ISSUIUC/ISS-PCB/boards/Motor-MK2 (GATOR)/README.md

# Motorboard MK2 - GATOR

G - Grounded 

A - Arieal 

T - Tracker 

O - for Our 

R - Rocket 

# MK2

MK2 now includes an onboard LoRa reciever and GPS, removing the need for another MIDAS to act as a ground station.
It now also includes Qwiic connectors for additional I2C support and an IMU for orientation correction if needed.

# MK1

Starting off the year as just a concept, the Motor Board has taken shape as an impressive new piece of the MIDAS ecosystem. Unofficially known as “Spinny Antenna Motor” (SAM) Board, the project serves as a method of control for the team’s SAM Turret antenna tracker, which aims to automatically track the rocket’s position during flight and maintain optimal antenna orientation to get the best possible range for MIDAS telemetry. In addition to cementing MIDAS’s role as an important part of our team’s ground operations, the Motor Board has served as a testbed for WiFi as a new way of board-to-board communication.

Read more about MotorBoard, MIDAS and the surrounding avionics systems in the [MIDAS MK2 Report](https://uofi.box.com/s/k0ad6ryhxbzwpdwt33lxyxuxpivv3qhj).

# Schematics

Printable PDF schematics and layouts for MotorBoard can be found in the PDFs and images folders.

# Photos

## MK1

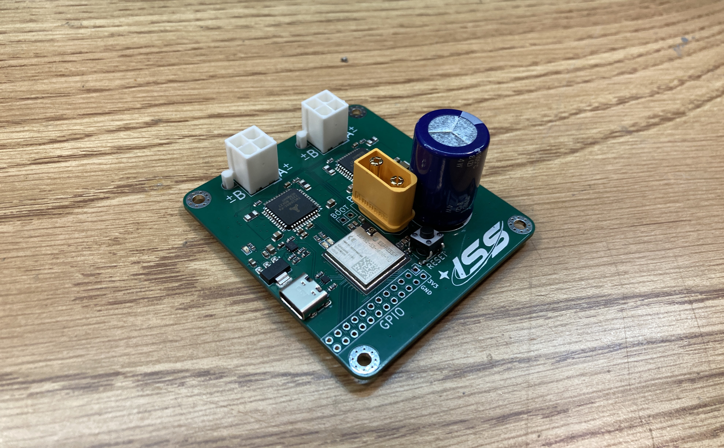
[picture p1: boards/Motor-MK1/images/MotorBoard.JPG]
Motor-Board-photo
