ISSUIUC/ISS-PCB/boards/Feather_Duo/README.md

# Feather Duo

The Feather Duo radio receiver was conceived to optimize communication with MIDAS and simplify the team’s ground station setup, including two LoRa radios for concurrent reception from both stages and software support for increased data rates. It succeeds the Adafruit Feather M0 RFM96 as the team’s primary ground station receiver.

Read more about the Feather Duo, MIDAS and the surrounding avionics systems in the [MIDAS MK2 Report](https://uofi.box.com/s/k0ad6ryhxbzwpdwt33lxyxuxpivv3qhj).

# Schematics

Printable PDF schematics and layouts for the Feather Duo can be found in the PDFs and images folders.

# Photos

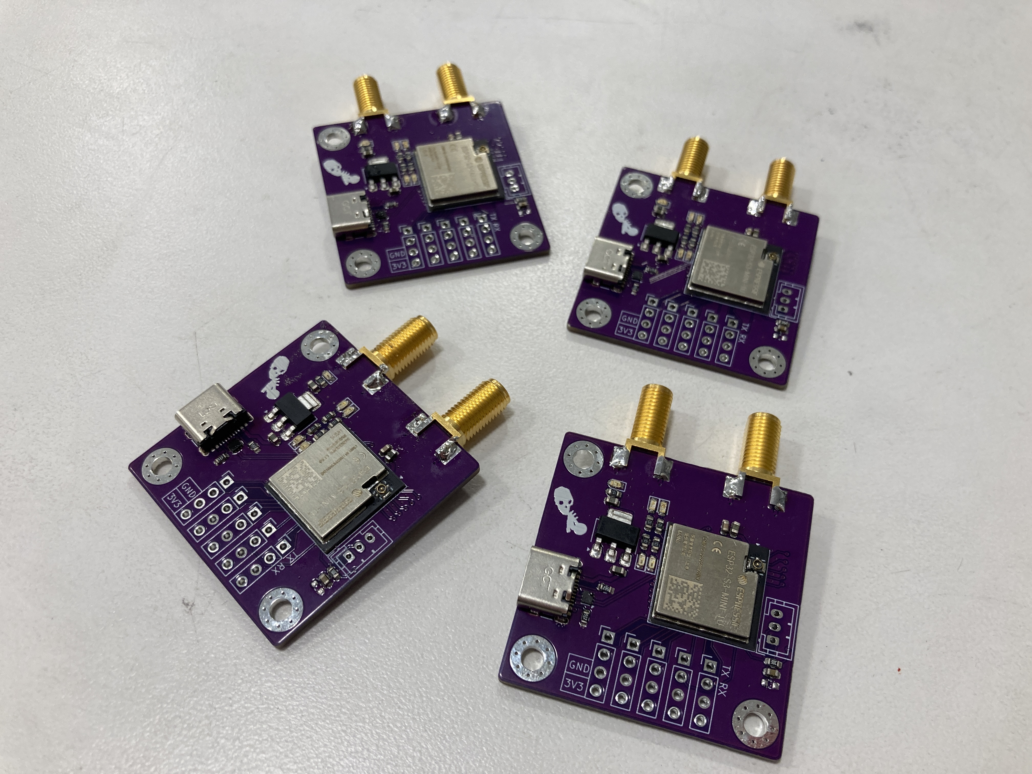
[picture p2: boards/Feather_Duo/images/Feather-Duo.JPG]
Feather-Duo-photo
