ISSUIUC/ISS-PCB/boards/MIDAS-MK2/README.md

# MIDAS MK2

MIDAS MK2 is the new and improved generation of the Illinois Space Society's MIDAS flight computer. Continuing MIDAS’s mission as the centerpiece of a flexible avionics ecosystem, MK2 features data acquisition, live telemetry, board-to-board communication interfaces, and pyrotechnic capabilities for in-flight control. This new revision retains the diverse suite of sensors from the original and features upgraded pyro circuitry with an emphasis on redundancy and reliability. As the team pushes closer and closer to space, MK2 employs a new generation of LoRa radios with 60% higher transmit power as well as CAN and I2C connections for future expandability into satellite communications and other more advanced tracking capabilities. This adaptable nature has enabled MIDAS to fulfill various roles, not only as a flight computer but also as a part of the team’s onboard video system and as a major ground support device. Overall, these across-the-board improvements have pushed the MIDAS project to new heights and led to a string of successes in each of its many domains.

Three MIDAS MK2 boards have been produced, with the series successfully flying in flight control of the Stargazer 1.4 vehicle and as the primary tracker for Aether I & II, the latter of which flew to an altitude of 75,000 feet.

Read more about MIDAS and the surrounding avionics systems in the [MIDAS MK2 Report](https://uofi.box.com/s/k0ad6ryhxbzwpdwt33lxyxuxpivv3qhj).

# Schematics

Printable PDF schematics, diagrams, and layouts for MIDAS MK2.1 revA can be found in the PDFs and images folders.

# Graphics

MIDAS-MK2.1-revA-graphic
