ISSUIUC/ISS-PCB/boards/Onboarding/README.md

# Onboarding Projects

The included projects have been developed for the purpose of teaching new members about the basics of circuit design and using KiCad.

The first project includes a 555 Timer that is used to flash several LEDs in combination with an N-channel MOSFET. This project is accompanied by other onboarding materials which explain how to use the 555 Timer and develop the circuit. There are also videos going through the [schematic](https://youtu.be/EWncukrDE1s) and [layout](https://youtu.be/gsBfX4-ESjE) design.

The second project is a basic two layer altimeter that could be used in an L1 rocket. It is intended to be more open-ended, and the included design can serve as merely an example. The altimeter includes an MCU, sensors connected via the SPI and I2C communication protocols, a microSD card for data storage, and basic power circuitry that can be used with an external voltage regulator. Extra GPIOs are broken out for future expansions.

# Schematics

Printable PDF schematics can be found in the folders for their respective boards.

# Renders

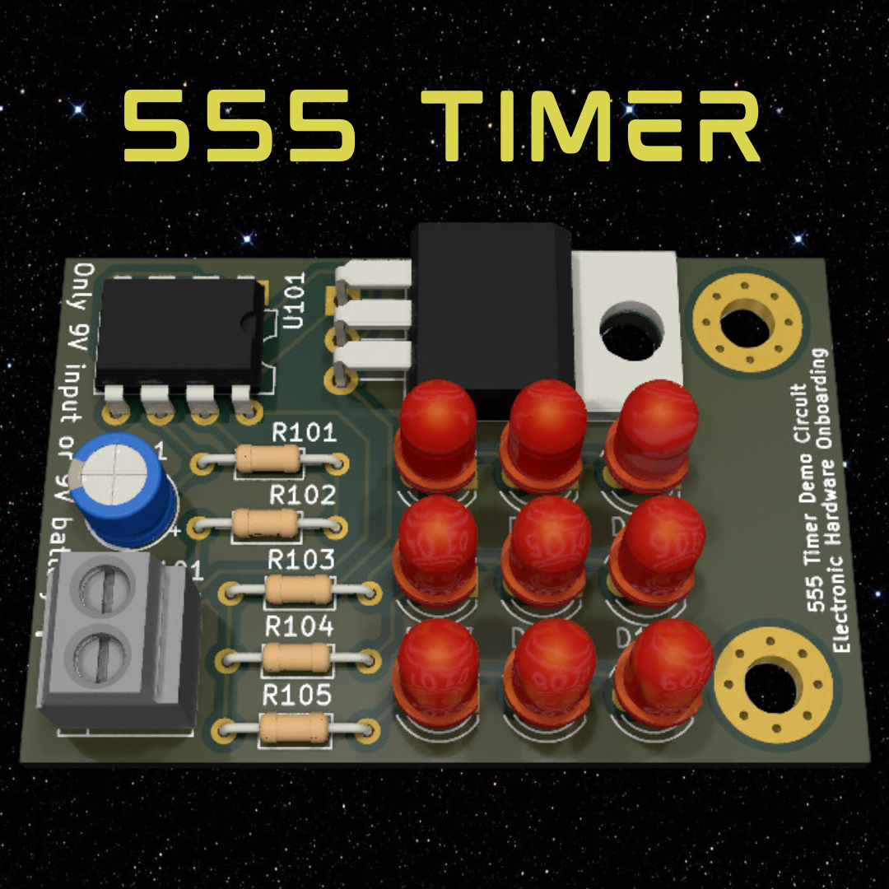
[picture p3: boards/Onboarding/images/555-Timer-Demo-Circuit-Render.png]
555-Timer-Render

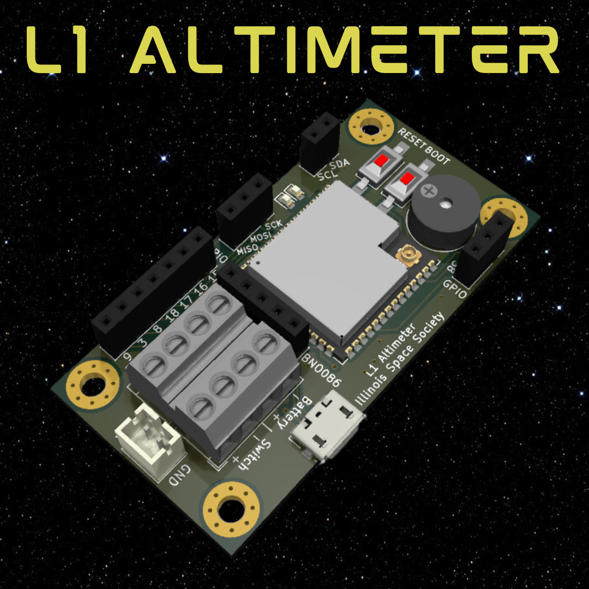
[picture p4: boards/Onboarding/images/L1-Altimeter-Render.png]
L1-Altimeter-Render
