ISSUIUC/ISS-PCB/boards/MIDAS-MK1/README.md

# MIDAS MK1

MIDAS MK1 is the fifth generation of the Illinois Space Society's SRAD avionics systems and the first to serve as a full-fledged rocketry altimeter. Combining the functionality of TARS together with the advanced pyrotechnic circuitry seen on many commercial models into a smaller form factor, MIDAS facilitates data collection, telemetry, and execution of inflight events. More than just a single unit, MIDAS is intended for placement on multiple stages of a rocket and can serve as a center of more complex avionics networks such as our onboard live video system.

Three MIDAS boards have been produced, flying over forty-four thousand feet to a new UIUC altitude record on Kairos II. By providing continuous telemetry that allowed for successful retrieval of both stages, MIDAS proved itself as a critical part of the team's avionics ecosystem going forward.

Future iterations of MIDAS will optimize operation and reliability at exceedingly high ranges and altitudes, creating a space-capable altimeter that will take our team to the Kármán line.

Read more about MIDAS and the surrounding avionics systems in the [MIDAS MK1 Report](https://uofi.box.com/s/6l9kr9wvrg0xpj17jzni7ou9mbe10vdm).

# Schematics

Printable PDF schematics for MIDAS MK1.1 revA can be found in the PDFs folder.

# Renders

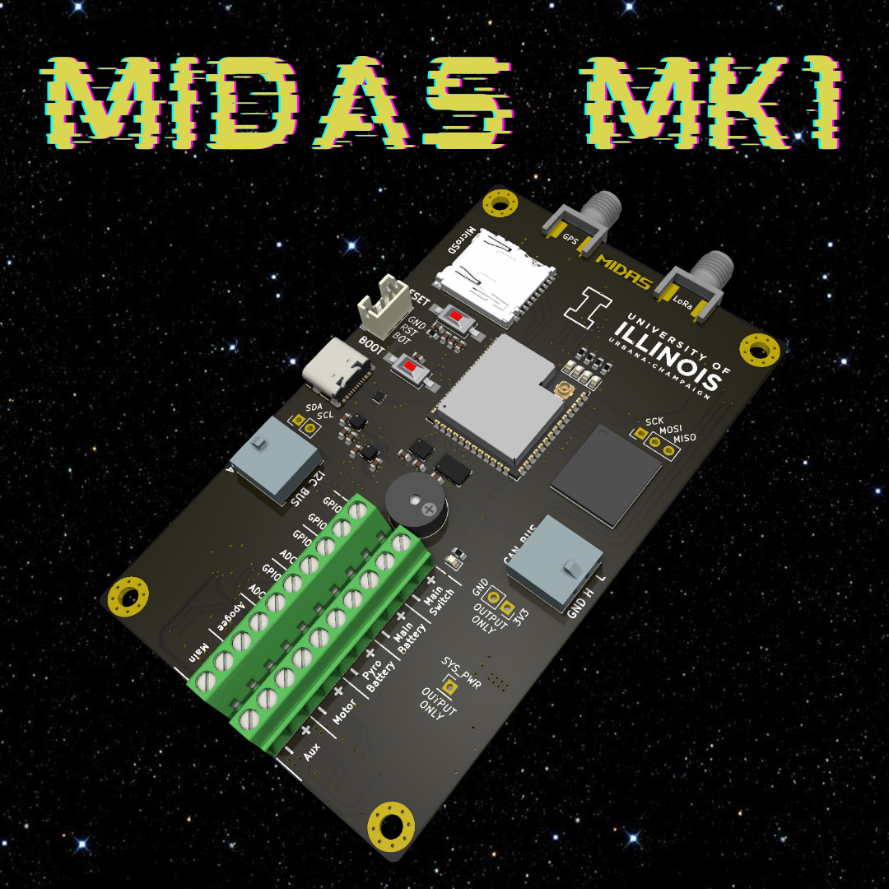
[picture p17: boards/MIDAS-MK1/images/MIDAS-MK1.1.png]
MIDAS-MK1.1-revB-render
