ISSUIUC/ISS-PCB/boards/Feather_Duo/images/Feather-Duo-Layout-Combined.png

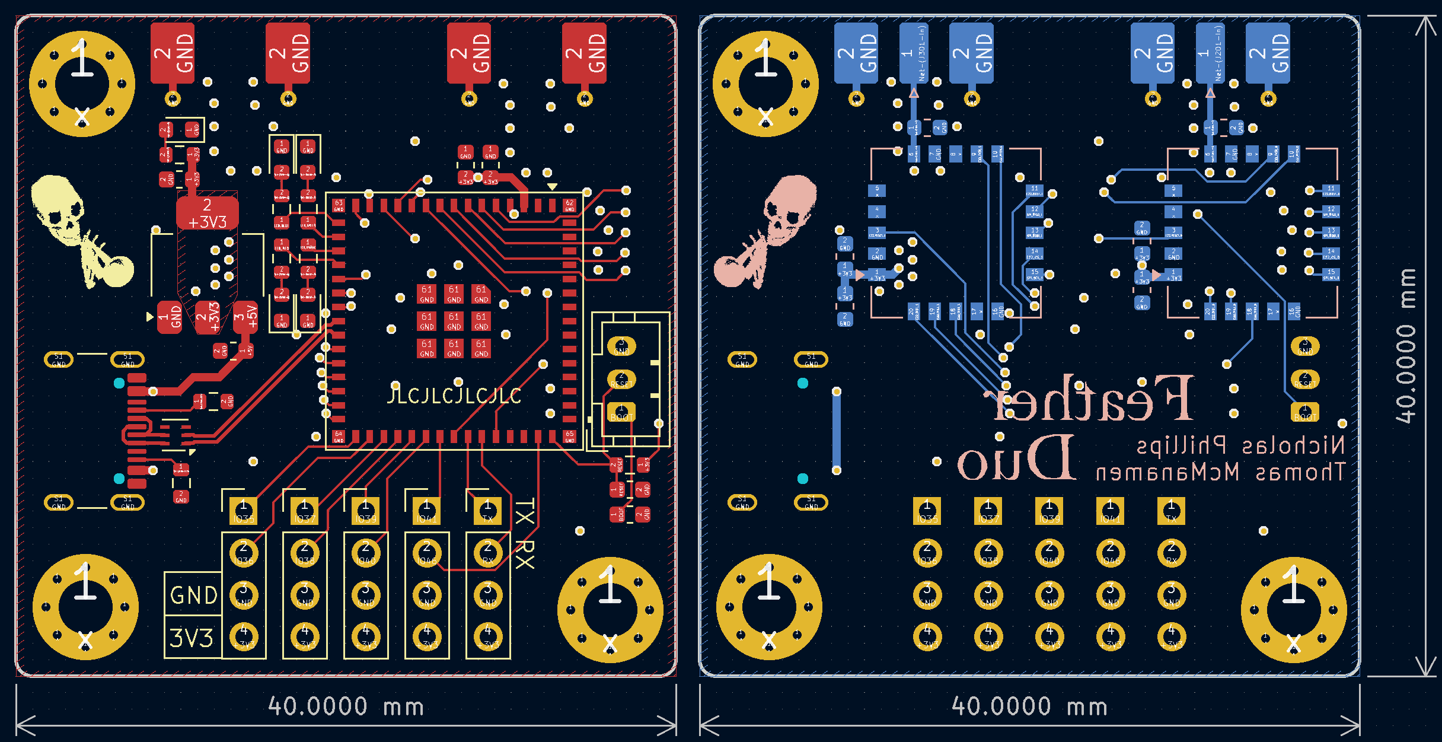
boards/Feather_Duo/images/Feather-Duo-Layout-Combined.png
