ISSUIUC/ISS-PCB/boards/MIDAS-MK2/images/MIDAS-MK2.1-Block-Diagram.png

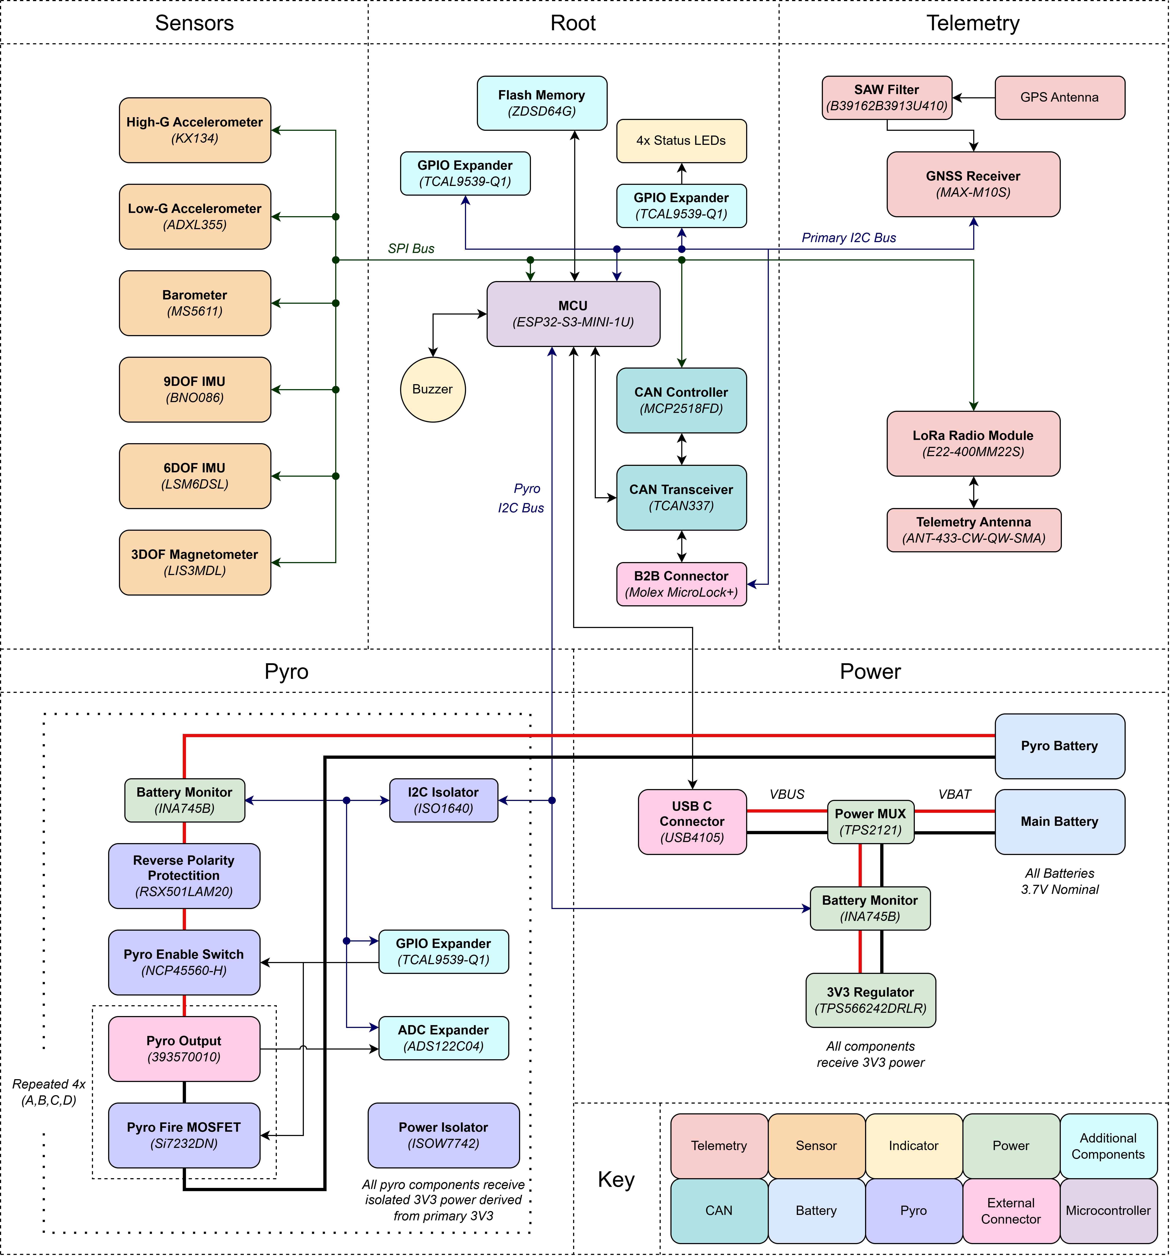
boards/MIDAS-MK2/images/MIDAS-MK2.1-Block-Diagram.png
