ISSUIUC/ISS-PCB/boards/MIDAS-MK2/images/MIDAS-MK2.1-Layout-Combined.png

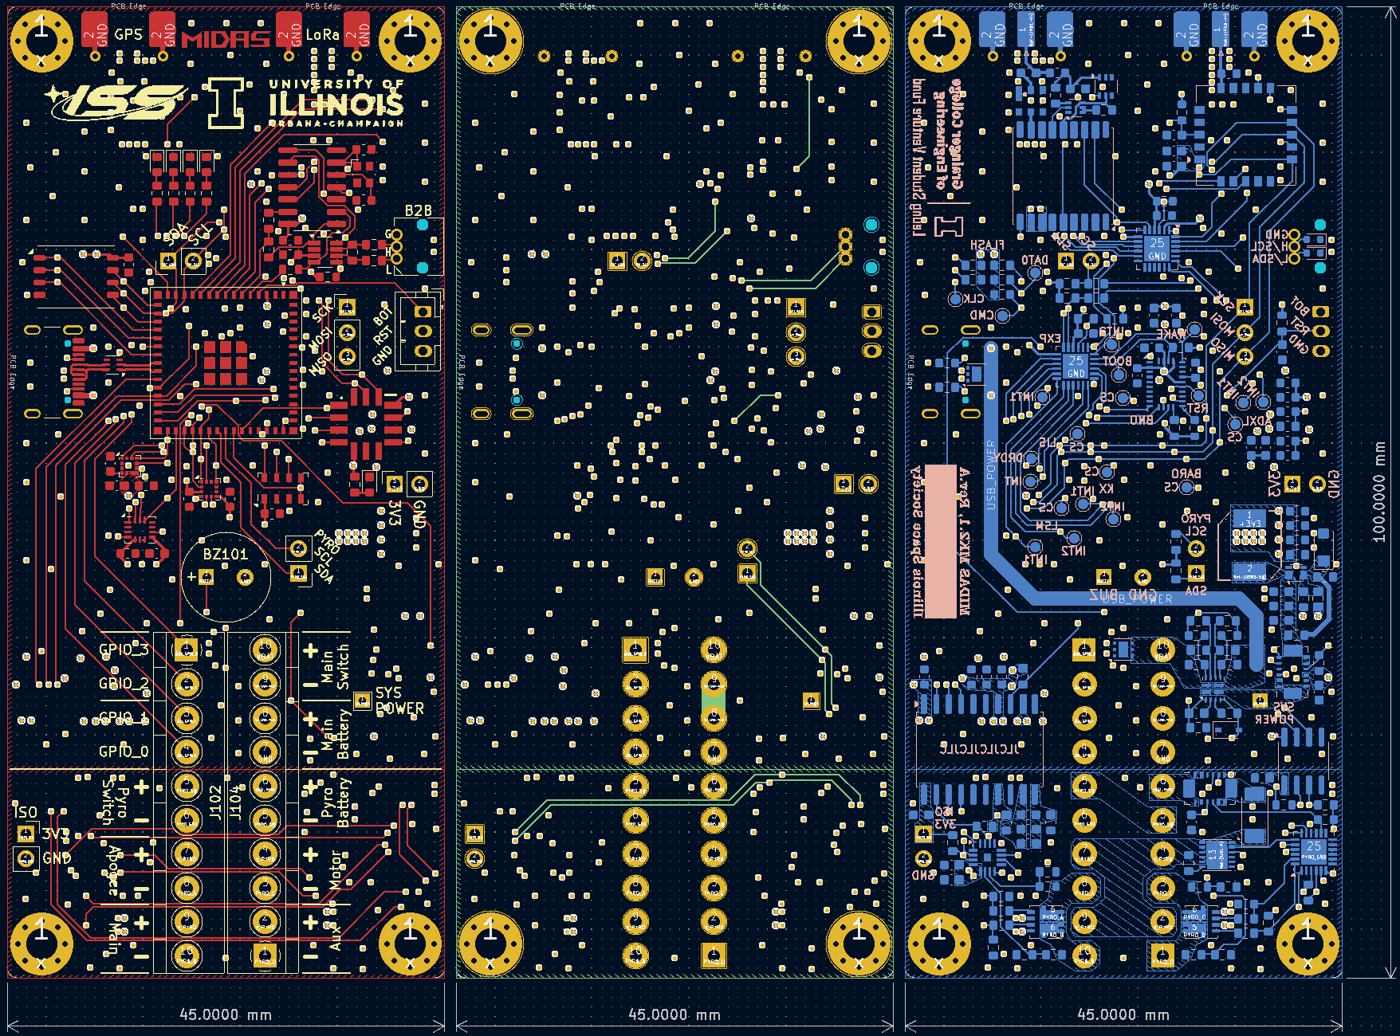
boards/MIDAS-MK2/images/MIDAS-MK2.1-Layout-Combined.png
