ISSUIUC/ISS-PCB/boards/Motor-MK1/images/MotorBoard-Layout-Combined.png

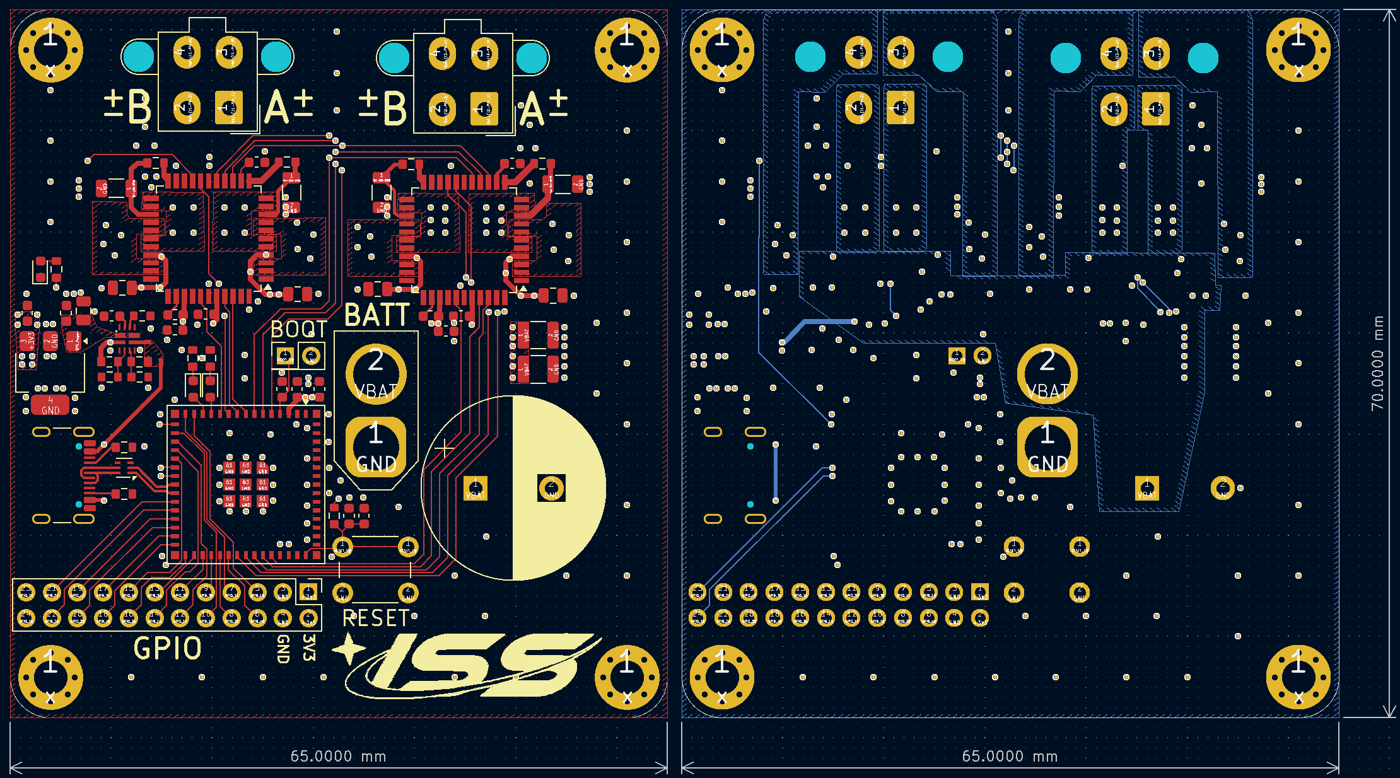
boards/Motor-MK1/images/MotorBoard-Layout-Combined.png
