ISSUIUC/ISS-PCB/boards/Onboarding/images/555-Timer-Demo-Circuit-3D.png

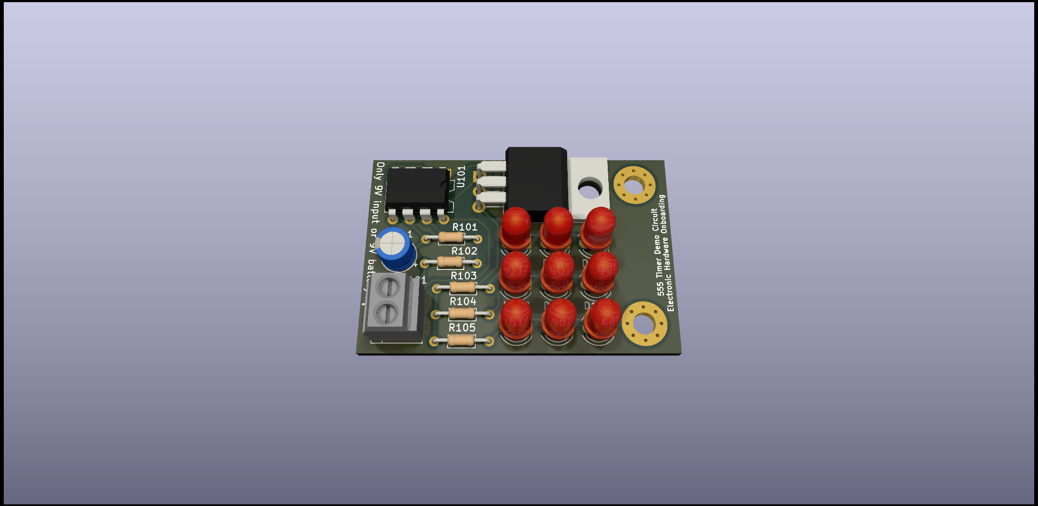
boards/Onboarding/images/555-Timer-Demo-Circuit-3D.png
