ISSUIUC/ISS-PCB/boards/Onboarding/images/L1-Altimeter-3D-Front.png

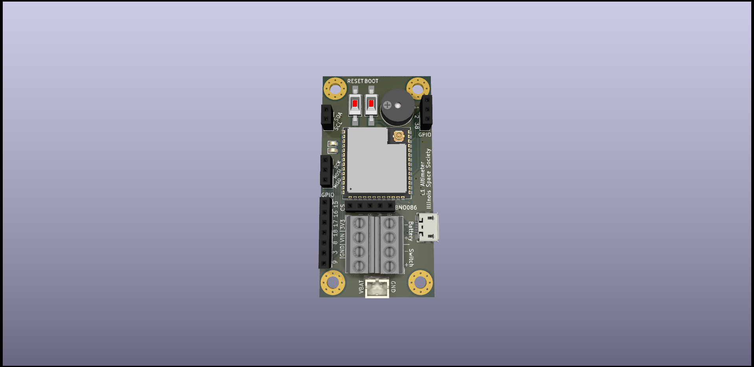
boards/Onboarding/images/L1-Altimeter-3D-Front.png
