ISSUIUC/ISS-PCB/boards/Onboarding/images/L1-Altimeter-3D-Tilt.png

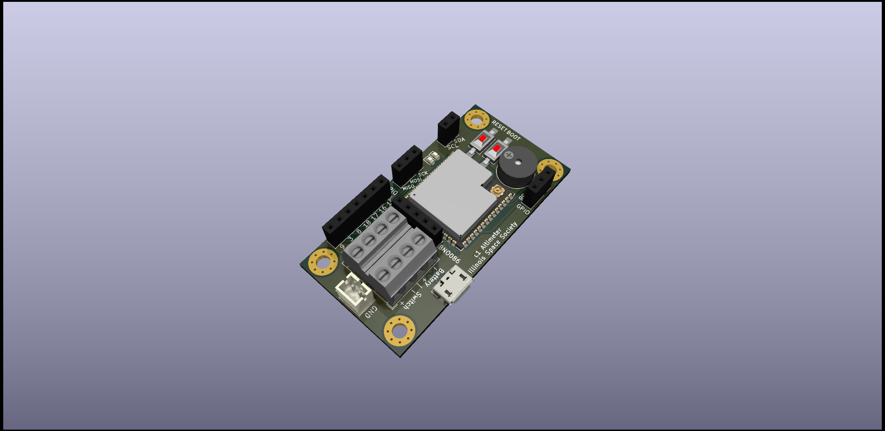
boards/Onboarding/images/L1-Altimeter-3D-Tilt.png
