ISSUIUC/ISS-PCB/images/ISS-PCB-Contributing-Branch-Types.png

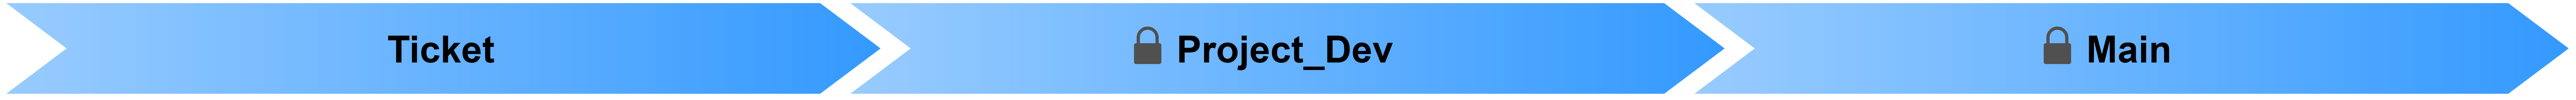
images/ISS-PCB-Contributing-Branch-Types.png
