ISSUIUC/ISS-PCB/images/ISS-PCB-Contributing-Library-Folders.png

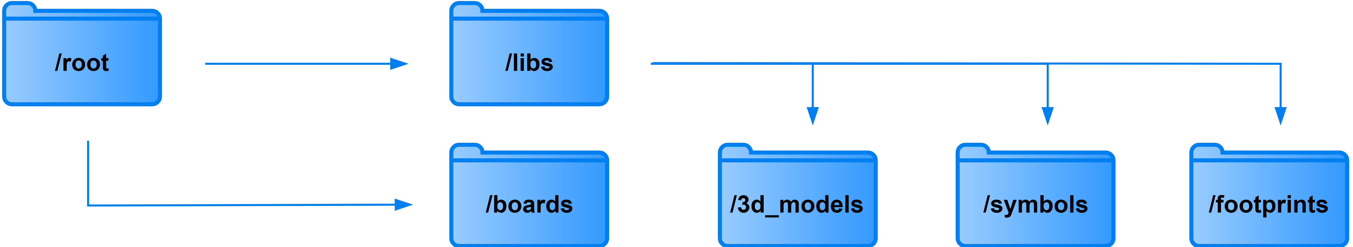
images/ISS-PCB-Contributing-Library-Folders.png
