ISSUIUC/ISS-PCB/images/ISS-PCB-Contributing-Relative-Library-Paths.png

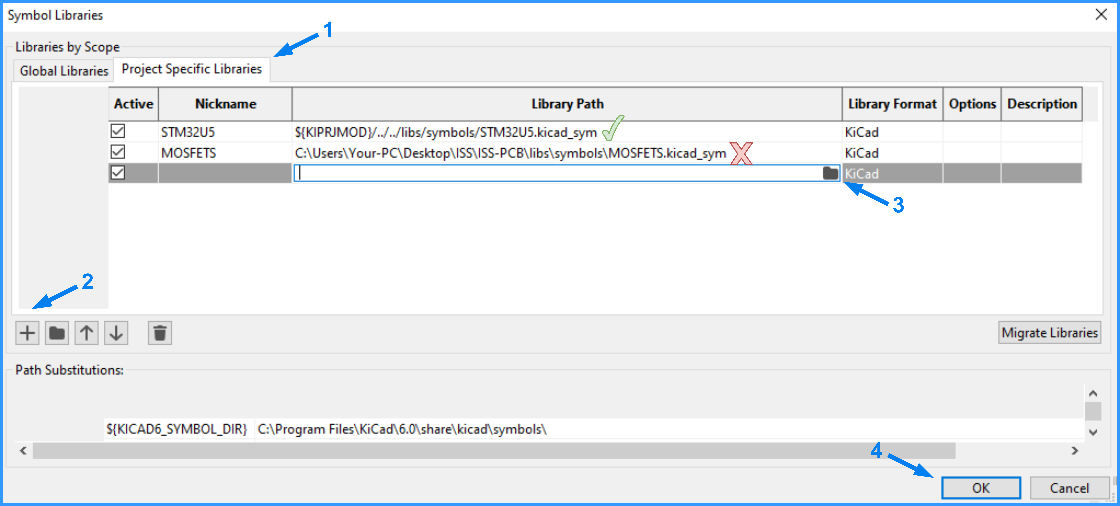
images/ISS-PCB-Contributing-Relative-Library-Paths.png
