ISSUIUC/ISS-PCB/images/ISS-PCB-KiCAD-Conventions-MPN.png

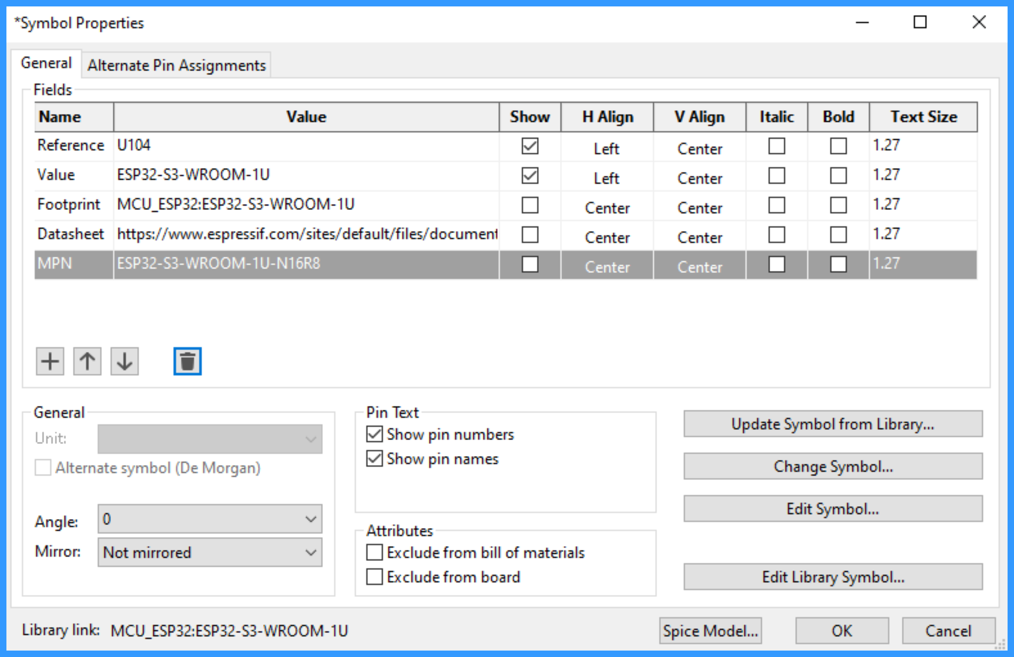
images/ISS-PCB-KiCAD-Conventions-MPN.png
