ISSUIUC/ISS-PCB/images/ISS-PCB-KiCAD-Conventions-Wire-Component.png

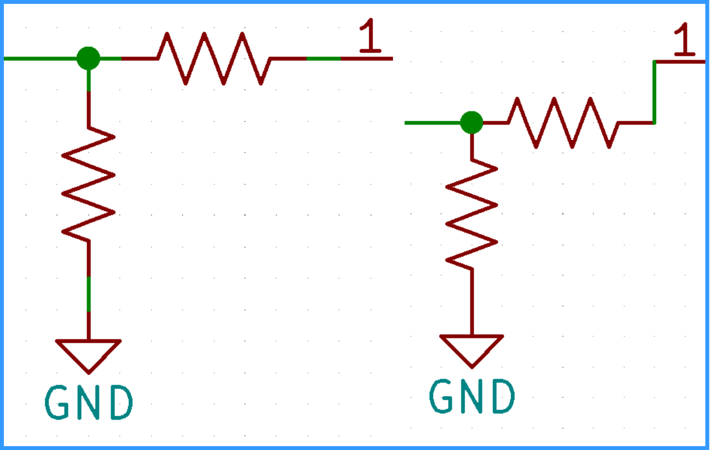
images/ISS-PCB-KiCAD-Conventions-Wire-Component.png
