ISSUIUC/ISS-PCB/boards/Drone_Power/BorzoiBoardCasing/BorzoiBoardCasing.FCStd

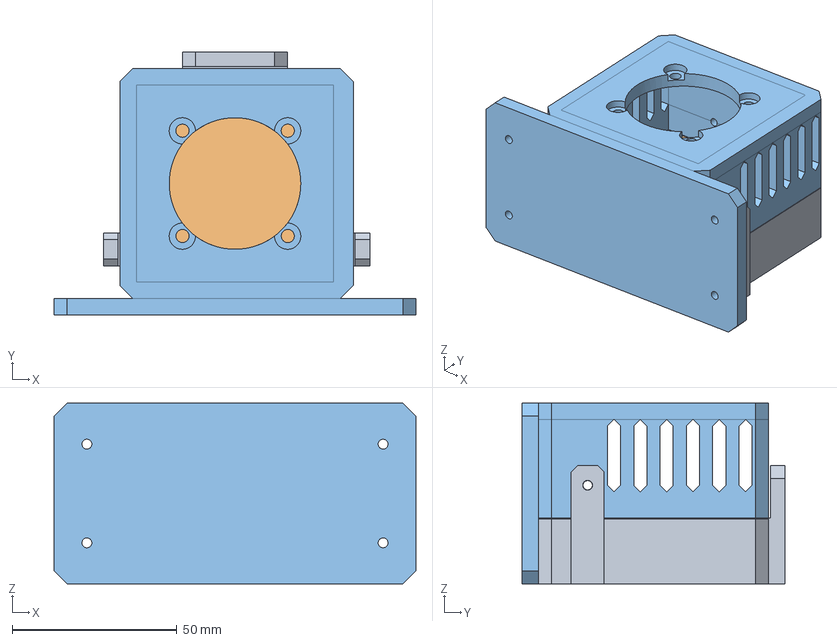
[picture p30: CAD file, 2025-09-06]
boards/Drone_Power/BorzoiBoardCasing/BorzoiBoardCasing.FCStd
110.0 x 80.0 x 55.0 mm
BottomCasing
PCB
TopCasing
