ISSUIUC/ISS-PCB/boards/Drone_Power/BorzoiBoardCasing/BorzoiBoardCasing-TopCasing.stl

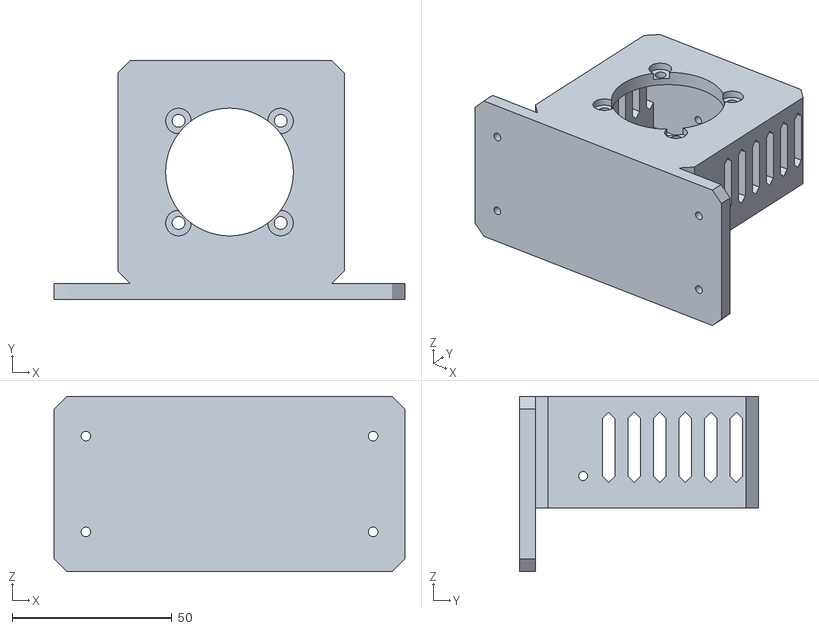
[picture p31: CAD file, 2025-09-06]
boards/Drone_Power/BorzoiBoardCasing/BorzoiBoardCasing-TopCasing.stl
110.0 x 75.0 x 55.0
