ISSUIUC/ISS-PCB/boards/Drone_Power/BorzoiBoardCasing/BorzoiBoardCasing-BottomCasing.stl

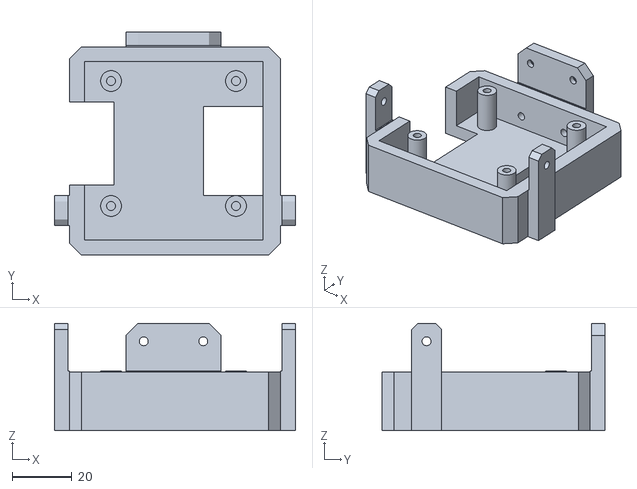
[picture p32: CAD file, 2025-09-06]
boards/Drone_Power/BorzoiBoardCasing/BorzoiBoardCasing-BottomCasing.stl
81.0 x 75.0 x 36.0
