ISSUIUC/ISS-PCB/boards/Feather_Duo/PDFs/Feather-Duo-Schematic.pdf

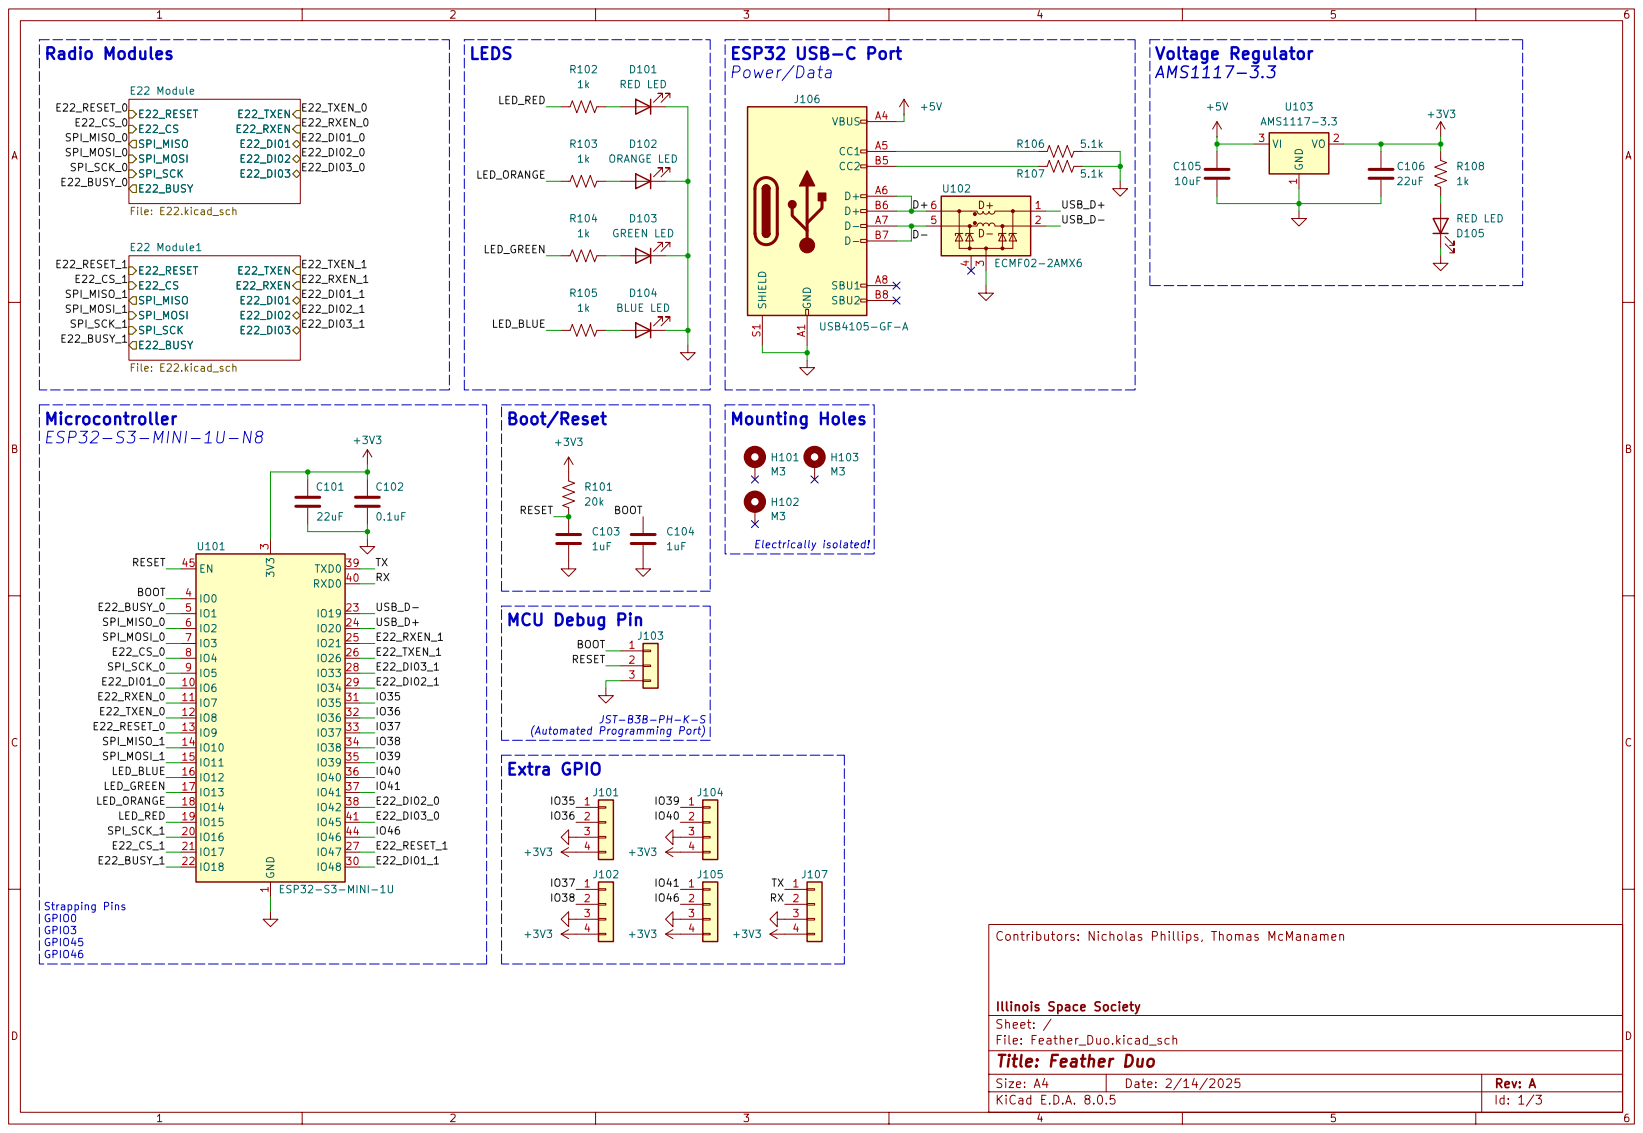
[picture p33: page 1]

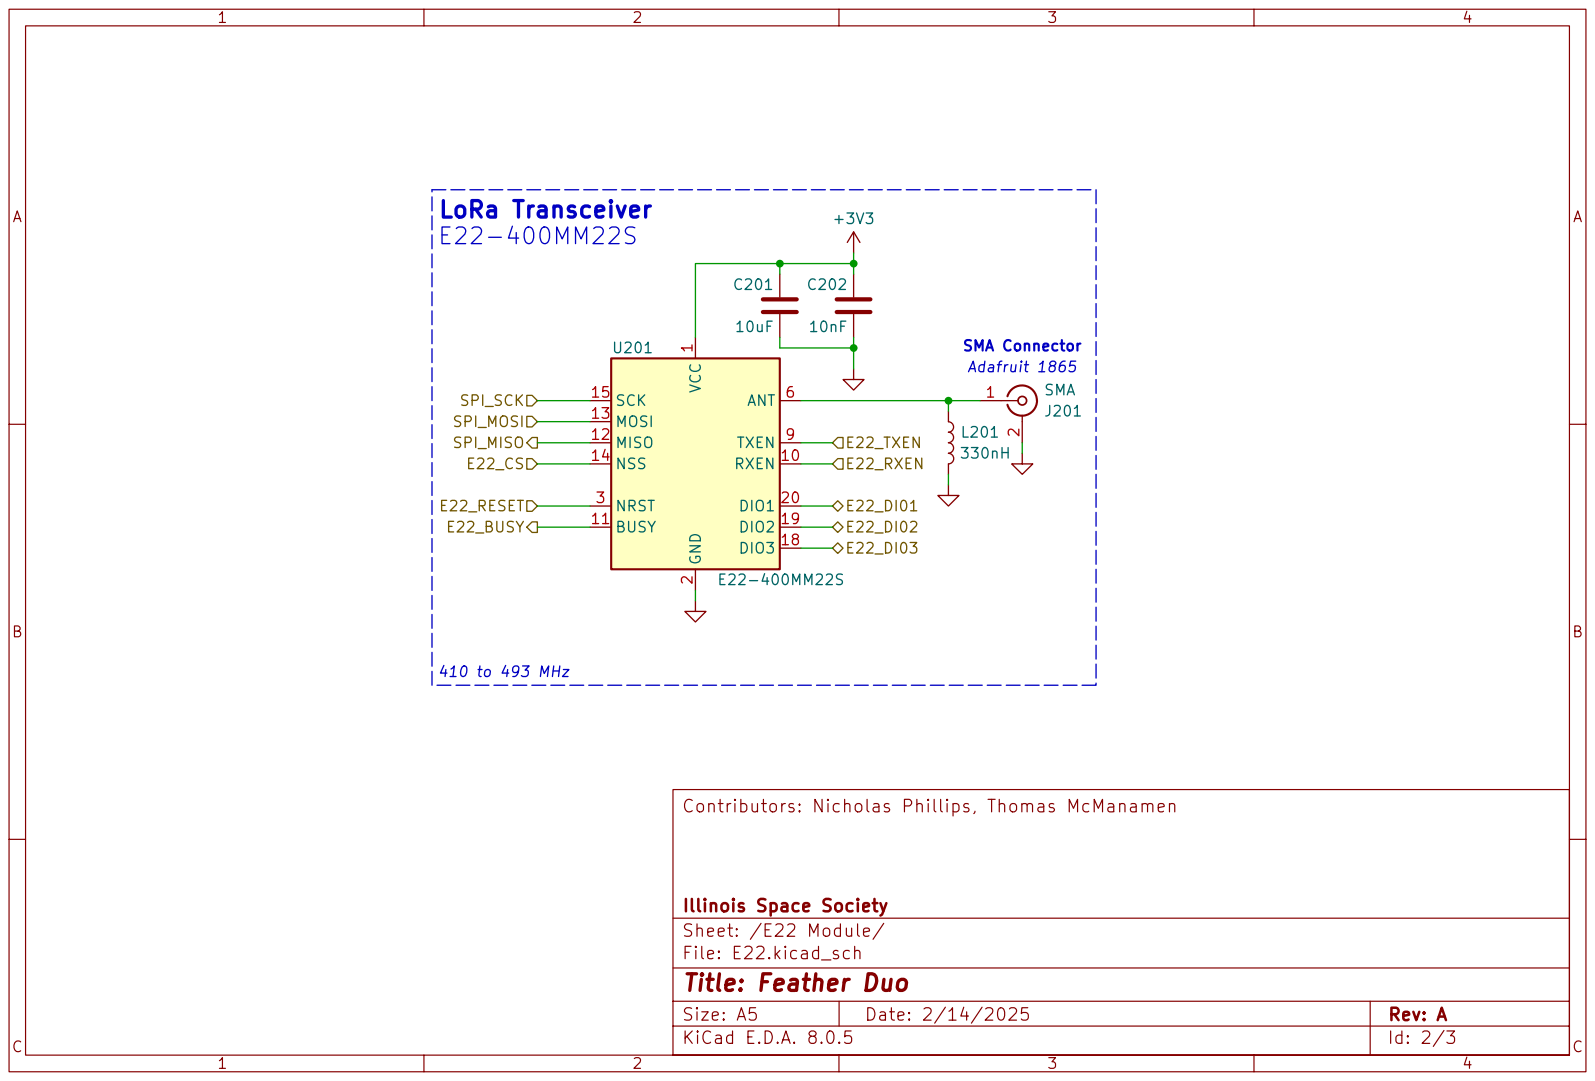
[picture p34: page 2]

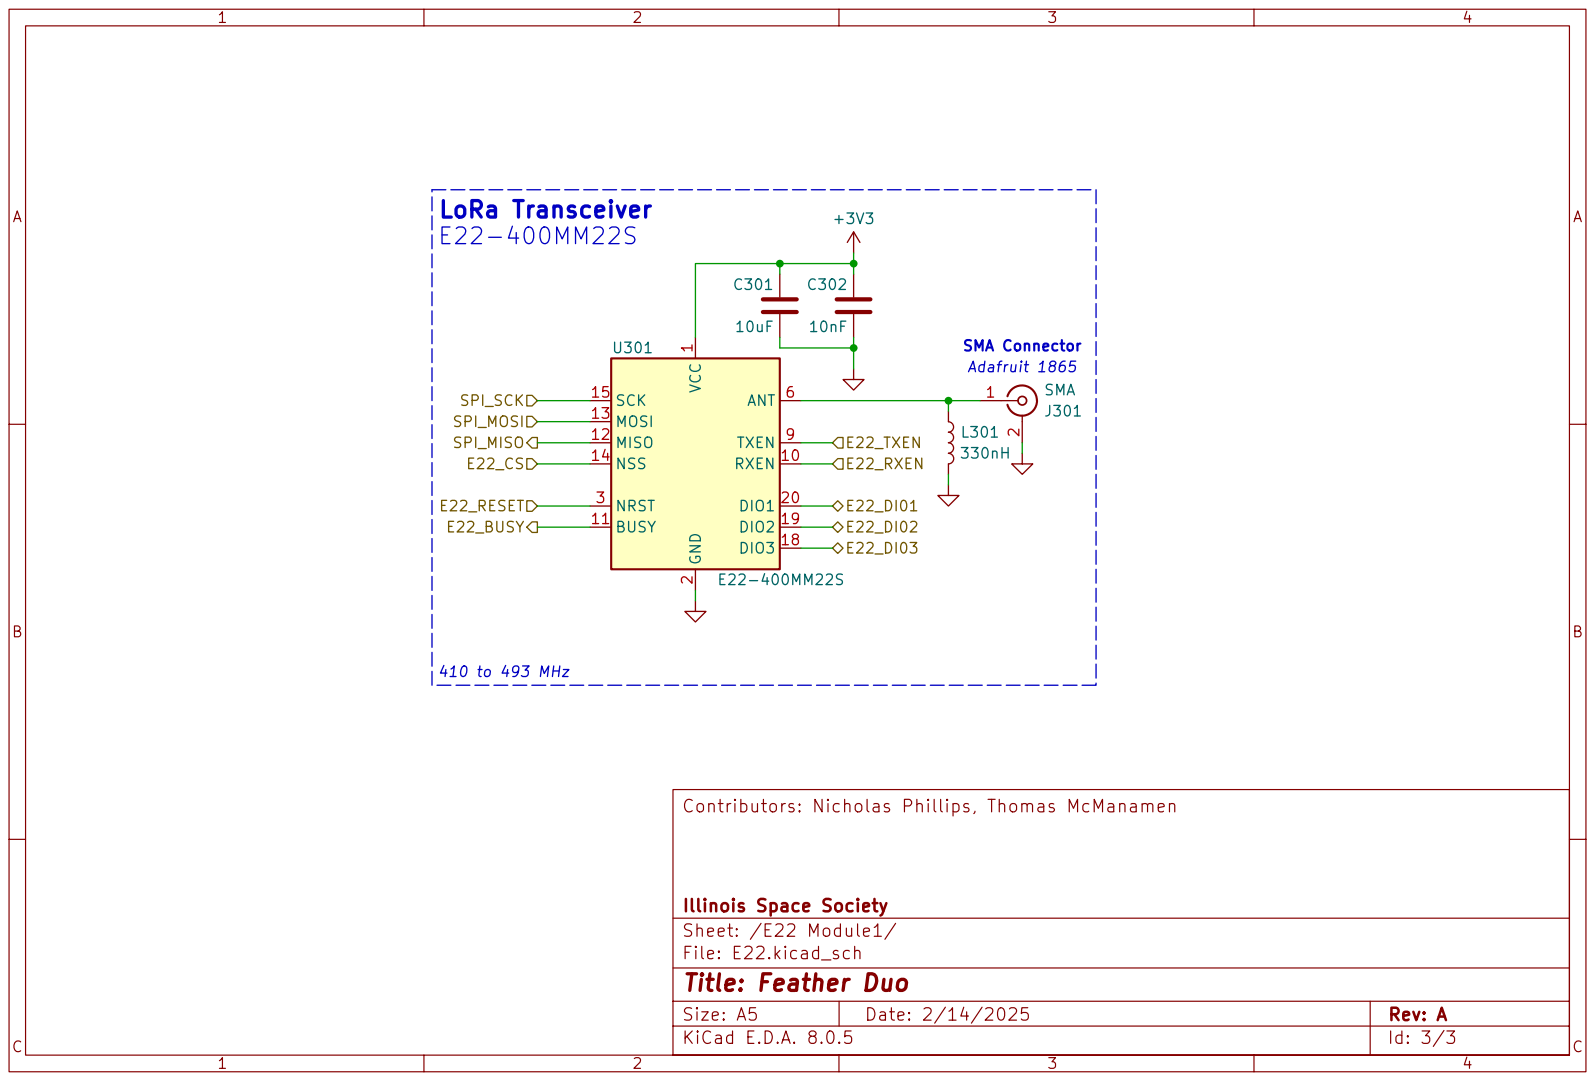
[picture p35: page 3]
