ISSUIUC/ISS-PCB/boards/MIDAS-MK2/PDFs/MIDAS-MK2.1-Schematic.pdf

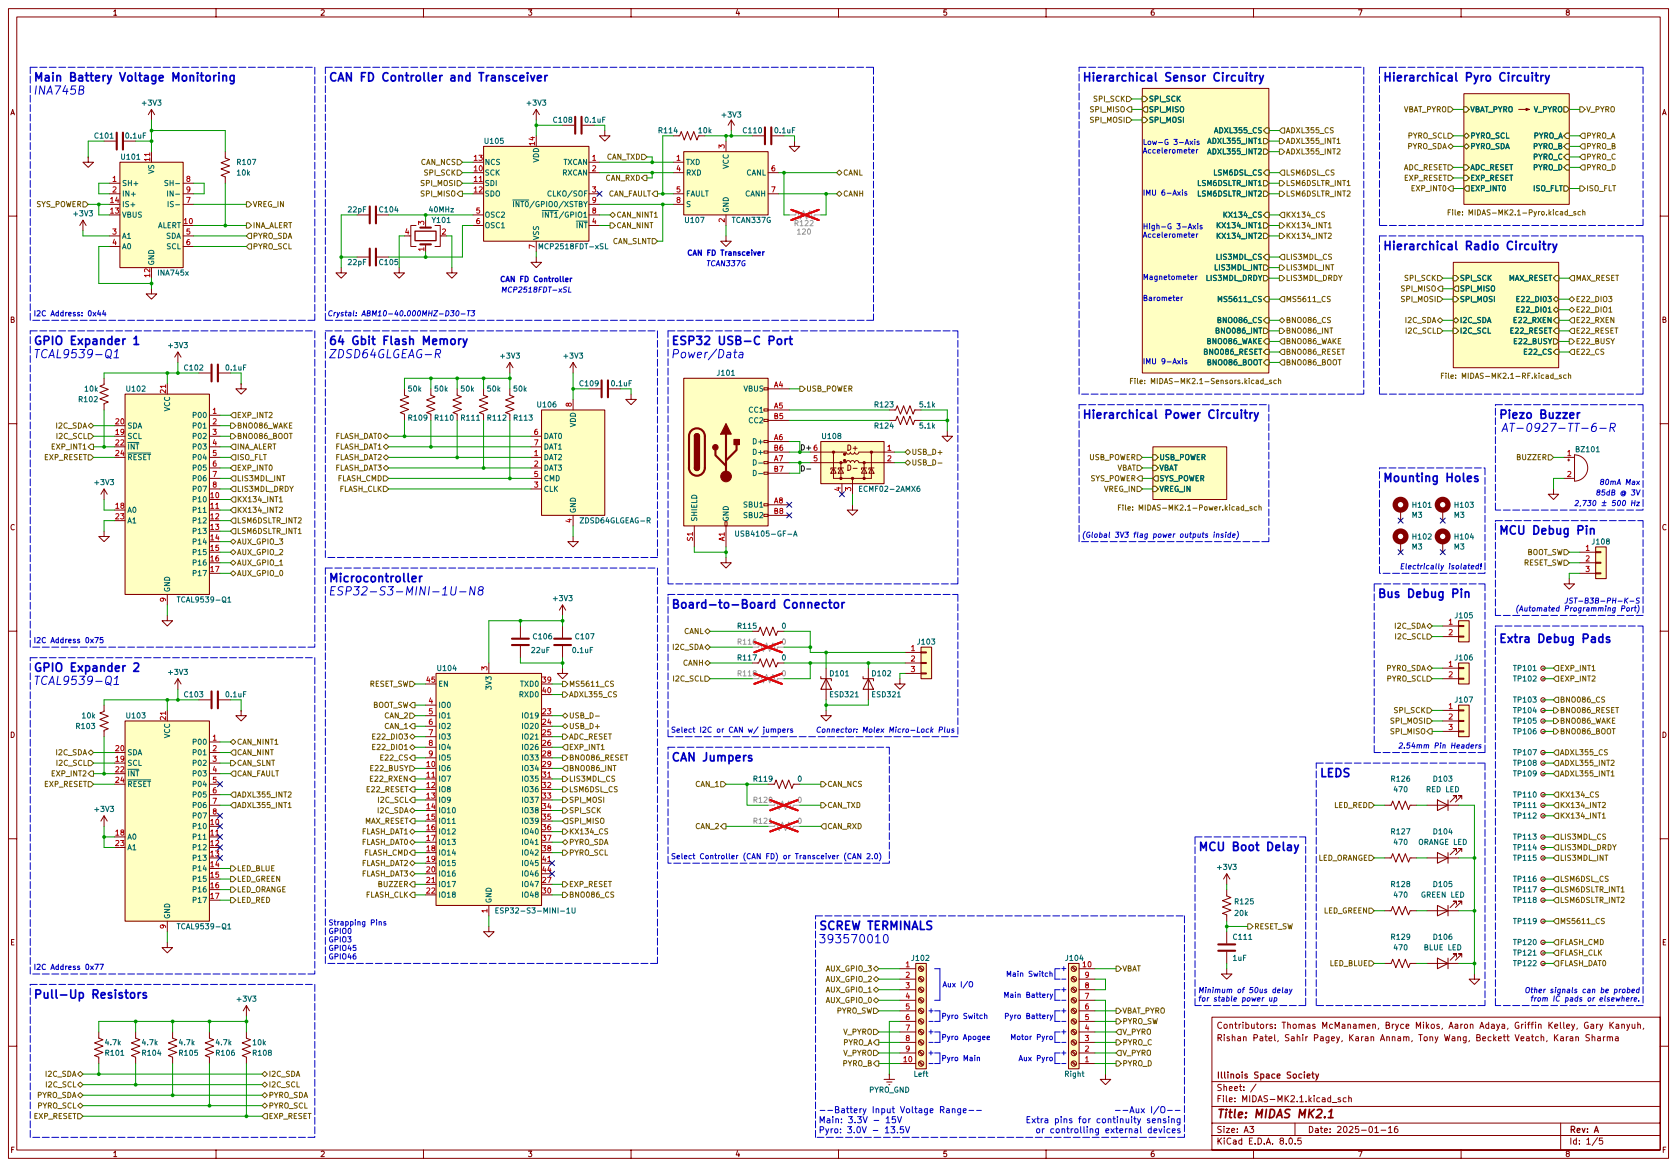
[picture p36: page 1]

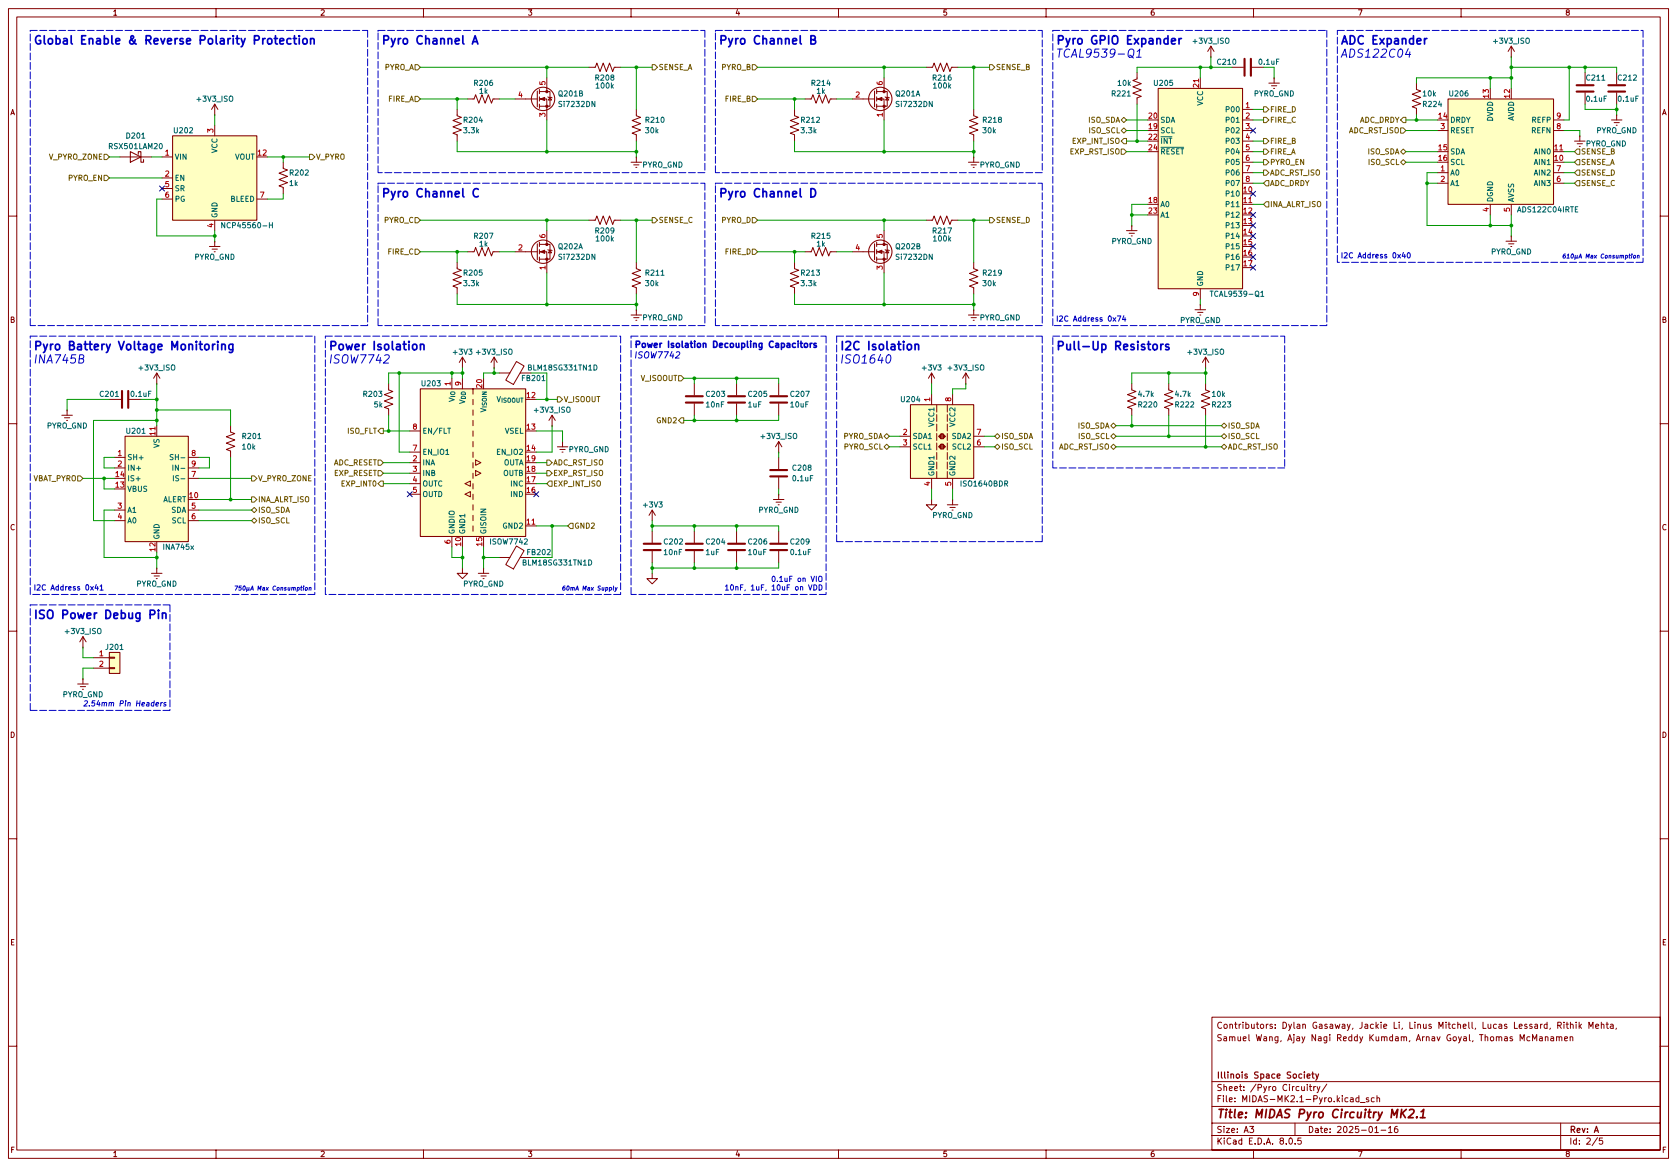
[picture p37: page 2]

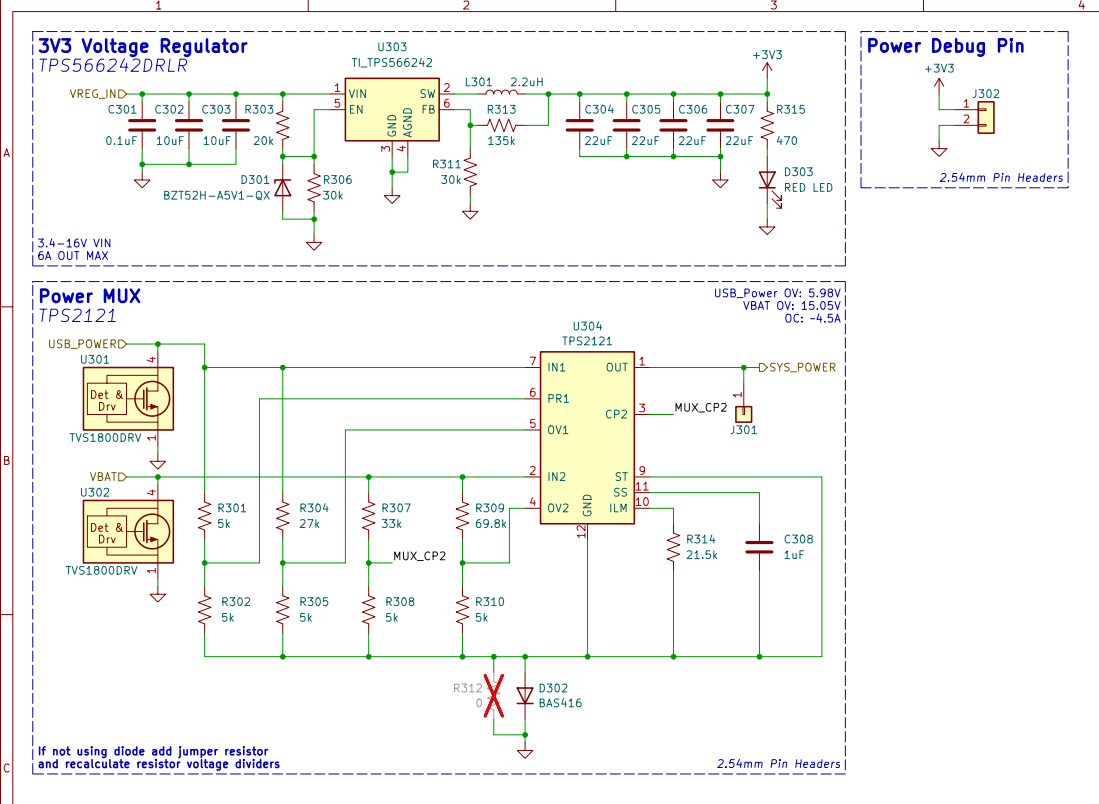
[picture p38: page 3]

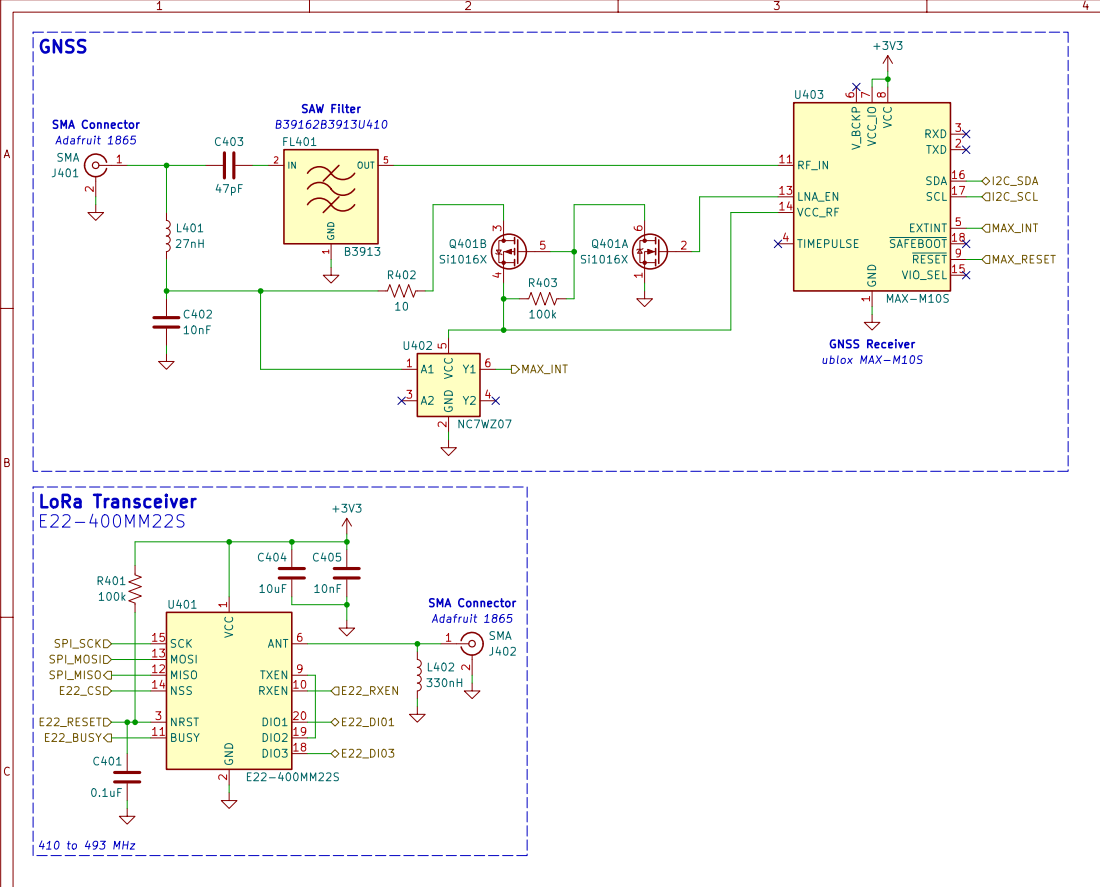
[picture p39: page 4]

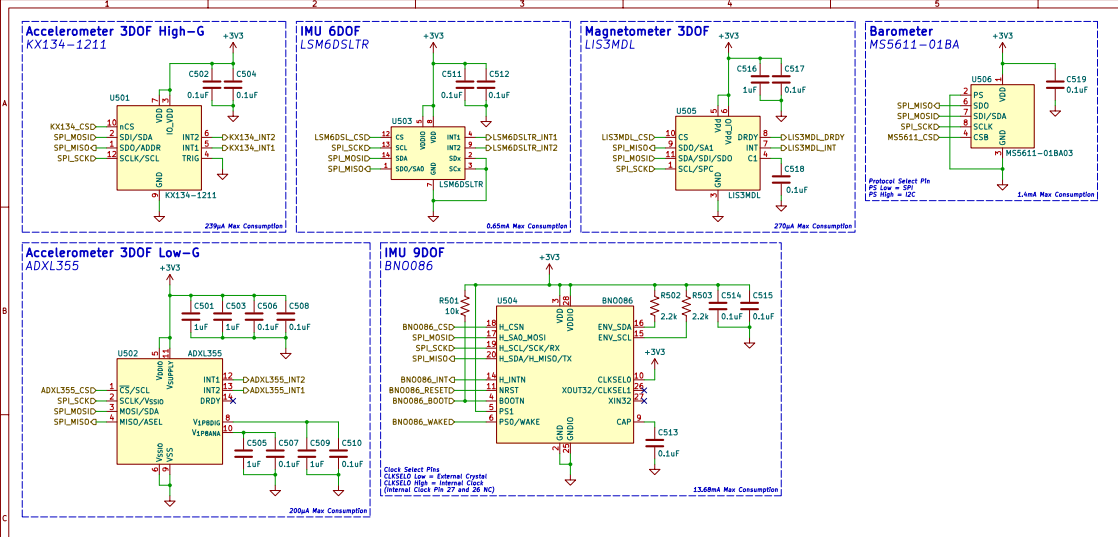
[picture p40: page 5]
