ISSUIUC/ISS-PCB/boards/Motor-MK1/PDFs/MotorBoard-Schematic.pdf

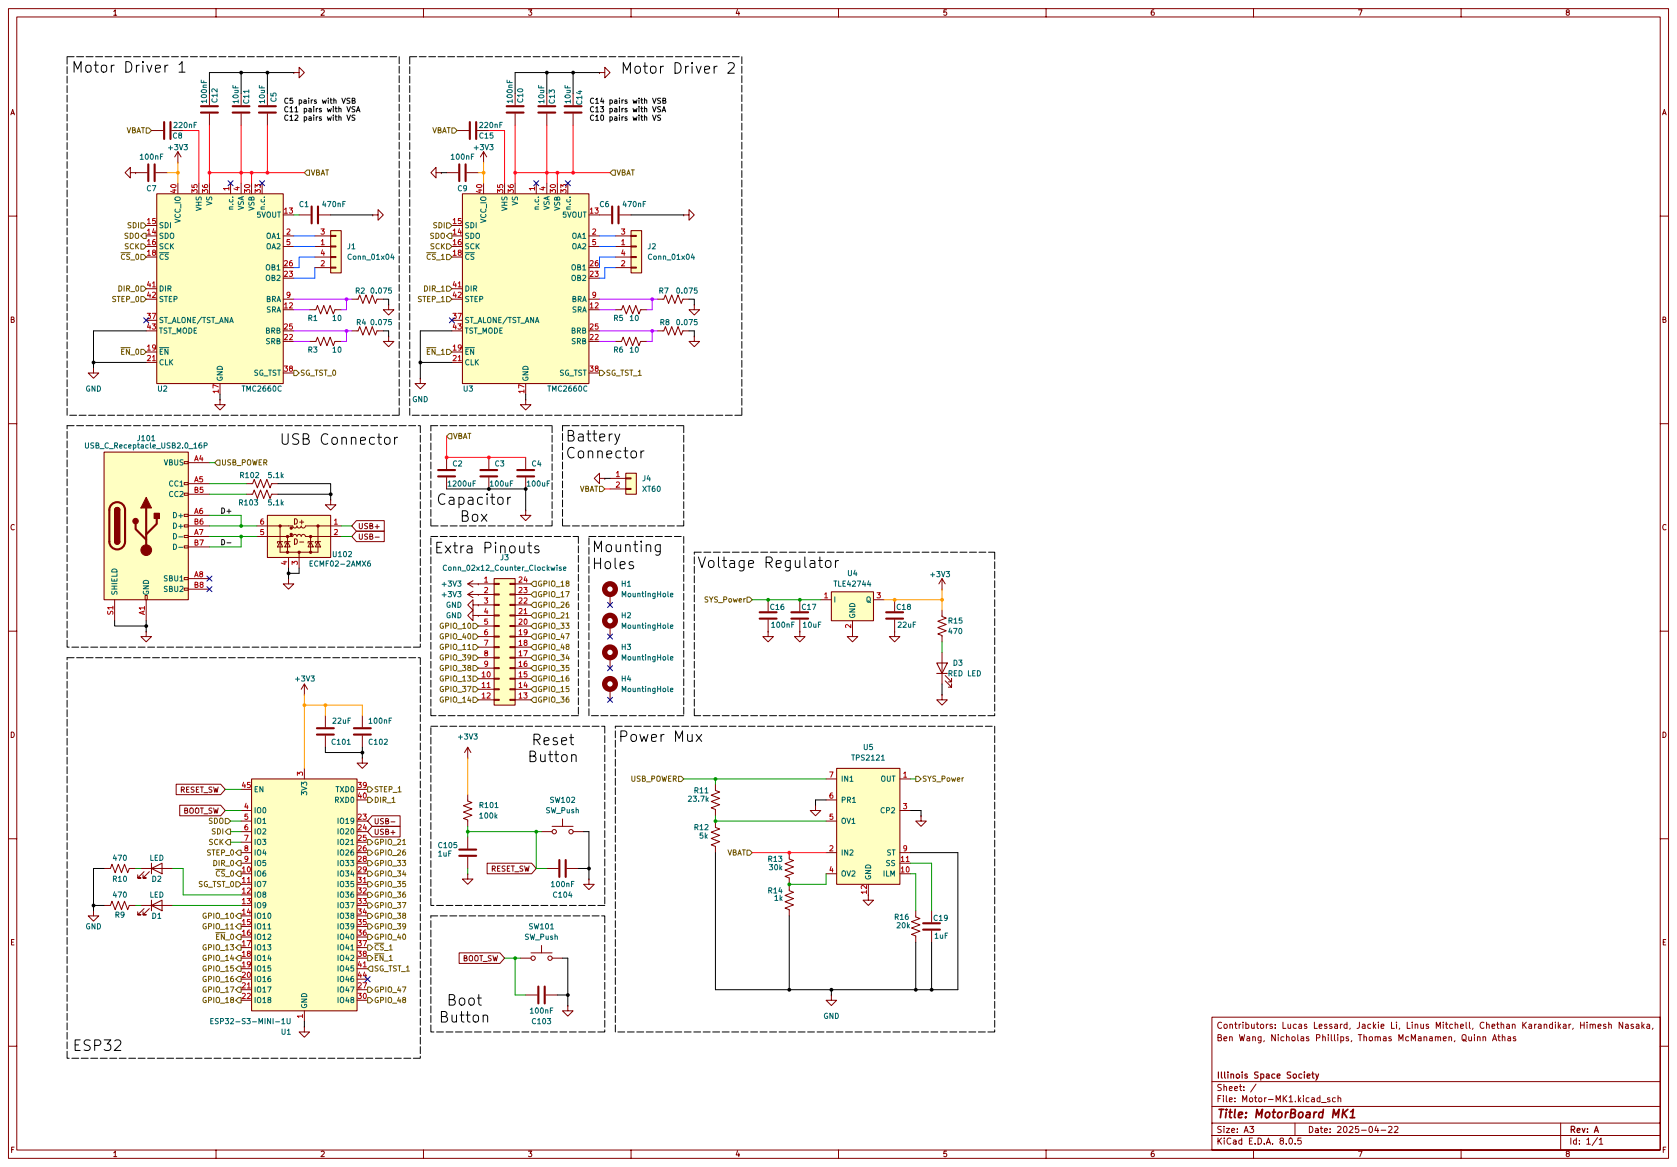
[picture p41: page 1]
