ISSUIUC/ISS-PCB/boards/Onboarding/555-Timer-Demo-Circuit/555-Timer-Demo-Circuit-Schematic.pdf

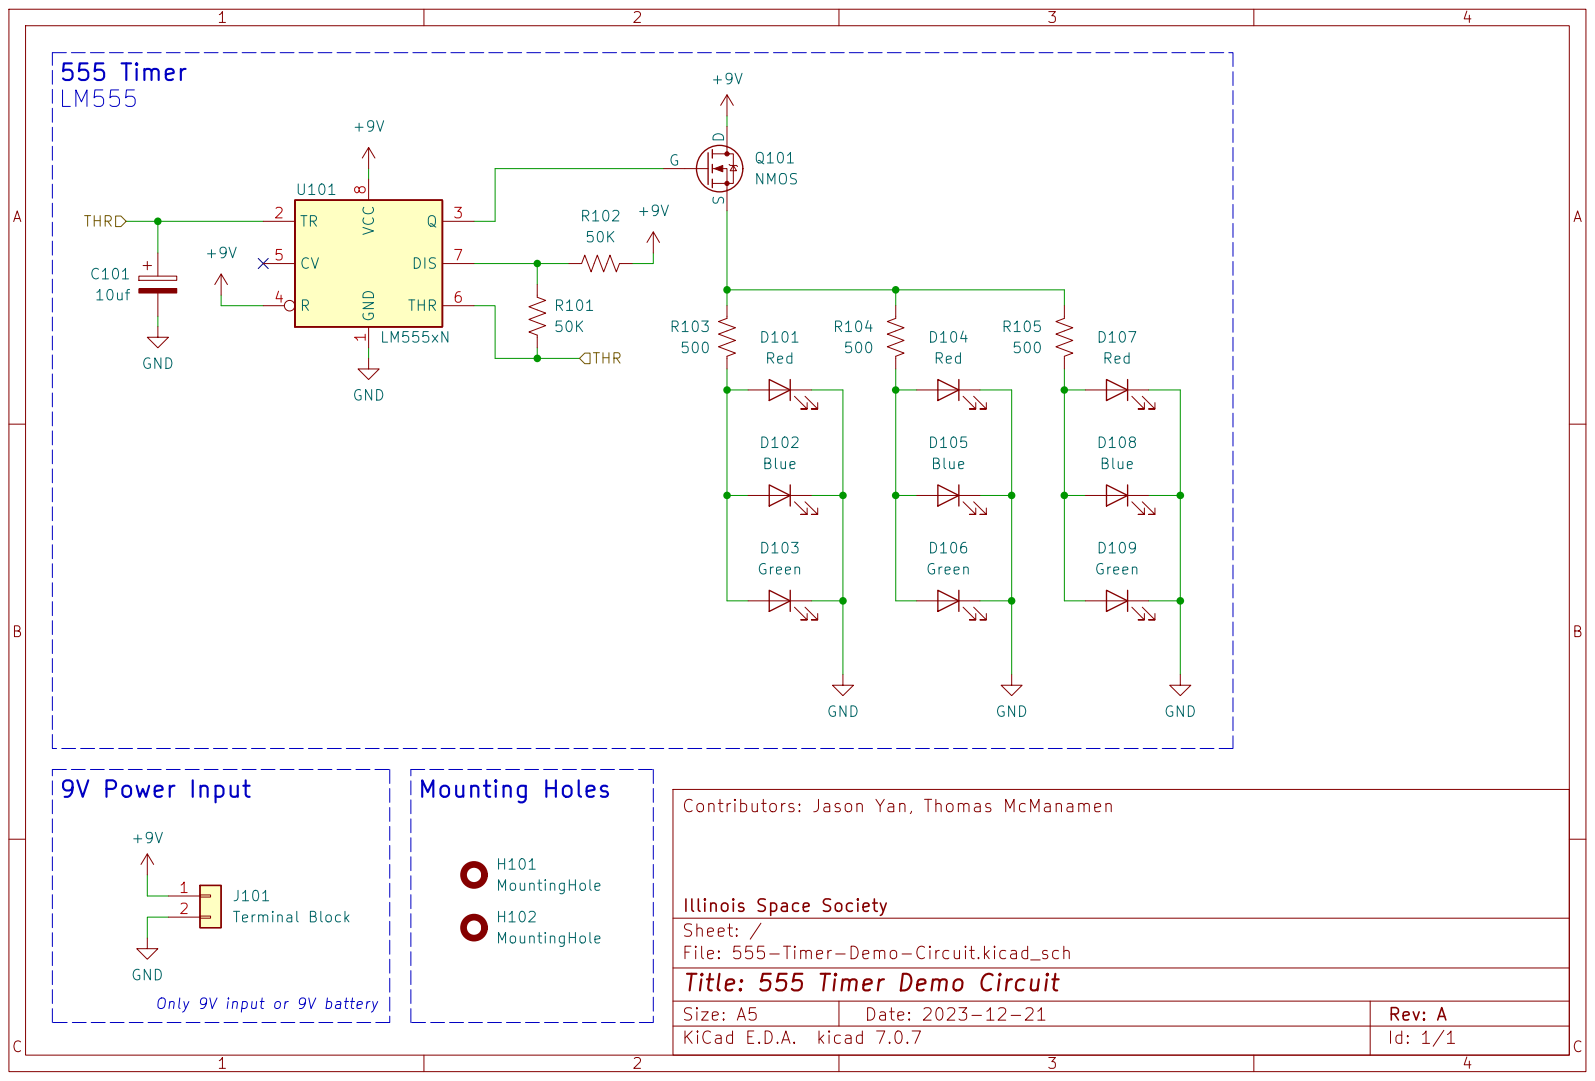
[picture p42: page 1]
