ISSUIUC/ISS-PCB/boards/Onboarding/L1-Altimeter/L1-Altimeter-Schematic.pdf

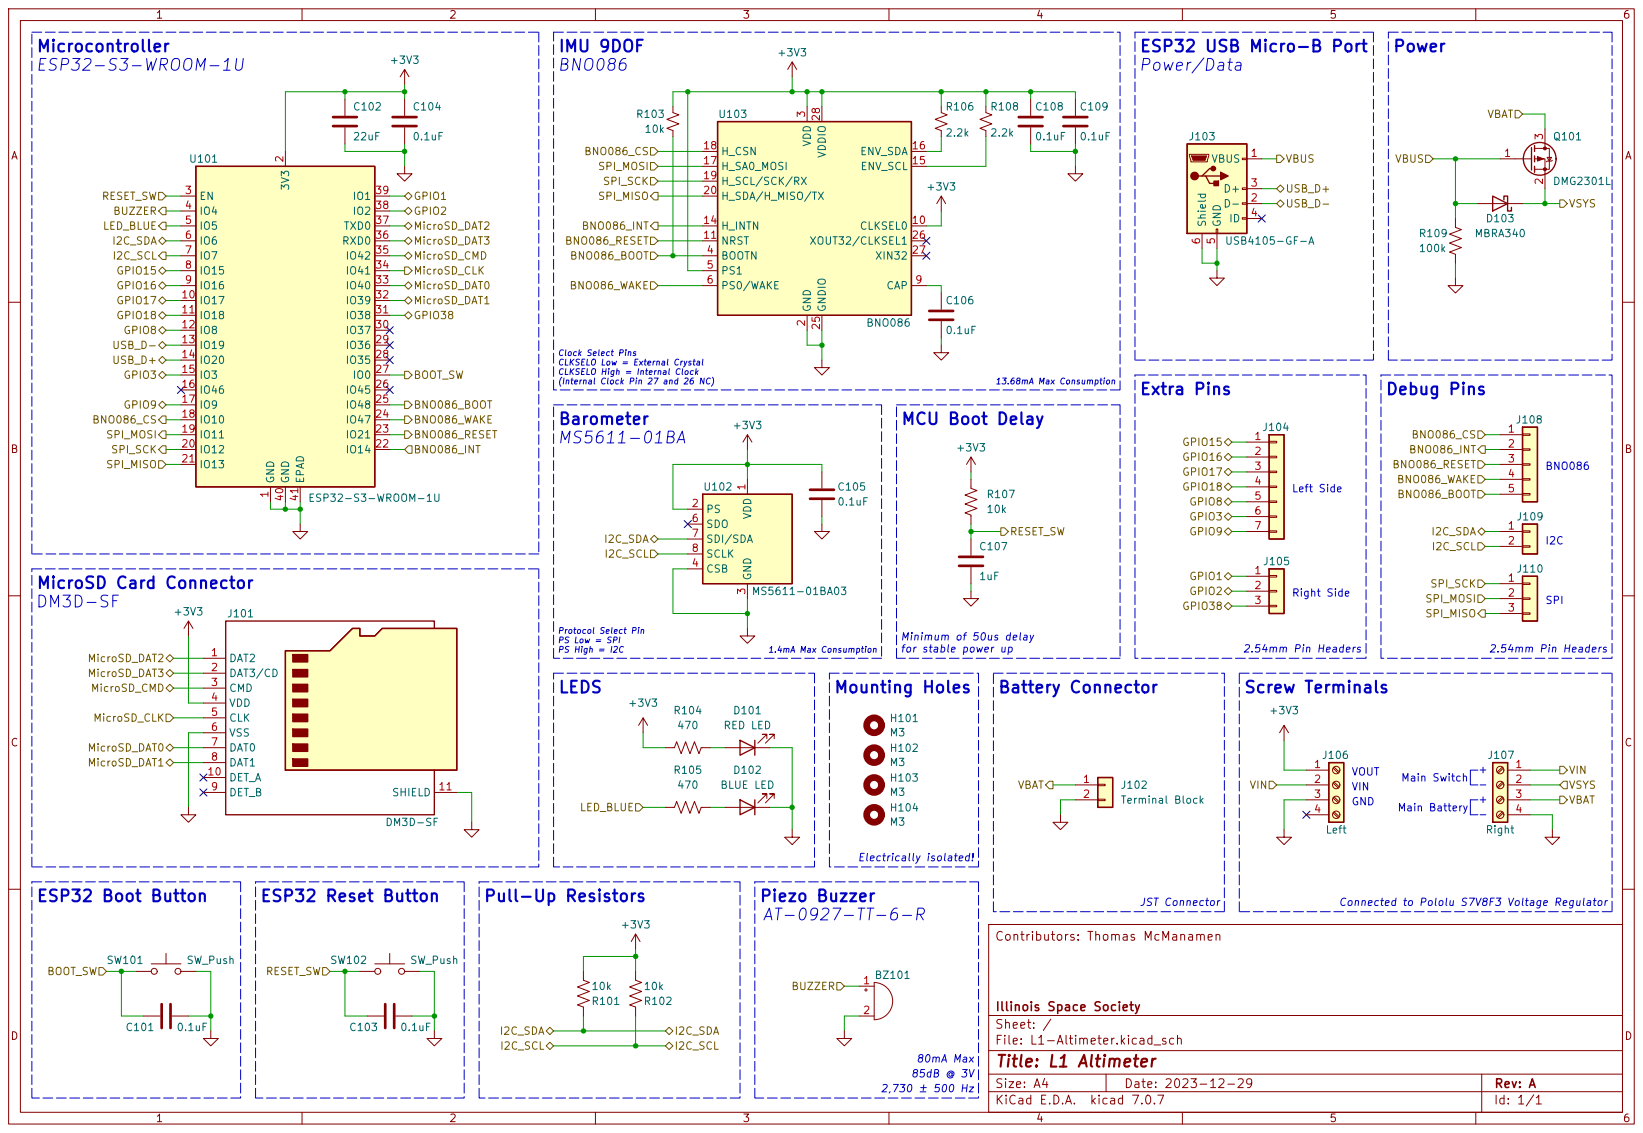
[picture p43: page 1]
