ISSUIUC/ISS-PCB/boards/MIDAS-MK2/PDFs/MIDAS-MK2.1-Layout-Combined.pdf

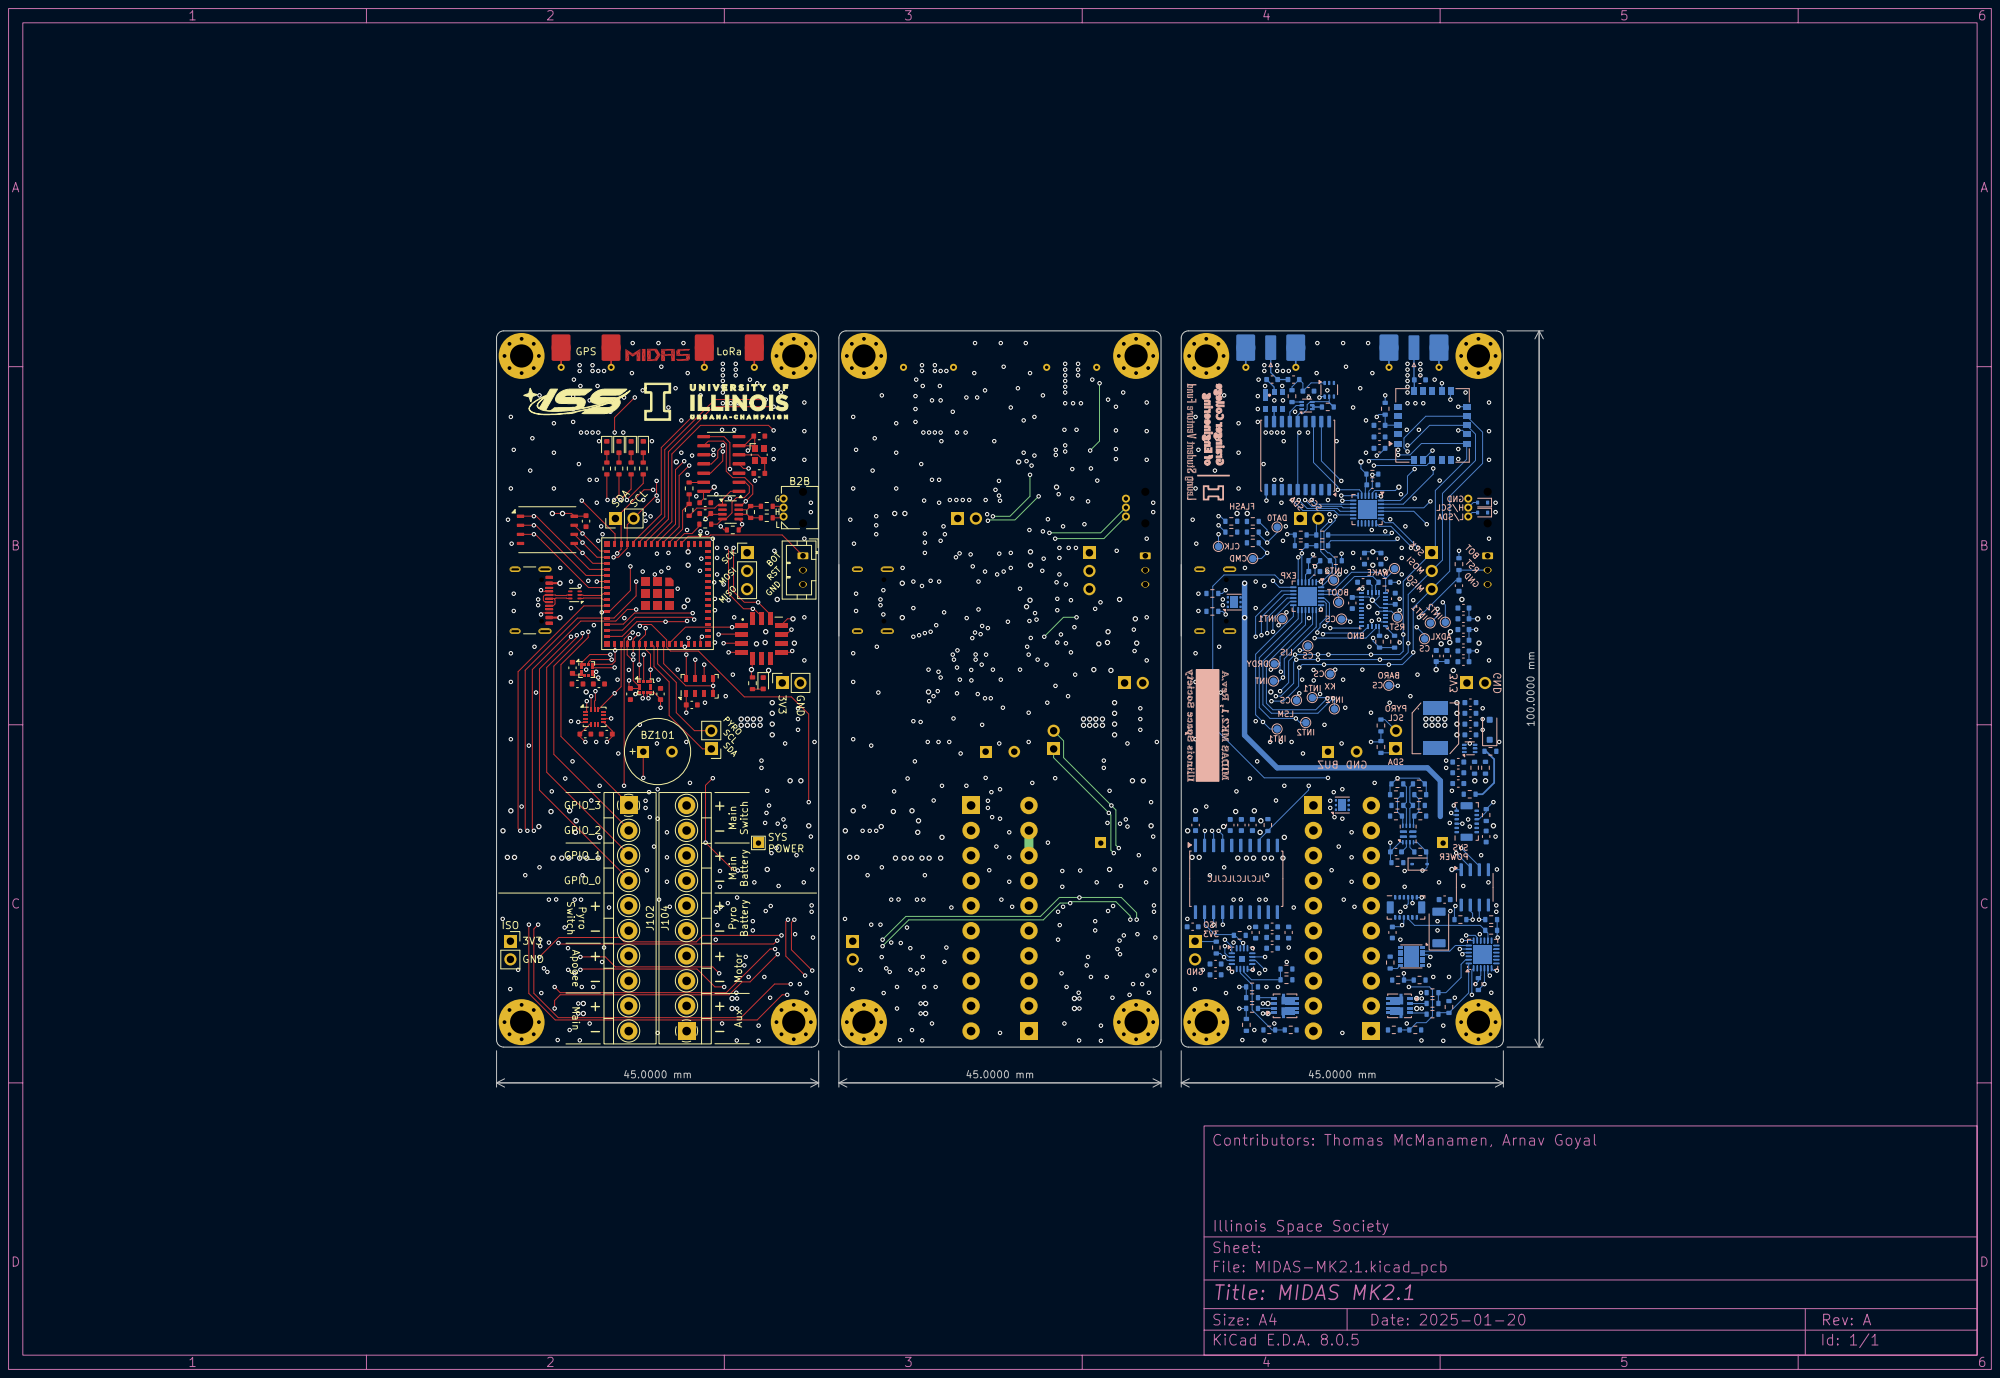
[picture p44: page 1]
