ISSUIUC/ISS-PCB/boards/Onboarding/555-Timer-Demo-Circuit/555-Timer-Demo-Circuit-Layout.pdf

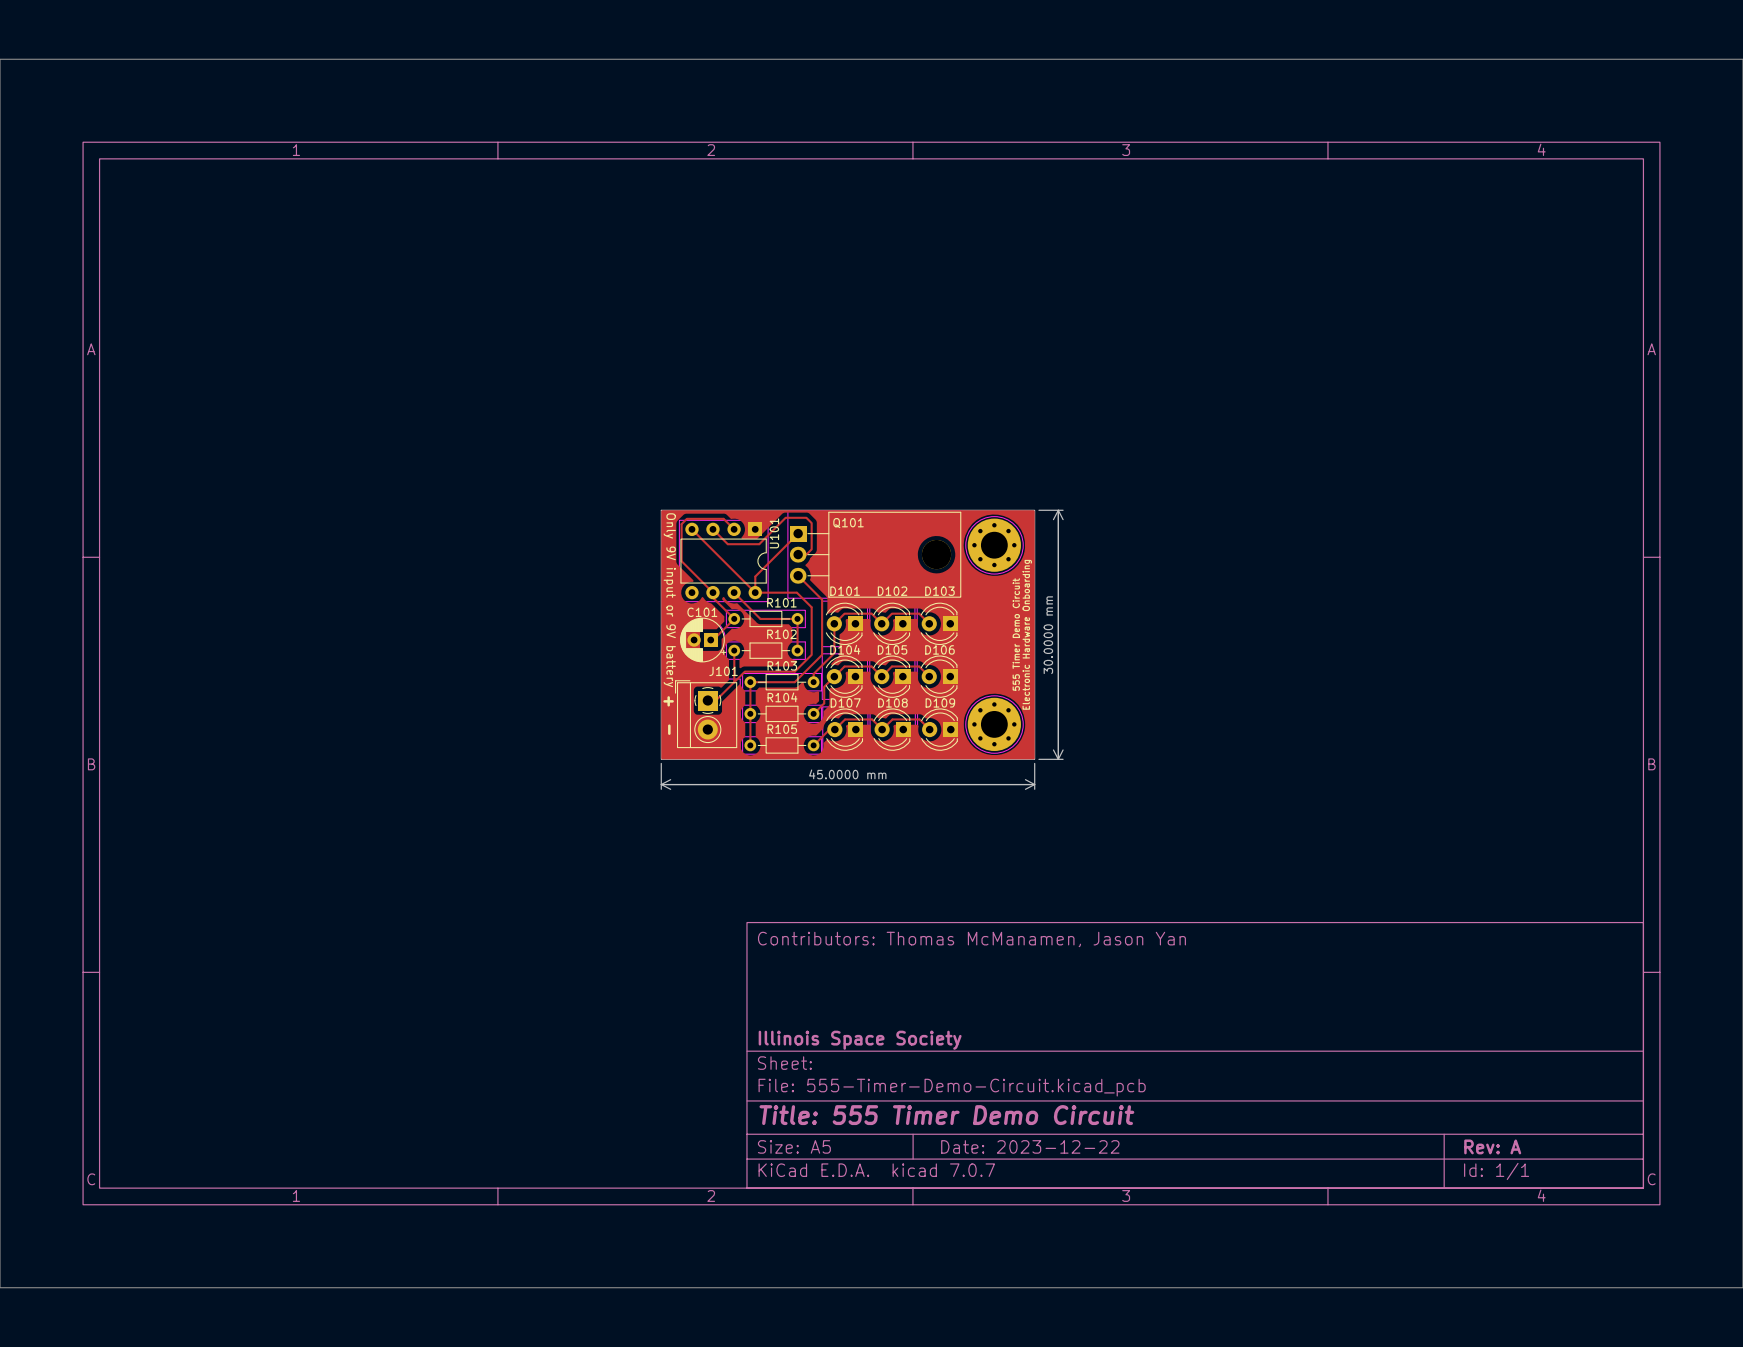
[picture p45: page 1]
