ISSUIUC/ISS-PCB/boards/Onboarding/L1-Altimeter/L1-Altimeter-Layout.pdf

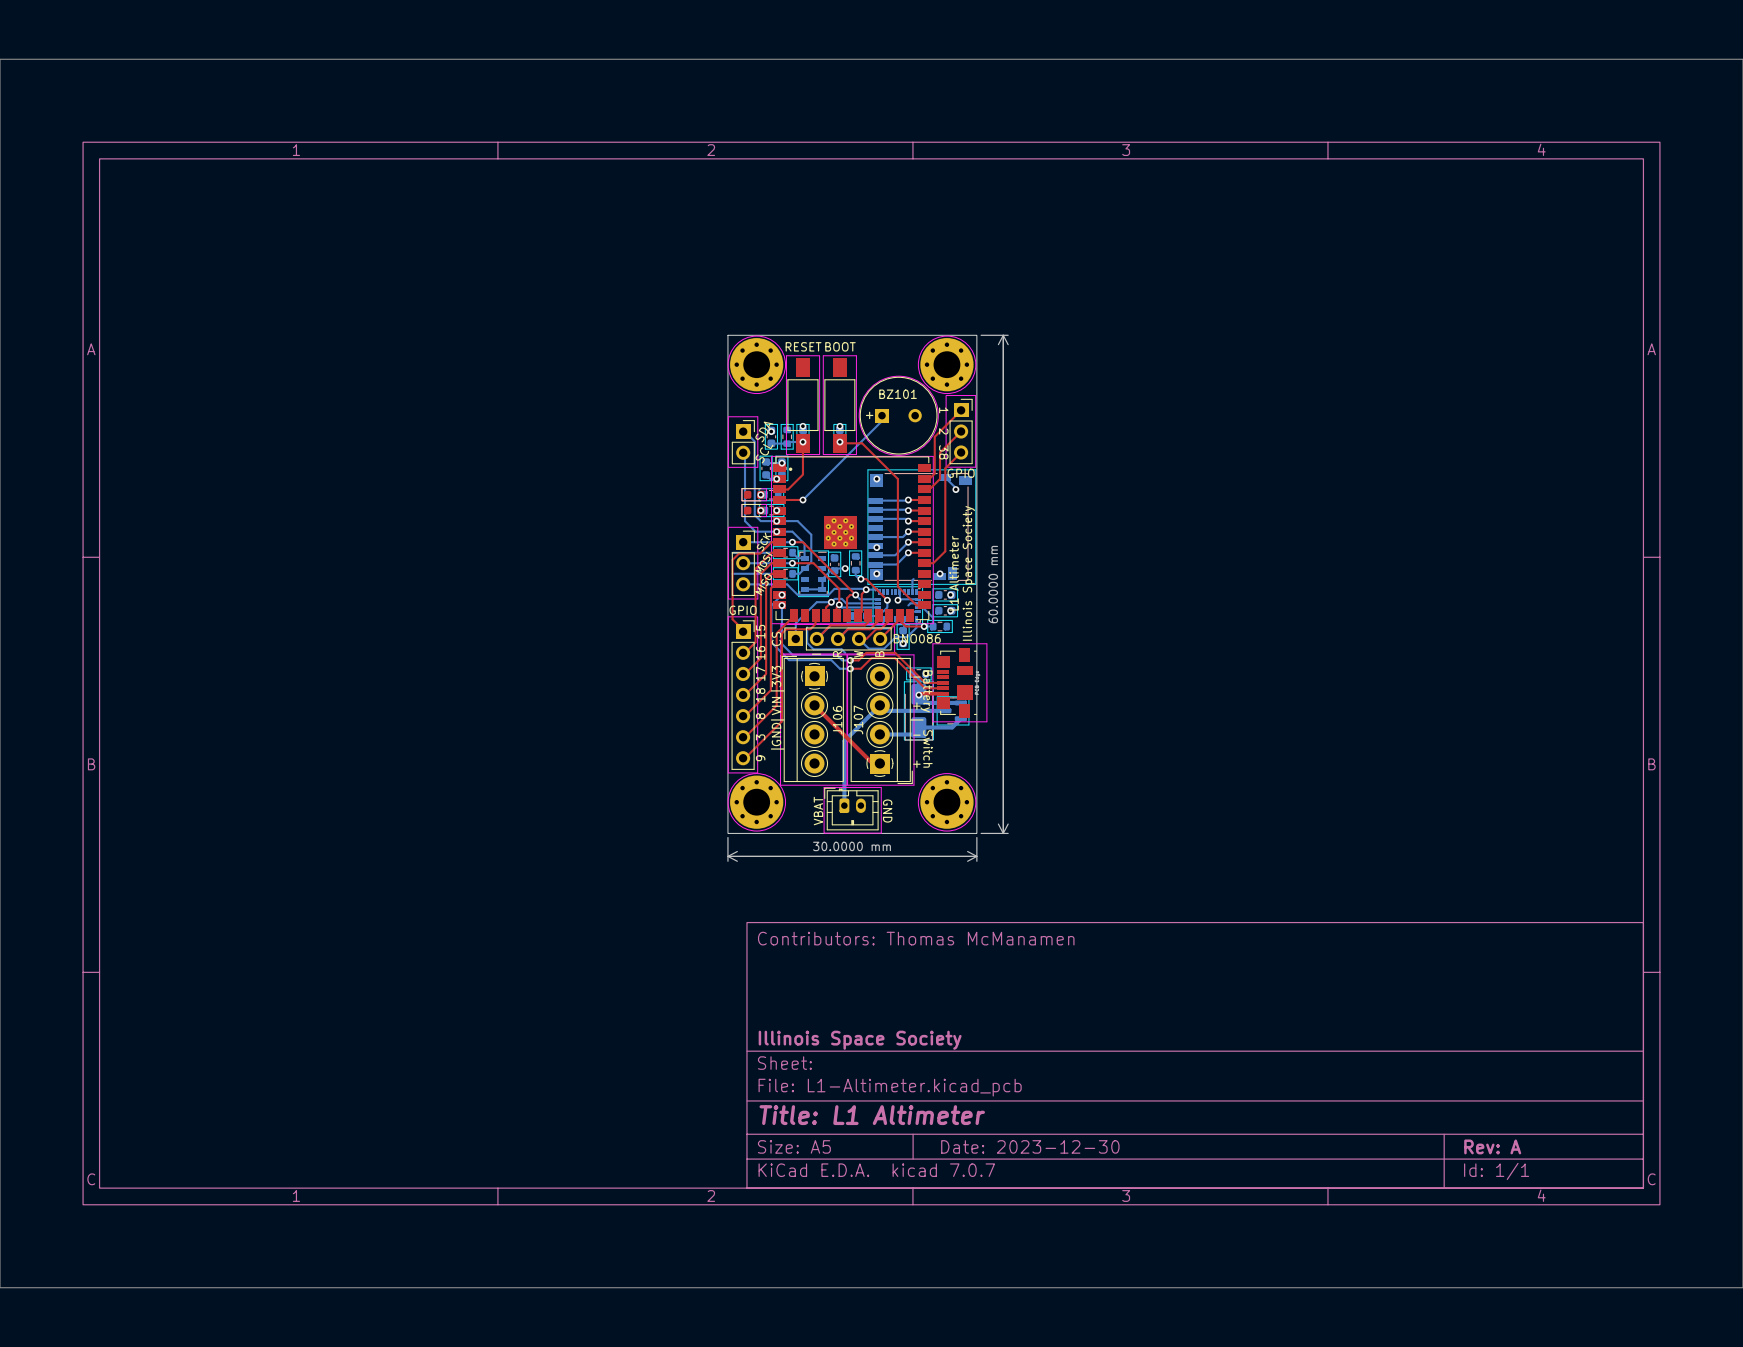
[picture p46: page 1]

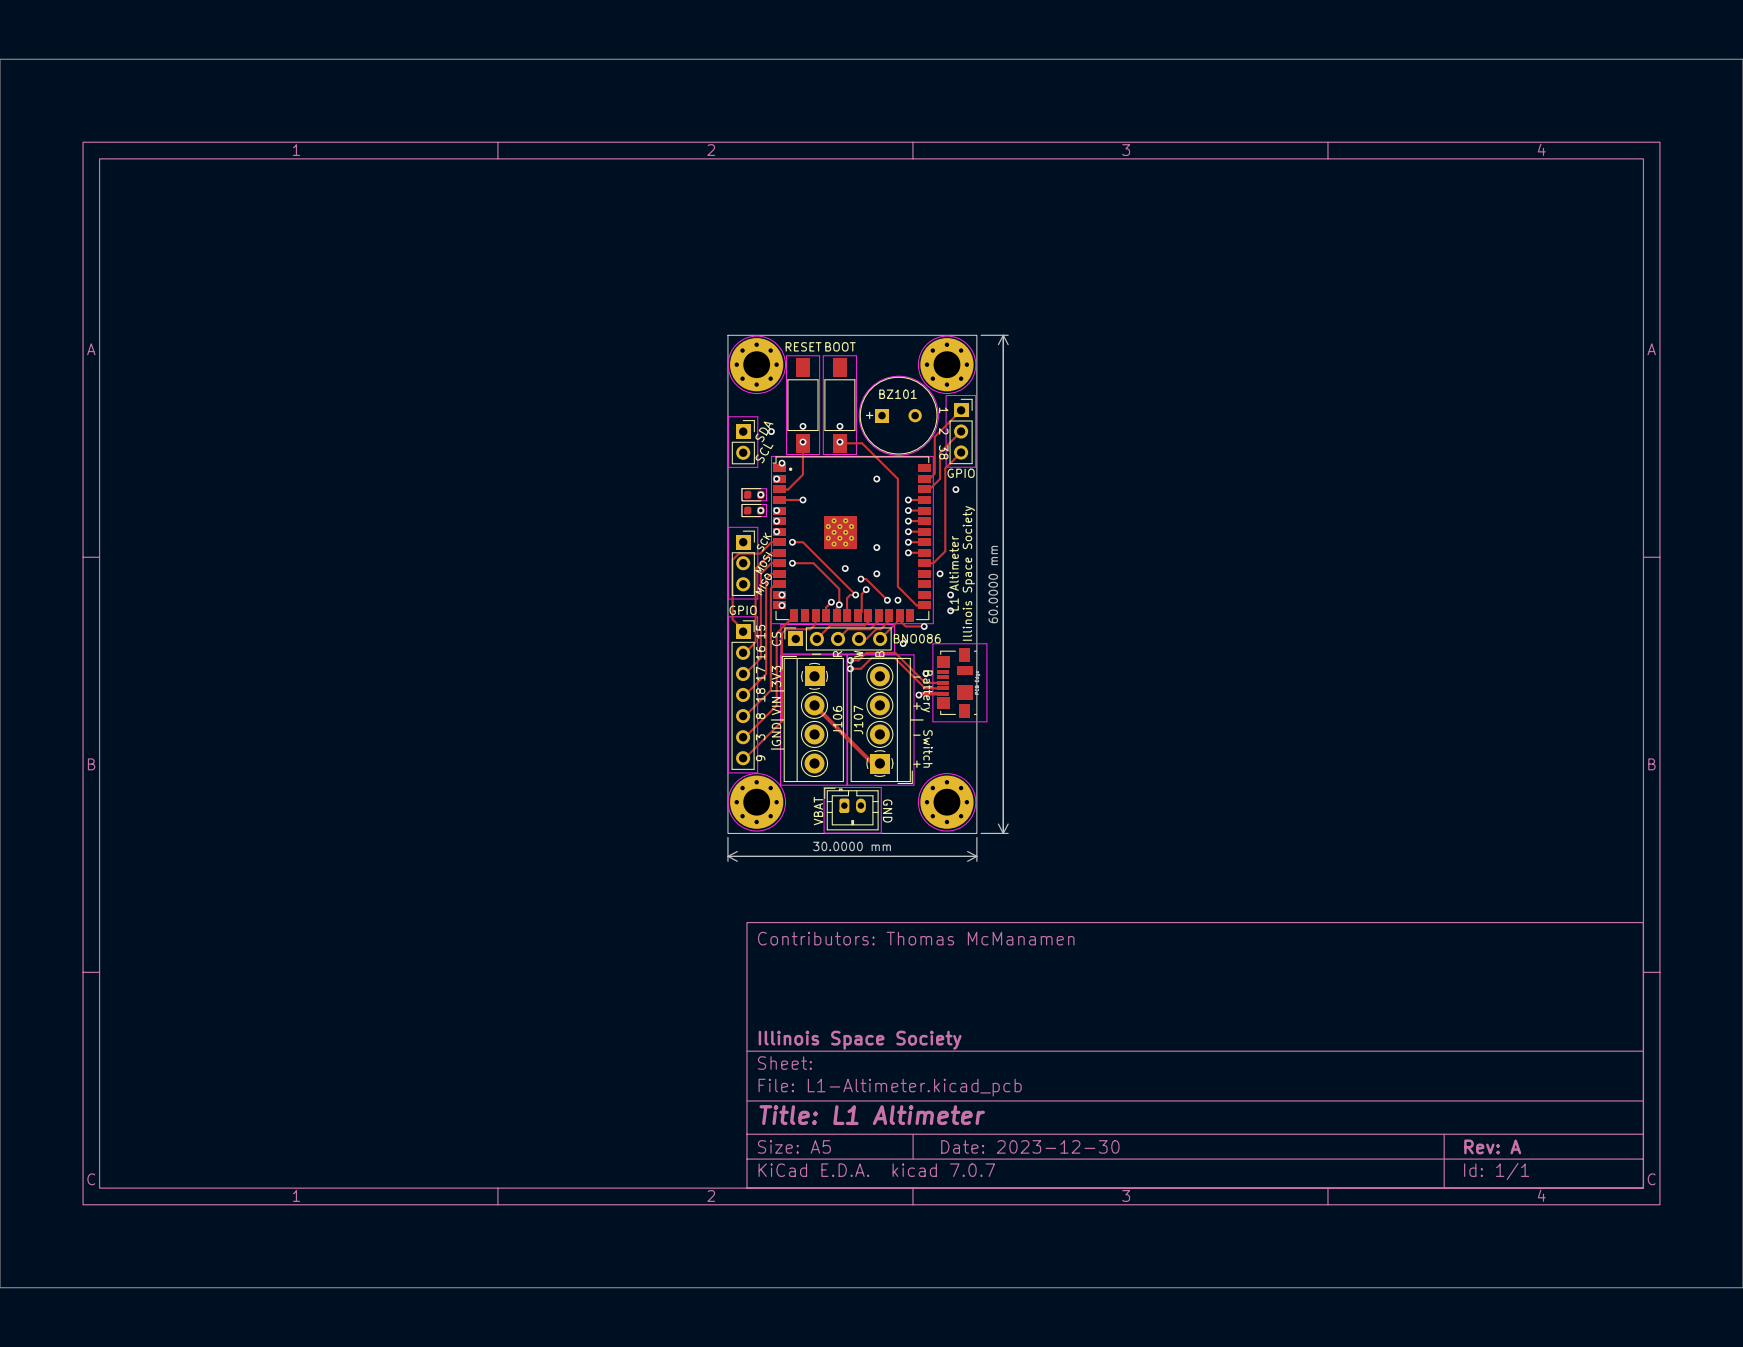
[picture p47: page 2]

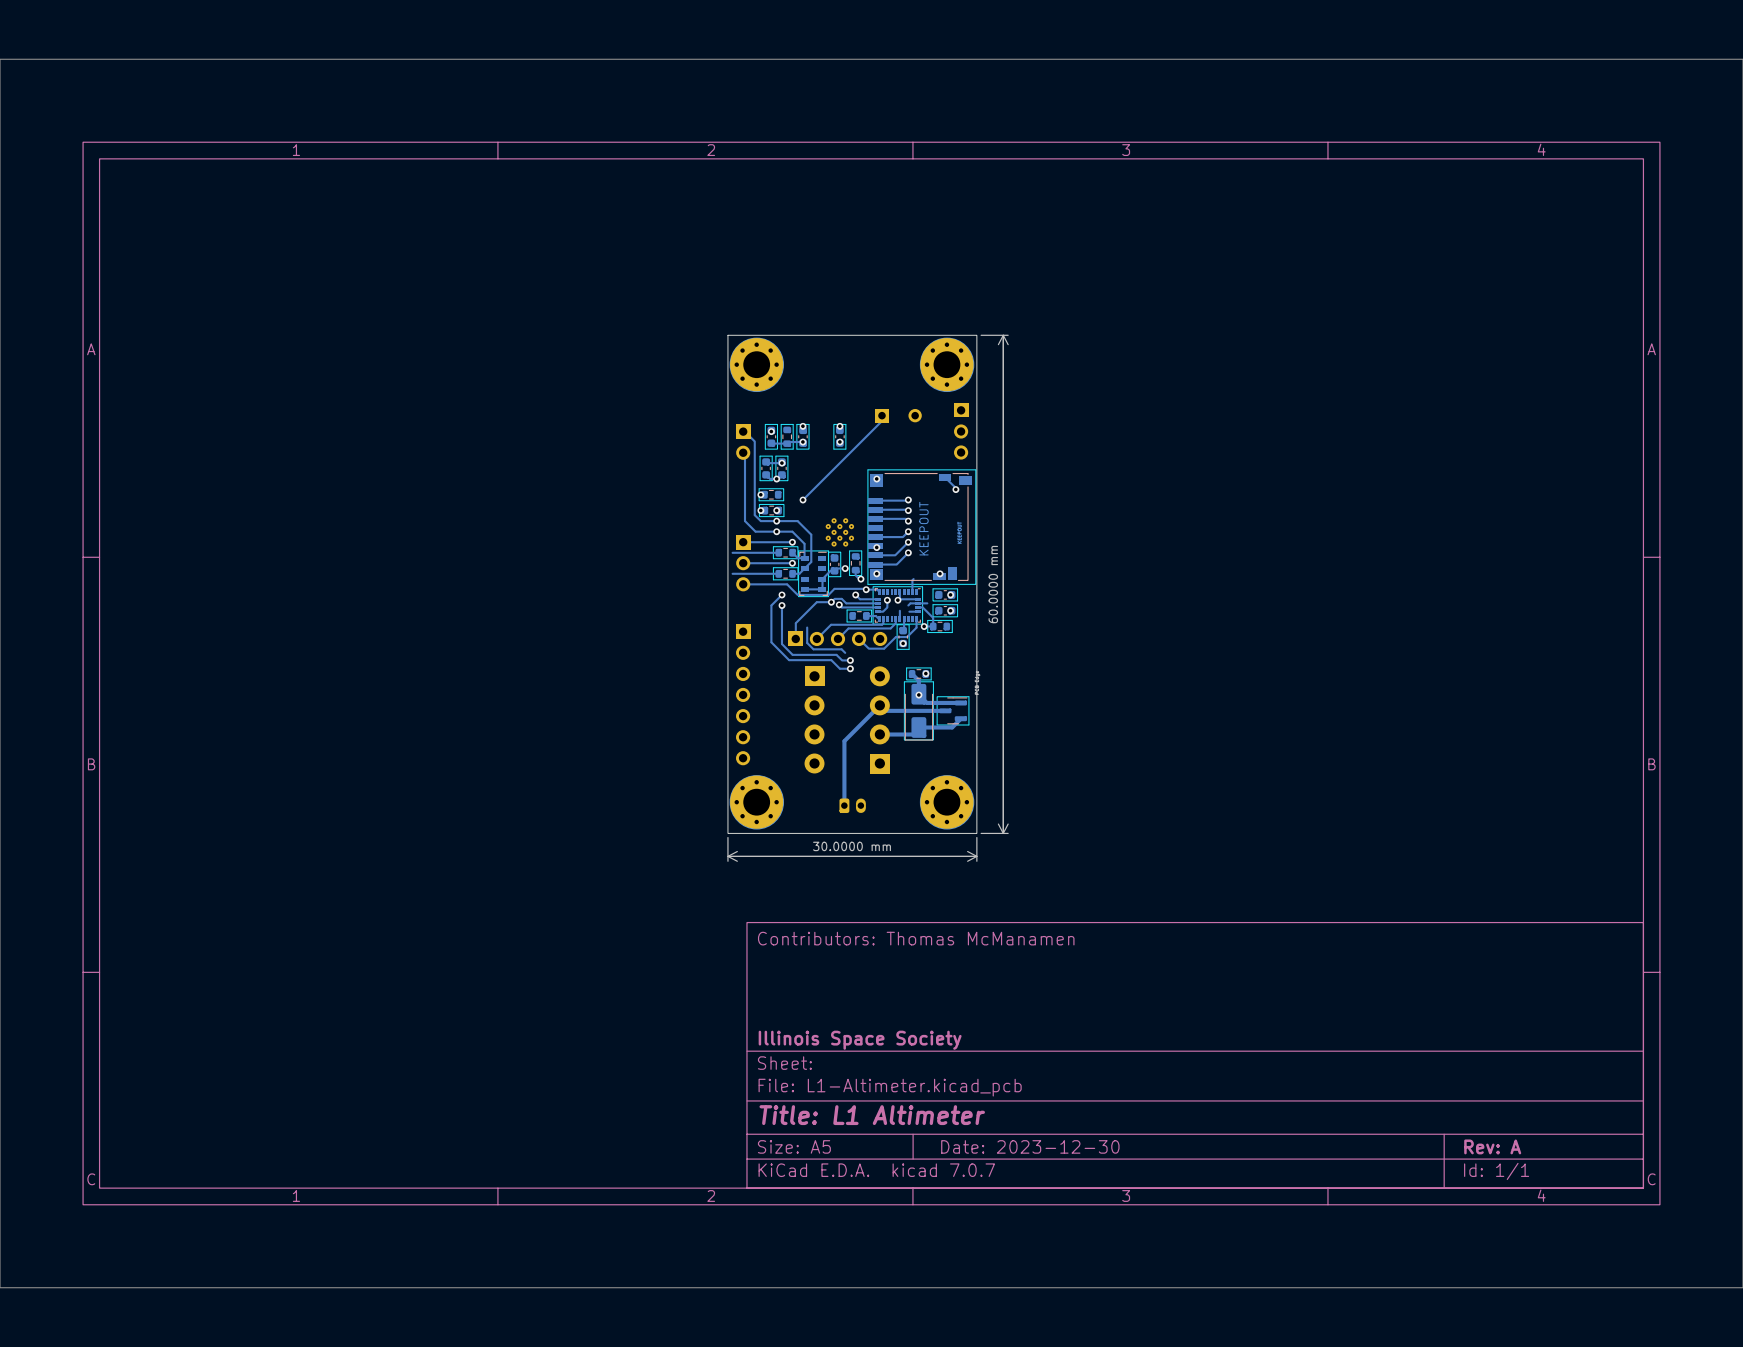
[picture p48: page 3]

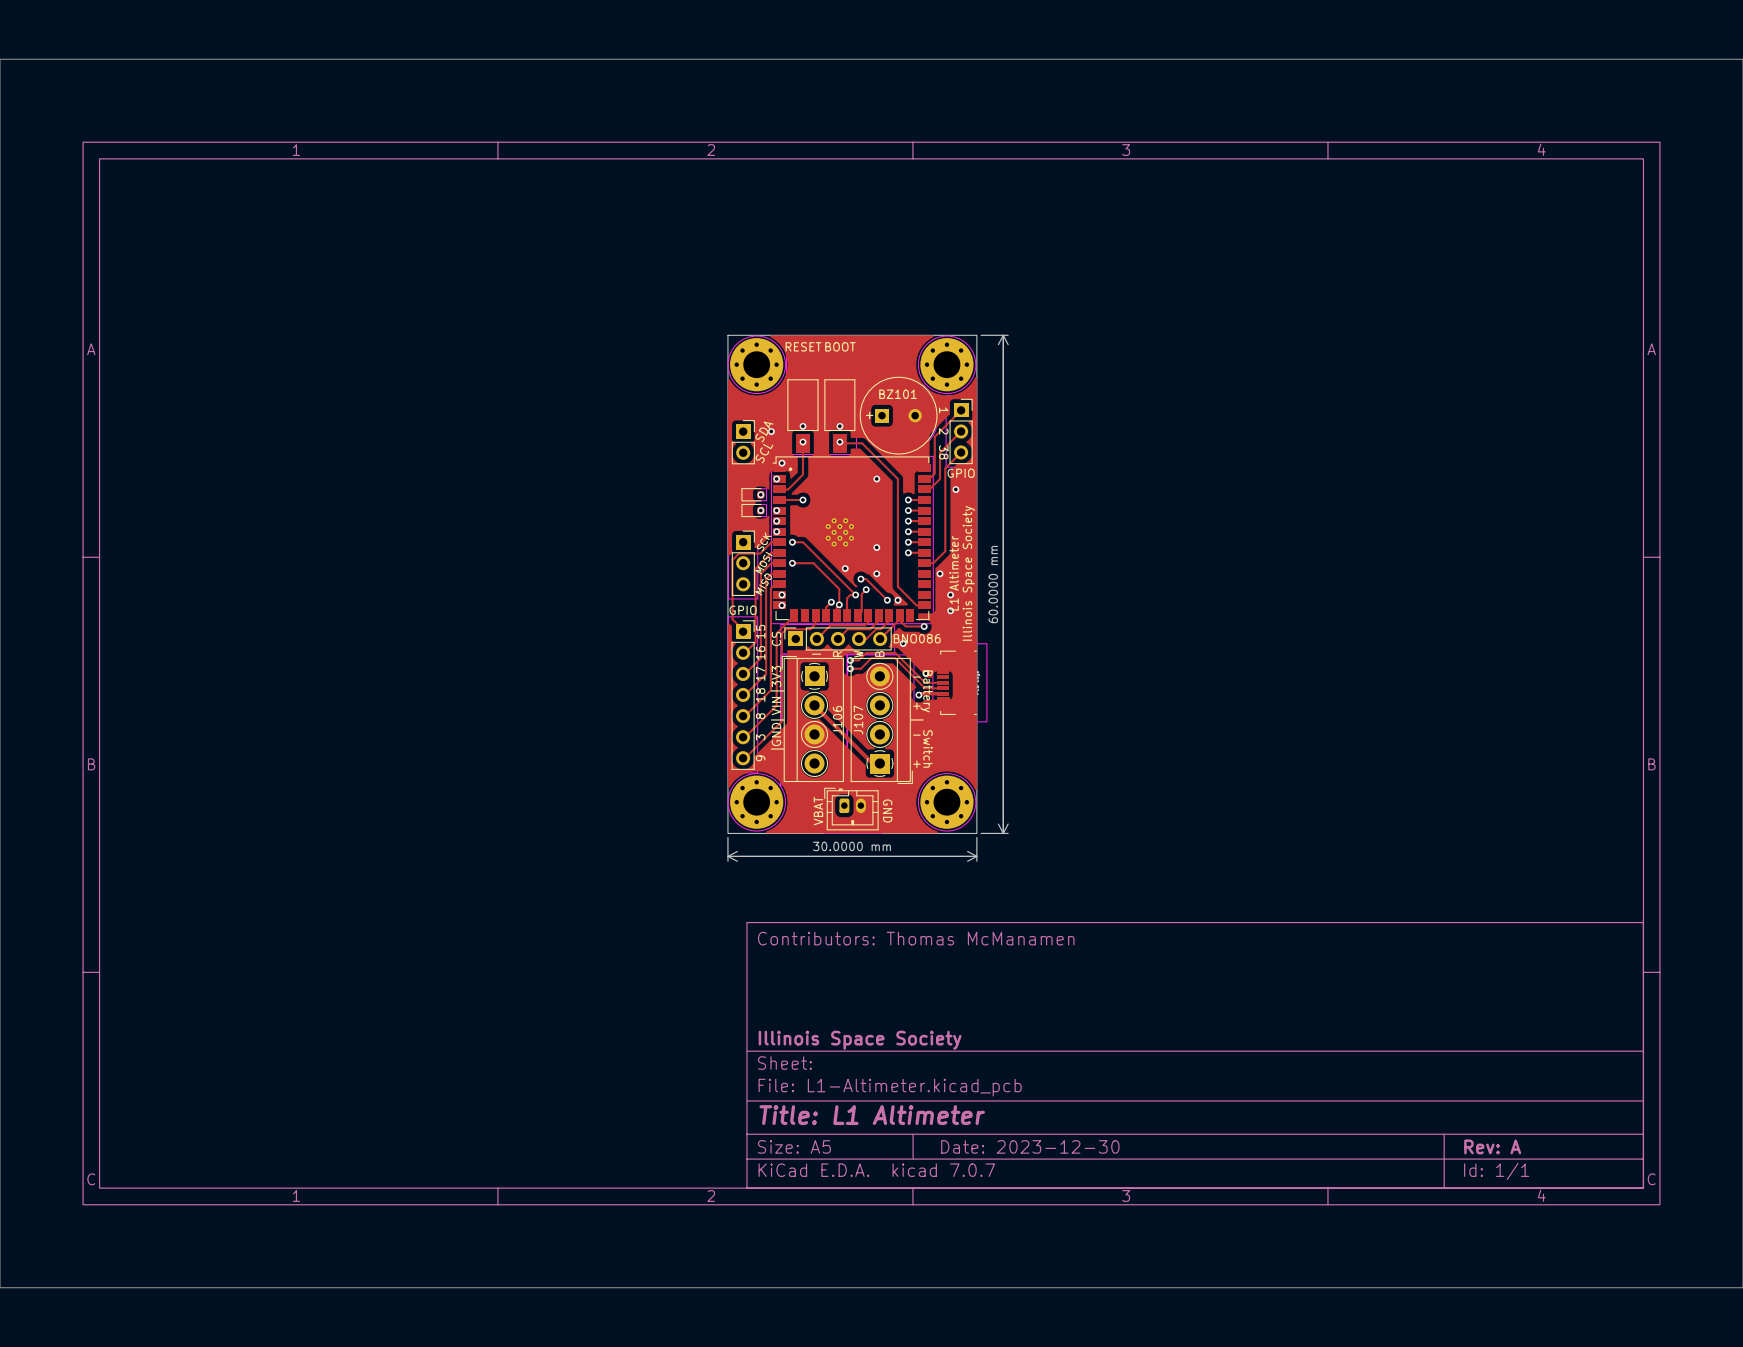
[picture p49: page 4]

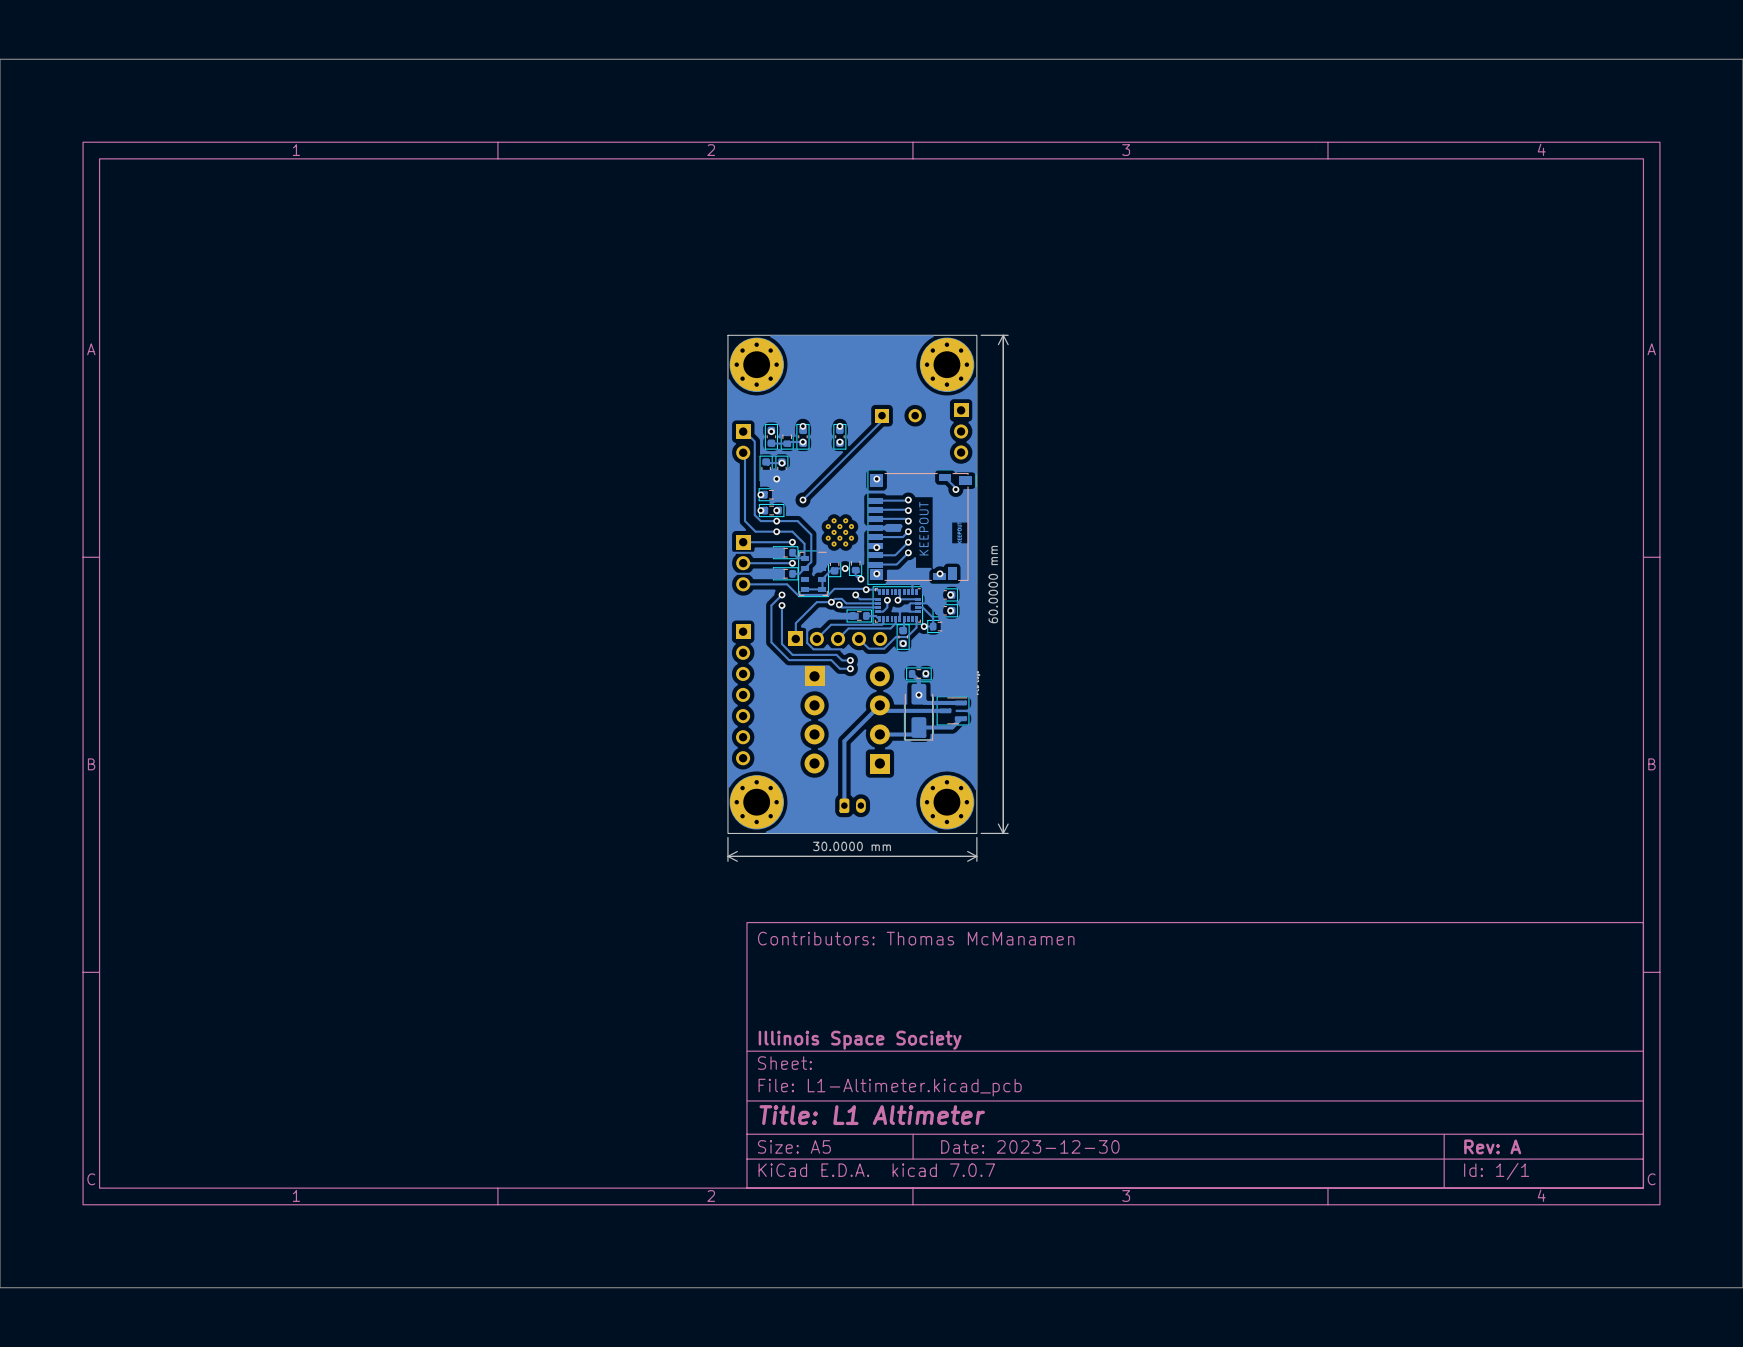
[picture p50: page 5]
