ISSUIUC/ISS-PCB/boards/CAM-MK2/PDFs/CAM-MK2.1-Schematic.pdf

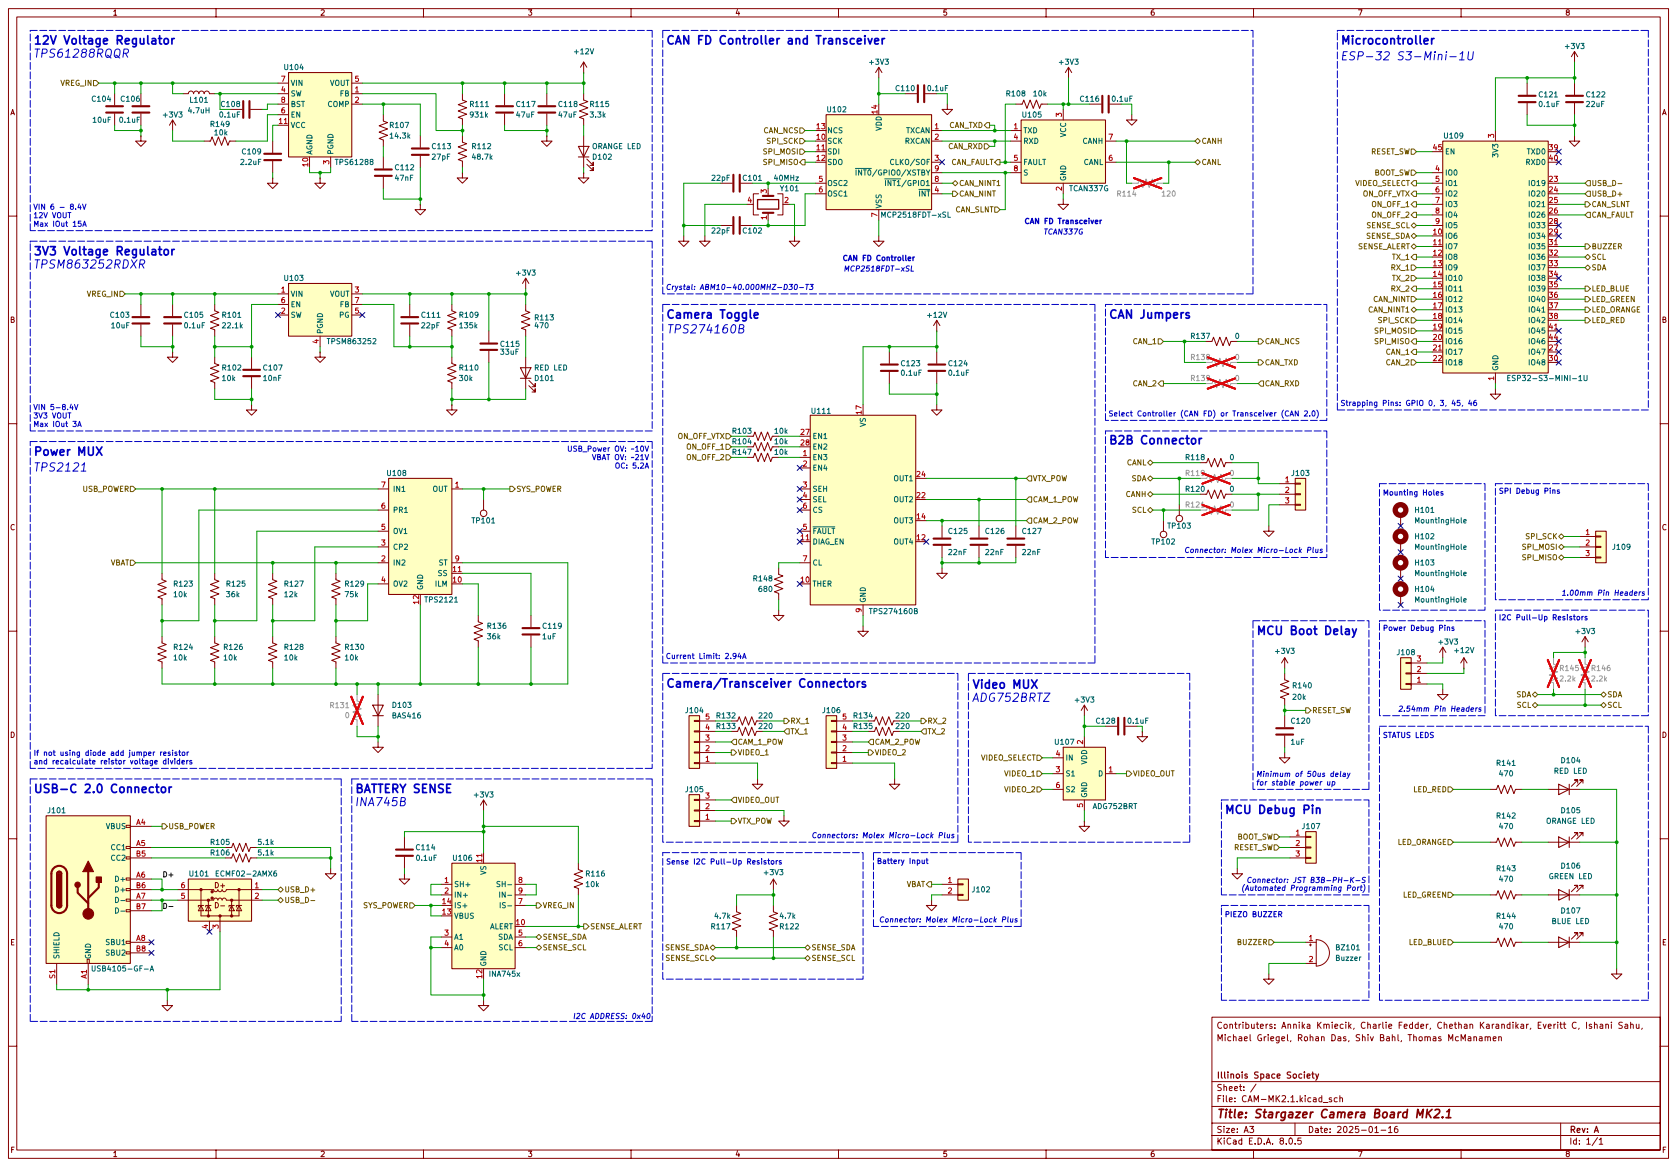
[picture p51: page 1]
