ISSUIUC/ISS-PCB/boards/MIDAS-MK1/PDFs/MIDAS-MK1.1-Schematic.pdf

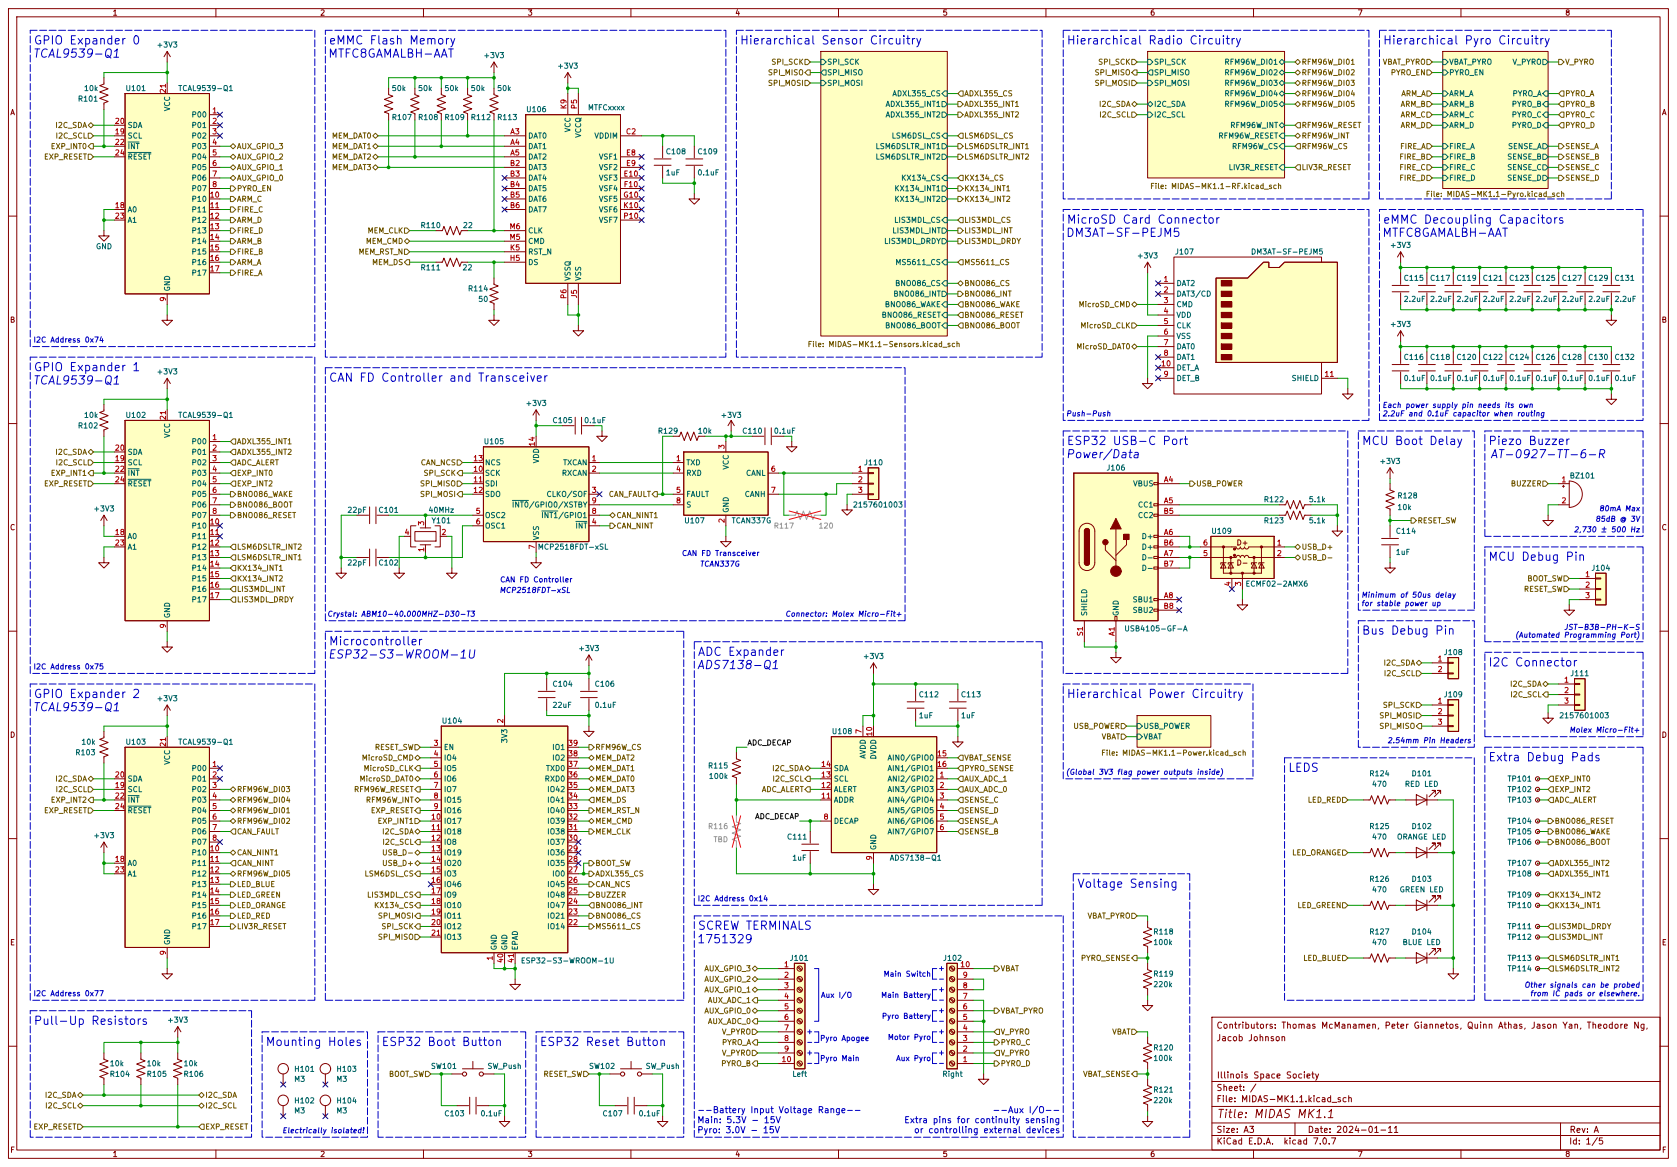
[picture p52: page 1]

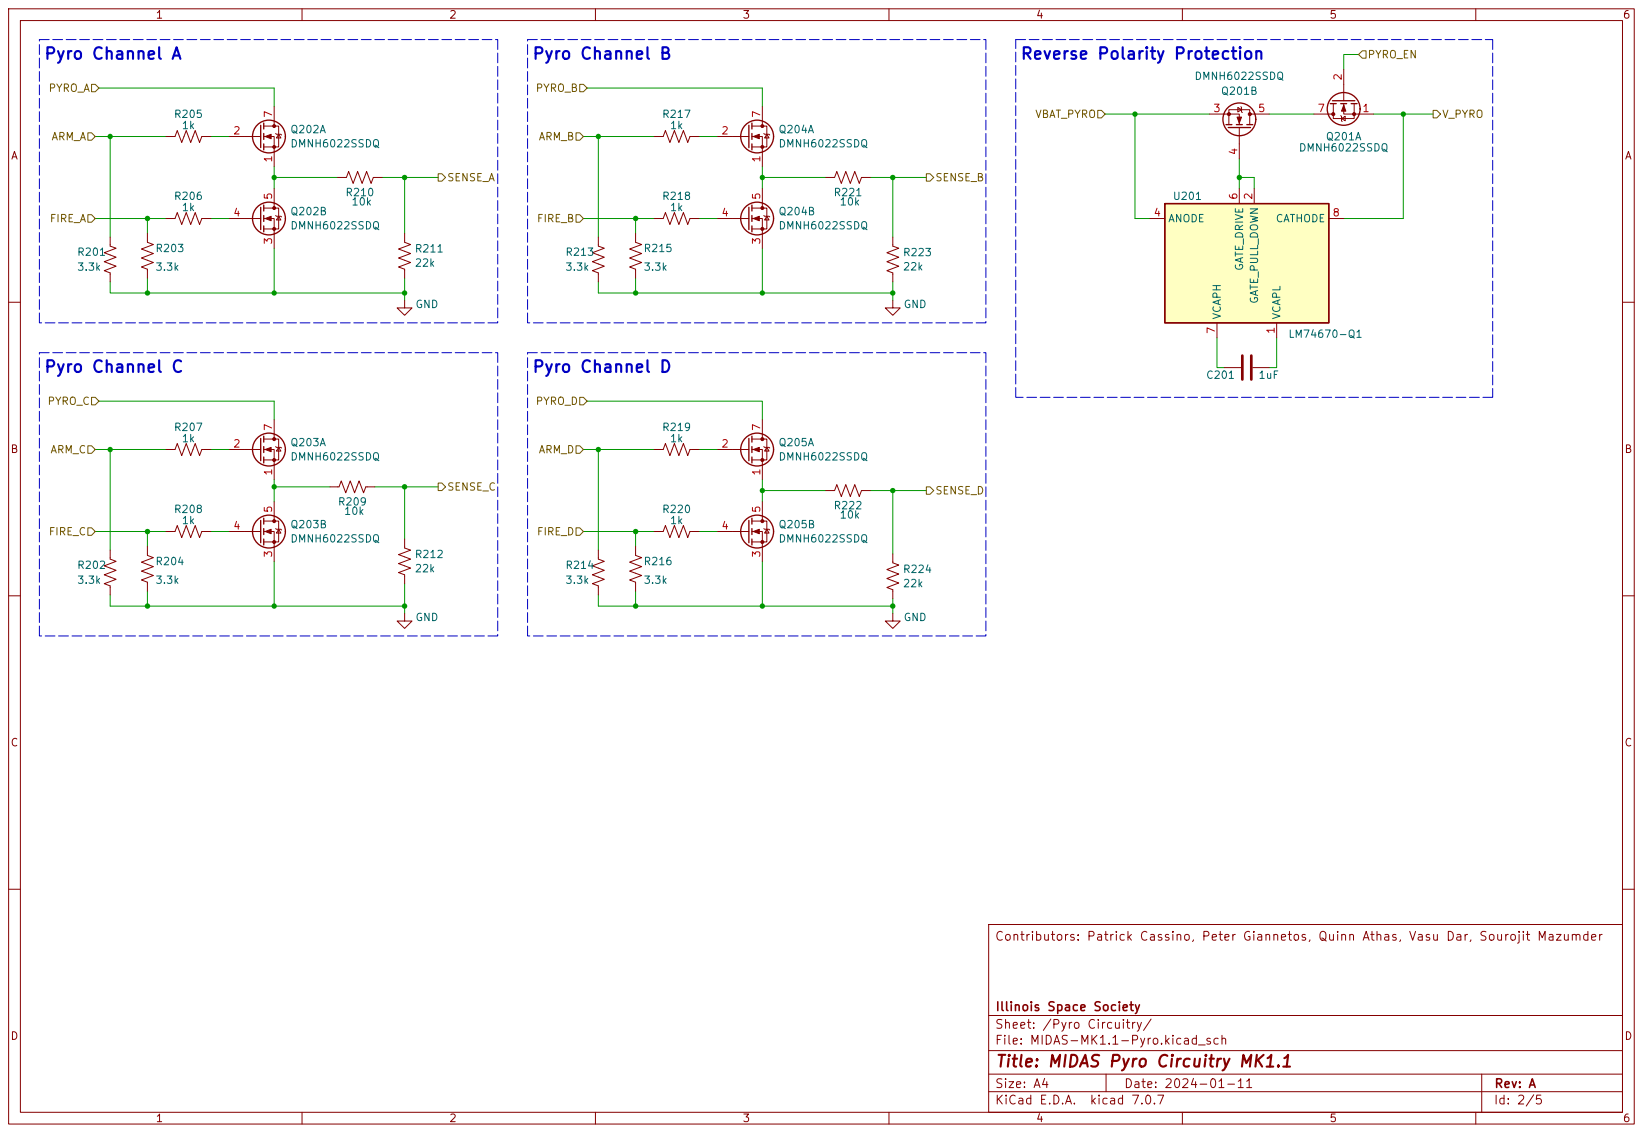
[picture p53: page 2]

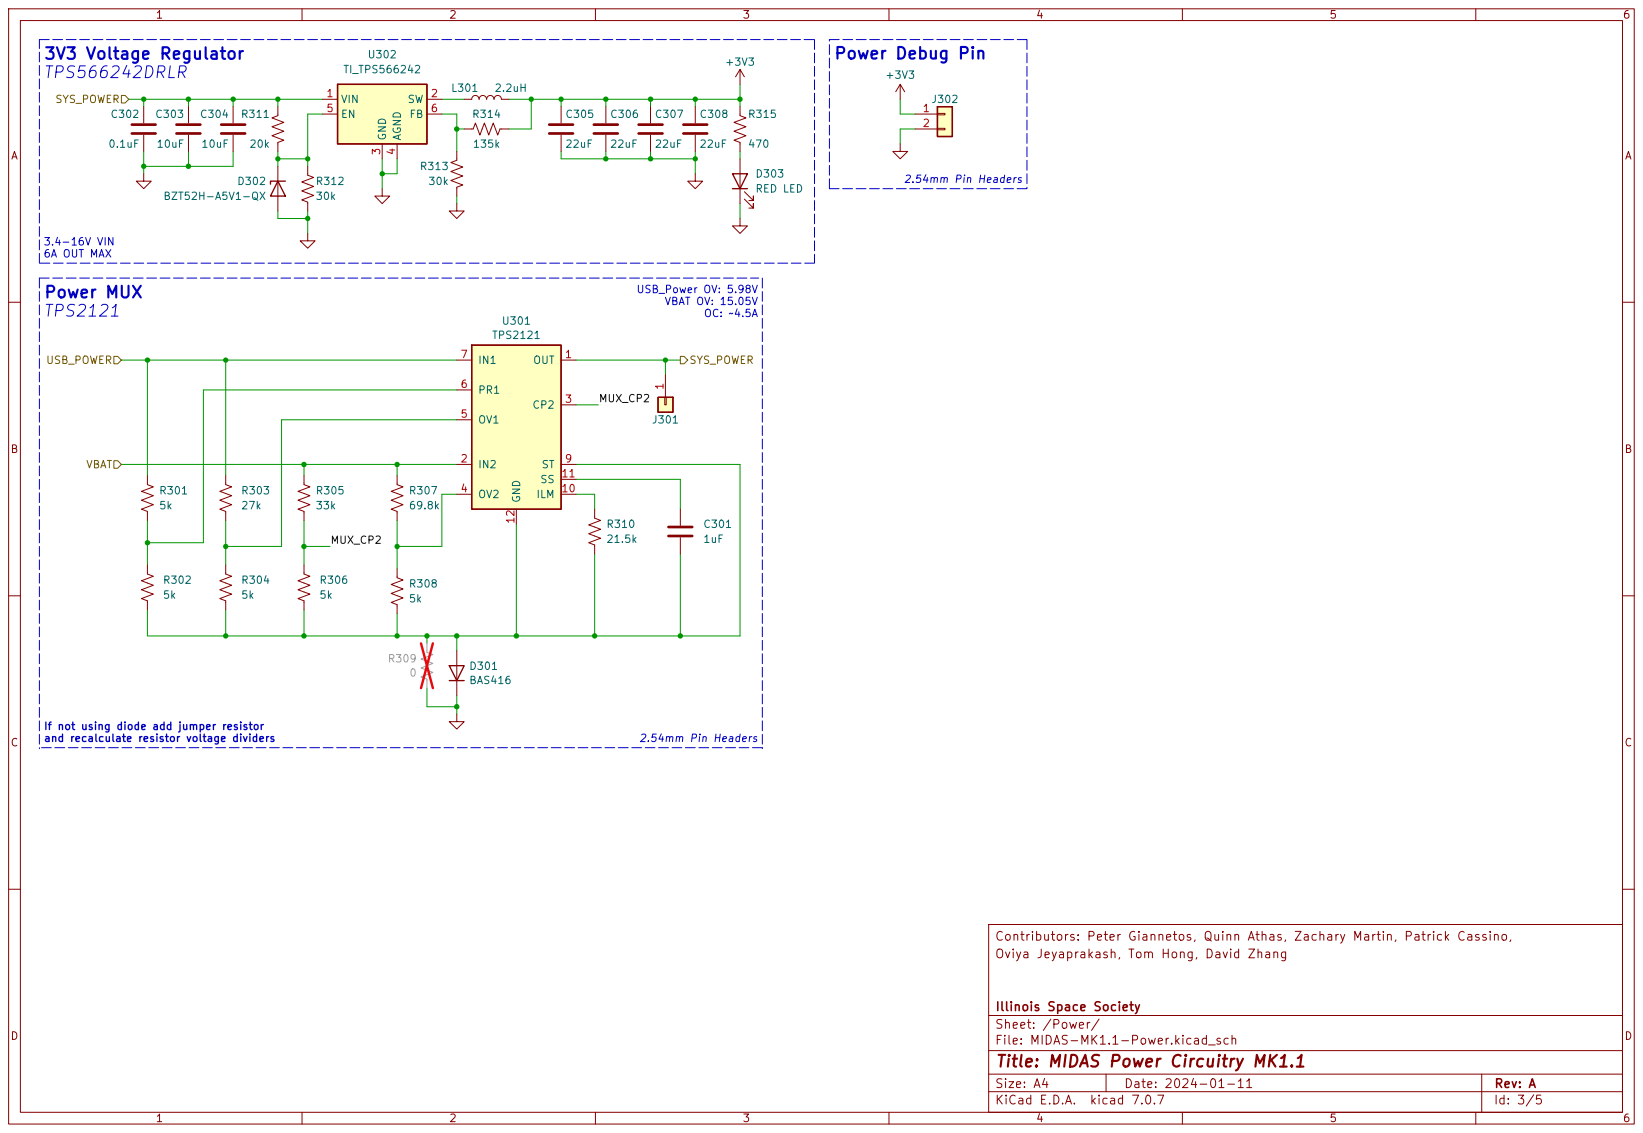
[picture p54: page 3]

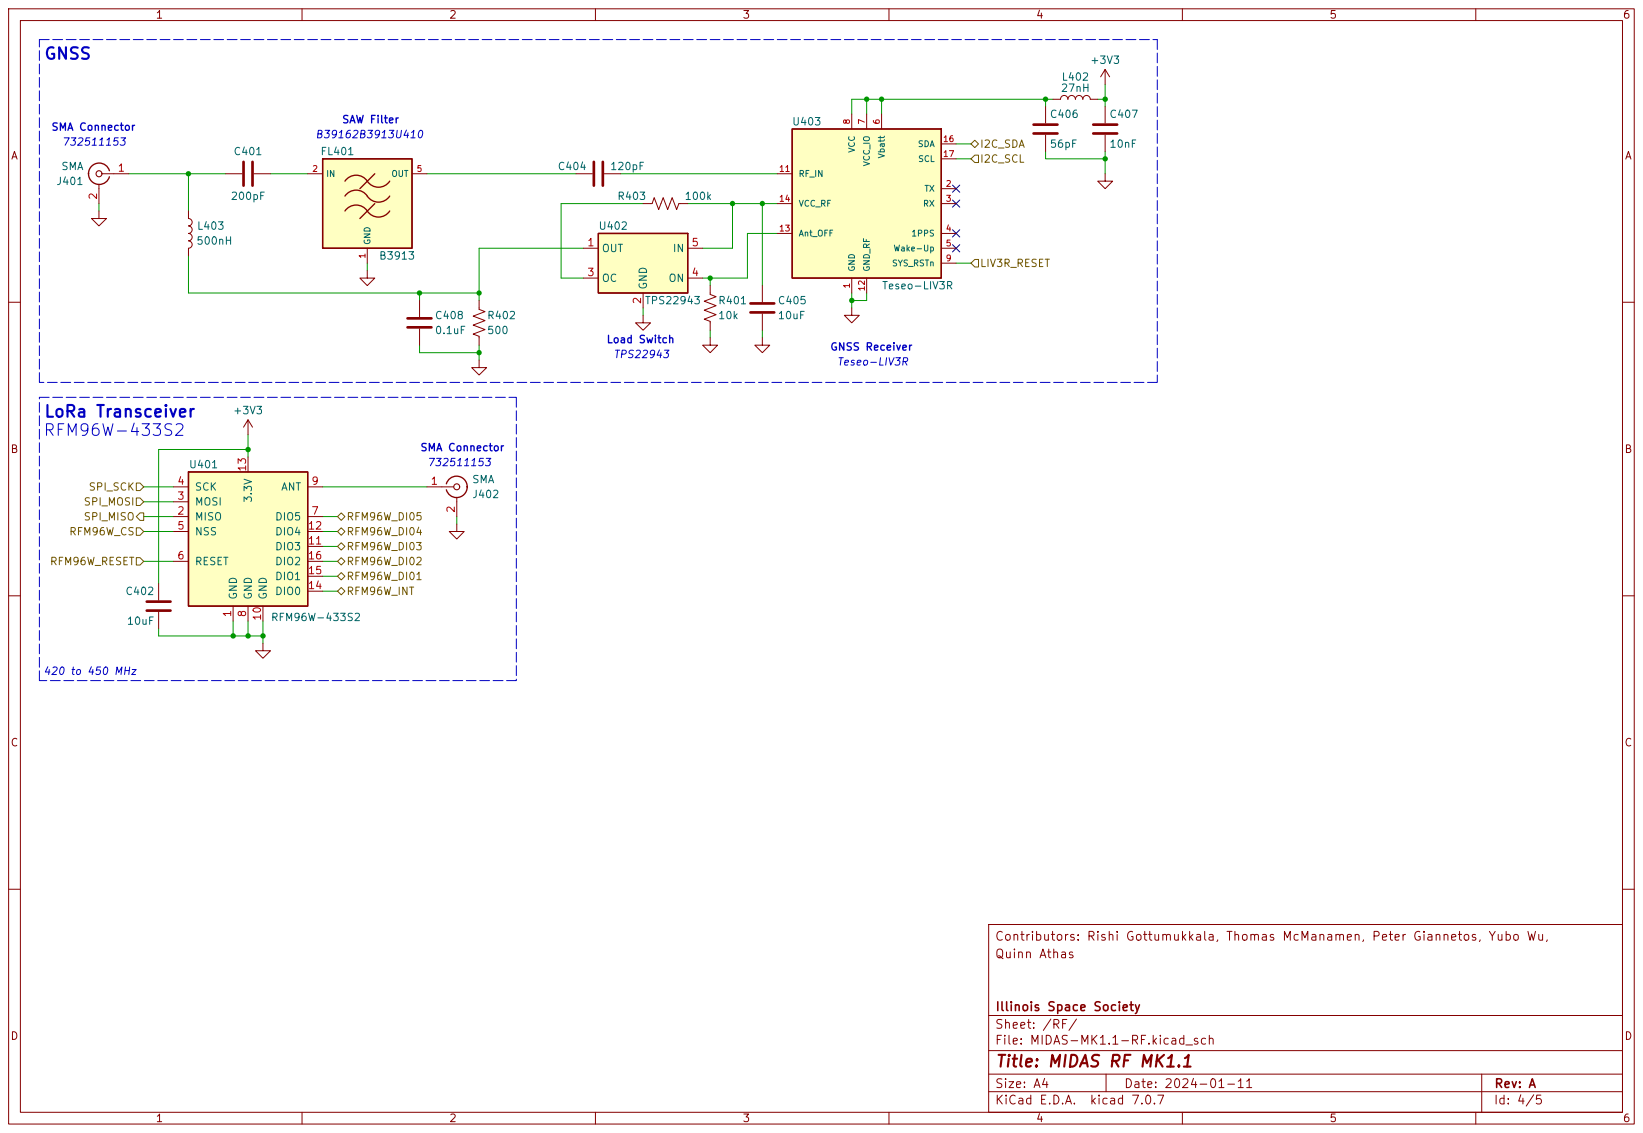
[picture p55: page 4]

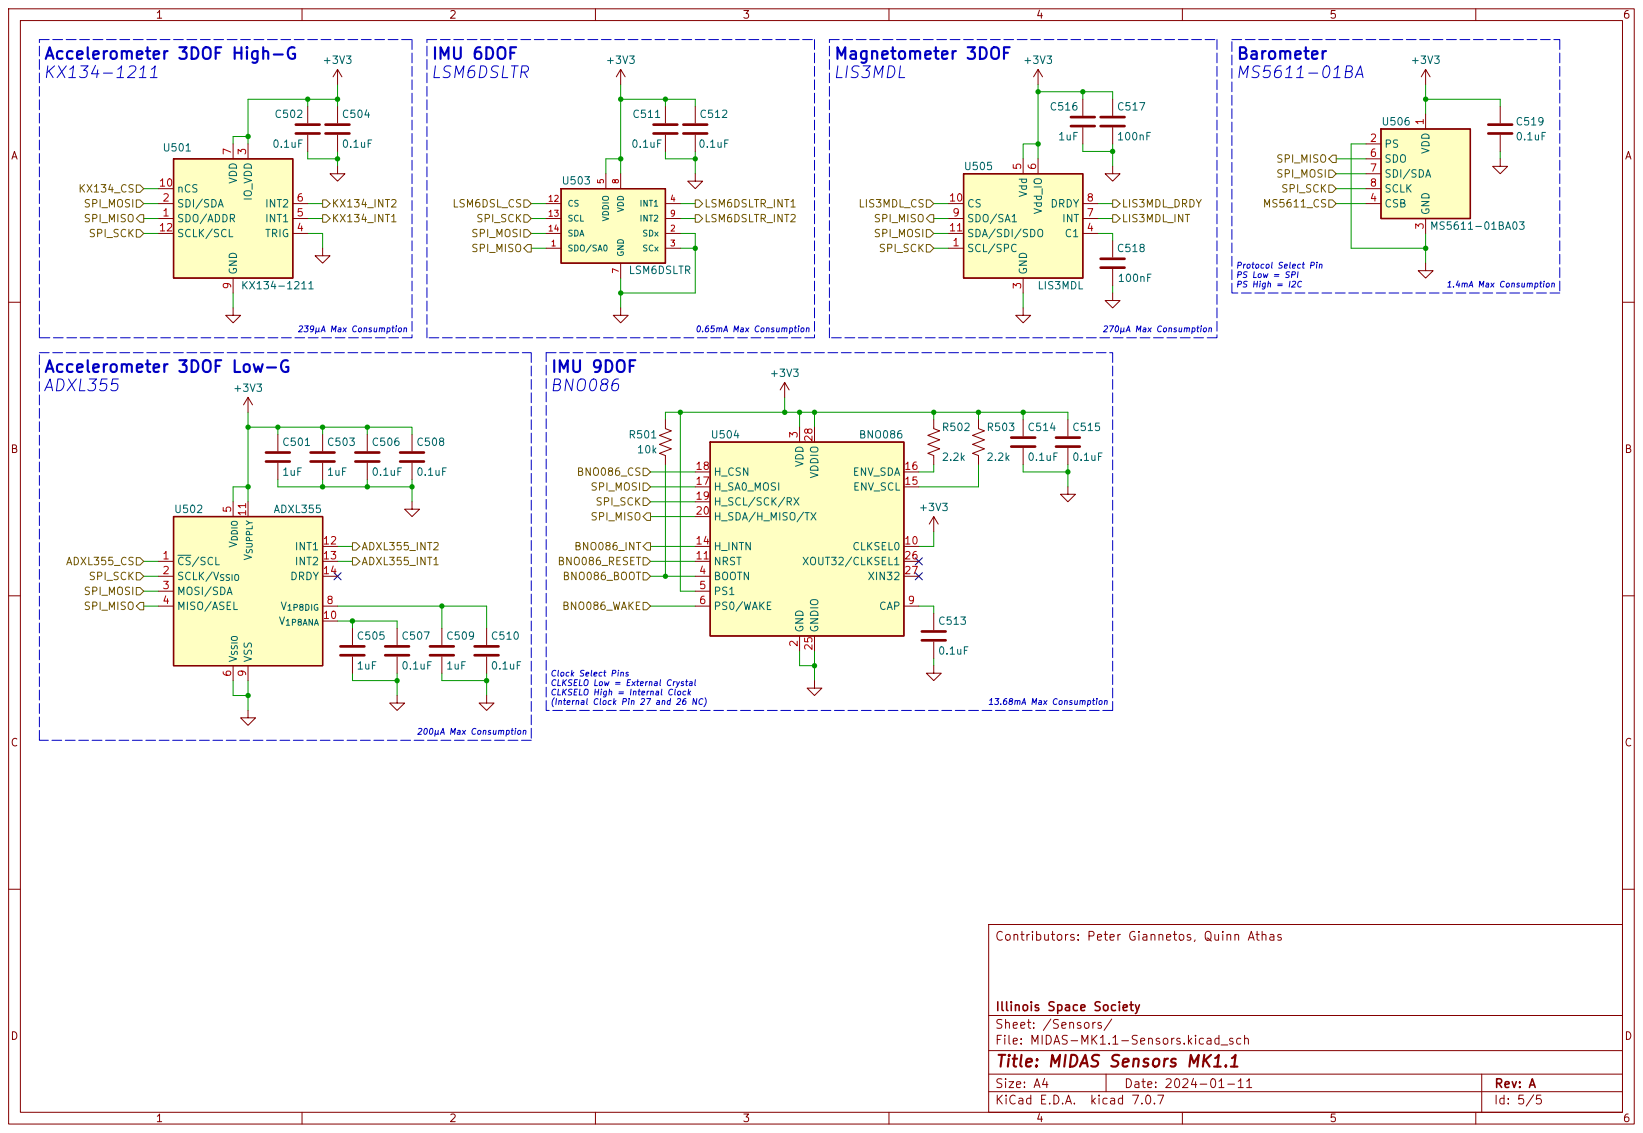
[picture p56: page 5]
