ISSUIUC/ISS-PCB/boards/MIDAS-MK1/PDFs/MIDAS-MK1.1-Layout.pdf

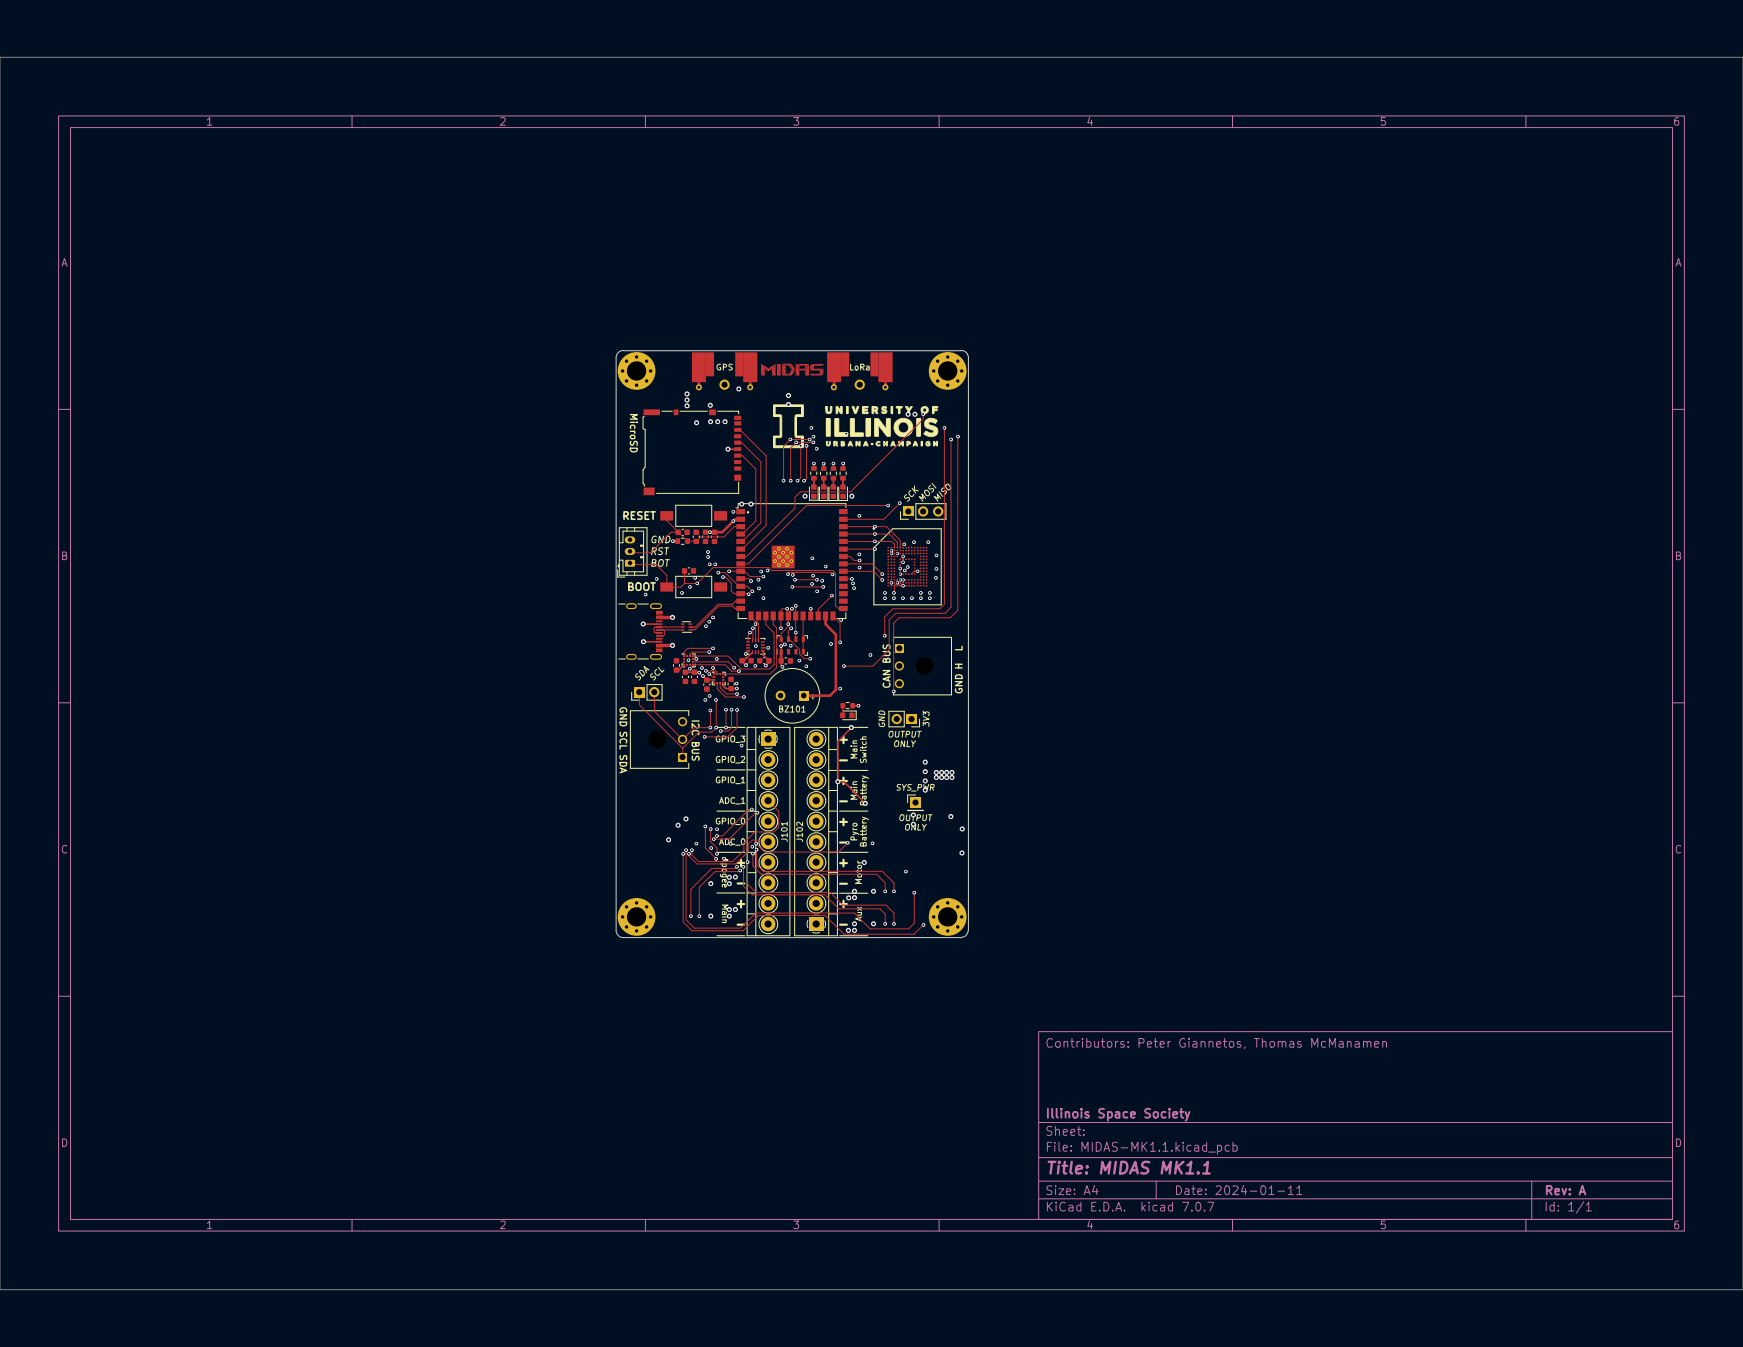
[picture p57: page 1]

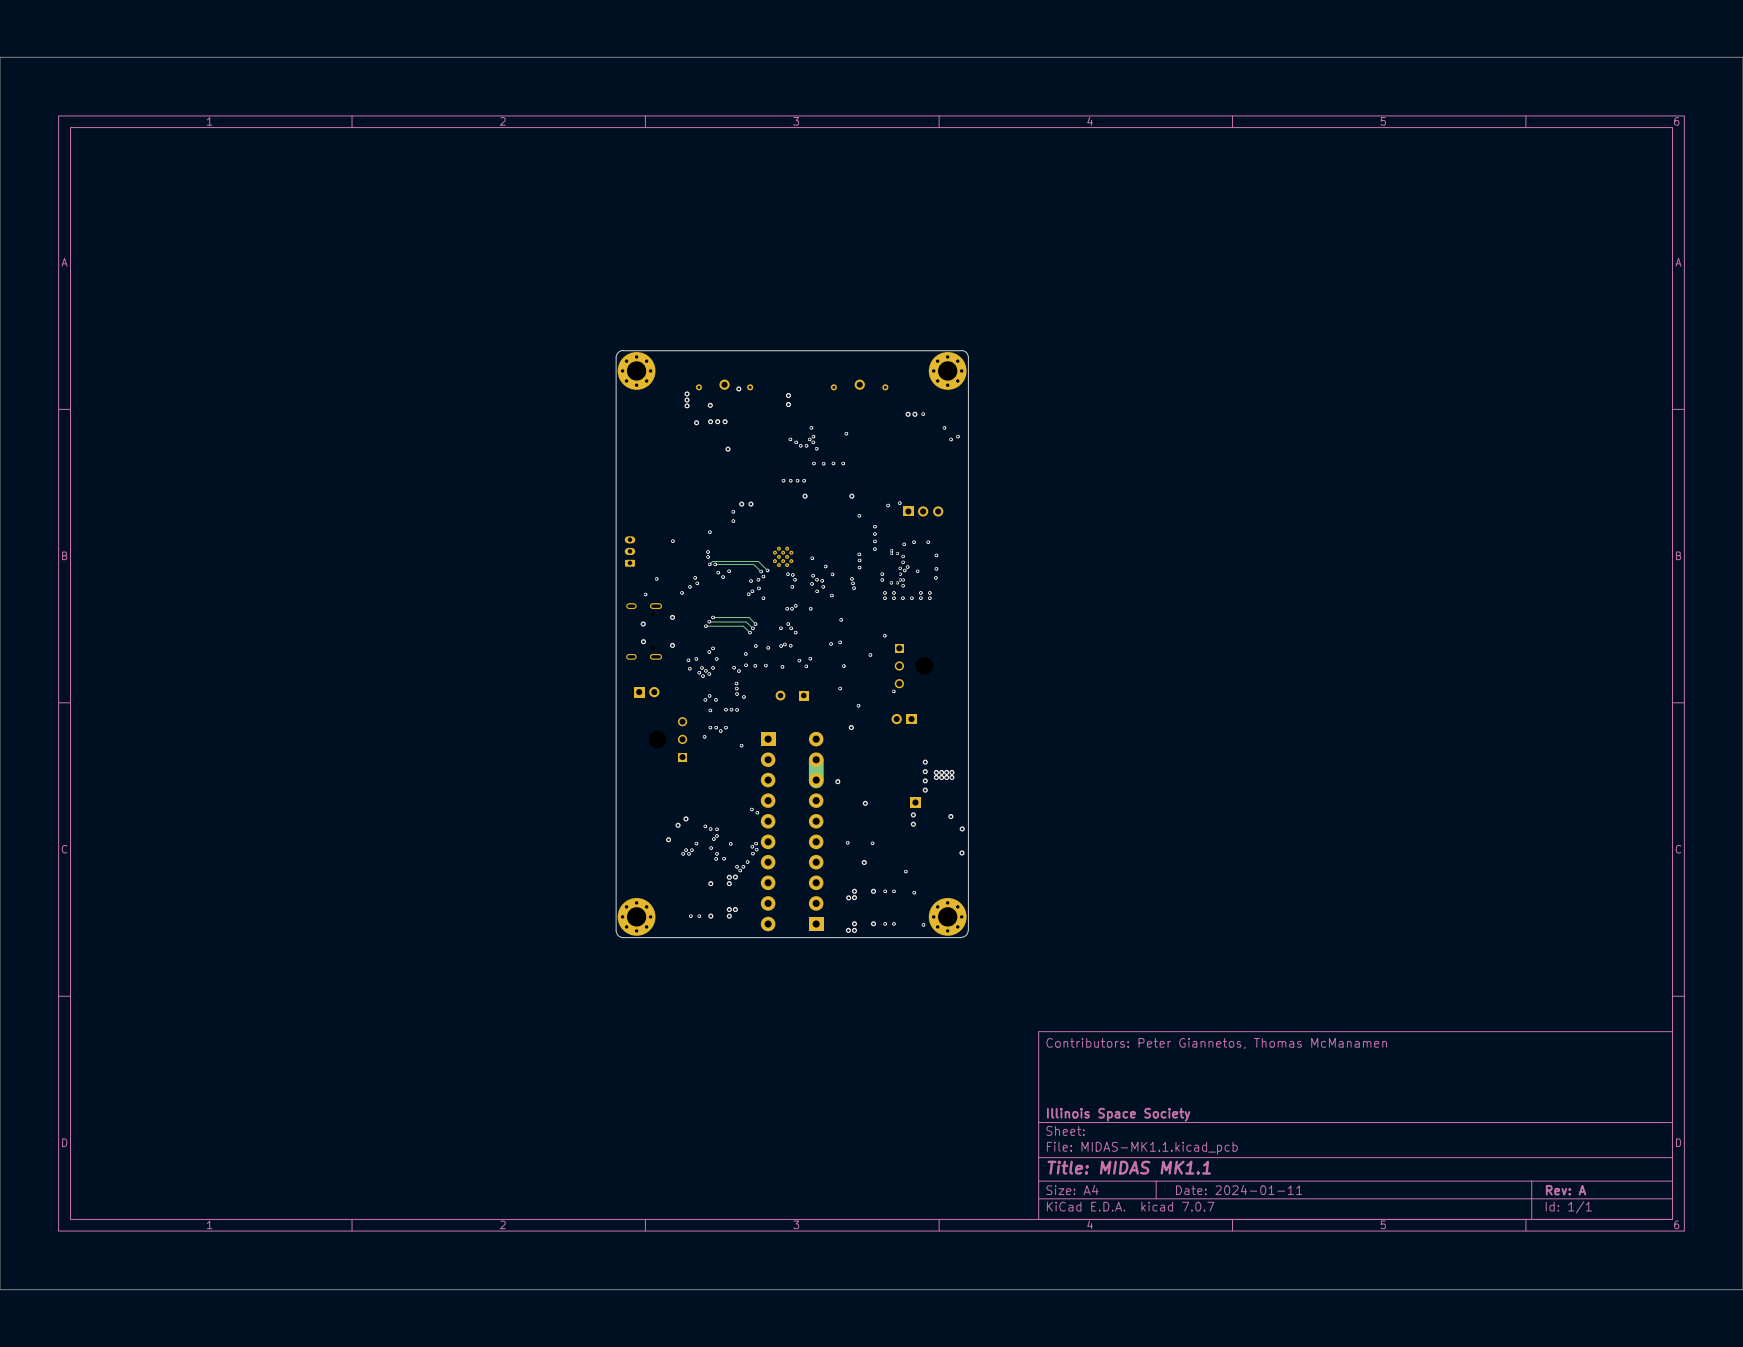
[picture p58: page 2]

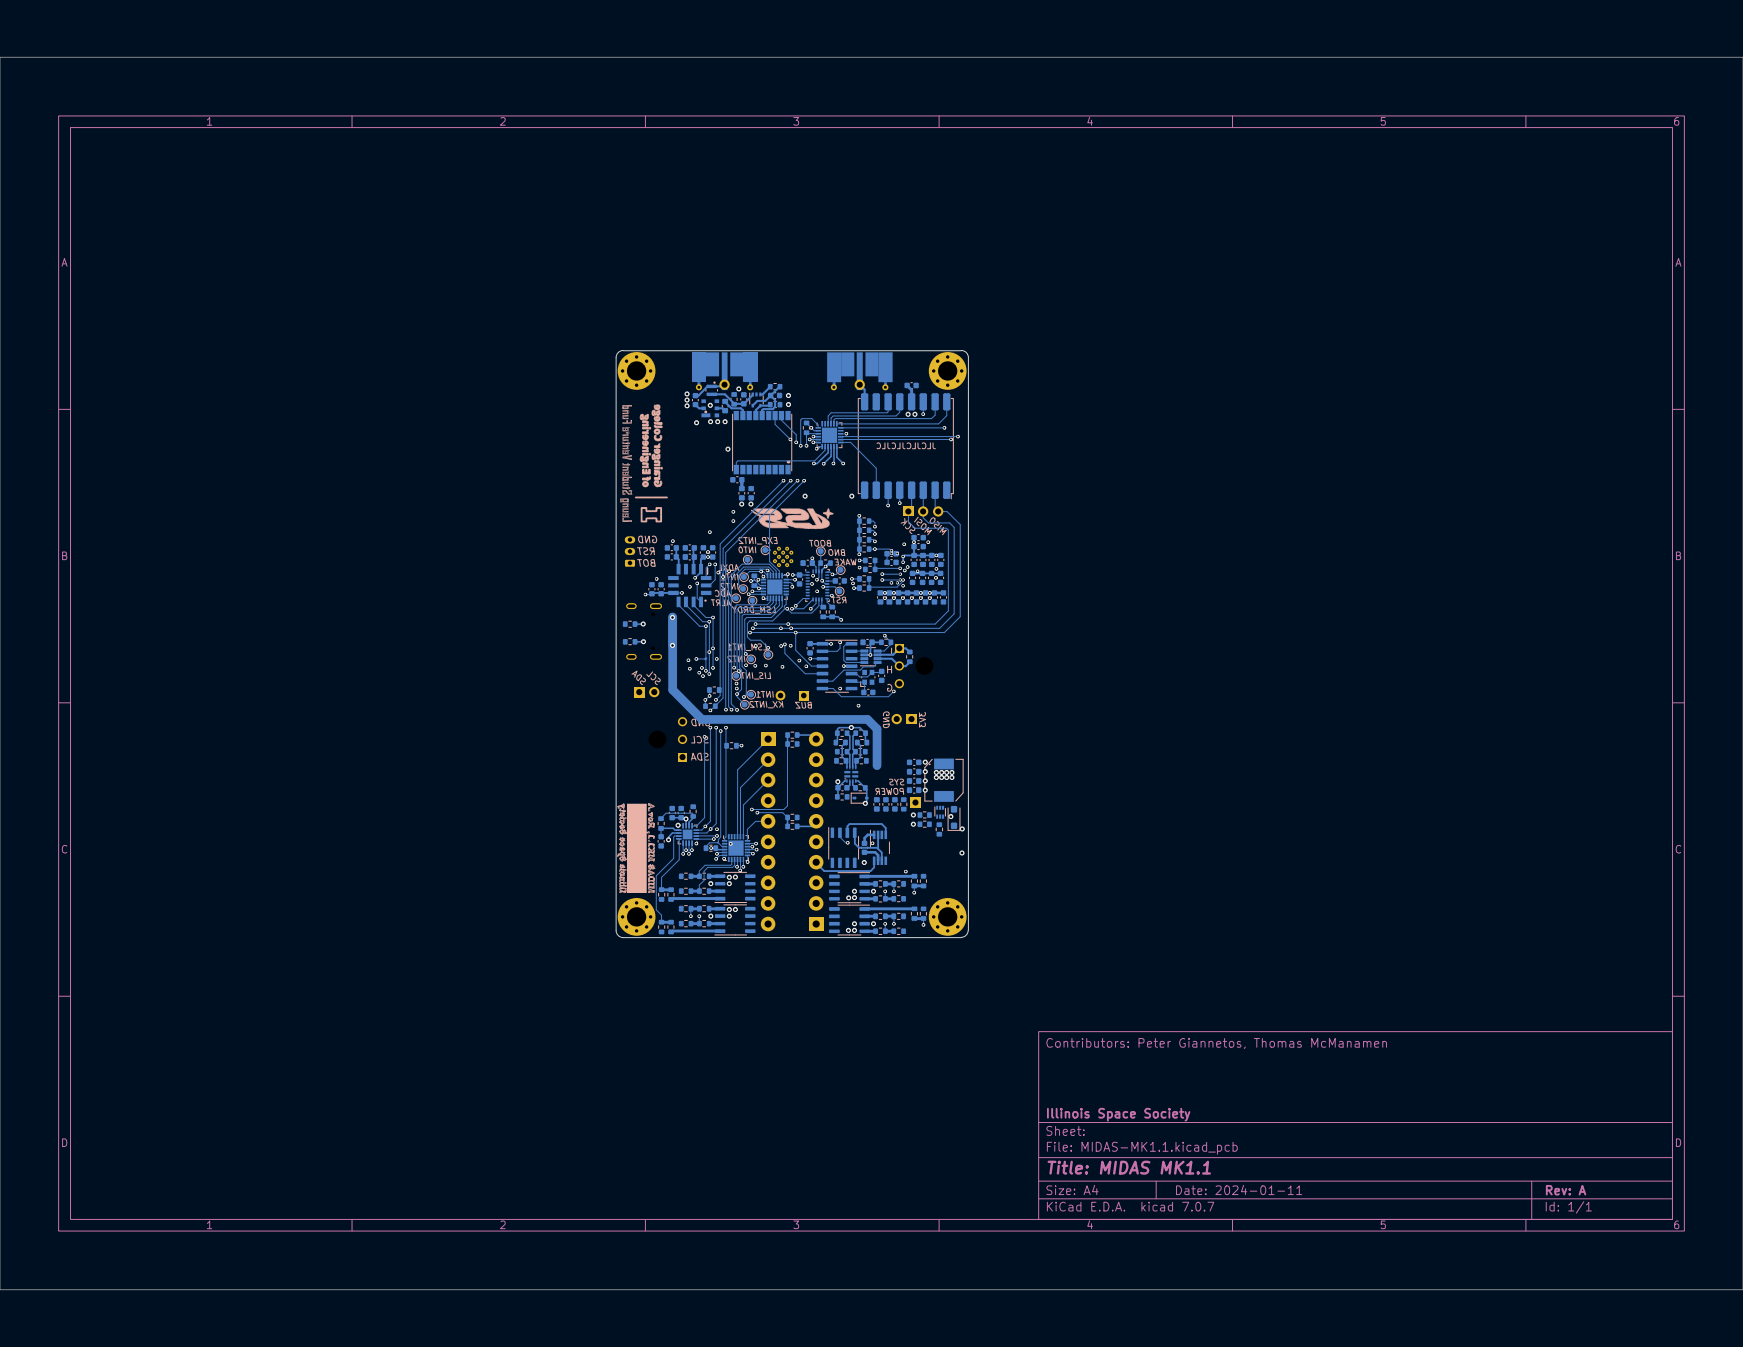
[picture p59: page 3]
