ISSUIUC/ISS-PCB/boards/TeleDecoder/TeleDecoder-revB/TeleDecoder-revB.kicad_pcb

## KiCad design boards/TeleDecoder/TeleDecoder-revB/TeleDecoder-revB.kicad_pcb (2026-10-04)

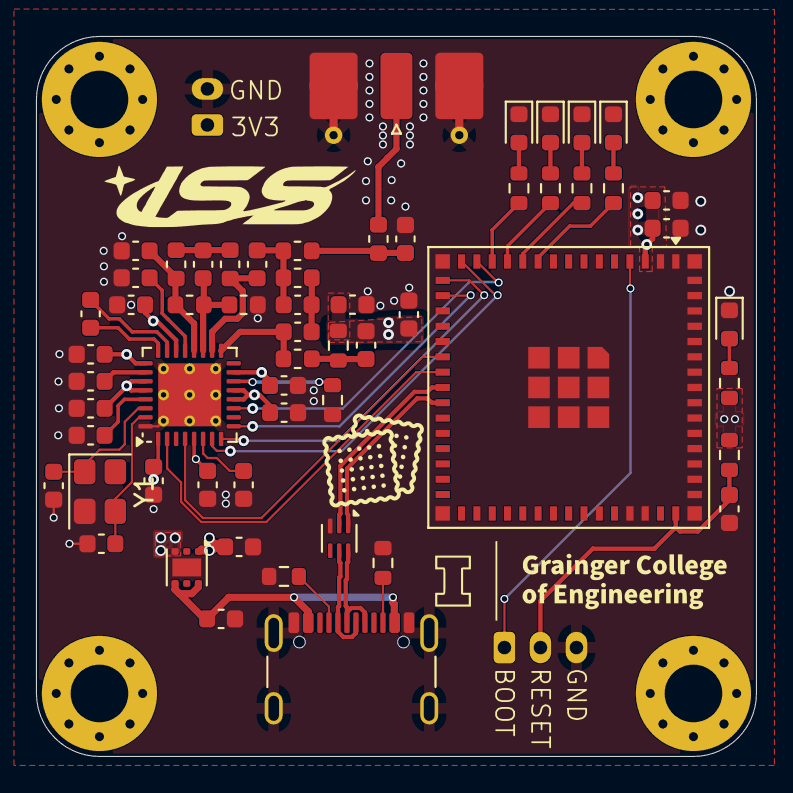
[picture p60: board TeleDecoder-revB.kicad_pcb from above]

Board: 4 copper layers, 40.0 x 40.0 mm, 64 parts (0 on the bottom side), 45 nets.

Parts:
C1, C2, C127: 1uF; C_0603_1608Metric
C101: 22uF; C_0603_1608Metric
C102: 100nF; C_0603_1608Metric
C103, C119: 10nF; C_0603_1608Metric
C104: 56pF; C_0603_1608Metric
C105: 100pF; C_0603_1608Metric
C106: 39pF; C_0603_1608Metric
C107: 2.2pF; C_0603_1608Metric
C108, C109: 10pF; C_0603_1608Metric
C110, C111, C113: 5.1pF; C_0603_1608Metric
C112: 1.8nF; C_0603_1608Metric
C114: 6.2pF; C_0603_1608Metric
C115, C117, C118, C120, C121, C122, C123, C124, C125: 47nF; C_0603_1608Metric
C116: 220nF; C_0603_1608Metric
D101, D105: LED_RED; LED_0603_1608Metric
D102: LED_BLUE; LED_0603_1608Metric
D103: LED_GREEN; LED_0603_1608Metric
D104: LED_ORANGE; LED_0603_1608Metric
H101, H102, H103, H104: MountingHole; MountingHole_3.2mm_M3_Pad_Via
J101: Conn_01x03; JST_PH_B3B-PH-K_1x03_P2.00mm_Vertical
J102: USB4105-GF-A; USB_C_Receptacle_GCT_USB4105-xx-A_16P_TopMnt_Horizontal
J103: Conn_01x02; JST_PH_B2B-PH-K_1x02_P2.00mm_Vertical
J104: Conn_Coaxial; SMA_Molex_73251-2120_EdgeMount_Horizontal
L101, L102: 56nH; L_0603_1608Metric
L103, L106: 15nH; L_0603_1608Metric
L104, L105: 27nH; L_0603_1608Metric
L107: 43nH; L_0603_1608Metric
L108: 22nH; L_0603_1608Metric
R101, R102: 5.1k; R_0603_1608Metric
R103: 18; R_0603_1608Metric
R104: 56k; R_0603_1608Metric
R105, R106, R107, R108, R110: 470; R_0603_1608Metric
R109: 20k; R_0603_1608Metric
U101: ESP32-S3-MINI-1U; ESP32-S2-MINI-1U
U102: ECMF02-2AMX6; ST_UQFN-6L_1.5x1.7mm_P0.5mm
U103: CC1120; VQFN-32-1EP_5x5mm_P0.5mm_EP3.5x3.5mm_ThermalVias
U104: TPS746-Q1; WSON-6-1EP_2x2mm_P0.65mm_EP1x1.6mm
Y1: NDK NX3225SA; Crystal_SMD_3225-4Pin_3.2x2.5mm

Connections:
+3V3: C2.1, C101.1, C102.1, C103.1, C104.2, C105.1, C115.1, C117.1, C118.1, C120.1, C121.1, C123.1, C124.1, J103.1, R103.2, R109.2, R110.1, U101.3 (3V3), U103.1 (VDD_GUARD), U103.5 (DVDD), U103.12 (DVDD), U103.13 (AVDD_IF), U103.15 (AVDD_RF), U103.22 (AVDD_SYNTH1), U103.25 (AVDD_PFD_CHP), U103.27 (AVDD_SYNTH2), U103.28 (AVDD_XOSC), U104.1 (OUT)
+5V: C1.1, J102.A4 (VBUS), J102.A9 (VBUS), J102.B4 (VBUS), J102.B9 (VBUS), U104.4 (EN), U104.6 (IN)
/BOOT: J101.1, U101.4 (IO0)
/CS_RADIO: U101.14 (IO10), U103.11 (~CS)
/D+: J102.A6 (D+), J102.B6 (D+), U102.6 (D+_out)
/D-: J102.A7 (D-), J102.B7 (D-), U102.5 (D-_out)
/LED_BLUE: R106.1, U101.13 (IO9)
/LED_GREEN: R107.1, U101.12 (IO8)
/LED_ORANGE: R108.1, U101.11 (IO7)
/LED_RED: R105.1, U101.10 (IO6)
/LNA_N: C111.1, L102.2, L105.1, U103.20 (LNA_N)
/LNA_P: C110.1, L102.1, L104.1, U103.19 (LNA_P)
/MISO0: U101.17 (IO13), U103.9 (SO(GPIO1))
/MOSI0: U101.15 (IO11), U103.7 (SI)
/PA: C106.1, L101.1, U103.17 (PA)
/RADIO_INT: U101.21 (IO17), U103.4 (GPIO2)
/RESET: C127.1, J101.2, R109.1, U101.45 (EN)
/RESET_IN: U101.22 (IO18), U103.2 (~RESET)
/SCLK0: U101.16 (IO12), U103.8 (SCLK)
/TRX_SW: C113.1, L106.1, U103.18 (TRX_SW)
/USB_D+: U101.24 (USB_D+), U102.1 (D+_in)
/USB_D-: U101.23 (USB_D-), U102.2 (D-_in)
GND: C1.2, C2.2, C101.2, C102.2, C103.2, C105.2, C108.2, C109.2, C111.2, C114.2, C115.2, C116.2, C117.2, C118.2, C119.2, C120.2, C121.2, C122.2, C123.2, C124.2, C125.2, C127.2, D101.1 (K), D102.1 (K), D103.1 (K), D104.1 (K), D105.1 (K), J101.3, J102.A1 (GND), J102.A12 (GND), J102.B1 (GND), J102.B12 (GND), J102.S1 (SHIELD), J103.2, J104.2 (Ext), L104.2, R101.2, R102.2, R104.2, U101.1 (GND), U101.2 (GND), U101.42 (GND), U101.43 (GND), U101.46 (GND), U101.47 (GND), U101.48 (GND), U101.49 (GND), U101.50 (GND), U101.51 (GND), U101.52 (GND), U101.53 (GND), U101.54 (GND), U101.55 (GND), U101.56 (GND), U101.57 (GND), U101.58 (GND), U101.59 (GND), U101.60 (GND), U101.61 (GND), U101.62 (GND), U101.63 (GND), U101.64 (GND), U101.65 (GND), U102.3 (GND), U103.32 (EXT_XOSC), U103.33 (GND_EP), U104.3 (GND), U104.7 (EP), Y1.2
unnamed: C104.1, L101.2, R103.1
unnamed: C106.2, C107.1, L103.1
unnamed: C107.2, C113.2, L103.2, L107.1
unnamed: C110.2, L105.2, L106.2
unnamed: C114.1, L107.2, L108.1
unnamed: D101.2 (A), R105.2
unnamed: D102.2 (A), R106.2
unnamed: D103.2 (A), R107.2
unnamed: D104.2 (A), R108.2
unnamed: D105.2 (A), R110.2
unnamed: J102.A5 (CC1), R101.1
unnamed: J102.B5 (CC2), R102.1
unnamed: J104.1 (In), L108.2
unnamed: C116.1, U103.6 (DCPL)
unnamed: C122.1, U103.26 (DCPL_PFD_CHP)
unnamed: C119.1, U103.21 (DCPL_VCO)
unnamed: C125.1, U103.29 (DCPL_XOSC)
unnamed: C112.1, U103.23 (LPF0)
unnamed: C112.2, U103.24 (LPF1)
unnamed: R104.1, U103.14 (RBIAS)
unnamed: C108.1, U103.30 (XOSC_Q1), Y1.1
unnamed: C109.1, U103.31 (XOSC_Q2), Y1.3
