ISSUIUC/ISS-PCB/boards/CAM-MK3/CAM-MK3-revC/CAM-MK3-revC.kicad_pcb

## KiCad design boards/CAM-MK3/CAM-MK3-revC/CAM-MK3-revC.kicad_pcb (2026-10-04)

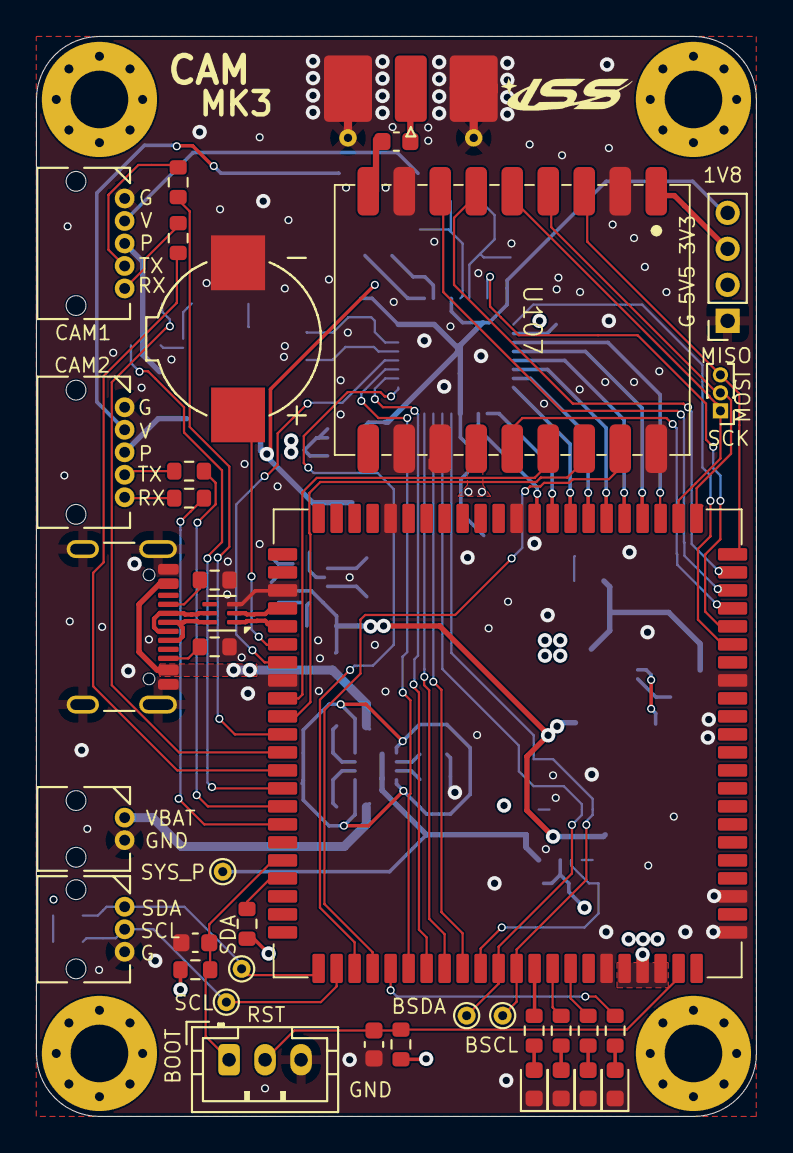
[picture p61: board CAM-MK3-revC.kicad_pcb from above]

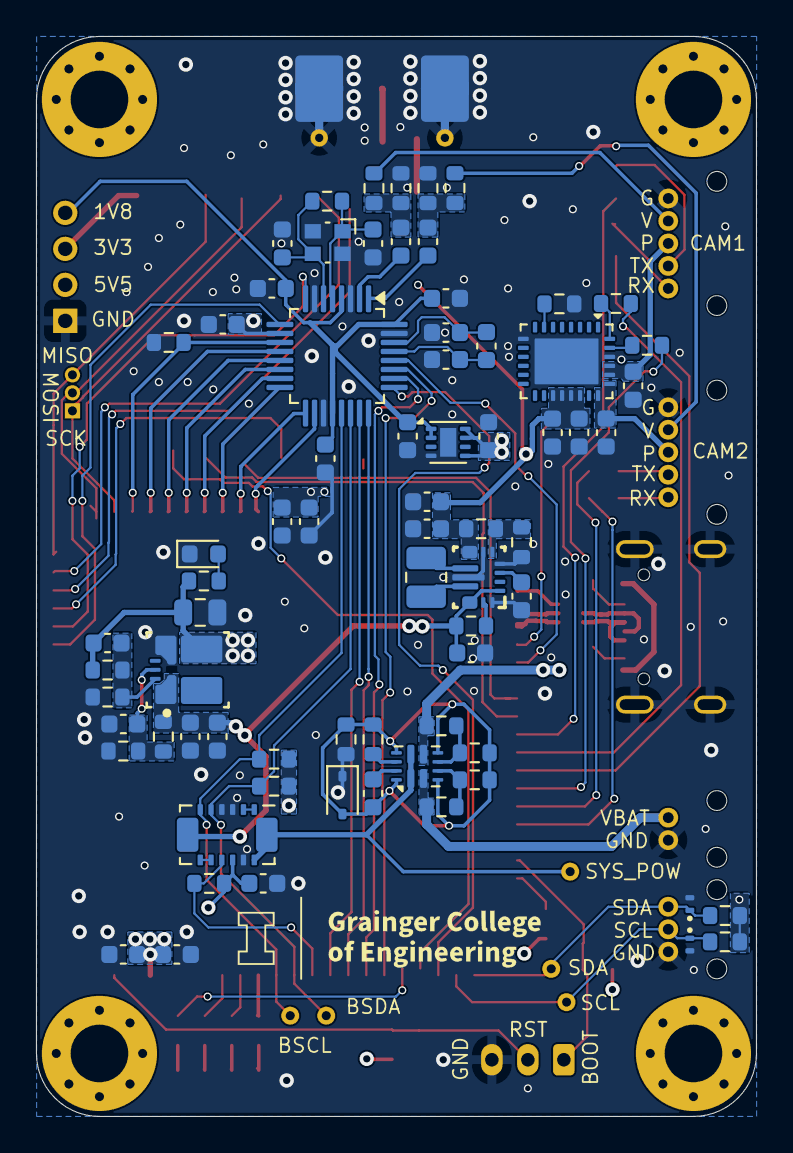
[picture p62: board CAM-MK3-revC.kicad_pcb from below]

Board: 4 copper layers, 40.0 x 60.0 mm, 115 parts (73 on the bottom side), 98 nets.

Parts:
BZ101: Buzzer; Buzzer_SMTB-0927-TW-R
C101, C106, C108, C109, C110, C111, C112, C114, C116, C117, C118, C121, C203, C204: 100nF; C_0603_1608Metric
C102, C103: 19pF; C_0603_1608Metric
C104, C105, C107, C115, C123, C210, C211, C212: 1uF; C_0603_1608Metric
C113: 22uF; C_0603_1608Metric
C119, C120: 22nF; C_0603_1608Metric
C122: 100pF; C_0603_1608Metric
C201, C202, C208: 10uF; C_0603_1608Metric
C205: 10nF; C_0603_1608Metric
C206: 22pF; C_0603_1608Metric
C207: 47uF; C_0603_1608Metric
C209: 33uF; C_0805_2012Metric
D101, D106: ESD321; Texas_DPY0002A_0.6x1mm_P0.65mm
D102, D202: RED LED; LED_0603_1608Metric
D103: ORANGE LED; LED_0603_1608Metric
D104: GREEN LED; LED_0603_1608Metric
D105: BLUE LED; LED_0603_1608Metric
D201: BAS416; D_SOD-323
H101, H102, H103, H104: MountingHole; MountingHole_3.2mm_M3_Pad_Via
J101: USB4105-GF-A; USB_C_Receptacle_GCT_USB4105-xx-A_16P_TopMnt_Horizontal
J102: 2200980271; Molex_Micro-Lock_2200980271_1x02_P1.25mm_Horizontal
J103: Conn_01x03; PinHeader_1x03_P1.00mm_Vertical
J104, J107: Conn_01x05; Molex_Micro-Lock_2200980571_1x05_P1.25mm_Horizontal
J105: Conn_01x03; Molex_Micro-Lock_2200980371_1x03_P1.25mm_Horizontal
J106: SMA; SMA_Molex_73251-2120_EdgeMount_Horizontal
J108: Conn_01x03; JST_PH_B3B-PH-K_1x03_P2.00mm_Vertical
J111: Conn_01x04; PinSocket_1x04_P2.00mm_Vertical
L201: 1.5uH; L_1008_2520Metric
R101, R102, R103, R104: 37.4; R_0603_1608Metric
R105, R210: 100k; R_0603_1608Metric
R106, R107: 10K; R_0603_1608Metric
R108, R109, R110, R120, R201, R203: 10k; R_0603_1608Metric
R111: 680; R_0603_1608Metric
R112, R113, R205, R207: 5.1k; R_0603_1608Metric
R114, R115: 4.7k; R_0603_1608Metric
R116, R117, R118, R119: 220; R_0603_1608Metric
R121, R122, R123, R124, R214: 470; R_0603_1608Metric
R125, R127: 2.2k; R_0603_1608Metric
R126: 20k; R_0603_1608Metric
R202: 22.1k; R_0603_1608Metric
R204: 19.6k; R_0603_1608Metric
R206: 39k; R_0603_1608Metric
R208: 0; R_0603_1608Metric
R209: 590k; R_0603_1608Metric
R211: 135k; R_0603_1608Metric
R212: 30k; R_0603_1608Metric
R213: 21.5k; R_0603_1608Metric
TP101, TP102, TP103, TP104, TP201: TestPoint; TestPoint_THTPad_D1.0mm_Drill0.5mm
U101: ESP32-P4-Module
U102: TVP5151; LQFP-32_5x5mm_P0.5mm
U104: ECMF02-2AMX6; ST_UQFN-6L_1.5x1.7mm_P0.5mm
U105: TPS274160B; WQFN-RLH0028A
U106: INA745x; VQFN-REL0014B
U107: LR2021
U201: TPS63070; VQFN-RNM0015A
U202: TPSM863252; QFN-FCMOD-RDX0007A
U203: TPS2121; Texas_VQFN-HR-12_2x2.5mm_P0.5mm
U204: TPS7A21-Q1; Texas_DSG0008A_WSON-8-1EP_2x2mm_P0.5mm_EP0.9x1.6mm
Y101: ABM10; Crystal_SMD_Abracon_ABM10-4Pin_2.5x2.0mm

Connections:
+1V8: C109.2, C112.2, C114.2, C212.1, J111.4, U102.4 (PLL_AVDD), U102.20 (DVDD), U102.32 (CH_AVDD), U204.1 (OUT), U204.2 (OUT)
+3V3: C108.1, C110.1, C113.1, C115.1, C116.1, C121.1, C206.1, C209.1, C211.1, J111.3, R106.2, R107.2, R114.1, R115.1, R120.1, R125.2, R126.2, R127.1, R211.1, R214.1, U101.84 (ESP_VBAT), U101.85 (ESP_3V3), U101.86 (ESP_3V3), U102.10 (IO_DVDD), U106.11 (VS), U107.1 (VCC), U202.3 (VOUT), U204.5 (EN), U204.7 (IN), U204.8 (IN)
+5V5: C117.1, C118.1, C207.1, C208.1, J111.2, R209.1, U105.17 (VS), U105.18 (VS), U105.19 (VS), U105.20 (VS), U201.7 (VOUT), U201.8 (VOUT)
/AVID: U101.73 (GPIO45), U102.26 (AVID/CLK_IN)
/BOARD_SCL: R115.2, TP103.1, U101.78 (GPIO50), U102.21 (SCL), U106.6 (SCL)
/BOARD_SDA: R114.2, TP104.1, U101.77 (GPIO49), U102.22 (SDA), U106.5 (SDA)
/BOOT_SW: C111.1, J108.1, R107.1, U101.62 (GPIO35)
/BUZZER: BZ101.1 (-), U101.50 (GPIO24)
/CAM_1_POW: C120.1, J104.3, U105.24 (OUT1), U105.25 (OUT1)
/CAM_2_POW: C119.1, J107.3, U105.22 (OUT2), U105.23 (OUT2)
/D+: J101.A6 (D+), J101.B6 (D+), U104.6 (D+_out)
/D-: J101.A7 (D-), J101.B7 (D-), U104.5 (D-_out)
/FID/GLCO: U101.75 (GPIO47), U102.23 (FID/GLCO)
/GPCL/VBLK: U101.72 (GPIO44), U102.27 (INTREQ/GPCL/VBLK)
/HSYNC: U101.69 (GPIO41), U102.25 (HSYNC)
/LED_BLUE: R124.1, U101.71 (GPIO43)
/LED_GREEN: R123.1, U101.81 (GPIO53)
/LED_ORANGE: R122.1, U101.80 (GPIO52)
/LED_RED: R121.1, U101.79 (GPIO51)
/LR2021_ANT: C122.2, U107.9 (ANT)
/LR2021_BUSY: U101.20 (GPIO5), U107.7 (BUSY)
/LR2021_CS: U101.21 (GPIO6), U107.6 (~CS)
/LR2021_GPIO7: U101.70 (GPIO42), U107.17 (DIO7)
/LR2021_GPIO8: U101.54 (GPIO27), U107.16 (DIO8)
/LR2021_GPIO9: U101.53 (GPIO26), U107.15 (DIO9)
/LR2021_nRST: U101.19 (GPIO4), U107.14 (nRST)
/ON_OFF_1: R109.1, U101.58 (GPIO31)
/ON_OFF_2: R110.1, U101.56 (GPIO29)
/PDN: U101.51 (GPIO25), U102.28 (PDN)
/Power/PMUX_GND: C210.1, D201.2 (A), R205.2, R207.2, R208.1, R213.1, U203.3 (CP2), U203.6 (PR1), U203.9 (ST), U203.12 (GND)
/RESET_SW: C123.1, J108.2, R126.1, U101.87 (CHIP_PU)
/RESET_VD: U101.18 (GPIO3), U102.8 (RESETB)
/RX_1: R116.2, U101.57 (GPIO30)
/RX_2: R118.2, U101.60 (GPIO33)
/SCL: D106.1 (K), J105.2, R127.2, TP101.1, U101.68 (GPIO40)
/SCLK: U101.17 (GPIO2), U102.9 (SCLK)
/SDA: D101.1 (K), J105.1, R125.1, TP102.1, U101.67 (GPIO39)
/SENSE_ALERT: R120.2, U101.76 (GPIO48), U106.10 (ALERT)
/SPI_MISO: J103.3, U101.22 (GPIO7), U107.3 (MISO)
/SPI_MOSI: J103.2, U101.23 (GPIO8), U107.4 (MOSI)
/SPI_SCK: J103.1, U101.24 (GPIO9), U107.5 (SCK)
/SYS_POWER: TP201.1, U106.13 (VBUS), U106.14 (IS+), U203.1 (OUT), U203.8 (OUT)
/TX_1: R117.2, U101.55 (GPIO28)
/TX_2: R119.2, U101.59 (GPIO32)
/USB_D+: U101.49 (DP), U104.1 (D+_in)
/USB_D-: U101.48 (DM), U104.2 (D-_in)
/USB_POWER: J101.A4 (VBUS), J101.A9 (VBUS), J101.B4 (VBUS), J101.B9 (VBUS), R204.1, U203.7 (IN1)
/VBAT: J102.1, R206.1, U203.2 (IN2)
/VIDEO_1: J104.2, R102.1
/VIDEO_2: J107.2, R104.1
/VREG_IN: C201.1, C202.1, C203.1, R201.1, R202.1, U106.7 (IS-), U201.1 (PS_SYNC), U201.12 (VIN), U201.13 (VIN), U202.1 (VIN)
/VSYNC: U101.74 (GPIO46), U102.24 (VSYNC/PALI)
/YOUT0: U101.32 (GPIO23), U102.18 (YOUT0)
/YOUT1: U101.31 (GPIO22), U102.17 (YOUT1)
/YOUT2: U101.30 (GPIO21), U102.16 (YOUT2)
/YOUT3: U101.29 (GPIO20), U102.15 (YOUT3)
/YOUT4: U101.28 (GPIO13), U102.14 (YOUT4)
/YOUT5: U101.27 (GPIO12), U102.13 (YOUT5)
/YOUT6: U101.26 (GPIO11), U102.12 (YOUT6)
/YOUT7: R108.2, U101.25 (GPIO10), U102.11 (YOUT7/I2CSEL)
GND: BZ101.2 (+), C102.1, C103.1, C104.1, C105.1, C108.2, C109.1, C110.2, C111.2, C112.1, C113.2, C114.1, C115.2, C116.2, C117.2, C118.2, C119.2, C120.2, C121.2, C123.2, C201.2, C202.2, C203.2, C204.2, C205.2, C207.2, C208.2, C209.2, C211.2, C212.2, D101.2 (A), D102.1 (K), D103.1 (K), D104.1 (K), D105.1 (K), D106.2 (A), D201.1 (K), D202.1 (K), J101.A1 (GND), J101.A12 (GND), J101.B1 (GND), J101.B12 (GND), J101.S1 (SHIELD), J102.2, J104.1, J105.3, J106.2 (Ext), J107.1, J108.3, J111.1, R101.1, R103.1, R108.1, R111.2, R112.1, R113.1, R203.2, R208.2, R210.2, R212.2, U101.1 (GND), U101.3 (GND), U101.15 (GND), U101.33 (GND), U101.40 (GND), U101.47 (GND), U101.52 (GND), U101.83 (GND), U102.3 (PLL_AGND), U102.7 (AGND), U102.19 (DGND), U102.31 (CH_AGND), U104.3 (GND), U105.9 (GND), U105.26 (GND), U105.29 (PowerPAD), U106.3 (A1), U106.4 (A0), U106.12 (GND), U107.2 (GND), U107.8 (GND), U107.11 (GND), U107.12 (GND), U107.18 (GND), U201.4 (GND), U201.6 (FB2), U201.10 (PGND), U201.15 (VSEL), U202.4 (PGND), U204.4 (GND), U204.9 (EPAD), Y101.2, Y101.4
unnamed: C101.1, R101.2, R102.2
unnamed: C106.1, R103.2, R104.2
unnamed: D102.2 (A), R121.2
unnamed: D103.2 (A), R122.2
unnamed: D104.2 (A), R123.2
unnamed: D105.2 (A), R124.2
unnamed: D202.2 (A), R214.2
unnamed: J101.A5 (CC1), R112.2
unnamed: J101.B5 (CC2), R113.2
unnamed: J104.4, R117.1
unnamed: J104.5, R116.1
unnamed: C122.1, J106.1 (In)
unnamed: J107.4, R119.1
unnamed: J107.5, R118.1
unnamed: R106.1, U101.63 (GPIO36)
unnamed: C106.2, U102.1 (AIP1A)
unnamed: C101.2, U102.2 (AIP1B)
unnamed: C105.2, C107.2, U102.30 (REFM)
unnamed: C104.2, C107.1, U102.29 (REFP)
unnamed: C103.2, R105.1, U102.5 (XTAL1/OSC), Y101.1
unnamed: C102.2, R105.2, U102.6 (XTAL2), Y101.3
unnamed: R111.1, U105.7 (CL)
unnamed: R109.2, U105.27 (EN1)
unnamed: R110.2, U105.28 (EN2)
unnamed: U106.1 (SH+), U106.2 (IN+)
unnamed: U106.8 (SH-), U106.9 (IN-)
unnamed: R201.2, U201.14 (EN)
unnamed: R209.2, R210.1, U201.5 (FB)
unnamed: L201.1, U201.11 (L1)
unnamed: L201.2, U201.9 (L2)
unnamed: C204.1, U201.3 (VAUX)
unnamed: C205.1, R202.2, R203.1, U202.6 (EN)
unnamed: C206.2, R211.2, R212.1, U202.7 (FB)
unnamed: R213.2, U203.10 (ILM)
unnamed: R204.2, R205.1, U203.5 (OV1)
unnamed: R206.2, R207.1, U203.4 (OV2)
unnamed: C210.2, U203.11 (SS)
