ISSUIUC/ISS-PCB/boards/Motor-MK2 (GATOR)/GATOR.kicad_pcb

## KiCad design boards/Motor-MK2 (GATOR)/GATOR.kicad_pcb (2026-10-04)

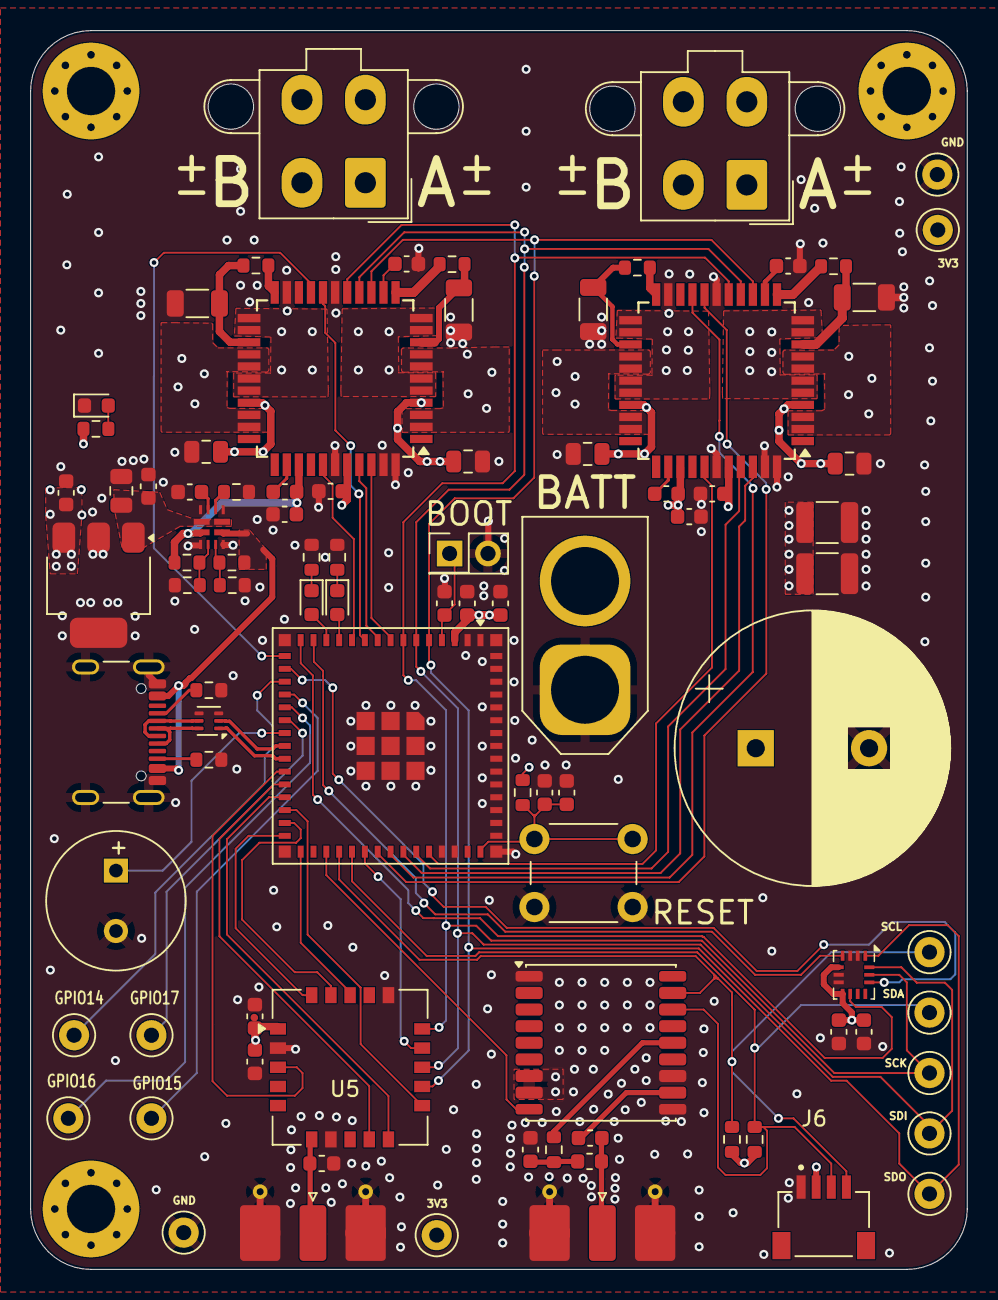
[picture p63: board GATOR.kicad_pcb from above]

Board: 4 copper layers, 62.0 x 82.0 mm, 92 parts (0 on the bottom side), 79 nets.

Parts:
BZ1: AT-0927-TT-6-R; Buzzer_AT-0927-TT-6-R
C1, C3, C8, C10, C14, C16, C18, C25: 100nF; C_0603_1608Metric
C2, C12: 220nF; C_0603_1608Metric
C4, C5, C17, C19, C26: 10uF; C_0805_2012Metric
C6, C27: 22uF; C_0603_1608Metric
C7, C20: 470nF; C_0603_1608Metric
C9: 1200uF; CP_Radial_D18.0mm_P7.50mm
C11, C23: 1uF; C_0603_1608Metric
C13, C15: 100uF; C_1210_3225Metric
C21: 10uF; C_0603_1608Metric
C22, C402: 10nF; C_0603_1608Metric
C102, C103: 0.1uF; C_0603_1608Metric
C403: 47pF; C_0603_1608Metric
D1, D2: LED; LED_0603_1608Metric
D3: RED LED; LED_0603_1608Metric
H1, H2, H3: MountingHole; MountingHole_3.2mm_M3_Pad_Via
J1: USB_C_Receptacle_USB2.0_16P; USB_C_Receptacle_GCT_USB4105-xx-A_16P_TopMnt_Horizontal
J2, J4: Conn_01x04; Molex_Mini-Fit_Jr_5566-04A2_2x02_P4.20mm_Vertical
J3: XT60; AMASS_XT60-M_1x02_P7.20mm_Vertical
J5, J401: SMA; SMA_Molex_73251-2120_EdgeMount_Horizontal
J6: PRT-14417; Qwiic_4_pin_horizontal
L1: 330nH; L_0603_1608Metric
L401: 27nH; L_0603_1608Metric
R1, R2: 5.1k; R_0603_1608Metric
R3, R4, R8, R9, R401: 10; R_0603_1608Metric
R5, R6, R10, R11: 0.075; R_1206_3216Metric
R7: 100k; R_0603_1608Metric
R12: 23.7k; R_0603_1608Metric
R13: 5k; R_0603_1608Metric
R14: 30k; R_0603_1608Metric
R15: 1k; R_0603_1608Metric
R16, R17, R21: 470; R_0603_1608Metric
R18: 20k; R_0603_1608Metric
R19, R20: 4.7k; R_0603_1608Metric
SW1: SW_Push; PinHeader_2x01_P2.54mm_Vertical
SW2: SW_Push; SW_PUSH_6mm
TP3V3-1, TP3V3-2: 3V3; TestPoint_Keystone_5000-5004_Miniature
TP-GND-1, TP-GND-2: GND; TestPoint_Keystone_5000-5004_Miniature
TP-IO14-1: GPIO14; TestPoint_Keystone_5000-5004_Miniature
TP-IO15-2: GPIO15; TestPoint_Keystone_5000-5004_Miniature
TP-IO16-3: GPIO16; TestPoint_Keystone_5000-5004_Miniature
TP-IO17-4: GPIO17; TestPoint_Keystone_5000-5004_Miniature
TPSCK1: SCK; TestPoint_Keystone_5000-5004_Miniature
TPSCL1: I2C_SCL; TestPoint_Keystone_5000-5004_Miniature
TPSDA1: I2C_SDA; TestPoint_Keystone_5000-5004_Miniature
TPSDI1: SDI; TestPoint_Keystone_5000-5004_Miniature
TPSDO1: SDO; TestPoint_Keystone_5000-5004_Miniature
U1, U4: TMC2660C; TQFP-44_10x10mm_P0.8mm
U2: ESP32-S3-MINI-1U; ESP32-S2-MINI-1U
U3: ECMF02-2AMX6; ST_UQFN-6L_1.5x1.7mm_P0.5mm
U5: E22-400MM22S
U6: TPS2121; VQFN-HR-RUX0012A
U8: TLE42744; SOT-223
U102: LSM6DSLTR; Bosch_LGA-14_3x2.5mm_P0.5mm
U403: MAX-M10S; ublox_MAX

Connections:
+3V3: C1.2, C6.2, C8.2, C10.2, C21.1, C22.1, C27.1, C102.1, C103.1, J6.2, R7.1, R19.2, R20.2, R21.1, TP3V3-1.1, TP3V3-2.1, U1.40 (VCC_IO), U2.3 (3V3), U4.40 (VCC_IO), U5.1 (VCC), U8.3 (Q), U102.5 (VDDIO), U102.8 (VDD), U403.7 (VCC_IO), U403.8 (VCC)
/BUZZER: BZ1.1 (-), U2.22 (IO18)
/D+: J1.A6 (D+), J1.B6 (D+), U3.6 (D+_out)
/D-: J1.A7 (D-), J1.B7 (D-), U3.5 (D-_out)
/DIR_0: U1.41 (DIR), U2.9 (IO5)
/DIR_1: U2.40 (RXD0), U4.41 (DIR)
/E22_BUSY: U2.28 (IO33), U5.11 (BUSY)
/E22_DI01: U2.30 (IO48), U5.20 (DIO1)
/E22_DI02: U2.29 (IO34), U5.19 (DIO2)
/E22_DI03: U2.31 (IO35), U5.18 (DIO3)
/E22_RESET: U2.25 (IO21), U5.3 (NRST)
/GPIO14: TP-IO14-1.1, U2.18 (IO14)
/GPIO15: TP-IO15-2.1, U2.19 (IO15)
/GPIO16: TP-IO16-3.1, U2.20 (IO16)
/GPIO17: TP-IO17-4.1, U2.21 (IO17)
/I2C_SCL: J6.4, R19.1, TPSCL1.1, U2.34 (IO38), U403.17 (SCL)
/I2C_SDA: J6.3, R20.1, TPSDA1.1, U2.35 (IO39), U403.16 (SDA)
/LED_1: D1.2 (A), U2.12 (IO8)
/LED_2: D2.2 (A), U2.13 (IO9)
/LORA_CS: U2.36 (IO40), U5.14 (NSS)
/LSM6DSLTR_INT1: U2.14 (IO10), U102.4 (INT1)
/LSM6DSLTR_INT2: U2.15 (IO11), U102.9 (INT2)
/LSM6DSL_CS: U2.17 (IO13), U102.12 (CS)
/MAX_RESET: U2.33 (IO37), U403.9 (~RESET)
/RXEN: U2.27 (IO47), U5.10 (RXEN)
/SCK: TPSCK1.1, U1.16 (SCK), U2.7 (IO3), U4.16 (SCK), U5.15 (SCK), U102.13 (SCL)
/SDI: TPSDI1.1, U1.15 (SDI), U2.6 (IO2), U4.15 (SDI), U5.13 (MOSI), U102.14 (SDA)
/SDO: TPSDO1.1, U1.14 (SDO), U2.5 (IO1), U4.14 (SDO), U5.12 (MISO), U102.1 (SDO/SA0)
/SG_TST_0: U1.38 (SG_TST), U2.11 (IO7)
/SG_TST_1: U2.41 (IO45), U4.38 (SG_TST)
/STEP_0: U1.42 (STEP), U2.8 (IO4)
/STEP_1: U2.39 (TXD0), U4.42 (STEP)
/SYS_Power: C25.1, C26.1, U6.1 (OUT), U6.8 (OUT), U8.1 (I)
/TXEN: U2.26 (IO26), U5.9 (TXEN)
/USB_POWER: J1.A4 (VBUS), J1.A9 (VBUS), J1.B4 (VBUS), J1.B9 (VBUS), R12.1, U6.7 (IN1)
/VBAT: C2.1, C3.1, C4.1, C5.1, C9.1, C12.1, C13.1, C14.1, C15.1, C17.1, C19.1, J3.2, R14.1, U1.4 (VSA), U1.30 (VSB), U1.36 (VS), U4.4 (VSA), U4.30 (VSB), U4.36 (VS), U6.2 (IN2)
/~CS_0: U1.18 (~CS), U2.10 (IO6)
/~CS_1: U2.37 (IO41), U4.18 (~CS)
/~EN_0: U1.19 (~EN), U2.16 (IO12)
/~EN_1: U2.38 (IO42), U4.19 (~EN)
BOOT_SW: C16.1, SW1.1, U2.4 (IO0)
GND: BZ1.2 (+), C1.1, C3.2, C4.2, C5.2, C6.1, C7.2, C8.1, C9.2, C10.1, C11.2, C13.2, C14.2, C15.2, C16.2, C17.2, C18.2, C19.2, C20.2, C21.2, C22.2, C23.2, C25.2, C26.2, C27.2, C102.2, C103.2, C402.2, D3.1 (K), J1.A1 (GND), J1.A12 (GND), J1.B1 (GND), J1.B12 (GND), J1.S1 (SHIELD), J3.1, J5.2 (Ext), J6.1, J401.2 (Ext), L1.2, R1.2, R2.2, R5.2, R6.2, R10.2, R11.2, R13.2, R15.2, R16.2, R17.2, R18.2, SW1.2, SW2.2, TP-GND-1.1, TP-GND-2.1, U1.17 (GND), U1.21 (CLK), U1.39 (GND), U1.43 (TST_MODE), U1.44 (GND), U2.1 (GND), U2.2 (GND), U2.42 (GND), U2.43 (GND), U2.46 (GND), U2.47 (GND), U2.48 (GND), U2.49 (GND), U2.50 (GND), U2.51 (GND), U2.52 (GND), U2.53 (GND), U2.54 (GND), U2.55 (GND), U2.56 (GND), U2.57 (GND), U2.58 (GND), U2.59 (GND), U2.60 (GND), U2.61 (GND), U2.62 (GND), U2.63 (GND), U2.64 (GND), U2.65 (GND), U3.3 (GND), U3.4 (NC), U4.17 (GND), U4.21 (CLK), U4.39 (GND), U4.43 (TST_MODE), U4.44 (GND), U5.2 (GND), U5.7 (GND), U5.16 (GND), U6.3 (CP2), U6.6 (PR1), U6.9 (ST), U6.12 (GND), U8.2 (GND), U8.4 (GND), U102.2 (SDx), U102.3 (SCx), U102.6 (GND), U102.7 (GND), U403.1 (GND), U403.10 (GND), U403.12 (GND)
unnamed: C402.1, L401.2, R401.2
unnamed: D1.1 (K), R16.1
unnamed: D2.1 (K), R17.1
unnamed: D3.2 (A), R21.2
unnamed: J1.A5 (CC1), R1.1
unnamed: J1.B5 (CC2), R2.1
unnamed: J2.1, U1.5 (OA2), U1.6 (OA2), U1.10 (OA2), U1.11 (OA2)
unnamed: J2.2, U1.23 (OB2), U1.24 (OB2), U1.28 (OB2), U1.29 (OB2)
unnamed: J2.3, U1.2 (OA1), U1.3 (OA1), U1.7 (OA1), U1.8 (OA1)
unnamed: J2.4, U1.26 (OB1), U1.27 (OB1), U1.31 (OB1), U1.32 (OB1)
unnamed: J4.1, U4.5 (OA2), U4.6 (OA2), U4.10 (OA2), U4.11 (OA2)
unnamed: J4.2, U4.23 (OB2), U4.24 (OB2), U4.28 (OB2), U4.29 (OB2)
unnamed: J4.3, U4.2 (OA1), U4.3 (OA1), U4.7 (OA1), U4.8 (OA1)
unnamed: J4.4, U4.26 (OB1), U4.27 (OB1), U4.31 (OB1), U4.32 (OB1)
unnamed: J5.1 (In), L1.1, U5.6 (ANT)
unnamed: C403.1, J401.1 (In), L401.1
unnamed: C7.1, U1.13 (5VOUT)
unnamed: R3.2, R5.1, U1.9 (BRA)
unnamed: R4.2, R6.1, U1.25 (BRB)
unnamed: R3.1, U1.12 (SRA)
unnamed: R4.1, U1.22 (SRB)
unnamed: C2.2, U1.35 (VHS)
unnamed: C20.1, U4.13 (5VOUT)
unnamed: R8.2, R10.1, U4.9 (BRA)
unnamed: R9.2, R11.1, U4.25 (BRB)
unnamed: R8.1, U4.12 (SRA)
unnamed: R9.1, U4.22 (SRB)
unnamed: C12.2, U4.35 (VHS)
unnamed: R18.1, U6.10 (ILM)
unnamed: R12.2, R13.1, U6.5 (OV1)
unnamed: R14.2, R15.1, U6.4 (OV2)
unnamed: C23.1, U6.11 (SS)
unnamed: C403.2, U403.11 (RF_IN)
unnamed: R401.1, U403.14 (VCC_RF)
RESET_SW: C11.1, C18.1, R7.2, SW2.1, U2.45 (EN)
USB+: U2.24 (IO20), U3.1 (D+_in)
USB-: U2.23 (IO19), U3.2 (D-_in)
