ISSUIUC/ISS-PCB/boards/EAGLE-MK1/EAGLE-MK1-revB/EAGLE-MK1-revB.kicad_pcb

## KiCad design boards/EAGLE-MK1/EAGLE-MK1-revB/EAGLE-MK1-revB.kicad_pcb (2026-10-04)

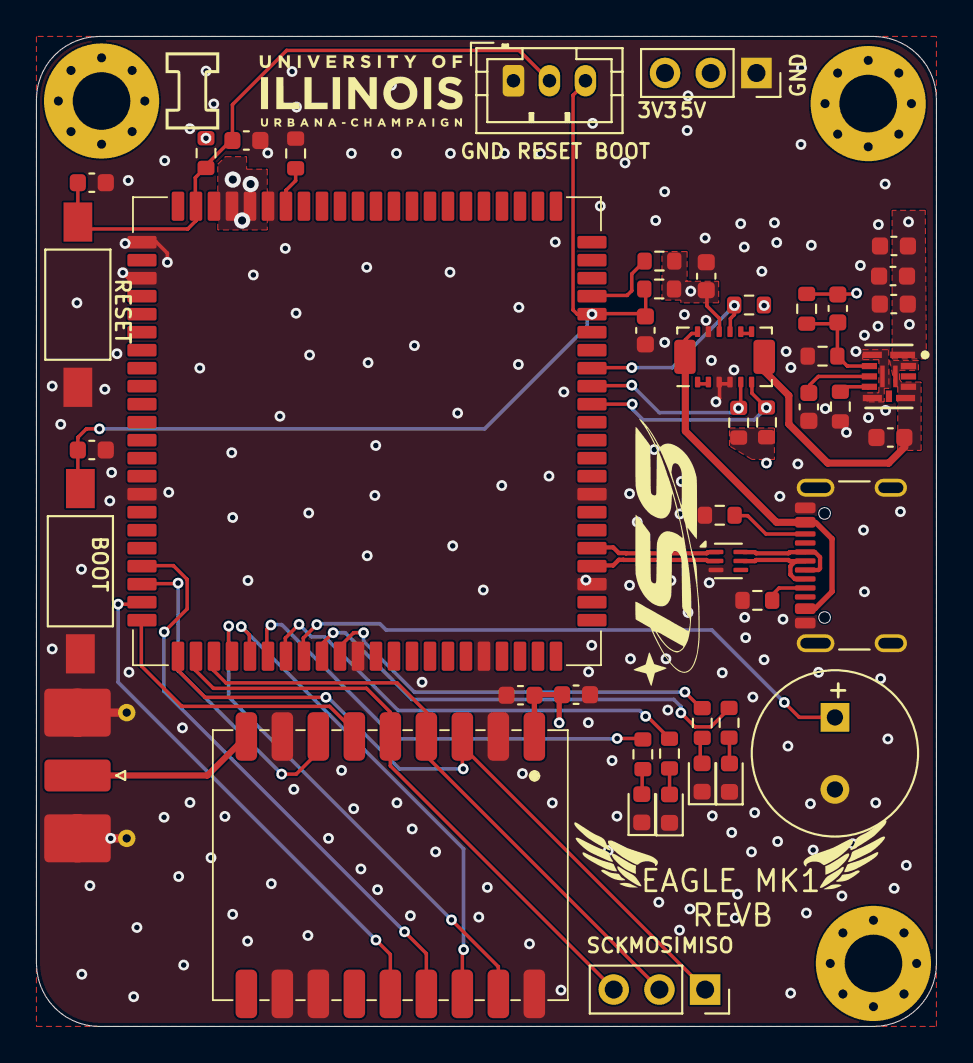
[picture p64: board EAGLE-MK1-revB.kicad_pcb from above]

Board: 4 copper layers, 50.0 x 55.0 mm, 49 parts (0 on the bottom side), 41 nets.

Parts:
BZ1: Buzzer; MagneticBuzzer_PUI_AT-0927-TT-6-R
C1, C2, C3, C11, C13: 100nF; C_0603_1608Metric
C4, C8, C9, C10: 22uF; C_0603_1608Metric
C5, C12: 1uF; C_0603_1608Metric
C6: 4.7nF; C_0603_1608Metric
C7: 10pF; C_0603_1608Metric
D1: RED LED; LED_0603_1608Metric
D2: ORANGE LED; LED_0603_1608Metric
D3: GREEN LED; LED_0603_1608Metric
D4: BLUE LED; LED_0603_1608Metric
H1, H2, H3: MountingHole; MountingHole_3.2mm_M3_Pad_Via
J1: USB4105-GF-A; USB_C_Receptacle_GCT_USB4105-xx-A_16P_TopMnt_Horizontal
J2, J5: Conn_01x03; PinSocket_1x03_P2.54mm_Vertical
J3: Conn_01x03; JST_PH_B3B-PH-K_1x03_P2.00mm_Vertical
J4: SMA; SMA_Molex_73251-2120_EdgeMount_Horizontal
R1, R2: 5.1k; R_0603_1608Metric
R3: 0; R_0603_1608Metric
R4, R5: 4.7k; R_0603_1608Metric
R6, R7, R9, R16: 10k; R_0603_1608Metric
R8: 20k; R_0603_1608Metric
R10, R11, R12, R13: 470; R_0603_1608Metric
R14: 453k; R_0603_1608Metric
R15: 100k; R_0603_1608Metric
SW1, SW2: SW_Push; SW_SPST_FSMSM
U1: ECMF02-2AMX6; ST_UQFN-6L_1.5x1.7mm_P0.5mm
U2: ESP32-P4; ESP32-P4-Module
U3: TPSM82813; QFN-FCMOD-VCA0013A
U4: INA745x; VQFN-REL0014B
U5: LR2021

Connections:
+3V3: C7.2, C8.2, C9.2, C10.2, C11.1, C12.1, C13.1, J2.3, R4.1, R5.1, R6.2, R7.2, R8.2, R14.2, R16.1, U2.84 (ESP_VBAT), U2.85 (ESP_3V3), U2.86 (ESP_3V3), U3.1 (VOUT), U4.11 (VS), U5.1 (VCC)
/BOOT_SW: C2.1, C3.1, J3.3, R7.1, SW2.1, U2.62 (GPIO35)
/BUZZER: BZ1.1 (-), U2.30 (GPIO21)
/D+: J1.A6 (D+), J1.B6 (D+), U1.6 (D+_out)
/D-: J1.A7 (D-), J1.B7 (D-), U1.5 (D-_out)
/LED_BLUE: R13.1, U2.29 (GPIO20)
/LED_GREEN: R12.1, U2.28 (GPIO13)
/LED_ORANGE: R11.1, U2.31 (GPIO22)
/LED_RED: R10.1, U2.32 (GPIO23)
/LR2021_ANT: J4.1 (In), U5.9 (ANT)
/LR2021_BUSY: U2.20 (GPIO5), U5.7 (BUSY)
/LR2021_CS: U2.22 (GPIO7), U5.6 (~CS)
/LR2021_DIO7: U2.26 (GPIO11), U5.17 (DIO7)
/LR2021_DIO8: U2.27 (GPIO12), U5.16 (DIO8)
/LR2021_DIO9: U2.19 (GPIO4), U5.15 (DIO9)
/LR2021_nRST: U2.21 (GPIO6), U5.14 (nRST)
/RESET_SW: C1.1, C5.1, J3.2, R8.1, SW1.1, U2.87 (CHIP_PU)
/SENSE_ALERT: R16.2, U2.59 (GPIO32), U4.10 (ALERT)
/SENSE_SCL: R5.2, U2.57 (GPIO30), U4.6 (SCL)
/SENSE_SDA: R4.2, U2.58 (GPIO31), U4.5 (SDA)
/SPI_MISO: J5.1, U2.23 (GPIO8), U5.3 (MISO)
/SPI_MOSI: J5.2, U2.25 (GPIO10), U5.4 (MOSI)
/SPI_SCK: J5.3, U2.24 (GPIO9), U5.5 (SCK)
/SYS_POWER: J1.A4 (VBUS), J1.A9 (VBUS), J1.B4 (VBUS), J1.B9 (VBUS), U4.13 (VBUS), U4.14 (IS+)
/USB_D+: U1.1 (D+_in), U2.49 (DP)
/USB_D-: U1.2 (D-_in), U2.48 (DM)
/VREG_IN: C4.2, U3.8 (VIN), U3.9 (EN), U3.11 (MODE_SYNC), U3.13 (VIN), U4.7 (IS-)
GND: BZ1.2 (+), C1.2, C2.2, C3.2, C4.1, C5.2, C6.1, C8.1, C9.1, C10.1, C11.2, C12.2, C13.2, D1.1 (K), D2.1 (K), D3.1 (K), D4.1 (K), J1.A1 (GND), J1.A12 (GND), J1.B1 (GND), J1.B12 (GND), J1.S1 (SHIELD), J2.1, J3.1, J4.2 (Ext), R1.1, R2.1, R3.2, R9.2, R15.1, SW1.2, SW2.2, U1.3 (GND), U2.1 (GND), U2.3 (GND), U2.15 (GND), U2.33 (GND), U2.40 (GND), U2.47 (GND), U2.52 (GND), U2.83 (GND), U3.2 (GND), U3.6 (GND), U3.12 (GND), U4.3 (A1), U4.4 (A0), U4.12 (GND), U5.2 (GND), U5.8 (GND), U5.11 (GND), U5.12 (GND), U5.18 (GND)
unnamed: D1.2 (A), R10.2
unnamed: D2.2 (A), R11.2
unnamed: D3.2 (A), R12.2
unnamed: D4.2 (A), R13.2
unnamed: J1.A5 (CC1), R1.2
unnamed: J1.B5 (CC2), R2.2
unnamed: R6.1, U2.63 (GPIO36)
unnamed: R3.1, U2.82 (GPIO54)
unnamed: R9.1, U3.5 (COMP_FSET)
unnamed: C7.1, R14.1, R15.2, U3.3 (FB)
unnamed: C6.2, U3.4 (SS_TR)
unnamed: U4.1 (SH+), U4.2 (IN+)
unnamed: U4.8 (SH-), U4.9 (IN-)
