ISSUIUC/ISS-PCB/boards/EAGLE-MK1/EAGLE-MK1-revA/EAGLE-MK1-revA.kicad_pcb

## KiCad design boards/EAGLE-MK1/EAGLE-MK1-revA/EAGLE-MK1-revA.kicad_pcb (2026-01-14)

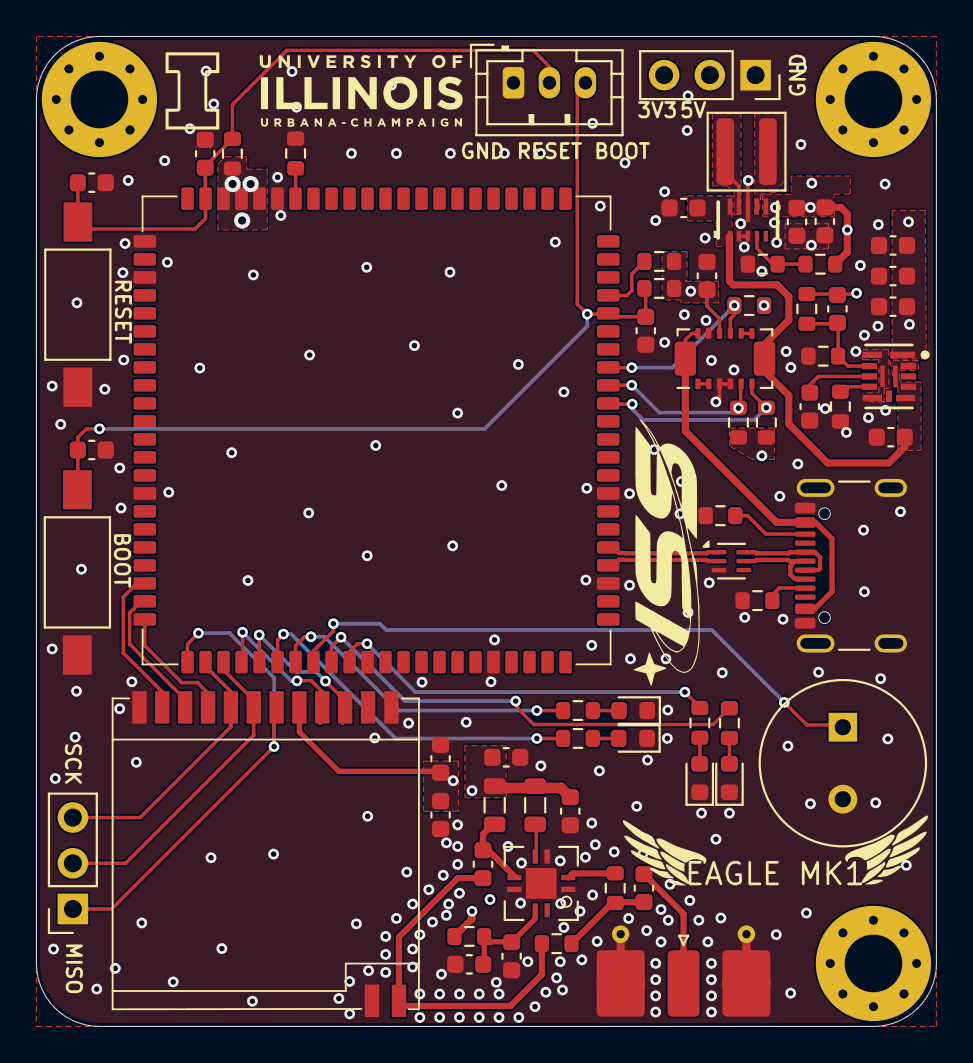
[picture p65: board EAGLE-MK1-revA.kicad_pcb from above]

Board: 4 copper layers, 50.0 x 55.0 mm, 68 parts (0 on the bottom side), 50 nets.

Parts:
BZ101: Buzzer; MagneticBuzzer_PUI_AT-0927-TT-6-R
C1, C2, C4, C5, C6, C45, C48: 22uF; C_0603_1608Metric
C3, C7, C8, C31, C114: 100nF; C_0603_1608Metric
C10, C34, C36, C120: 1uF; C_0603_1608Metric
C33, C35, C37, C49: 100pF; C_0603_1608Metric
C46: 4.7nF; C_0603_1608Metric
C47: 10pF; C_0603_1608Metric
D104: RED LED; LED_0603_1608Metric
D105: ORANGE LED; LED_0603_1608Metric
D106: GREEN LED; LED_0603_1608Metric
D107: BLUE LED; LED_0603_1608Metric
H101, H103, H104: MountingHole; MountingHole_3.2mm_M3_Pad_Via
J1: SMA; SMA_Molex_73251-2120_EdgeMount_Horizontal
J101: USB4105-GF-A; USB_C_Receptacle_GCT_USB4105-xx-A_16P_TopMnt_Horizontal
J107: Conn_01x03; JST_PH_B3B-PH-K_1x03_P2.00mm_Vertical
J108, J109: Conn_01x03; PinSocket_1x03_P2.54mm_Vertical
L1: 36nH; L_0805_2012Metric
L2: 47nH; L_0805_2012Metric
L4: 470nH; L_Wuerth_MAPI-4030
R1: 806k; R_0603_1608Metric
R2: 91k; R_0603_1608Metric
R3, R4, R118, R119: 0; R_0603_1608Metric
R5, R14, R19, R116: 10k; R_0603_1608Metric
R16: 100k; R_0603_1608Metric
R18: 453k; R_0603_1608Metric
R105, R106: 5.1k; R_0603_1608Metric
R117, R122: 4.7k; R_0603_1608Metric
R140: 20k; R_0603_1608Metric
R141, R142, R143, R144: 470; R_0603_1608Metric
SW2, SW3: SW_Push; SW_SPST_FSMSM
U1: RF4463PRO
U2: TPS63802; DLA0010A
U4: PMA-545G1+; QFN-8-1EP_3x3mm_P1.2mm_EP1.7x1.7mm
U5: TPSM82813; QFN-FCMOD-VCA0013A
U7: ESP32-P4; ESP32-P4-Module-Waveshare
U101: ECMF02-2AMX6; ST_UQFN-6L_1.5x1.7mm_P0.5mm
U106: INA745x; VQFN-REL0014B

Connections:
+3V3: C4.2, C5.2, C10.1, C31.1, C47.2, C48.2, C114.1, J108.3, R5.2, R18.2, R19.2, R116.1, R117.1, R122.1, R140.2, U1.5 (VCC), U5.1 (VOUT), U7.84 (ESP_VBAT), U7.85 (ESP_3V3), U7.86 (ESP_3V3), U106.11 (VS)
+5V: C2.2, C6.2, C35.2, C36.2, J108.2, L1.2, L2.2, R1.1, R4.2, U2.6 (VOUT)
/Antenna_Connector: C49.2, R118.2, R119.2
/Antenna_Connector_T: R118.1, U4.2 (RFIN)
/BOOT_SW: C3.1, C8.1, J107.3, R5.1, SW3.1, U7.62 (GPIO35)
/BUZZER: BZ101.1 (-), U7.30 (GPIO21)
/D+: J101.A6 (D+), J101.B6 (D+), U101.6 (D+_out)
/D-: J101.A7 (D-), J101.B7 (D-), U101.5 (D-_out)
/LED_BLUE: R144.1, U7.29 (GPIO20)
/LED_GREEN: R143.1, U7.28 (GPIO13)
/LED_ORANGE: R142.1, U7.31 (GPIO22)
/LED_RED: R141.1, U7.32 (GPIO23)
/RESET_SW: C7.1, C120.1, J107.2, R140.1, SW2.1, U7.87 (CHIP_PU)
/SENSE_ALERT: R116.2, U7.59 (GPIO32), U106.10 (ALERT)
/SENSE_SCL: R122.2, U7.57 (GPIO30), U106.6 (SCL)
/SENSE_SDA: R117.2, U7.58 (GPIO31), U106.5 (SDA)
/SPI_MISO: J109.1, U1.6 (SD0), U7.23 (GPIO8)
/SPI_MOSI: J109.2, U1.7 (SDI), U7.25 (GPIO10)
/SPI_SCK: J109.3, U1.8 (SCLK), U7.24 (GPIO9)
/SYS_POWER: J101.A4 (VBUS), J101.A9 (VBUS), J101.B4 (VBUS), J101.B9 (VBUS), U106.13 (VBUS), U106.14 (IS+)
/Si4463_ANT: C37.1, R119.1, U1.14 (ANT)
/Si4463_CS: U1.9 (nSEL), U7.22 (GPIO7)
/Si4463_EN: U1.11 (SDN), U7.20 (GPIO5)
/Si4463_GPIO0: U1.3 (GPIO0), U7.27 (GPIO12)
/Si4463_GPIO1: U1.4 (GPIO1), U7.26 (GPIO11)
/Si4463_nIRQ: U1.10 (nIRQ), U7.21 (GPIO6)
/USB_D+: U7.49 (DP), U101.1 (D+_in)
/USB_D-: U7.48 (DM), U101.2 (D-_in)
/VREG_IN: C1.2, C45.2, U2.1 (EN), U2.10 (VIN), U5.8 (VIN), U5.9 (EN), U5.11 (MODE_SYNC), U5.13 (VIN), U106.7 (IS-)
GND: BZ101.2 (+), C1.1, C2.1, C3.2, C4.1, C5.1, C6.1, C7.2, C8.2, C10.2, C31.2, C33.2, C34.2, C35.1, C36.1, C45.1, C46.1, C48.1, C114.2, C120.2, D104.1 (K), D105.1 (K), D106.1 (K), D107.1 (K), J1.2 (Ext), J101.A1 (GND), J101.A12 (GND), J101.B1 (GND), J101.B12 (GND), J101.S1 (SHIELD), J107.1, J108.1, R2.2, R3.2, R14.2, R16.1, R105.1, R106.1, SW2.2, SW3.2, U1.1 (GND), U1.12 (GND), U1.13 (GND), U2.2 (MODE), U2.3 (AGND), U2.8 (GND), U4.1 (NC), U4.3 (NC), U4.6 (NC), U4.9 (GND), U5.2 (GND), U5.6 (GND), U5.12 (GND), U7.1 (GND), U7.3 (GND), U7.15 (GND), U7.33 (GND), U7.40 (GND), U7.47 (GND), U7.52 (GND), U7.83 (GND), U101.3 (GND), U106.3 (A1), U106.4 (A0), U106.12 (GND)
unnamed: C33.1, C34.1, R4.1, U4.7 (BIAS)
unnamed: D104.2 (A), R141.2
unnamed: D105.2 (A), R142.2
unnamed: D106.2 (A), R143.2
unnamed: D107.2 (A), R144.2
unnamed: C49.1, J1.1 (In)
unnamed: J101.A5 (CC1), R105.2
unnamed: J101.B5 (CC2), R106.2
unnamed: L1.1, U4.4 (BIAS)
unnamed: R1.2, R2.1, U2.4 (FB)
unnamed: L4.1, U2.9 (L1)
unnamed: L4.2, U2.7 (L2)
unnamed: C37.2, L2.1, U4.5 (RFOUT)
unnamed: R14.1, U5.5 (COMP_FSET)
unnamed: C47.1, R16.2, R18.1, U5.3 (FB)
unnamed: C46.2, U5.4 (SS_TR)
unnamed: R19.1, U7.63 (GPIO36)
unnamed: R3.1, U7.82 (GPIO54)
unnamed: U106.1 (SH+), U106.2 (IN+)
unnamed: U106.8 (SH-), U106.9 (IN-)
