ISSUIUC/ISS-PCB/boards/BAGEL-MK1/BAGEL-MK1.1-Butter/BAGEL-MK1.1-Butter.kicad_pcb

## KiCad design boards/BAGEL-MK1/BAGEL-MK1.1-Butter/BAGEL-MK1.1-Butter.kicad_pcb (2026-01-31)

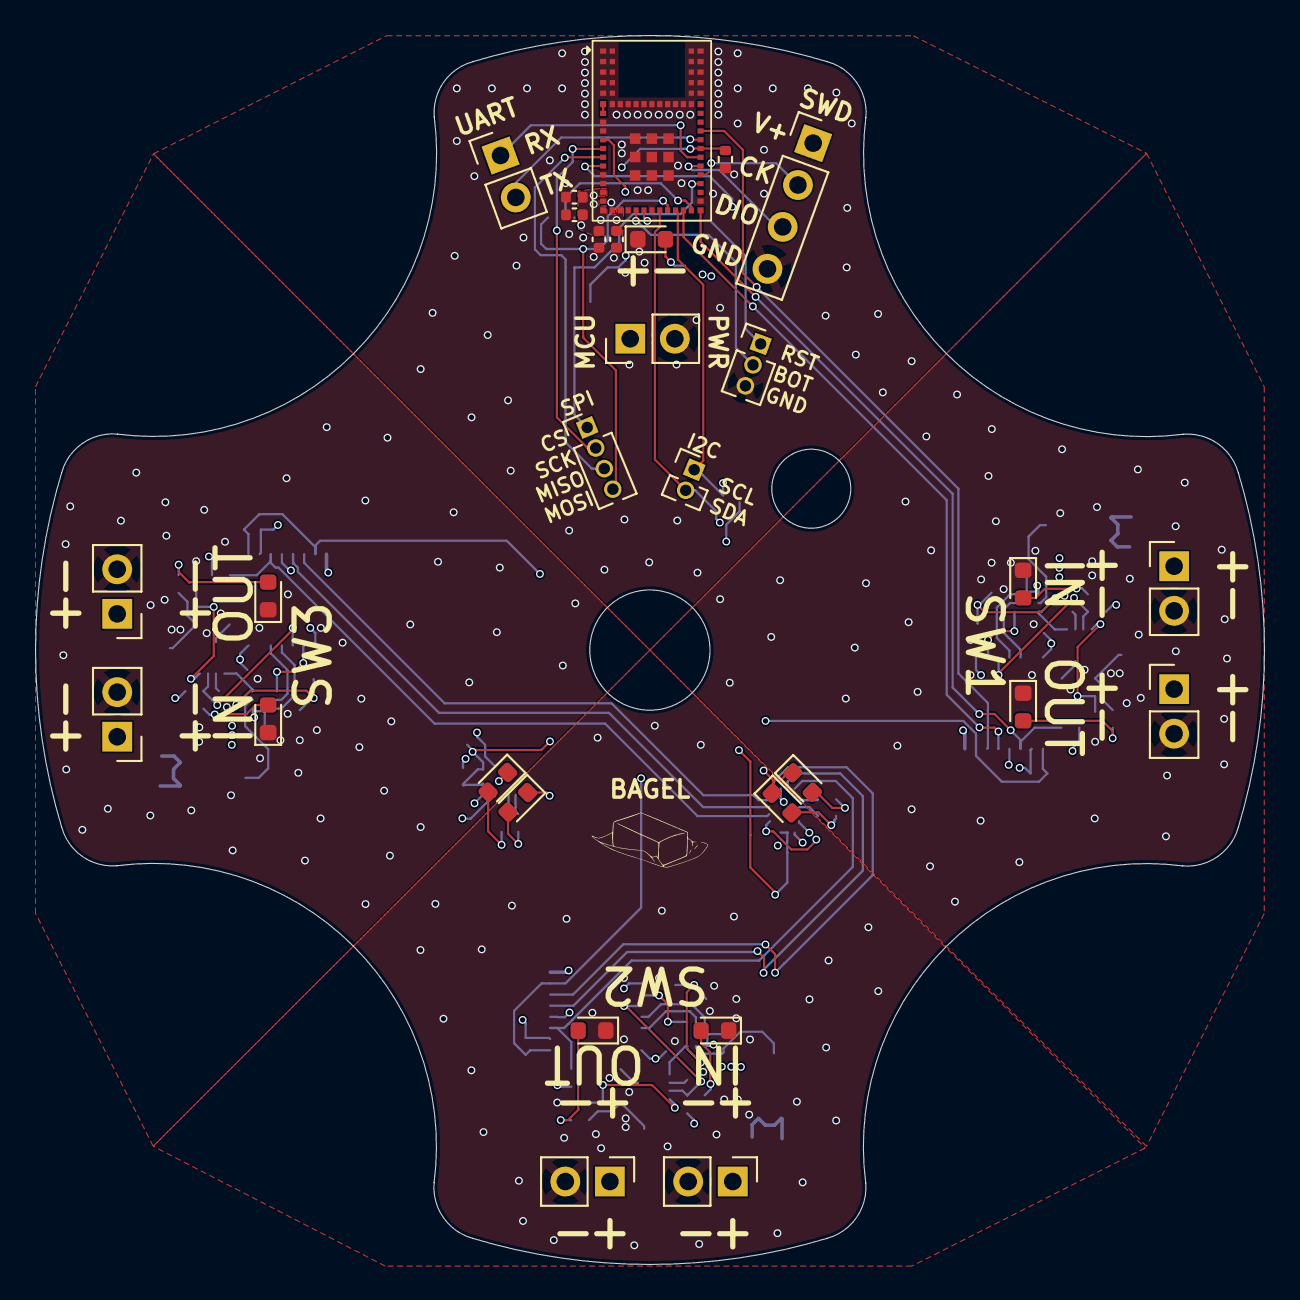
[picture p66: board BAGEL-MK1.1-Butter.kicad_pcb from above]

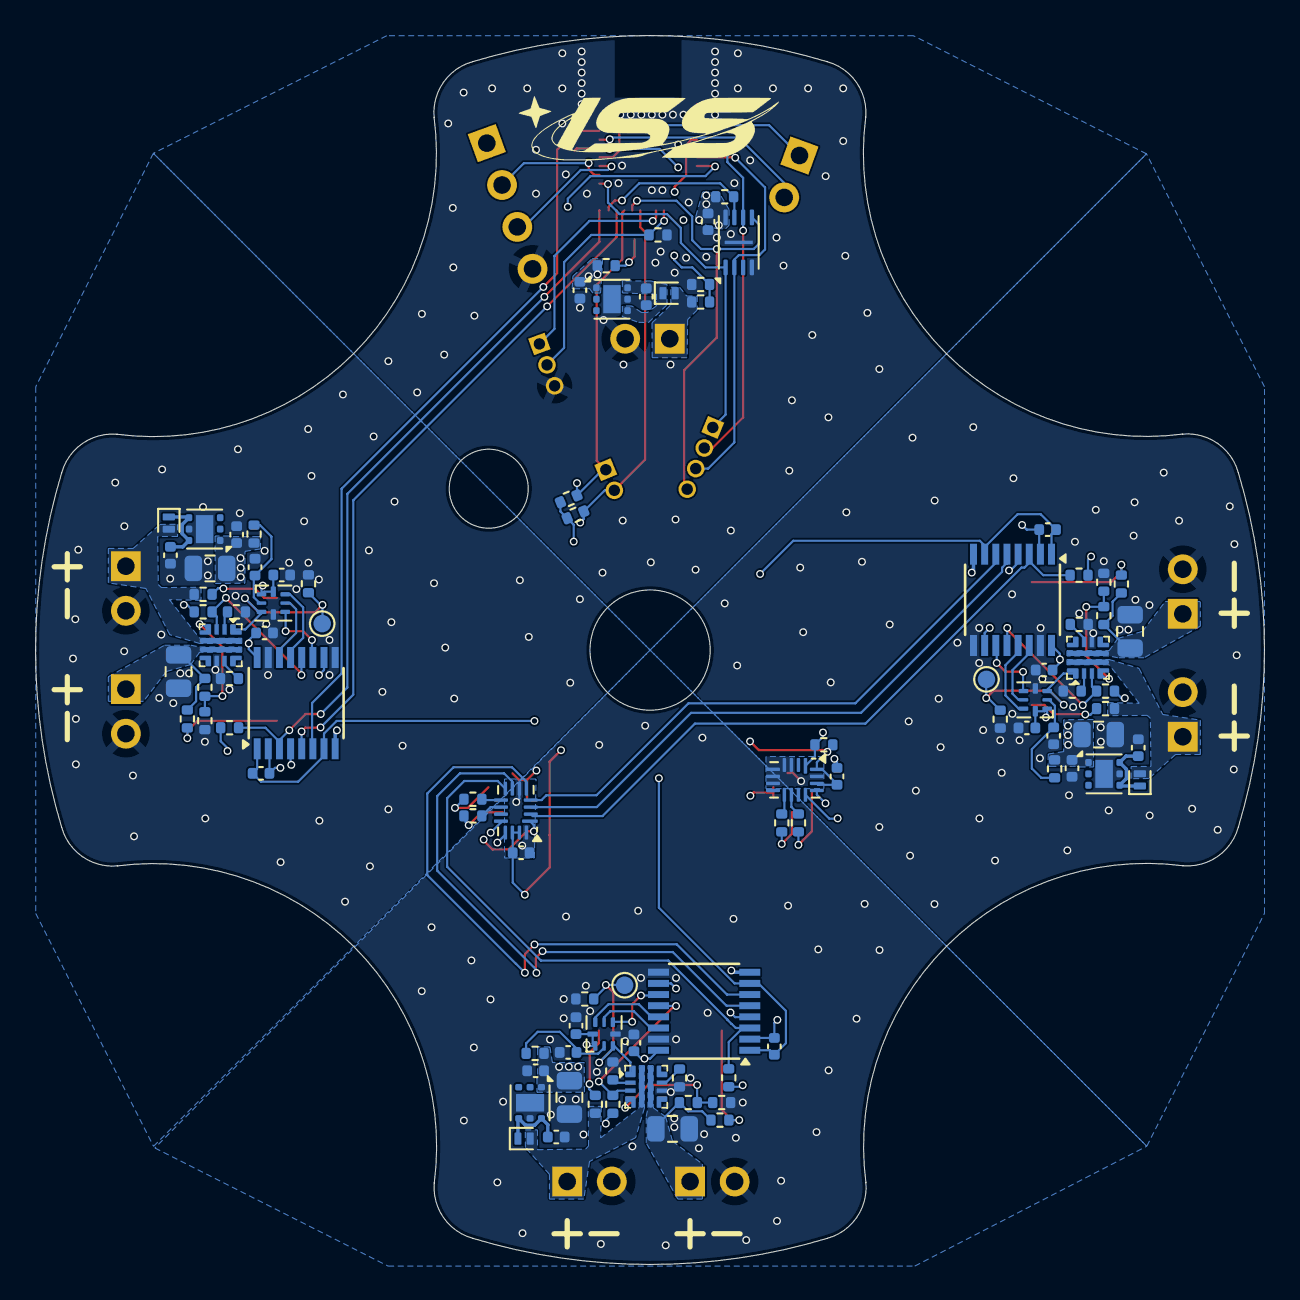
[picture p67: board BAGEL-MK1.1-Butter.kicad_pcb from below]

Board: 4 copper layers, 70.0 x 70.0 mm, 123 parts (94 on the bottom side), 87 nets.

Parts:
C101, C103, C104, C105, C108, C109, C201, C202, C203, C207, C301, C302, C303, C307, C401, C402, C403, C407: 100nF; C_0402_1005Metric
C102: 4.7uF; C_0402_1005Metric
C106, C204, C304, C404: 1uF; C_0402_1005Metric
C107, C205, C305, C405: 2.2uF; C_0402_1005Metric
C206, C306, C406: 100uF; C_0805_2012Metric
C208, C308, C408: 22uF; C_0805_2012Metric
D101, D201, D301, D401: SDM05U40CSP-7; D_SOD-882
D102, D103, D202, D302, D402: RED; LED_0603_1608Metric
D104: ORANGE; LED_0603_1608Metric
D105, D203, D303, D403: GREEN; LED_0603_1608Metric
D106: BLUE; LED_0603_1608Metric
J101: Conn_01x03; PinHeader_1x03_P1.27mm_Vertical
J102: Conn_01x04; PinHeader_1x04_P2.54mm_Vertical
J103, J104, J201, J203, J301, J303, J401, J403: Conn_01x02; PinHeader_1x02_P2.54mm_Vertical
J105: Conn_01x02; PinHeader_1x02_P1.27mm_Vertical
J106: Conn_01x04; PinHeader_1x04_P1.27mm_Vertical
J202, J302, J402: Conn_01x01; TestPoint_Pad_D1.0mm
R101, R102, R103, R113, R201, R202, R204, R205, R301, R302, R304, R305, R401, R402, R404, R405: 10k; R_0402_1005Metric
R104, R105, R106, R107, R108, R109, R112, R203, R303, R403: 4.7k; R_0402_1005Metric
R110, R111: 100k; R_0402_1005Metric
R206, R306, R406: 680; R_0402_1005Metric
R207, R307, R407: 390k; R_0402_1005Metric
R208, R308, R408: 300k; R_0402_1005Metric
R209, R309, R409: 500k; R_0402_1005Metric
R210, R310, R410: 1k; R_0402_1005Metric
U101: W25Q16JLUX; Winbond_USON-8-1EP_3x2mm_P0.5mm_EP0.2x1.6mm
U102: STM32WB1MMC; LGA77_6P5X10_STM
U103, U203, U303, U403: TPS7A25; WSON-6-1EP_2x2mm_P0.65mm_EP1x1.6mm
U104, U105: TCAL9538; UQFN-16_1.8x2.6mm_P0.4mm
U201, U301, U401: ISO7742; SSOP-16_3.9x4.9mm_P0.635mm
U202, U302, U402: SN74AUP1G74RSER; UQFN-RSE0008A
U204, U304, U404: TPS25947; VQFN-HR-RPW0010A

Connections:
/BLUE_LED: R108.1, U105.10 (P7)
/BOOT: J101.2, R102.2, U102.22 (BOOT0)
/CoinCell_V: D101.2 (A), J103.1, R110.2
/EXP_RESET: R103.1, U102.13 (PA2), U104.1 (~RESET), U105.1 (~RESET)
/FLASH_CS: J106.1, U101.1 (~CS), U102.33 (PB4)
/FLASH_RESET: R101.2, U101.7 (~HOLD/~RESET/IO_{3}), U102.29 (PA7)
/GPIO_Clock: R113.2, U102.37 (PA0), U201.4 (INB), U301.4 (INB), U401.4 (INB)
/GREEN_LED: R107.1, U105.9 (P6)
/I2C_SCL: J105.1, R112.1, U102.27 (PB6), U104.12 (SCL), U105.12 (SCL)
/I2C_SDA: J105.2, R109.1, U102.25 (PB7), U104.13 (SDA), U105.13 (SDA)
/NRST: J101.1, U102.23 (NRST)
/ORANGE_LED: R106.1, U104.10 (P7)
/PG_ISO_1: U102.28 (PA3), U201.5 (OUTC)
/PG_ISO_2: U104.7 (P4), U301.5 (OUTC)
/PG_ISO_3: U104.3 (P1), U401.5 (OUTC)
/RED_LED: R105.1, U104.9 (P6)
/SPI_MISO: J106.3, U101.2 (DO/IO_{1}), U102.12 (PA6)
/SPI_MOSI: J106.4, U101.5 (DI/IO_{0}), U102.26 (PB5)
/SPI_SCK: J106.2, U101.6 (CLK), U102.11 (PA1)
/SWCLK: J102.2, U102.34 (PA14)
/SWDIO: J102.3, U102.35 (PA13)
/Switch 1/PG: R205.2, U201.12 (INC), U204.3 (PG/AUXOFF)
/Switch 1/Q: J202.1, R202.2, U202.3 (Q), U204.1 (EN/UVLO)
/Switch 1/Reg_V: C201.1, C203.1, C205.1, C206.1, R204.1, R205.1, U201.10 (EN2), U201.16 (VCC2), U202.1 (~PRE), U202.8 (VCC), U203.1 (VOUT)
/Switch 1/SubBatt_GND: C201.2, C203.2, C204.2, C205.2, C206.2, C207.1, C208.2, D202.1 (K), D203.1 (K), J201.2, J203.2, R202.1, R206.1, R207.2, R209.2, U201.9 (GND2), U201.15 (GND2), U202.4 (GND), U203.5 (GND), U203.7 (Thermal), U204.8 (GND)
/Switch 1/SubBatt_V: D201.2 (A), J201.1, R203.1, U204.5 (IN)
/Switch 1/~CLR: C207.2, R204.2, U202.2 (~CLR)
/Switch 1/~Q: U201.11 (IND), U202.5 (~Q)
/Switch 2/PG: R305.2, U301.12 (INC), U304.3 (PG/AUXOFF)
/Switch 2/Q: J302.1, R302.2, U302.3 (Q), U304.1 (EN/UVLO)
/Switch 2/Reg_V: C301.1, C303.1, C305.1, C306.1, R304.1, R305.1, U301.10 (EN2), U301.16 (VCC2), U302.1 (~PRE), U302.8 (VCC), U303.1 (VOUT)
/Switch 2/SubBatt_GND: C301.2, C303.2, C304.2, C305.2, C306.2, C307.1, C308.2, D302.1 (K), D303.1 (K), J301.2, J303.2, R302.1, R306.1, R307.2, R309.2, U301.9 (GND2), U301.15 (GND2), U302.4 (GND), U303.5 (GND), U303.7 (Thermal), U304.8 (GND)
/Switch 2/SubBatt_V: D301.2 (A), J301.1, R303.1, U304.5 (IN)
/Switch 2/~CLR: C307.2, R304.2, U302.2 (~CLR)
/Switch 2/~Q: U301.11 (IND), U302.5 (~Q)
/Switch 3/PG: R405.2, U401.12 (INC), U404.3 (PG/AUXOFF)
/Switch 3/Q: J402.1, R402.2, U402.3 (Q), U404.1 (EN/UVLO)
/Switch 3/Reg_V: C401.1, C403.1, C405.1, C406.1, R404.1, R405.1, U401.10 (EN2), U401.16 (VCC2), U402.1 (~PRE), U402.8 (VCC), U403.1 (VOUT)
/Switch 3/SubBatt_GND: C401.2, C403.2, C404.2, C405.2, C406.2, C407.1, C408.2, D402.1 (K), D403.1 (K), J401.2, J403.2, R402.1, R406.1, R407.2, R409.2, U401.9 (GND2), U401.15 (GND2), U402.4 (GND), U403.5 (GND), U403.7 (Thermal), U404.8 (GND)
/Switch 3/SubBatt_V: D401.2 (A), J401.1, R403.1, U404.5 (IN)
/Switch 3/~CLR: C407.2, R404.2, U402.2 (~CLR)
/Switch 3/~Q: U401.11 (IND), U402.5 (~Q)
/Switch_1: R201.1, U102.30 (PA12), U201.3 (INA)
/Switch_2: R301.1, U104.8 (P5), U301.3 (INA)
/Switch_3: R401.1, U104.2 (P0), U401.3 (INA)
/UART_RX: J104.1, U102.36 (PA10)
/UART_TX: J104.2, U102.38 (PA9)
/V_SENSE: R110.1, R111.2, U102.10 (PA8)
/~Q_ISO_1: U102.39 (PA5), U201.6 (OUTD)
/~Q_ISO_2: U104.5 (P3), U301.6 (OUTD)
/~Q_ISO_3: U104.4 (P2), U401.6 (OUTD)
MCU_GND: C101.2, C102.2, C103.2, C104.2, C105.2, C106.2, C107.2, C108.2, C109.2, C202.2, C302.2, C402.2, D102.1 (K), D103.1 (K), D104.1 (K), D105.1 (K), D106.1 (K), J101.3, J102.4, J103.2, R102.1, R111.1, R113.1, R201.2, R301.2, R401.2, U101.4 (GND), U101.9 (EP), U102.1 (VSS), U102.2 (VSS), U102.3 (VSS), U102.4 (VSS), U102.5 (VSSRF), U102.8 (VSSRF), U102.9 (PA4), U102.14 (PB8), U102.15 (VSS), U102.17 (VSS), U102.19 (VSS), U102.21 (VSSSMPS), U102.24 (VSS), U102.31 (VSS), U102.43 (VSS), U102.44 (VSS), U102.45 (VSS), U102.46 (VSS), U102.47 (VSS), U102.48 (VSS), U102.49 (VSS), U102.50 (VSS), U102.51 (VSS), U102.52 (VSS), U102.53 (VSS), U102.54 (VSS), U102.55 (VSS), U102.56 (VSS), U102.57 (VSS), U102.58 (VSS), U102.59 (VSS), U102.60 (VSS), U102.61 (VSS), U102.62 (VSS), U102.63 (VSS), U102.64 (VSS), U102.65 (VSS), U102.66 (VSS), U102.67 (VSS), U102.68 (VSS), U102.69 (VSS), U102.70 (VSS), U102.71 (VSS), U102.72 (VSS), U102.73 (VSS), U102.74 (VSS), U102.75 (VSS), U102.76 (VSS), U102.77 (VSS), U103.5 (GND), U103.7 (Thermal), U104.6 (GND), U104.16 (A1), U105.3 (P1), U105.4 (P2), U105.5 (P3), U105.6 (GND), U105.7 (P4), U105.15 (A0), U201.2 (GND1), U201.8 (GND1), U301.2 (GND1), U301.8 (GND1), U401.2 (GND1), U401.8 (GND1)
MCU_V: C101.1, C102.1, C103.1, C104.1, C105.1, C107.1, C108.1, C109.1, C202.1, C302.1, C402.1, J102.1, R101.1, R103.2, R104.2, R109.2, R112.2, U101.8 (VCC), U102.16 (VDDA), U102.18 (VBAT), U102.20 (VDDSMPS), U103.1 (VOUT), U104.14 (VCC), U104.15 (A0), U105.14 (VCC), U105.16 (A1), U201.1 (VCC1), U201.7 (EN1), U301.1 (VCC1), U301.7 (EN1), U401.1 (VCC1), U401.7 (EN1)
unnamed: C106.1, D101.1 (K), U103.4 (EN), U103.6 (VIN)
unnamed: D102.2 (A), R104.1
unnamed: D103.2 (A), R105.2
unnamed: D104.2 (A), R106.2
unnamed: D105.2 (A), R107.2
unnamed: D106.2 (A), R108.2
unnamed: C204.1, D201.1 (K), U203.4 (EN), U203.6 (VIN)
unnamed: D202.2 (A), R203.2
unnamed: D203.2 (A), R210.2
unnamed: C304.1, D301.1 (K), U303.4 (EN), U303.6 (VIN)
unnamed: D302.2 (A), R303.2
unnamed: D303.2 (A), R310.2
unnamed: C404.1, D401.1 (K), U403.4 (EN), U403.6 (VIN)
unnamed: D402.2 (A), R403.2
unnamed: D403.2 (A), R410.2
unnamed: C208.1, J203.1, R208.1, R210.1, U204.6 (OUT)
unnamed: C308.1, J303.1, R308.1, R310.1, U304.6 (OUT)
unnamed: C408.1, J403.1, R408.1, R410.1, U404.6 (OUT)
unnamed: U102.6 (ANT_IN), U102.7 (ANT_OUT)
unnamed: U201.14 (OUTA), U202.6 (D)
unnamed: U201.13 (OUTB), U202.7 (CLK)
unnamed: R206.2, U204.9 (ILM)
unnamed: R207.1, U204.2 (OVLO/OVCSEL)
unnamed: R208.2, R209.1, U204.4 (PGTH/NFLT)
unnamed: U301.14 (OUTA), U302.6 (D)
unnamed: U301.13 (OUTB), U302.7 (CLK)
unnamed: R306.2, U304.9 (ILM)
unnamed: R307.1, U304.2 (OVLO/OVCSEL)
unnamed: R308.2, R309.1, U304.4 (PGTH/NFLT)
unnamed: U401.14 (OUTA), U402.6 (D)
unnamed: U401.13 (OUTB), U402.7 (CLK)
unnamed: R406.2, U404.9 (ILM)
unnamed: R407.1, U404.2 (OVLO/OVCSEL)
unnamed: R408.2, R409.1, U404.4 (PGTH/NFLT)
