ISSUIUC/ISS-PCB/boards/Mini-MK1/Mini-MK1.kicad_pcb

## KiCad design boards/Mini-MK1/Mini-MK1.kicad_pcb (2026-01-25)

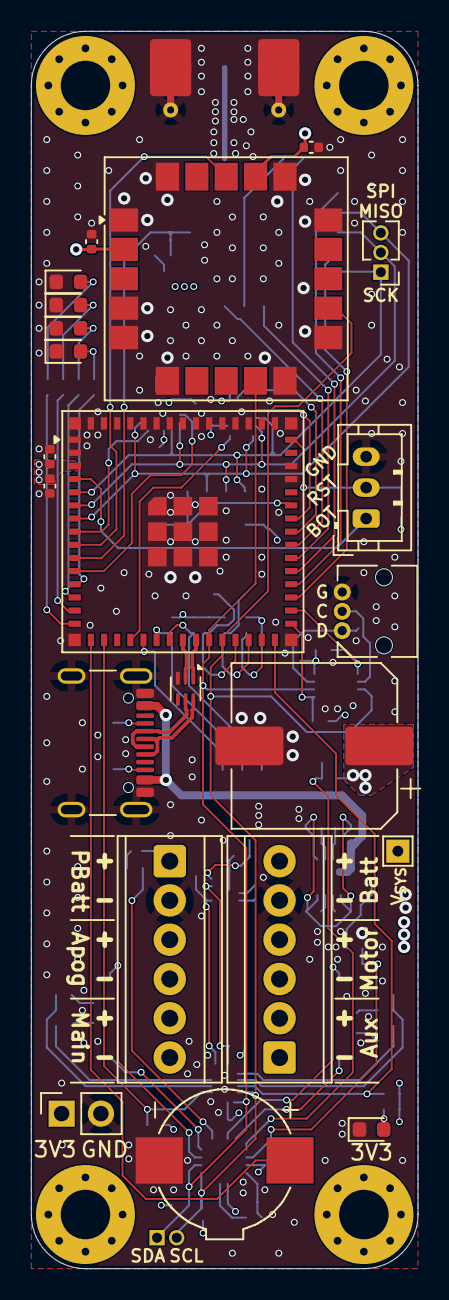
[picture p68: board Mini-MK1.kicad_pcb from above]

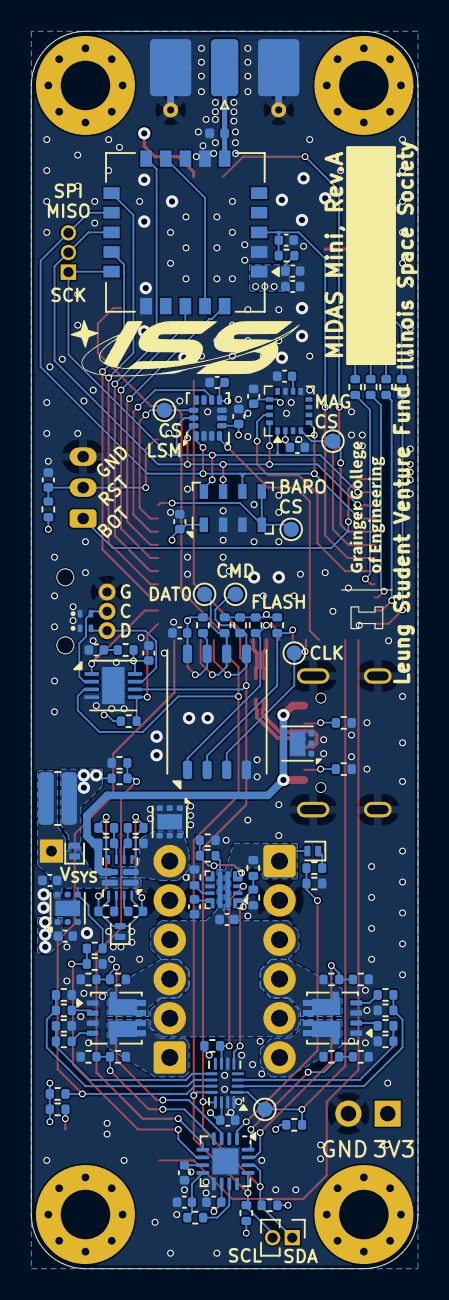
[picture p69: board Mini-MK1.kicad_pcb from below]

Board: 4 copper layers, 25.0 x 80.0 mm, 133 parts (107 on the bottom side), 91 nets.

Parts:
BZ101: Buzzer; Buzzer_SMTB-0927-TW-R
C101, C102, C103, C112, C201, C202: 1uF; C_0402_1005Metric
C104: 22uF; C_0402_1005Metric
C105, C106, C107, C108, C109, C113, C114, C301, C302, C304, C305, C306, C403: 100nF; C_0402_1005Metric
C110, C303: 10uF; C_0402_1005Metric
C111: 10nF; C_0402_1005Metric
C203: 100mF; CP_Elec_10x10.5
C204, C402: 4.7uF; C_0402_1005Metric
C401: 4.7nF; C_0402_1005Metric
D101, D202: SDM05U40CSP; D_SOD-882
D102, D103: ESD321; Texas_DPY0002A_0.6x1mm_P0.65mm
D104, D203: RED LED; LED_0603_1608Metric
D105: ORANGE LED; LED_0603_1608Metric
D106: GREEN LED; LED_0603_1608Metric
D107: BLUE LED; LED_0603_1608Metric
D201: BAS116L; D_SOD-882
H101, H102, H103, H104: M3; MountingHole_3.2mm_M3_Pad_Via
J101: USB4105-GF-A; USB_C_Receptacle_GCT_USB4105-xx-A_16P_TopMnt_Horizontal
J102, J103: Screw_Terminal_01x06; TerminalBlock_TE_282834-6_1x06_P2.54mm_Horizontal
J104: Conn_01x03; Molex_Micro-Lock_2200980371_1x03_P1.25mm_Horizontal
J105: SMA; SMA_Molex_73251-2120_EdgeMount_Horizontal
J106: Conn_01x03; PinHeader_1x03_P1.27mm_Vertical
J107: Conn_01x02; PinHeader_1x02_P1.27mm_Vertical
J108: Conn_01x03; JST_PH_B3B-PH-K_1x03_P2.00mm_Vertical
J201: TestPoint; TestPoint_THTPad_1.5x1.5mm_Drill0.7mm
J202: Conn_01x02; PinSocket_1x02_P2.54mm_Vertical
L101: 330nH; L_0402_1005Metric
Q401, Q402: Si7232DN; Vishay_PowerPAK_1212-8_Dual
R101, R103, R104, R105, R108, R109, R116, R404, R407, R408, R414, R419, R420: 100k; R_0402_1005Metric
R102: 560k; R_0402_1005Metric
R106, R107: 5.1k; R_0402_1005Metric
R110, R111, R112, R113, R114: 50k; R_0402_1005Metric
R115, R119, R423, R424: 10k; R_0402_1005Metric
R117, R118: 4.7k; R_0402_1005Metric
R120: 20k; R_0402_1005Metric
R121, R122, R123, R124, R207: 470; R_0402_1005Metric
R201, R203: 16.9k; R_0402_1005Metric
R202, R204: 5k; R_0402_1005Metric
R205: 21.5k; R_0402_1005Metric
R206: 20; R_0612_1632Metric
R401, R402, R415, R416: 3.3k; R_0402_1005Metric
R403, R413: 150k; R_0402_1005Metric
R405, R406, R412, R417, R418: 1k; R_0402_1005Metric
R409, R410, R421, R422: 18k; R_0402_1005Metric
R411: 820; R_0402_1005Metric
TP101, TP102, TP103, TP104, TP105, TP106, TP107: TestPoint_Small; TestPoint_Pad_D1.0mm
U101: ADS7138-Q1; WQFN-16-1EP_3x3mm_P0.5mm_EP1.68x1.68mm
U102: ECMF02-2AMX6; ST_UQFN-6L_1.5x1.7mm_P0.5mm
U103: ESP32-S3-MINI-1U; ESP32-S2-MINI-1U
U104: ZDSD64GLGEAG-R; LGA-8_8x6.2mm_P1.27mm
U105: TCA4307; WSON-8-1EP_3x3mm_P0.5mm_EP1.45x2.4mm
U106: E22-400MM22S
U107: SAM-M10Q; ublox_SAM-M8Q
U201, U202: TVS1800DRV; WSON-6-1EP_2x2mm_P0.65mm_EP1x1.6mm
U203: TPS2121; Texas_VQFN-HR-12_2x2.5mm_P0.5mm
U204: TPS746-Q1; WSON-6-1EP_2x2mm_P0.65mm_EP1x1.6mm
U301: MMC5983MA; LGA-16_3x3mm_P0.5mm
U302: LSM6DSV320X; LGA-14_3x2.5mm_P0.5mm_LayoutBorder3x4y
U303: MS5611-01BA; LGA-8_3x5mm_P1.25mm
U401: TPS25947; VQFN-HR-RPW0010A
U402: TCAL9538; UQFN-16_1.8x2.6mm_P0.4mm

Connections:
+3V3: C102.1, C103.1, C104.1, C105.1, C106.2, C109.1, C110.1, C111.1, C113.2, C114.2, C204.1, C301.1, C302.1, C304.1, C305.1, C306.1, C403.2, J202.1, R110.2, R111.2, R112.2, R113.2, R114.2, R115.2, R116.2, R117.2, R118.2, R119.2, R120.2, R207.1, R412.2, R423.2, R424.2, U101.7 (AVDD), U101.10 (DVDD), U103.3 (3V3), U104.8 (VDD), U105.8 (VCC), U106.1 (VCC), U107.2 (VCC_IO), U107.17 (VCC), U204.1 (OUT), U301.2 (VDD), U301.13 (VDDIO), U302.5 (VDDIO), U302.8 (VDD), U303.1 (VDD), U402.14 (VCC)
/B2B_EN: C107.1, R115.1, U103.32 (IO36), U105.1 (EN)
/B2B_READY: R119.1, U103.31 (IO35), U105.5 (READY)
/BOOT_SW: J108.1, U103.4 (IO0)
/BUZZER: BZ101.1 (+), U103.16 (IO12)
/D+: J101.A6 (D+), J101.B6 (D+), U102.6 (D+_out)
/D-: J101.A7 (D-), J101.B7 (D-), U102.5 (D-_out)
/E22_BUSY: U103.34 (IO38), U106.11 (BUSY)
/E22_CS: U103.33 (IO37), U106.14 (NSS)
/E22_DIO1: U103.37 (IO41), U106.20 (DIO1)
/E22_DIO3: U103.36 (IO40), U106.18 (DIO3)
/E22_RESET: C108.1, R116.1, U103.10 (IO6), U106.3 (NRST)
/E22_RXEN: U103.35 (IO39), U106.10 (RXEN)
/EXP_INT: R424.1, U103.30 (IO48), U402.11 (INT)
/EXP_RESET: R423.1, TP101.1, U103.17 (IO13), U402.1 (~RESET)
/FLASH_CLK: TP106.1, U103.20 (IO16), U104.3 (CLK)
/FLASH_CMD: R114.1, TP105.1, U103.27 (IO47), U104.5 (CMD)
/FLASH_DAT0: R110.1, TP107.1, U103.28 (IO33), U104.6 (DAT0)
/FLASH_DAT1: R111.1, U103.29 (IO34), U104.7 (DAT1)
/FLASH_DAT2: R112.1, U103.22 (IO18), U104.1 (DAT2)
/FLASH_DAT3: R113.1, U103.21 (IO17), U104.2 (DAT3)
/I2C_SCL: J107.2, R118.1, U101.13 (SCL), U103.26 (IO26), U105.3 (SCLIN), U107.12 (SCL), U402.12 (SCL)
/I2C_SCL_B2B: D103.2 (A2), J104.2, U105.2 (SCLOUT)
/I2C_SDA: J107.1, R117.1, U101.14 (SDA), U103.25 (IO21), U105.6 (SDAIN), U107.9 (SDA), U402.13 (SDA)
/I2C_SDA_B2B: D102.2 (A2), J104.1, U105.7 (SDAOUT)
/LED_BLUE: R124.1, U103.12 (IO8)
/LED_GREEN: R123.1, U103.13 (IO9)
/LED_ORANGE: R122.1, U103.14 (IO10)
/LED_RED: R121.1, U103.15 (IO11)
/LSM_CS: TP104.1, U103.39 (TXD0), U302.12 (CS)
/LSM_INT1: U103.19 (IO15), U302.4 (INT1)
/LSM_INT2: U103.38 (IO42), U302.9 (INT2)
/MAG_CS: TP102.1, U103.8 (IO4), U301.4 (CS)
/MAG_INT: U103.11 (IO7), U301.15 (INT)
/MS5611_CS: TP103.1, U103.40 (RXD0), U303.4 (CSB), U303.5 (CSB)
/PYRO_A: J102.4, Q401.5 (D2), R407.2
/PYRO_B: J102.6, Q401.6 (D1), R419.2
/PYRO_C: J103.3, Q402.6 (D1), R408.2
/PYRO_D: J103.1, Q402.5 (D2), R420.2
/PYRO_SENSE: R102.2, R103.1, U101.1 (ANI2/GPIO2)
/Power/PMUX_GND: C201.1, D201.2 (A), R202.2, R204.2, R205.1, U203.3 (CP2), U203.6 (PR1), U203.9 (ST), U203.12 (GND)
/Pyro/FIRE_A: R401.1, R405.1, U402.2 (P0)
/Pyro/FIRE_B: R415.1, R417.1, U402.3 (P1)
/Pyro/FIRE_C: R402.1, R406.1, U402.10 (P7)
/Pyro/FIRE_D: R416.1, R418.1, U402.9 (P6)
/Pyro/PGTH: R413.2, R414.1, U401.4 (PGTH/NFLT)
/Pyro/PYRO_EN: R403.2, R404.1, U401.1 (EN/UVLO), U402.5 (P3)
/Pyro/PYRO_PG: R412.1, U401.3 (PG/AUXOFF), U402.7 (P4)
/RESET_SW: C112.1, J108.2, R120.1, U103.45 (EN)
/SAM_RESET: U103.9 (IO5), U107.18 (~RESET)
/SENSE_A: R407.1, R409.2, U101.15 (AIN0/GPIO0)
/SENSE_B: R419.1, R421.2, U101.16 (AIN1/GPIO1)
/SENSE_C: R408.1, R410.2, U101.3 (AIN4/GPIO4)
/SENSE_D: R420.1, R422.2, U101.4 (AIN5/GPIO5)
/SPI_MISO: J106.3, U103.7 (IO3), U106.12 (MISO), U301.5 (SDO), U302.1 (SDO/TA0), U303.6 (SDO)
/SPI_MOSI: J106.2, U103.6 (IO2), U106.13 (MOSI), U301.16 (SDI), U302.14 (SDA), U303.7 (SDI/SDA)
/SPI_SCK: J106.1, U103.5 (IO1), U106.15 (SCK), U301.1 (SCK), U302.13 (SCL), U303.8 (SCLK)
/SYS_POWER: C202.1, D202.1 (K), J201.1, R104.1, R206.2, U203.1 (OUT), U203.8 (OUT), U204.4 (EN), U204.6 (IN)
/USB_D+: U102.1 (D+_in), U103.24 (USB_D+)
/USB_D-: U102.2 (D-_in), U103.23 (USB_D-)
/USB_POWER: J101.A4 (VBUS), J101.A9 (VBUS), J101.B4 (VBUS), J101.B9 (VBUS), R201.1, U201.4 (IN), U201.5 (IN), U201.6 (IN), U203.7 (IN1)
/VBAT: J103.6, R203.1, U202.4 (IN), U202.5 (IN), U202.6 (IN), U203.2 (IN2)
/VBAT_PYRO: D101.2 (A), J102.1, R403.1, U401.5 (IN)
/VBAT_SENSE: R104.2, R105.1, U101.6 (AIN7/GPIO7)
/VCAP: C203.1, D202.2 (A), R108.1, R206.1
/VCAP_SENSE: R108.2, R109.1, U101.5 (AIN6/GPIO6)
/V_PYRO: C402.1, J102.3, J102.5, J103.2, J103.4, R413.1, U401.6 (OUT)
GND: BZ101.2 (-), C101.2, C102.2, C103.2, C104.2, C105.2, C106.1, C107.2, C108.2, C109.2, C110.2, C111.2, C112.2, C113.1, C114.1, C202.2, C203.2, C204.2, C301.2, C302.2, C303.2, C304.2, C305.2, C306.2, C401.2, C402.2, C403.1, D102.1 (A1), D103.1 (A1), D104.1 (K), D105.1 (K), D106.1 (K), D107.1 (K), D201.1 (K), D203.1 (K), J101.A1 (GND), J101.A12 (GND), J101.B1 (GND), J101.B12 (GND), J101.S1 (SHIELD), J102.2, J103.5, J104.3, J105.2 (Ext), J108.3, J202.2, L101.2, Q401.1 (S1), Q401.3 (S2), Q402.1 (S1), Q402.3 (S2), R103.2, R105.2, R106.2, R107.2, R109.2, R401.2, R402.2, R404.2, R409.1, R410.1, R411.2, R414.2, R415.2, R416.2, R421.1, R422.1, U101.9 (GND), U101.17 (EPAD), U102.3 (GND), U103.1 (GND), U103.2 (GND), U103.42 (GND), U103.43 (GND), U103.46 (GND), U103.47 (GND), U103.48 (GND), U103.49 (GND), U103.50 (GND), U103.51 (GND), U103.52 (GND), U103.53 (GND), U103.54 (GND), U103.55 (GND), U103.56 (GND), U103.57 (GND), U103.58 (GND), U103.59 (GND), U103.60 (GND), U103.61 (GND), U103.62 (GND), U103.63 (GND), U103.64 (GND), U103.65 (GND), U104.4 (GND), U105.4 (GND), U105.9 (EP), U106.2 (GND), U106.7 (GND), U106.16 (GND), U107.1 (GND), U107.4 (GND), U107.5 (GND), U107.6 (GND), U107.10 (GND), U107.11 (GND), U107.15 (GND), U107.16 (GND), U107.20 (GND), U201.1 (GND), U201.2 (GND), U201.3 (GND), U201.7 (GND), U202.1 (GND), U202.2 (GND), U202.3 (GND), U202.7 (GND), U204.3 (GND), U204.7 (EP), U301.9 (GND), U301.11 (GND), U302.2 (SDx), U302.3 (SCx), U302.6 (GND), U302.7 (GND), U303.2 (PS), U303.3 (GND), U401.8 (GND), U402.6 (GND), U402.15 (A0), U402.16 (A1)
unnamed: D101.1 (K), R102.1
unnamed: D104.2 (A), R121.2
unnamed: D105.2 (A), R122.2
unnamed: D106.2 (A), R123.2
unnamed: D107.2 (A), R124.2
unnamed: D203.2 (A), R207.2
unnamed: J101.A5 (CC1), R106.1
unnamed: J101.B5 (CC2), R107.1
unnamed: J105.1 (In), L101.1, U106.6 (ANT)
unnamed: Q401.2 (G1), R417.2
unnamed: Q401.4 (G2), R405.2
unnamed: Q402.2 (G1), R406.2
unnamed: Q402.4 (G2), R418.2
unnamed: R101.1, U101.11 (ADDR)
unnamed: C101.1, R101.2, U101.8 (DECAP)
unnamed: U106.9 (TXEN), U106.19 (DIO2)
unnamed: R205.2, U203.10 (ILM)
unnamed: R201.2, R202.1, U203.5 (OV1)
unnamed: R203.2, R204.1, U203.4 (OV2)
unnamed: C201.2, U203.11 (SS)
unnamed: C303.1, U301.10 (CAP)
unnamed: R411.1, U401.9 (ILM)
unnamed: C401.1, U401.10 (ITIMER)
