ISSUIUC/ISS-PCB/boards/MIDAS-MK2/MIDAS-MK2.1-revA/MIDAS-MK2.1.kicad_pcb

## KiCad design boards/MIDAS-MK2/MIDAS-MK2.1-revA/MIDAS-MK2.1.kicad_pcb (2025-10-10)

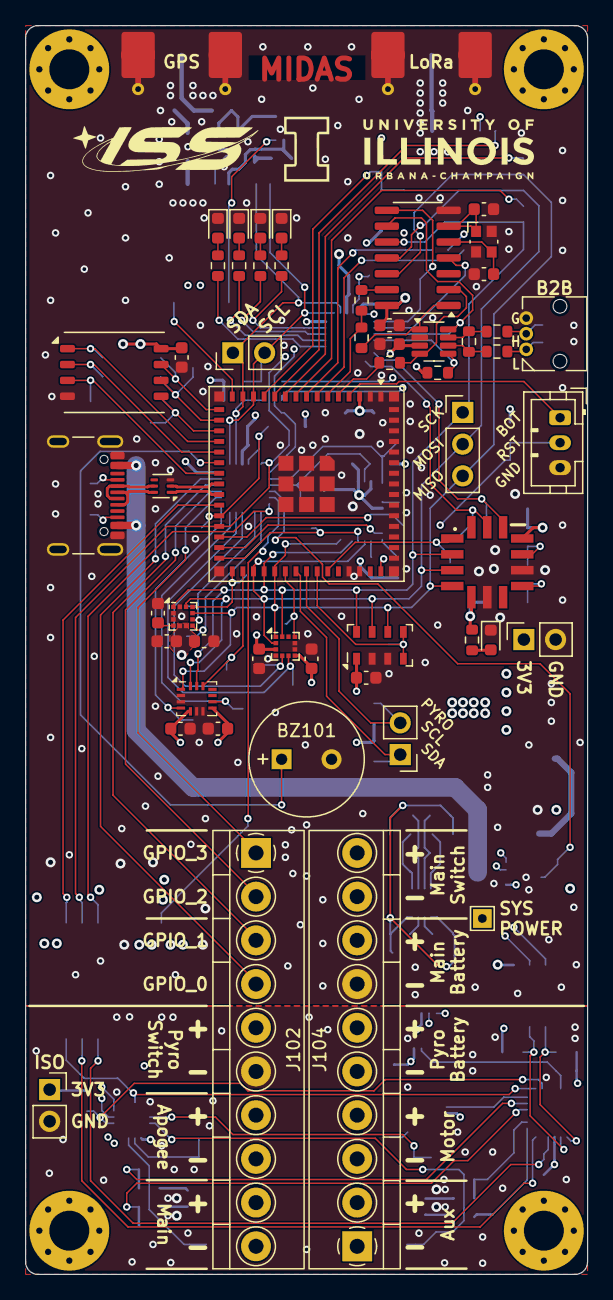
[picture p70: board MIDAS-MK2.1.kicad_pcb from above]

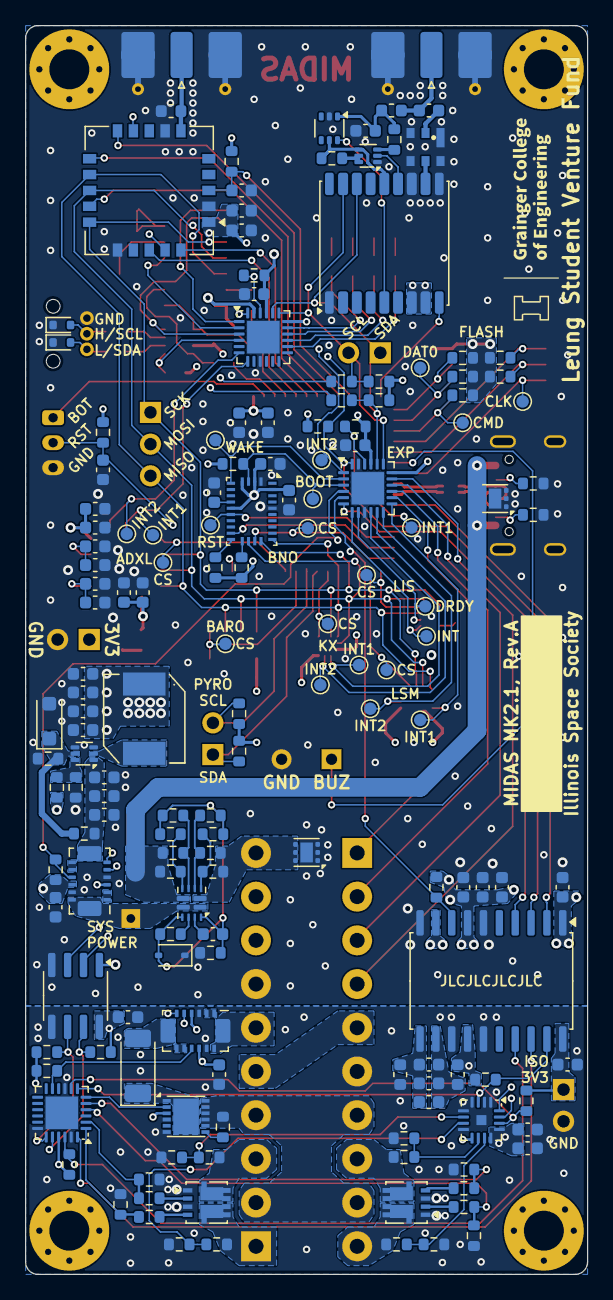
[picture p71: board MIDAS-MK2.1.kicad_pcb from below]

Board: 4 copper layers, 45.0 x 100.0 mm, 216 parts (159 on the bottom side), 154 nets.

Parts:
BZ101: AT-0927-TT-6-R; Buzzer_AT-0927-TT-6-R
C101, C102, C103, C107, C108, C109, C110, C201, C208, C209, C210, C211, C212, C301, C401, C502, C504, C506, C507, C508, C510, C511, C512, C513, C514, C515, C517, C518, C519: 0.1uF; C_0603_1608Metric
C104, C105: 22pF; C_0603_1608Metric
C106, C304, C305, C306, C307: 22uF; C_0603_1608Metric
C111, C204, C205, C308, C501, C503, C505, C509, C516: 1uF; C_0603_1608Metric
C202, C203, C402, C405: 10nF; C_0603_1608Metric
C206, C207, C302, C303, C404: 10uF; C_0603_1608Metric
C403: 47pF; C_0603_1608Metric
D101, D102: ESD321; D_SOD-523
D103, D303: RED LED; LED_0603_1608Metric
D104: ORANGE LED; LED_0603_1608Metric
D105: GREEN LED; LED_0603_1608Metric
D106: BLUE LED; LED_0603_1608Metric
D201: RSX501LAM20; D_SOD-128
D301: BZT52H-A5V1-QX; D_SOD-123F
D302: BAS416; D_SOD-323
FB201, FB202: BLM18SG331TN1D; L_0603_1608Metric
FL401: B3913; Qualcomm_SMD-6
H101, H102, H103, H104: M3; MountingHole_3.2mm_M3_Pad_Via
J101: USB4105-GF-A; USB_C_Receptacle_GCT_USB4105-xx-A_16P_TopMnt_Horizontal
J102: Left; Molex_Terminal-Block_393570010_1x10_P3.5mm
J103: Conn_01x03; Molex_Micro-Lock_2200980371_1x03_P1.25mm_Horizontal
J104: Right; Molex_Terminal-Block_393570010_1x10_P3.5mm
J105, J106: Conn_01x02; PinHeader_1x02_P2.54mm_Vertical
J107: Conn_01x03; PinHeader_1x03_P2.54mm_Vertical
J108: Conn_01x03; JST_PH_B3B-PH-K_1x03_P2.00mm_Vertical
J201, J302: Conn_01x02; PinSocket_1x02_P2.54mm_Vertical
J301: TestPoint; TestPoint_THTPad_1.5x1.5mm_Drill0.7mm
J401, J402: SMA; SMA_Molex_73251-2120_EdgeMount_Horizontal
L301: 2.2uH; L_TDK_SPM6530
L401: 27nH; L_0603_1608Metric
L402: 330nH; L_0603_1608Metric
Q201, Q202: Si7232DN; Vishay_PowerPAK_1212-8_Dual
Q401: Si1016X; SOT-563
R101, R104, R105, R106, R220, R222: 4.7k; R_0603_1608Metric
R102, R103, R107, R108, R114, R201, R221, R223, R224, R501: 10k; R_0603_1608Metric
R109, R110, R111, R112, R113: 50k; R_0603_1608Metric
R115, R116, R117, R118, R119, R120, R121, R312: 0; R_0603_1608Metric
R122: 120; R_0603_1608Metric
R123, R124: 5.1k; R_0603_1608Metric
R125, R303: 20k; R_0603_1608Metric
R126, R127, R128, R129, R315: 470; R_0603_1608Metric
R202, R206, R207, R214, R215: 1k; R_0603_1608Metric
R203, R301, R302, R305, R308, R310: 5k; R_0603_1608Metric
R204, R205, R212, R213: 3.3k; R_0603_1608Metric
R208, R209, R216, R217, R401, R403: 100k; R_0603_1608Metric
R210, R211, R218, R219, R306, R311: 30k; R_0603_1608Metric
R304: 27k; R_0603_1608Metric
R307: 33k; R_0603_1608Metric
R309: 69.8k; R_0603_1608Metric
R313: 135k; R_0603_1608Metric
R314: 21.5k; R_0603_1608Metric
R402: 10; R_0603_1608Metric
R502, R503: 2.2k; R_0603_1608Metric
TP101, TP102, TP103, TP104, TP105, TP106, TP107, TP108, TP109, TP110, TP111, TP112, TP113, TP114, TP115, TP116, TP117, TP118, TP119, TP120, TP121, TP122: TestPoint_Small; TestPoint_Pad_D1.0mm
U101, U201: INA745x; VQFN-REL0014B
U102, U103, U205: TCAL9539-Q1; WQFN-24-1EP_4x4mm_P0.5mm_EP2.6x2.6mm
U104: ESP32-S3-MINI-1U; ESP32-S2-MINI-1U
U105: MCP2518FDT-xSL; SOIC-14_3.9x8.7mm_P1.27mm
U106: ZDSD64GLGEAG-R; LGA-8_8x6.2mm_P1.27mm
U107: TCAN337G; SOT-23-8
U108: ECMF02-2AMX6; ST_UQFN-6L_1.5x1.7mm_P0.5mm
U202: NPC45560-H; DFN-12-1EP_3x3mm_P0.5mm_EP2.05x2.86mm
U203: ISOW7742; SOIC-20W_7.5x12.8mm_P1.27mm
U204: ISO1640BDR; SOIC-8_3.9x4.9mm_P1.27mm
U206: ADS122C04IRTE; Texas_RTE0016D_WQFN-16-1EP_3x3mm_P0.5mm_EP0.8x0.8mm
U301, U302: TVS1800DRV; WSON-6-1EP_2x2mm_P0.65mm_EP1x1.6mm
U303: TI_TPS566242; SOT-563
U304: TPS2121; Texas_VQFN-HR-12_2x2.5mm_P0.5mm
U401: E22-400MM22S
U402: NC7WZ07; SOT-363_SC-70-6
U403: MAX-M10S; ublox_MAX
U501: KX134-1211; LGA-12_2x2mm_P0.5mm
U502: ADXL355; Analog_LGA_14-7.4x7.4mm
U503: LSM6DSLTR; Bosch_LGA-14_3x2.5mm_P0.5mm
U504: BNO086; LGA-28_5.2x3.8mm_P0.5mm
U505: LIS3MDL; LGA-12_2x2mm_P0.5mm
U506: MS5611-01BA03; LGA-8_3x5mm_P1.25mm
Y101: 40MHz; Crystal_SMD_Abracon_ABM10-4Pin_2.5x2.0mm

Connections:
+3V3: C101.2, C102.1, C103.1, C106.2, C107.2, C108.2, C109.2, C110.2, C202.1, C204.1, C206.1, C209.1, C304.1, C305.1, C306.1, C307.1, C404.1, C405.1, C501.2, C502.2, C503.2, C504.1, C506.1, C508.1, C511.1, C512.1, C514.1, C515.1, C516.2, C517.2, C519.1, J302.1, L301.1, R101.2, R102.2, R103.2, R104.2, R105.2, R106.2, R107.1, R108.2, R109.2, R110.2, R111.2, R112.2, R113.2, R114.1, R125.2, R203.1, R313.2, R315.1, R401.2, R501.2, R502.2, R503.2, U101.3 (A1), U101.11 (VS), U102.18 (A0), U102.21 (VCC), U103.18 (A0), U103.21 (VCC), U103.23 (A1), U104.3 (3V3), U105.14 (VDD), U106.8 (VDD), U107.3 (VCC), U203.1 (V_{IO}), U203.7 (EN_IO1), U203.9 (V_{DD}), U204.1 (VCC1), U401.1 (VCC), U403.7 (VCC_IO), U403.8 (VCC), U501.3 (IO_VDD), U501.7 (VDD), U502.5 (V_{DDIO}), U502.11 (V_{SUPPLY}), U503.5 (VDDIO), U503.8 (VDD), U504.3 (VDD), U504.5 (PS1), U504.10 (CLKSEL0), U504.28 (VDDIO), U505.5 (Vdd), U505.6 (Vdd_IO), U506.1 (VDD)
+3V3_ISO: C201.2, C208.1, C210.1, C211.1, C212.1, FB201.1, J201.1, R201.1, R220.2, R221.2, R222.2, R223.2, R224.2, U201.4 (A0), U201.11 (VS), U202.3 (VCC), U203.14 (EN_IO2), U203.20 (V_{ISOIN}), U204.8 (VCC2), U205.21 (VCC), U206.9 (REFP), U206.12 (AVDD), U206.13 (DVDD)
/ADC_RESET: U104.25 (IO21), U203.2 (INA)
/ADXL355_CS: TP107.1, U104.40 (RXD0), U502.1 (~CS/SCL)
/ADXL355_INT1: TP109.1, U103.7 (P06), U502.13 (INT2)
/ADXL355_INT2: TP108.1, U103.6 (P05), U502.12 (INT1)
/AUX_GPIO_0: J102.4, U102.17
/AUX_GPIO_1: J102.3, U102.16
/AUX_GPIO_2: J102.2, U102.15
/AUX_GPIO_3: J102.1, U102.14
/BNO086_BOOT: R501.1, TP106.1, U102.3 (P02), U504.4 (BOOTN)
/BNO086_CS: TP103.1, U104.30 (IO48), U504.18 (H_CSN)
/BNO086_INT: U104.29 (IO34), U504.14 (H_INTN)
/BNO086_RESET: TP104.1, U104.28 (IO33), U504.11 (NRST)
/BNO086_WAKE: TP105.1, U102.2 (P01), U504.6 (PS0/WAKE)
/BOOT_SW: J108.1, U104.4 (IO0)
/BUZZER: BZ101.1 (-), U104.21 (IO17)
/CANH: R117.1, R122.1, U107.7 (CANH)
/CANL: R115.1, R122.2, U107.6 (CANL)
/CAN_1: R119.1, R120.1, U104.6 (IO2)
/CAN_2: R121.1, U104.5 (IO1)
/CAN_FAULT: R114.2, U103.4 (P03), U107.5 (FAULT)
/CAN_NCS: R119.2, U105.13 (NCS)
/CAN_NINT: U103.2 (P01), U105.4 (~INT)
/CAN_NINT1: U103.1 (P00), U105.8 (~INT1/GPIO1)
/CAN_RXD: R121.2, U105.2 (RXCAN), U107.4 (RXD)
/CAN_SLNT: U103.3 (P02), U105.9 (~INT0/GPIO0/XSTBY), U107.8 (S)
/CAN_TXD: R120.2, U105.1 (TXCAN), U107.1 (TXD)
/D+: J101.A6 (D+), J101.B6 (D+), U108.6 (D+_out)
/D-: J101.A7 (D-), J101.B7 (D-), U108.5 (D-_out)
/E22_BUSY: U104.10 (IO6), U401.11 (BUSY)
/E22_CS: U104.9 (IO5), U401.14 (NSS)
/E22_DIO1: U104.8 (IO4), U401.20 (DIO1)
/E22_DIO3: U104.7 (IO3), U401.18 (DIO3)
/E22_RESET: C401.1, R401.1, U104.12 (IO8), U401.3 (NRST)
/E22_RXEN: U104.11 (IO7), U401.10 (RXEN)
/EXP_INT0: U102.6 (P05), U203.4 (OUTC)
/EXP_INT1: R102.1, TP101.1, U102.22 (~INT), U104.26 (IO26)
/EXP_INT2: R103.1, TP102.1, U102.1 (P00), U103.22 (~INT)
/EXP_RESET: R108.1, U102.24 (~RESET), U103.24 (~RESET), U104.27 (IO47), U203.3 (INB)
/FLASH_CLK: TP121.1, U104.22 (IO18), U106.3 (CLK)
/FLASH_CMD: R113.1, TP120.1, U104.18 (IO14), U106.5 (CMD)
/FLASH_DAT0: R109.1, TP122.1, U104.17 (IO13), U106.6 (DAT0)
/FLASH_DAT1: R110.1, U104.16 (IO12), U106.7 (DAT1)
/FLASH_DAT2: R111.1, U104.19 (IO15), U106.1 (DAT2)
/FLASH_DAT3: R112.1, U104.20 (IO16), U106.2 (DAT3)
/I2C_SCL: J105.2, R104.1, R118.1, U102.19 (SCL), U103.19 (SCL), U104.13 (IO9), U403.17 (SCL)
/I2C_SDA: J105.1, R101.1, R116.1, U102.20 (SDA), U103.20 (SDA), U104.14 (IO10), U403.16 (SDA)
/INA_ALERT: R107.2, U101.10 (ALERT), U102.4 (P03)
/ISO_FLT: R203.2, U102.5 (P04), U203.8 (EN/FLT)
/KX134_CS: TP110.1, U104.36 (IO40), U501.10 (nCS)
/KX134_INT1: TP112.1, U102.10, U501.5 (INT1)
/KX134_INT2: TP111.1, U102.11, U501.6 (INT2)
/LED_BLUE: R129.1, U103.14
/LED_GREEN: R128.1, U103.15
/LED_ORANGE: R127.1, U103.16
/LED_RED: R126.1, U103.17
/LIS3MDL_CS: TP113.1, U104.31 (IO35), U505.10 (CS)
/LIS3MDL_DRDY: TP114.1, U102.8 (P07), U505.8 (DRDY)
/LIS3MDL_INT: TP115.1, U102.7 (P06), U505.7 (INT)
/LSM6DSLTR_INT1: TP117.1, U102.13, U503.4 (INT1)
/LSM6DSLTR_INT2: TP118.1, U102.12, U503.9 (INT2)
/LSM6DSL_CS: TP116.1, U104.32 (IO36), U503.12 (CS)
/MAX_RESET: U104.15 (IO11), U403.9 (~RESET)
/MS5611_CS: TP119.1, U104.39 (TXD0), U506.4 (CSB), U506.5 (CSB)
/PYRO_A: J102.8, Q201.5 (D2), R208.2
/PYRO_B: J102.10, Q201.6 (D1), R216.2
/PYRO_C: J104.3, Q202.6 (D1), R209.2
/PYRO_D: J104.1, Q202.5 (D2), R217.2
/PYRO_SCL: J106.2, R106.1, U101.6 (SCL), U104.38 (IO42), U204.3 (SCL1)
/PYRO_SDA: J106.1, R105.1, U101.5 (SDA), U104.37 (IO41), U204.2 (SDA1)
/PYRO_SW: J102.5, J104.5
/Power/MUX_CP2: R307.2, R308.1, U304.3 (CP2)
/Pyro Circuitry/ADC_DRDY: R224.1, U205.8 (P07), U206.14 (DRDY)
/Pyro Circuitry/ADC_RST_ISO: R223.1, U203.19 (OUTA), U205.7 (P06), U206.3 (RESET)
/Pyro Circuitry/EXP_INT_ISO: R221.1, U203.17 (INC), U205.22 (~INT)
/Pyro Circuitry/EXP_RST_ISO: U203.18 (OUTB), U205.24 (~RESET)
/Pyro Circuitry/FIRE_A: R204.1, R206.1, U205.5 (P04)
/Pyro Circuitry/FIRE_B: R212.1, R214.1, U205.4 (P03)
/Pyro Circuitry/FIRE_C: R205.1, R207.1, U205.2 (P01)
/Pyro Circuitry/FIRE_D: R213.1, R215.1, U205.1 (P00)
/Pyro Circuitry/GND2: C203.2, C205.2, C207.2, FB202.2, U203.11 (GND2)
/Pyro Circuitry/INA_ALRT_ISO: R201.2, U201.10 (ALERT), U205.11
/Pyro Circuitry/ISO_SCL: R222.1, U201.6 (SCL), U204.6 (SCL2), U205.19 (SCL), U206.16 (SCL)
/Pyro Circuitry/ISO_SDA: R220.1, U201.5 (SDA), U204.7 (SDA2), U205.20 (SDA), U206.15 (SDA)
/Pyro Circuitry/PYRO_EN: U202.2 (EN), U205.6 (P05)
/Pyro Circuitry/SENSE_A: R208.1, R210.2, U206.10 (AIN1)
/Pyro Circuitry/SENSE_B: R216.1, R218.2, U206.11 (AIN0)
/Pyro Circuitry/SENSE_C: R209.1, R211.2, U206.6 (AIN3)
/Pyro Circuitry/SENSE_D: R217.1, R219.2, U206.7 (AIN2)
/Pyro Circuitry/V_ISOOUT: C203.1, C205.1, C207.1, FB201.2, U203.12 (V_{ISOOUT})
/Pyro Circuitry/V_PYRO_ZONE: D201.2 (A), U201.7 (IS-)
/RESET_SW: C111.1, J108.2, R125.1, U104.45 (EN)
/RF/MAX_INT: U402.6 (Y1), U403.5 (EXTINT)
/SPI_MISO: J107.3, U104.35 (IO39), U105.12 (SDO), U401.12 (MISO), U501.1 (SDO/ADDR), U502.4 (MISO/ASEL), U503.1 (SDO/SA0), U504.20 (H_SDA/H_MISO/TX), U505.9 (SDO/SA1), U506.6 (SDO)
/SPI_MOSI: J107.2, U104.33 (IO37), U105.11 (SDI), U401.13 (MOSI), U501.2 (SDI/SDA), U502.3 (MOSI/SDA), U503.14 (SDA), U504.17 (H_SA0_MOSI), U505.11 (SDA/SDI/SDO), U506.7 (SDI/SDA)
/SPI_SCK: J107.1, U104.34 (IO38), U105.10 (SCK), U401.15 (SCK), U501.12 (SCLK/SCL), U502.2 (SCLK/V_{SSIO}), U503.13 (SCL), U504.19 (H_SCL/SCK/RX), U505.1 (SCL/SPC), U506.8 (SCLK)
/SYS_POWER: J301.1, U101.13 (VBUS), U101.14 (IS+), U304.1 (OUT), U304.8 (OUT)
/USB_D+: U104.24 (IO20), U108.1 (D+_in)
/USB_D-: U104.23 (IO19), U108.2 (D-_in)
/USB_POWER: J101.A4 (VBUS), J101.A9 (VBUS), J101.B4 (VBUS), J101.B9 (VBUS), R301.1, R304.1, U301.4 (IN), U301.5 (IN), U301.6 (IN), U304.7 (IN1)
/VBAT: J104.10, R307.1, R309.1, U302.4 (IN), U302.5 (IN), U302.6 (IN), U304.2 (IN2)
/VBAT_PYRO: J104.6, U201.13 (VBUS), U201.14 (IS+)
/VREG_IN: C301.1, C302.1, C303.1, R303.1, U101.7 (IS-), U303.1 (VIN)
/V_PYRO: J102.7, J102.9, J104.2, J104.4, R202.1, U202.8 (VOUT), U202.9 (VOUT), U202.10 (VOUT), U202.11 (VOUT), U202.12 (VOUT)
GND: BZ101.2 (+), C101.1, C102.2, C103.2, C104.1, C105.2, C106.1, C107.1, C108.1, C109.1, C110.1, C111.2, C202.2, C204.2, C206.2, C209.2, C301.2, C302.2, C303.2, C304.2, C305.2, C306.2, C307.2, C401.2, C402.2, C404.2, C405.2, C501.1, C502.1, C503.1, C504.2, C505.1, C506.2, C507.2, C508.2, C509.1, C510.2, C511.2, C512.2, C513.2, C514.2, C515.2, C516.1, C517.1, C518.1, C519.2, D101.1 (A1), D102.1 (A1), D103.1 (K), D104.1 (K), D105.1 (K), D106.1 (K), D301.2 (A), D302.1 (K), D303.1 (K), FL401.1 (GND), FL401.3 (GND), FL401.4 (GND), FL401.6 (GND), J101.A1 (GND), J101.A12 (GND), J101.B1 (GND), J101.B12 (GND), J101.S1 (SHIELD), J103.3, J104.7, J108.3, J302.2, J401.2 (Ext), J402.2 (Ext), L402.2, Q401.1 (S1), R123.2, R124.2, R306.2, R311.2, R312.2, U101.4 (A0), U101.12 (GND), U102.9 (GND), U102.23 (A1), U102.25 (GND), U103.9 (GND), U103.25 (GND), U104.1 (GND), U104.2 (GND), U104.42 (GND), U104.43 (GND), U104.46 (GND), U104.47 (GND), U104.48 (GND), U104.49 (GND), U104.50 (GND), U104.51 (GND), U104.52 (GND), U104.53 (GND), U104.54 (GND), U104.55 (GND), U104.56 (GND), U104.57 (GND), U104.58 (GND), U104.59 (GND), U104.60 (GND), U104.61 (GND), U104.62 (GND), U104.63 (GND), U104.64 (GND), U104.65 (GND), U105.7 (VSS), U106.4 (GND), U107.2 (GND), U108.3 (GND), U203.6 (GNDIO), U203.10 (GND1), U204.4 (GND1), U301.1 (GND), U301.2 (GND), U301.3 (GND), U301.7 (GND), U302.1 (GND), U302.2 (GND), U302.3 (GND), U302.7 (GND), U303.3 (GND), U303.4 (AGND), U401.2 (GND), U401.7 (GND), U401.16 (GND), U402.2 (GND), U403.1 (GND), U403.10 (GND), U403.12 (GND), U501.4 (TRIG), U501.8 (GND), U501.9 (GND), U502.6 (V_{SSIO}), U502.9 (VSS), U503.2 (SDx), U503.3 (SCx), U503.6 (GND), U503.7 (GND), U504.2 (GND), U504.25 (GNDIO), U505.2 (Reserved), U505.3 (GND), U505.12 (Reserved), U506.2 (PS), U506.3 (GND), Y101.2, Y101.4
unnamed: D101.2 (A2), J103.1, R115.2, R116.2
unnamed: D102.2 (A2), J103.2, R117.2, R118.2
unnamed: D103.2 (A), R126.2
unnamed: D104.2 (A), R127.2
unnamed: D105.2 (A), R128.2
unnamed: D106.2 (A), R129.2
unnamed: D201.1 (K), U202.1 (VIN), U202.13 (VIN)
unnamed: D301.1 (K), R303.2, R306.1, U303.5 (EN)
unnamed: C308.1, D302.2 (A), R302.2, R305.2, R308.2, R310.2, R312.1, R314.1, U304.9 (ST), U304.12 (GND)
unnamed: D303.2 (A), R315.2
unnamed: C403.2, FL401.2 (IN)
unnamed: FL401.5 (OUT), U403.11 (RF_IN)
unnamed: J101.A5 (CC1), R123.1
unnamed: J101.B5 (CC2), R124.1
unnamed: J104.8, J104.9
unnamed: C403.1, J401.1 (In), L401.1
unnamed: J402.1 (In), L402.1, U401.6 (ANT)
unnamed: Q201.2 (G1), R214.2
unnamed: Q201.4 (G2), R206.2
unnamed: Q202.2 (G1), R207.2
unnamed: Q202.4 (G2), R215.2
unnamed: Q401.5 (G2), Q401.6 (D1), R403.1
unnamed: Q401.2 (G2), U403.13 (LNA_EN)
unnamed: Q401.3 (D2), R402.1
unnamed: Q401.4 (S2), R403.2, U402.5 (VCC), U403.14 (VCC_RF)
unnamed: U101.1 (SH+), U101.2 (IN+)
unnamed: U101.8 (SH-), U101.9 (IN-)
unnamed: C105.1, U105.6 (OSC1), Y101.1
unnamed: C104.2, U105.5 (OSC2), Y101.3
unnamed: U201.1 (SH+), U201.2 (IN+)
unnamed: U201.8 (SH-), U201.9 (IN-)
unnamed: R202.2, U202.7 (BLEED)
unnamed: R311.1, R313.1, U303.6 (FB)
unnamed: L301.2, U303.2 (SW)
unnamed: R314.2, U304.10 (ILM)
unnamed: R304.2, R305.1, U304.5 (OV1)
unnamed: R309.2, R310.1, U304.4 (OV2)
unnamed: R301.2, R302.1, U304.6 (PR1)
unnamed: C308.2, U304.11 (SS)
unnamed: U401.9 (TXEN), U401.19 (DIO2)
unnamed: C402.1, L401.2, R402.2, U402.1 (A1)
unnamed: C505.2, C507.1, U502.10 (V_{1P8ANA})
unnamed: C509.2, C510.1, U502.8 (V_{1P8DIG})
unnamed: C513.1, U504.9 (CAP)
unnamed: R503.1, U504.15 (ENV_SCL)
unnamed: R502.1, U504.16 (ENV_SDA)
unnamed: C518.2, U505.4 (C1)
PYRO_GND: C201.1, C208.2, C210.2, C211.2, C212.2, FB202.1, J102.6, J201.2, Q201.1 (S1), Q201.3 (S2), Q202.1 (S1), Q202.3 (S2), R204.2, R205.2, R210.1, R211.1, R212.2, R213.2, R218.1, R219.1, U201.3 (A1), U201.12 (GND), U202.4 (GND), U202.6 (PG), U203.13 (VSEL), U203.15 (GISOIN), U204.5 (GND2), U205.9 (GND), U205.18 (A0), U205.23 (A1), U205.25 (GND), U206.1 (A0), U206.2 (A1), U206.4 (DGND), U206.5 (AVSS), U206.8 (REFN), U206.17 (EP)
