ISSUIUC/ISS-PCB/boards/Feather_Duo/Feather_Duo.kicad_pcb

## KiCad design boards/Feather_Duo/Feather_Duo.kicad_pcb (2025-09-06)

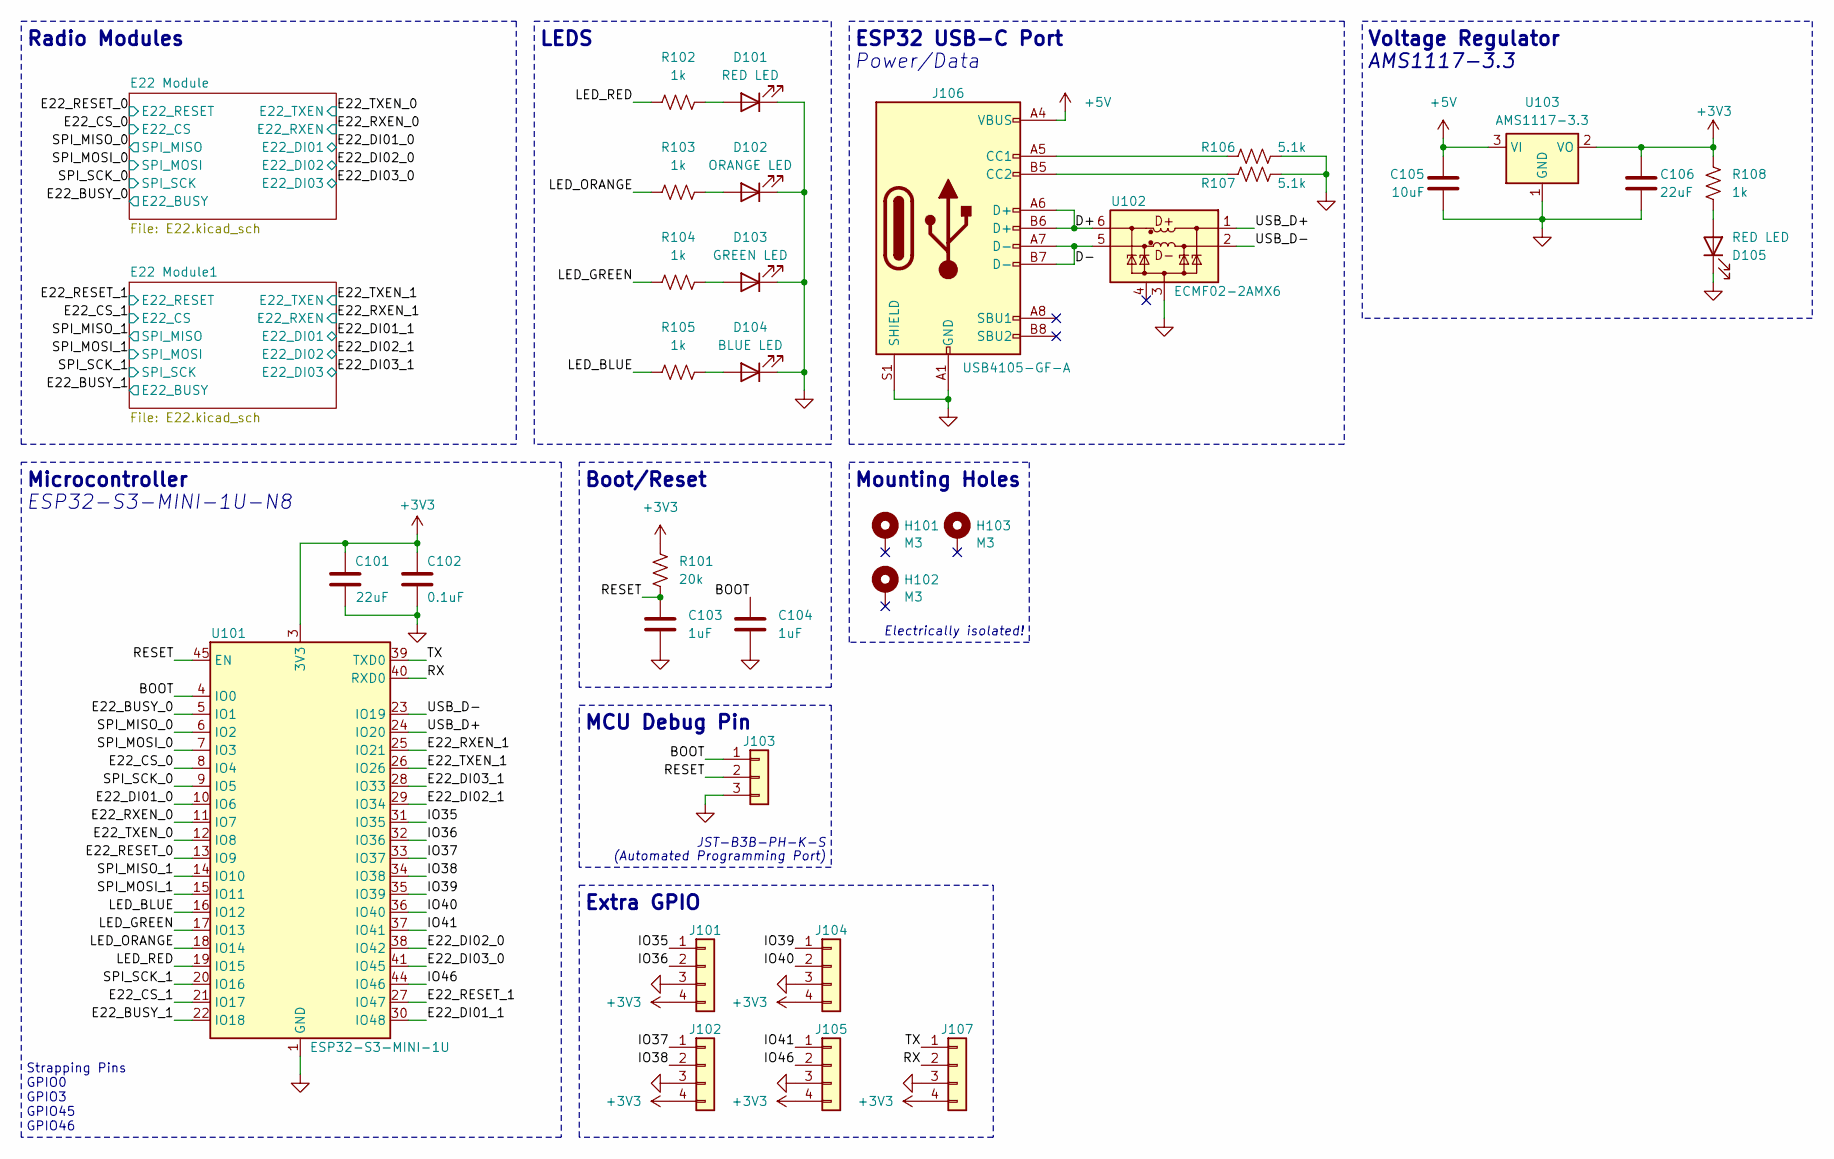
[picture p72: schematic Feather_Duo.kicad_sch, Feather Duo]

Parts:
C101, C106: 22uF; C_0603_1608Metric
C102: 0.1uF; C_0603_1608Metric
C103, C104: 1uF; C_0603_1608Metric
C105: 10uF; C_0603_1608Metric
D101, D105: RED LED; LED_0603_1608Metric
D102: ORANGE LED; LED_0603_1608Metric
D103: GREEN LED; LED_0603_1608Metric
D104: BLUE LED; LED_0603_1608Metric
H101, H102, H103: M3; MountingHole_3.2mm_M3_Pad_Via
J101, J102, J104, J105, J107: Conn_01x04; PinHeader_1x04_P2.54mm_Vertical
J103: Conn_01x03; JST_PH_B3B-PH-K_1x03_P2.00mm_Vertical
J106: USB4105-GF-A; USB_C_Receptacle_GCT_USB4105-xx-A_16P_TopMnt_Horizontal
R101: 20k; R_0603_1608Metric
R102, R103, R104, R105, R108: 1k; R_0603_1608Metric
R106, R107: 5.1k; R_0603_1608Metric
U101: ESP32-S3-MINI-1U; ESP32-S2-MINI-1U
U102: ECMF02-2AMX6; ST_UQFN-6L_1.5x1.7mm_P0.5mm
U103: AMS1117-3.3; SOT-223-3_TabPin2

Connections:
+3V3: C101.2, C102.2, C106.1, J101.4, J102.4, J104.4, J105.4, J107.4, R101.1, R108.1, U101.3 (3V3), U103.2 (VO); also elsewhere on the board
+5V: C105.1, J106.A4 (VBUS), J106.A9 (VBUS), J106.B4 (VBUS), J106.B9 (VBUS), U103.3 (VI)
/BOOT: C104.1, J103.1, U101.4 (IO0)
/D+: J106.A6 (D+), J106.B6 (D+), U102.6 (D+_out)
/D-: J106.A7 (D-), J106.B7 (D-), U102.5 (D-_out)
/E22_BUSY_0: U101.5 (IO1); also elsewhere on the board
/E22_BUSY_1: U101.22 (IO18); also elsewhere on the board
/E22_CS_0: U101.8 (IO4); also elsewhere on the board
/E22_CS_1: U101.21 (IO17); also elsewhere on the board
/E22_DI01_0: U101.10 (IO6); also elsewhere on the board
/E22_DI01_1: U101.30 (IO48); also elsewhere on the board
/E22_DI02_0: U101.38 (IO42); also elsewhere on the board
/E22_DI02_1: U101.29 (IO34); also elsewhere on the board
/E22_DI03_0: U101.41 (IO45); also elsewhere on the board
/E22_DI03_1: U101.28 (IO33); also elsewhere on the board
/E22_RESET_0: U101.13 (IO9); also elsewhere on the board
/E22_RESET_1: U101.27 (IO47); also elsewhere on the board
/E22_RXEN_0: U101.11 (IO7); also elsewhere on the board
/E22_RXEN_1: U101.25 (IO21); also elsewhere on the board
/E22_TXEN_0: U101.12 (IO8); also elsewhere on the board
/E22_TXEN_1: U101.26 (IO26); also elsewhere on the board
/IO35: J101.1, U101.31 (IO35)
/IO36: J101.2, U101.32 (IO36)
/IO37: J102.1, U101.33 (IO37)
/IO38: J102.2, U101.34 (IO38)
/IO39: J104.1, U101.35 (IO39)
/IO40: J104.2, U101.36 (IO40)
/IO41: J105.1, U101.37 (IO41)
/IO46: J105.2, U101.44 (IO46)
/LED_BLUE: R105.1, U101.16 (IO12)
/LED_GREEN: R104.1, U101.17 (IO13)
/LED_ORANGE: R103.1, U101.18 (IO14)
/LED_RED: R102.1, U101.19 (IO15)
/RESET: C103.1, J103.2, R101.2, U101.45 (EN)
/RX: J107.2, U101.40 (RXD0)
/SPI_MISO_0: U101.6 (IO2); also elsewhere on the board
/SPI_MISO_1: U101.14 (IO10); also elsewhere on the board
/SPI_MOSI_0: U101.7 (IO3); also elsewhere on the board
/SPI_MOSI_1: U101.15 (IO11); also elsewhere on the board
/SPI_SCK_0: U101.9 (IO5); also elsewhere on the board
/SPI_SCK_1: U101.20 (IO16); also elsewhere on the board
/TX: J107.1, U101.39 (TXD0)
/USB_D+: U101.24 (IO20), U102.1 (D+_in)
/USB_D-: U101.23 (IO19), U102.2 (D-_in)
GND: C101.1, C102.1, C103.2, C104.2, C105.2, C106.2, D101.1 (K), D102.1 (K), D103.1 (K), D104.1 (K), D105.1 (K), J101.3, J102.3, J103.3, J104.3, J105.3, J106.A1 (GND), J106.A12 (GND), J106.B1 (GND), J106.B12 (GND), J106.S1 (SHIELD), J107.3, R106.2, R107.2, U101.1 (GND), U101.2 (GND), U101.42 (GND), U101.43 (GND), U101.46 (GND), U101.47 (GND), U101.48 (GND), U101.49 (GND), U101.50 (GND), U101.51 (GND), U101.52 (GND), U101.53 (GND), U101.54 (GND), U101.55 (GND), U101.56 (GND), U101.57 (GND), U101.58 (GND), U101.59 (GND), U101.60 (GND), U101.61 (GND), U101.62 (GND), U101.63 (GND), U101.64 (GND), U101.65 (GND), U102.3 (GND), U103.1 (GND); also elsewhere on the board
unnamed: D101.2 (A), R102.2
unnamed: D102.2 (A), R103.2
unnamed: D103.2 (A), R104.2
unnamed: D104.2 (A), R105.2
unnamed: D105.2 (A), R108.2
unnamed: J106.A5 (CC1), R106.1
unnamed: J106.B5 (CC2), R107.1

Notes on the sheet:
Microcontroller
MCU Debug Pin
Electrically isolated!
LEDS
Voltage Regulator
AMS1117-3.3
JST-B3B-PH-K-S
Radio Modules
ESP32-S3-MINI-1U-N8
Extra GPIO
ESP32 USB-C Port
Strapping Pins GPIO0 GPIO3 GPIO45 GPIO46
Power/Data
(Automated Programming Port)
Mounting Holes
Boot/Reset

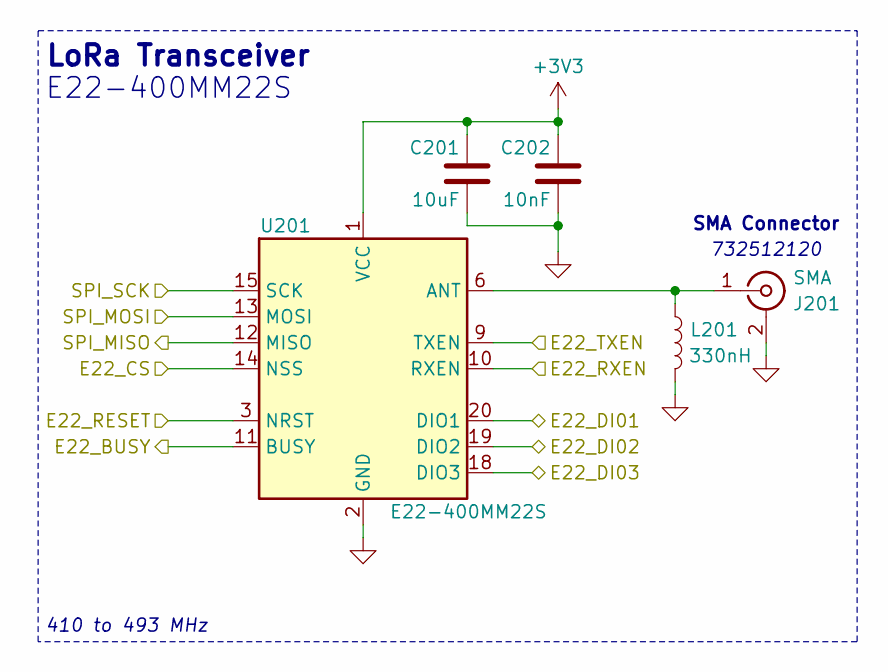
[picture p73: schematic E22.kicad_sch, Feather Duo]

Parts:
C201: 10uF; C_0603_1608Metric
C202: 10nF; C_0603_1608Metric
J201: SMA; SMA_Molex_73251-2120_EdgeMount_Horizontal
L201: 330nH; L_0603_1608Metric
U201: E22-400MM22S

Connections:
+3V3: C201.1, C202.1, U201.1 (VCC); also elsewhere on the board
/E22_BUSY_0: U201.11 (BUSY); also elsewhere on the board
/E22_CS_0: U201.14 (NSS); also elsewhere on the board
/E22_DI01_0: U201.20 (DIO1); also elsewhere on the board
/E22_DI02_0: U201.19 (DIO2); also elsewhere on the board
/E22_DI03_0: U201.18 (DIO3); also elsewhere on the board
/E22_RESET_0: U201.3 (NRST); also elsewhere on the board
/E22_RXEN_0: U201.10 (RXEN); also elsewhere on the board
/E22_TXEN_0: U201.9 (TXEN); also elsewhere on the board
/SPI_MISO_0: U201.12 (MISO); also elsewhere on the board
/SPI_MOSI_0: U201.13 (MOSI); also elsewhere on the board
/SPI_SCK_0: U201.15 (SCK); also elsewhere on the board
GND: C201.2, C202.2, J201.2 (Ext), L201.2, U201.2 (GND), U201.7 (GND), U201.16 (GND); also elsewhere on the board
unnamed: J201.1 (In), L201.1, U201.6 (ANT)

Parts of its further copies:
C301: 10uF; C_0603_1608Metric
C302: 10nF; C_0603_1608Metric
J301: SMA; SMA_Molex_73251-2120_EdgeMount_Horizontal
L301: 330nH; L_0603_1608Metric
U301: E22-400MM22S

Connections of its further copies:
+3V3: C301.1, C302.1, U301.1 (VCC); also elsewhere on the board
/E22_BUSY_1: U301.11 (BUSY); also elsewhere on the board
/E22_CS_1: U301.14 (NSS); also elsewhere on the board
/E22_DI01_1: U301.20 (DIO1); also elsewhere on the board
/E22_DI02_1: U301.19 (DIO2); also elsewhere on the board
/E22_DI03_1: U301.18 (DIO3); also elsewhere on the board
/E22_RESET_1: U301.3 (NRST); also elsewhere on the board
/E22_RXEN_1: U301.10 (RXEN); also elsewhere on the board
/E22_TXEN_1: U301.9 (TXEN); also elsewhere on the board
/SPI_MISO_1: U301.12 (MISO); also elsewhere on the board
/SPI_MOSI_1: U301.13 (MOSI); also elsewhere on the board
/SPI_SCK_1: U301.15 (SCK); also elsewhere on the board
GND: C301.2, C302.2, J301.2 (Ext), L301.2, U301.2 (GND), U301.7 (GND), U301.16 (GND); also elsewhere on the board
unnamed: J301.1 (In), L301.1, U301.6 (ANT)

Notes on the sheet:
SMA Connector
LoRa Transceiver
E22-400MM22S
410 to 493 MHz
732512120

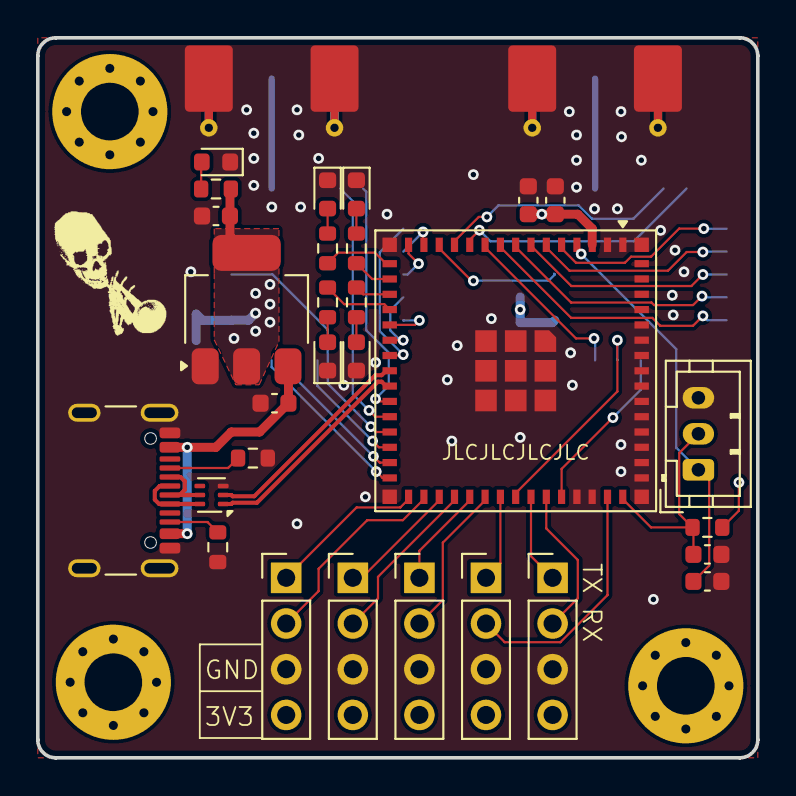
[picture p74: board Feather_Duo.kicad_pcb from above]

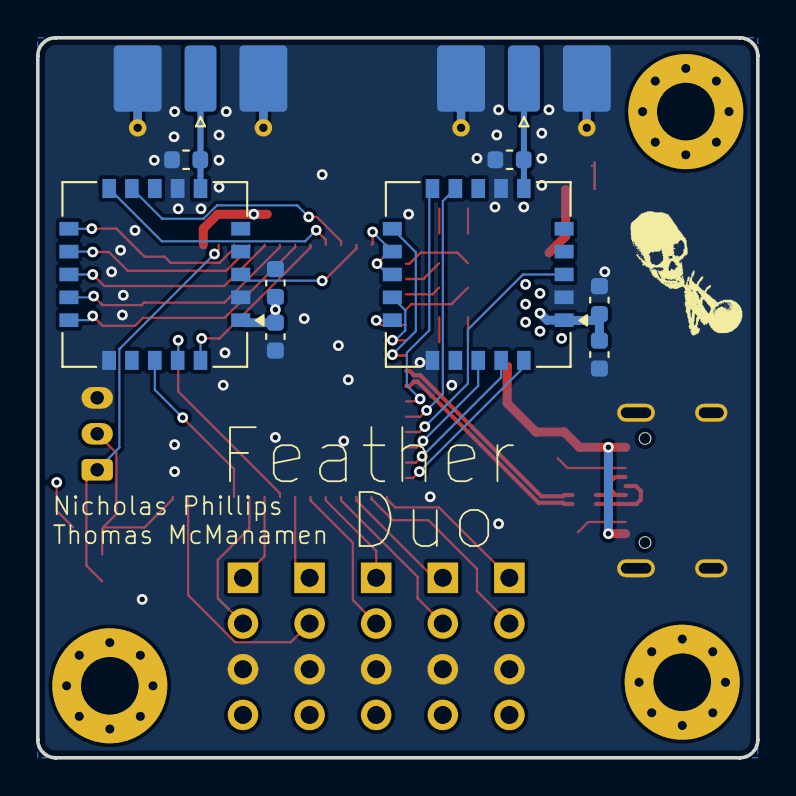
[picture p75: board Feather_Duo.kicad_pcb from below]

Board: 4 copper layers, 40.0 x 40.0 mm, 42 parts (10 on the bottom side), 54 nets.
