ISSUIUC/ISS-PCB/boards/Drone_Power/drone_power_2_screws/drone_power_2_screws.kicad_pcb

## KiCad design boards/Drone_Power/drone_power_2_screws/drone_power_2_screws.kicad_pcb (2025-09-06)

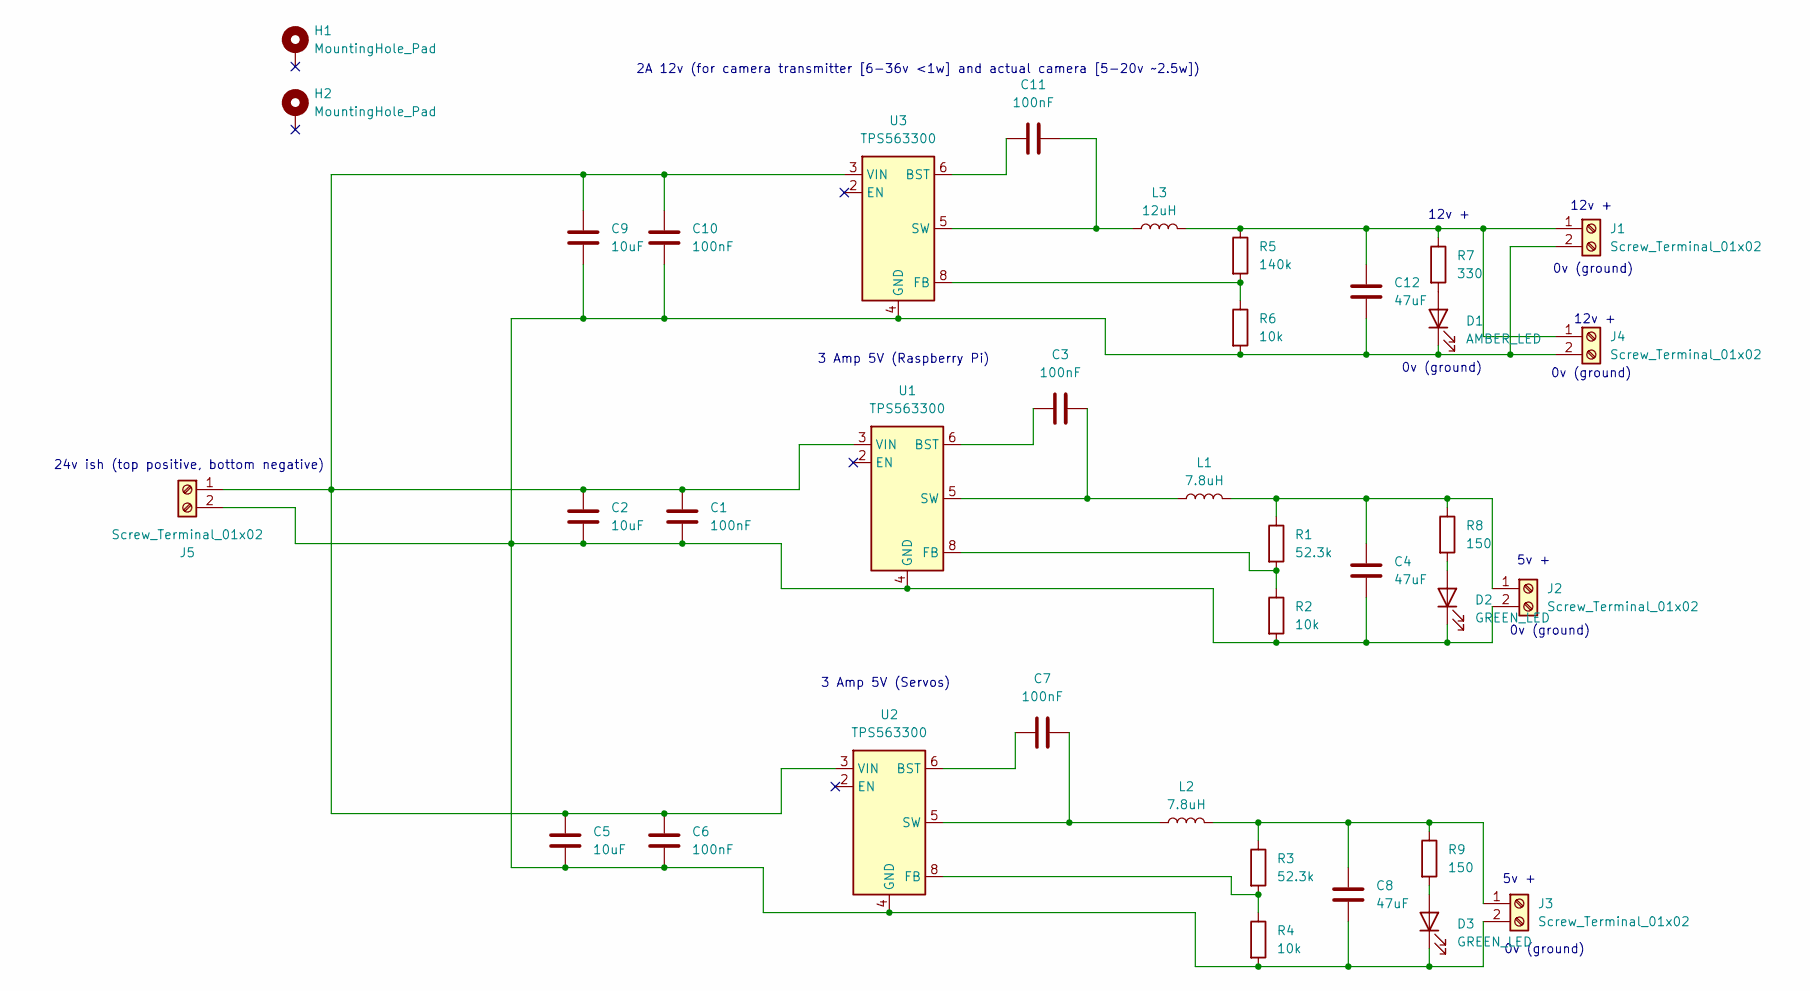
[picture p76: schematic drone_power_2_screws.kicad_sch, BORZOI]

Parts:
C1, C3, C6, C7, C10, C11: 100nF; C_0603_1608Metric
C2, C5, C9: 10uF; C_1206_3216Metric
C4, C8, C12: 47uF; C_1210_3225Metric
D1: AMBER_LED; LED_0603_1608Metric
D2, D3: GREEN_LED; LED_0603_1608Metric
H1, H2: MountingHole_Pad; MountingHole_3mm_Pad_Via
J1, J2, J3, J4, J5: Screw_Terminal_01x02; TE_282837-2
L1, L2: 7.8uH; L_Wuerth_HCI-1050
L3: 12uH; L_Coilcraft_XGL6060-XXX
R1, R3: 52.3k; R_0603_1608Metric
R2, R4, R6: 10k; R_0603_1608Metric
R5: 140k; R_0603_1608Metric
R7: 330; R_0603_1608Metric
R8, R9: 150; R_0603_1608Metric
U1, U2, U3: TPS563300; SOT-583-8

Connections:
unnamed: D1.2 (A), R7.2
unnamed: C1.2, C2.2, C4.2, C5.2, C6.2, C8.2, C9.2, C10.2, C12.2, D1.1 (K), D2.1 (K), D3.1 (K), J1.2, J2.2, J3.2, J4.2, J5.2, R2.2, R4.2, R6.2, U1.4 (GND), U2.4 (GND), U3.4 (GND)
unnamed: D2.2 (A), R8.2
unnamed: D3.2 (A), R9.2
unnamed: C12.1, J1.1, J4.1, L3.2, R5.1, R7.1
unnamed: C4.1, J2.1, L1.2, R1.1, R8.1
unnamed: C8.1, J3.1, L2.2, R3.1, R9.1
unnamed: C1.1, C2.1, C5.1, C6.1, C9.1, C10.1, J5.1, U1.3 (VIN), U2.3 (VIN), U3.3 (VIN)
unnamed: C3.1, U1.6 (BST)
unnamed: R1.2, R2.1, U1.8 (FB)
unnamed: C3.2, L1.1, U1.5 (SW)
unnamed: C7.1, U2.6 (BST)
unnamed: R3.2, R4.1, U2.8 (FB)
unnamed: C7.2, L2.1, U2.5 (SW)
unnamed: C11.1, U3.6 (BST)
unnamed: R5.2, R6.1, U3.8 (FB)
unnamed: C11.2, L3.1, U3.5 (SW)

Notes on the sheet:
0v (ground)
12v +
3 Amp 5V (Raspberry Pi)
24v ish (top positive, bottom negative)
5v +
3 Amp 5V (Servos)
2A 12v (for camera transmitter [6-36v <1w] and actual camera [5-20v ~2.5w])

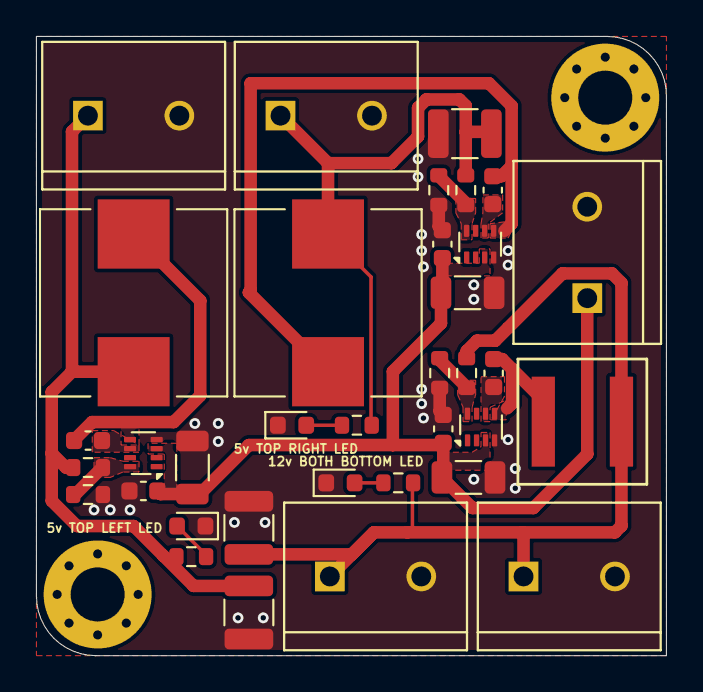
[picture p77: board drone_power_2_screws.kicad_pcb from above]

Board: 2 copper layers, 35.0 x 34.4 mm, 37 parts (0 on the bottom side), 17 nets.

Other parts of the board:
H3: MountingHole_Pad; MountingHole_3mm_Pad_Via
