ISSUIUC/ISS-PCB/boards/Drone_Power/drone_power_2_screws_V2/drone_power_2_screws_V2.kicad_pcb

## KiCad design boards/Drone_Power/drone_power_2_screws_V2/drone_power_2_screws_V2.kicad_pcb (2025-09-06)

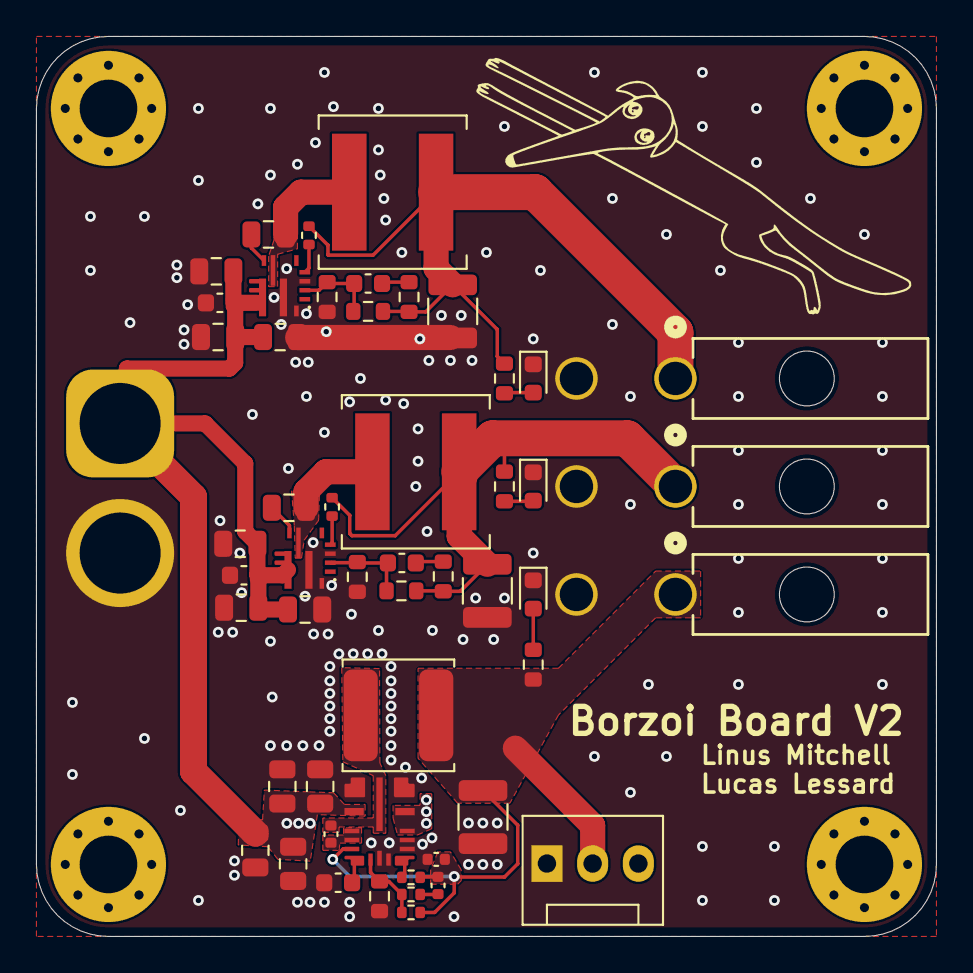
[picture p78: board drone_power_2_screws_V2.kicad_pcb from above]

Board: 4 copper layers, 50.0 x 50.0 mm, 56 parts (1 on the bottom side), 24 nets.

Parts:
BT2: Battery; AMASS_XT60-M_1x02_P7.20mm_Vertical
Cbias1: 100nF; C_0402_1005Metric
Cboot1, Cboot3: 100nF; C_0805_2012Metric
Cboot2: 100nF; C_0402_1005Metric
Cff1, Cff3: 100pF; C_0603_1608Metric
Cff2: 5.1pF; C_0402_1005Metric
Cin1, Cin2, Cin3, Cin4, Cin5, Cin6: 4.7uF; C_0805_2012Metric
Cin_1, Cin_2: 10uF; C_0805_2012Metric
Cin_x1, Cin_x2: 1uF; C_0805_2012Metric
Cinx1, Cinx2: 100nF; C_0603_1608Metric
Cout1, Cout3: 47uF; C_1210_3225Metric
Cout2: 22uF; C_1210_3225Metric
Cvcc1: 1uF; C_0603_1608Metric
D1: RED LED; LED_0603_1608Metric
D2: GREEN LED; LED_0603_1608Metric
D3: BLUE LED; LED_0603_1608Metric
H1, H2, H3, H4: MountingHole_Pad; MountingHole_3.2mm_M3_Pad_Via
J1, J2, J3: 1724480002; Molex_MiniFitJr
L1, L2: 3.3uH; L_Coilcraft_XAL7070-XXX
L3: 2.2uH; L_TDK_VLS6045EX_VLS6045AF
M1: Fan_3pin; FanPinHeader_1x03_P2.54mm_Vertical
R1, R2: 3.3k; R_0603_1608Metric
R3: 4.7k; R_0603_1608Metric
Rfbb1, Rfbb3: 10k Ohm; R_0603_1608Metric
Rfbb2: 9.09k Ohms; R_0603_1608Metric
Rfbt1, Rfbt3: 73.2k Ohm; R_0603_1608Metric
Rfbt2: 100k Ohm; R_0402_1005Metric
Rff1, Rff3: 20k Ohm; R_0603_1608Metric
Rff2: 4.99k Ohms; R_0402_1005Metric
Rpg1, Rpg2: 100k Ohm; R_0402_1005Metric
Rreset1: 100k Ohm; R_0402_1005Metric
U1, U2: TPS56637RPAR; VQFN-HR-RPA0010A
U3: LM62460RPHR; VQFN-HR-RPH0016B

Connections:
/Boot: Cboot3.1, U1.7 (BOOT)
/Boot2: Cboot1.1, U2.7 (BOOT)
/FB: Cff3.1, Rfbb3.2, Rfbt3.1, U1.2 (FB)
/FB2: Cff1.1, Rfbb1.2, Rfbt1.1, U2.2 (FB)
/G_Batt: BT2.2 (-), Cbias1.2, Cin1.2, Cin2.2, Cin3.2, Cin4.2, Cin5.2, Cin6.2, Cin_1.2, Cin_2.2, Cin_x1.2, Cin_x2.2, Cinx1.2, Cinx2.2, Cout1.1, Cout2.1, Cout3.1, Cvcc1.2, D1.1 (K), D2.1 (K), D3.1 (K), J1.2, J2.2, J3.2, M1.1 (-), Rfbb1.1, Rfbb2.1, Rfbb3.1, U1.3 (AGND), U1.9 (PGND), U1.10 (MODE), U2.3 (AGND), U2.9 (PGND), U2.10 (MODE), U3.1 (PGND), U3.8 (AGND), U3.9 (RT), U3.11 (SpSp), U3.12 (SYNC_MODE), U3.15 (PGND)
/V_Batt: BT2.1 (+), Cin1.1, Cin2.1, Cin3.1, Cin4.1, Cin5.1, Cin6.1, Cin_1.1, Cin_2.1, Cin_x1.1, Cin_x2.1, Cinx1.1, Cinx2.1, U1.8 (VIN), U2.8 (VIN), U3.2 (VIN), U3.13 (EN), U3.14 (VIN)
unnamed: Cff1.2, Rff1.1
unnamed: Cff2.2, Rff2.1
unnamed: Cff3.2, Rff3.1
unnamed: Cout1.2, J2.1, L2.2, R2.1, Rfbt1.2, Rff1.2, Rpg1.2
unnamed: Cout3.2, J1.1, L1.2, R1.1, Rfbt3.2, Rff3.2, Rpg2.2
unnamed: D1.2 (A), R1.2
unnamed: D2.2 (A), R2.2
unnamed: D3.2 (A), R3.2
unnamed: Cbias1.1, Cff2.1, Cout2.2, J3.1, L3.2, M1.2 (+), R3.1, Rfbt2.2, Rreset1.2, U3.5 (BIAS)
unnamed: Rpg2.1, U1.4 (PG)
unnamed: Cboot3.2, L1.1, U1.6 (SW)
unnamed: Rpg1.1, U2.4 (PG)
unnamed: Cboot1.2, L2.1, U2.6 (SW)
unnamed: Cboot2.2, U3.3 (RBOOT), U3.4 (CBOOT)
unnamed: Rfbb2.2, Rfbt2.1, Rff2.2, U3.7 (FB)
unnamed: Rreset1.1, U3.10 (RESET)
unnamed: Cboot2.1, L3.1, U3.16 (SW)
unnamed: Cvcc1.1, U3.6 (VCC)
