ISSUIUC/ISS-PCB/boards/CAM-MK2/CAM-MK2.1-revA/CAM-MK2.1.kicad_pcb

## KiCad design boards/CAM-MK2/CAM-MK2.1-revA/CAM-MK2.1.kicad_pcb (2025-08-13, an earlier design)

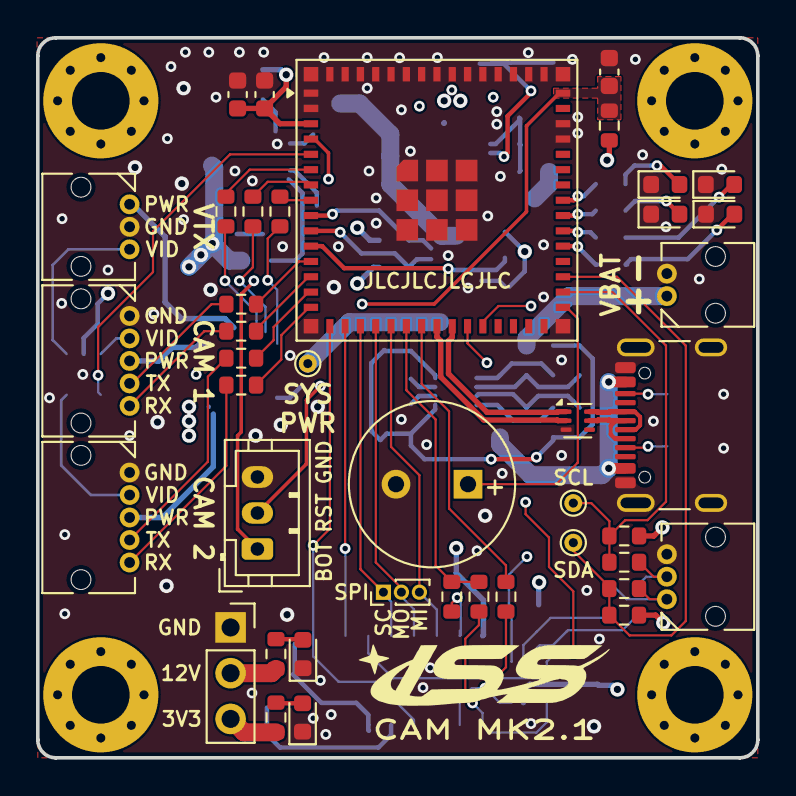
[picture p79: board CAM-MK2.1.kicad_pcb from above]

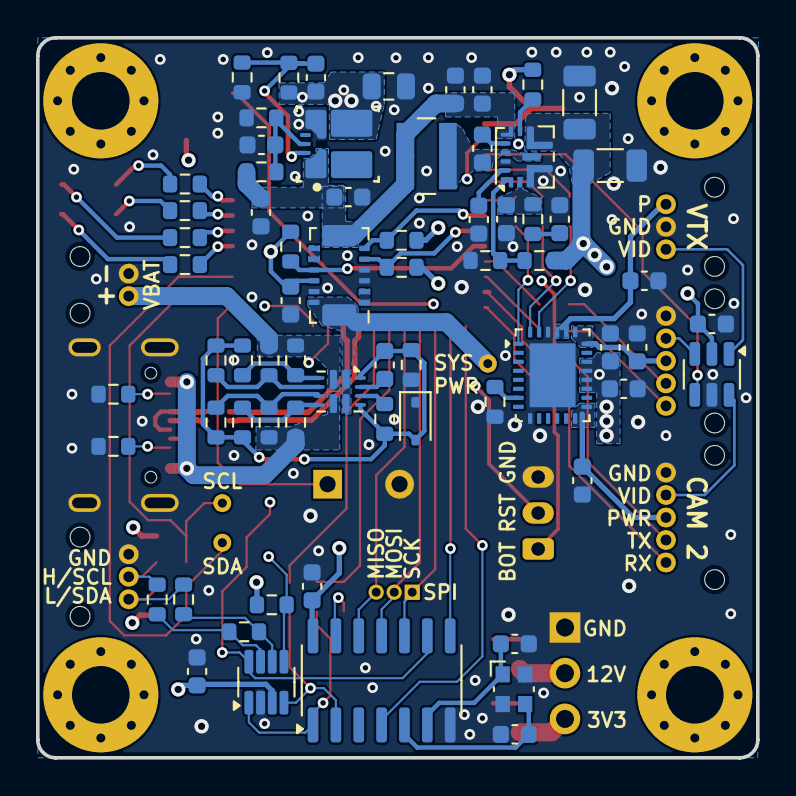
[picture p80: board CAM-MK2.1.kicad_pcb from below]

Board: 4 copper layers, 40.0 x 40.0 mm, 113 parts (68 on the bottom side), 89 nets.

Parts:
BZ101: Buzzer; MagneticBuzzer_PUI_AT-0927-TT-6-R
C101, C102, C111: 22pF; C_0603_1608Metric
C103, C104: 10uF; C_0603_1608Metric
C105, C106, C108, C110, C114, C116, C121, C123, C124, C128: 0.1uF; C_0603_1608Metric
C107: 10nF; C_0603_1608Metric
C109: 2.2uF; C_0603_1608Metric
C112: 47nF; C_0603_1608Metric
C113: 27pF; C_0603_1608Metric
C115: 33uF; C_0805_2012Metric
C117, C118: 47uF; C_1206_3216Metric
C119, C120: 1uF; C_0603_1608Metric
C122: 22uF; C_0603_1608Metric
C125, C126, C127: 22nF; C_0603_1608Metric
D101, D104: RED LED; LED_0603_1608Metric
D102, D105: ORANGE LED; LED_0603_1608Metric
D103: BAS416; D_SOD-323
D106: GREEN LED; LED_0603_1608Metric
D107: BLUE LED; LED_0603_1608Metric
H101, H102, H103, H104: MountingHole; MountingHole_3.2mm_M3_Pad_Via
J101: USB4105-GF-A; USB_C_Receptacle_GCT_USB4105-xx-A_16P_TopMnt_Horizontal
J102: 2157601002; Molex_Micro-Lock_2200980271_1x02_P1.25mm_Horizontal
J103, J105: Conn_01x03; Molex_Micro-Lock_2200980371_1x03_P1.25mm_Horizontal
J104, J106: Conn_01x05; Molex_Micro-Lock_2200980571_1x05_P1.25mm_Horizontal
J107: Conn_01x03; JST_PH_B3B-PH-K_1x03_P2.00mm_Vertical
J108: Conn_01x03; PinSocket_1x03_P2.54mm_Vertical
J109: Conn_01x03; PinHeader_1x03_P1.00mm_Vertical
L101: 4.7uH; L_Wuerth_MAPI-4030
R101: 22.1k; R_0603_1608Metric
R102, R103, R104, R108, R116, R123, R124, R126, R128, R130, R147, R149: 10k; R_0603_1608Metric
R105, R106: 5.1k; R_0603_1608Metric
R107: 14.3k; R_0603_1608Metric
R109: 135k; R_0603_1608Metric
R110: 30k; R_0603_1608Metric
R111: 931k; R_0603_1608Metric
R112: 48.7k; R_0603_1608Metric
R113, R141, R142, R143, R144: 470; R_0603_1608Metric
R114: 120; R_0603_1608Metric
R115: 3.3k; R_0603_1608Metric
R117, R122: 4.7k; R_0603_1608Metric
R118, R119, R120, R121, R131, R137, R138, R139: 0; R_0603_1608Metric
R125, R136: 36k; R_0603_1608Metric
R127: 12k; R_0603_1608Metric
R129: 75k; R_0603_1608Metric
R132, R133, R134, R135: 220; R_0603_1608Metric
R140: 20k; R_0603_1608Metric
R145, R146: 2.2k; R_0603_1608Metric
R148: 680; R_0603_1608Metric
TP101, TP102, TP103: TestPoint; TestPoint_THTPad_D1.0mm_Drill0.5mm
U101: ECMF02-2AMX6; ST_UQFN-6L_1.5x1.7mm_P0.5mm
U102: MCP2518FDT-xSL; SOIC-14_3.9x8.7mm_P1.27mm
U103: TPSM863252; QFN-FCMOD-RDX0007A
U104: TPS61288; Texas_VQFN-HR-20_3x2.5mm_P0.5mm_RQQ0011A
U105: TCAN337G; SOT-23-8
U106: INA745x; VQFN-REL0014B
U107: ADG752BRT; SOT-23-6
U108: TPS2121; Texas_VQFN-HR-12_2x2.5mm_P0.5mm
U109: ESP32-S3-MINI-1U; ESP32-S2-MINI-1U
U111: TPS274160B; WQFN-RLH0028A
Y101: 40MHz; Crystal_SMD_Abracon_ABM10-4Pin_2.5x2.0mm

Connections:
+3V3: C110.2, C111.1, C114.1, C115.1, C116.2, C121.1, C122.1, C128.1, J108.3, R108.1, R109.1, R113.1, R116.1, R117.1, R122.1, R140.2, R145.2, R146.1, R149.1, U102.14 (VDD), U103.3 (VOUT), U105.3 (VCC), U106.11 (VS), U107.2 (VDD), U109.3 (3V3)
+12V: C117.1, C118.1, C123.1, C124.1, J108.2, R111.1, R115.1, U104.5 (VOUT), U111.17 (VS), U111.18 (VS), U111.19 (VS), U111.20 (VS)
/BOOT_SW: J107.1, U109.4 (IO0)
/BUZZER: BZ101.1 (-), U109.31 (IO35)
/CAM_1_POW: C126.1, J104.3, U111.22 (OUT2), U111.23 (OUT2)
/CAM_2_POW: C125.1, J106.3, U111.14 (OUT3), U111.15 (OUT3)
/CANH: R114.2, R120.1, U105.7 (CANH)
/CANL: R114.1, R118.1, U105.6 (CANL)
/CAN_1: R137.1, R138.1, U109.21 (IO17)
/CAN_2: R139.1, U109.22 (IO18)
/CAN_FAULT: R108.2, U105.5 (FAULT), U109.26 (IO26)
/CAN_NCS: R137.2, U102.13 (NCS)
/CAN_NINT: U102.4 (~INT), U109.16 (IO12)
/CAN_NINT1: U102.8 (~INT1/GPIO1), U109.17 (IO13)
/CAN_RXD: R139.2, U102.2 (RXCAN), U105.4 (RXD)
/CAN_SLNT: U102.9 (~INT0/GPIO0/XSTBY), U105.8 (S), U109.25 (IO21)
/CAN_TXD: R138.2, U102.1 (TXCAN), U105.1 (TXD)
/D+: J101.A6 (D+), J101.B6 (D+), U101.6 (D+_out)
/D-: J101.A7 (D-), J101.B7 (D-), U101.5 (D-_out)
/LED_BLUE: R144.1, U109.35 (IO39)
/LED_GREEN: R143.1, U109.36 (IO40)
/LED_ORANGE: R142.1, U109.37 (IO41)
/LED_RED: R141.1, U109.38 (IO42)
/ON_OFF_1: R104.1, U109.7 (IO3)
/ON_OFF_2: R147.1, U109.8 (IO4)
/ON_OFF_VTX: R103.1, U109.6 (IO2)
/RESET_SW: C120.1, J107.2, R140.1, U109.45 (EN)
/RX_1: R132.2, U109.13 (IO9)
/RX_2: R134.2, U109.15 (IO11)
/SCL: R121.1, R146.2, TP102.1, U109.32 (IO36)
/SDA: R119.1, R145.1, TP103.1, U109.33 (IO37)
/SENSE_ALERT: R116.2, U106.10 (ALERT), U109.11 (IO7)
/SENSE_SCL: R122.2, U106.6 (SCL), U109.9 (IO5)
/SENSE_SDA: R117.2, U106.5 (SDA), U109.10 (IO6)
/SPI_MISO: J109.3, U102.12 (SDO), U109.20 (IO16)
/SPI_MOSI: J109.2, U102.11 (SDI), U109.19 (IO15)
/SPI_SCK: J109.1, U102.10 (SCK), U109.18 (IO14)
/SYS_POWER: TP101.1, U106.13 (VBUS), U106.14 (IS+), U108.1 (OUT), U108.8 (OUT)
/TX_1: R133.2, U109.12 (IO8)
/TX_2: R135.2, U109.14 (IO10)
/USB_D+: U101.1 (D+_in), U109.24 (IO20)
/USB_D-: U101.2 (D-_in), U109.23 (IO19)
/USB_POWER: J101.A4 (VBUS), J101.A9 (VBUS), J101.B4 (VBUS), J101.B9 (VBUS), R123.1, R125.1, U108.7 (IN1)
/VBAT: J102.1, R127.1, R129.1, U108.2 (IN2)
/VIDEO_1: J104.2, U107.3 (S1)
/VIDEO_2: J106.2, U107.6 (S2)
/VIDEO_OUT: J105.3, U107.1 (D)
/VIDEO_SELECT: U107.4 (IN), U109.5 (IO1)
/VREG_IN: C103.1, C104.1, C105.1, C106.1, L101.1, R101.1, U103.1 (VIN), U104.7 (VIN), U106.7 (IS-)
/VTX_POW: C127.1, J105.1, U111.24 (OUT1), U111.25 (OUT1)
GND: BZ101.2 (+), C101.1, C102.2, C103.2, C104.2, C105.2, C106.2, C107.2, C109.2, C110.1, C112.2, C113.2, C114.2, C115.2, C116.1, C117.2, C118.2, C120.2, C121.2, C122.2, C123.2, C124.2, C125.2, C126.2, C127.2, C128.2, D101.1 (K), D102.1 (K), D103.1 (K), D104.1 (K), D105.1 (K), D106.1 (K), D107.1 (K), J101.A1 (GND), J101.A12 (GND), J101.B1 (GND), J101.B12 (GND), J101.S1 (SHIELD), J102.2, J103.3, J104.1, J105.2, J106.1, J107.3, J108.1, R102.2, R105.1, R106.1, R110.2, R112.2, R131.2, R148.2, U101.3 (GND), U102.7 (VSS), U103.4 (PGND), U104.3 (PGND), U104.10 (AGND), U105.2 (GND), U106.3 (A1), U106.4 (A0), U106.12 (GND), U107.5 (GND), U109.1 (GND), U109.2 (GND), U109.42 (GND), U109.43 (GND), U109.46 (GND), U109.47 (GND), U109.48 (GND), U109.49 (GND), U109.50 (GND), U109.51 (GND), U109.52 (GND), U109.53 (GND), U109.54 (GND), U109.55 (GND), U109.56 (GND), U109.57 (GND), U109.58 (GND), U109.59 (GND), U109.60 (GND), U109.61 (GND), U109.62 (GND), U109.63 (GND), U109.64 (GND), U109.65 (GND), U111.9 (GND), U111.26 (GND), U111.29 (PowerPAD), Y101.2, Y101.4
unnamed: C108.1, L101.2, U104.4 (SW), U104.9 (SW)
unnamed: C112.1, R107.2
unnamed: D101.2 (A), R113.2
unnamed: D102.2 (A), R115.2
unnamed: C119.1, D103.2 (A), R124.2, R126.2, R128.2, R130.2, R131.1, R136.1, U108.9 (ST), U108.12 (GND)
unnamed: D104.2 (A), R141.2
unnamed: D105.2 (A), R142.2
unnamed: D106.2 (A), R143.2
unnamed: D107.2 (A), R144.2
unnamed: J101.A5 (CC1), R105.2
unnamed: J101.B5 (CC2), R106.2
unnamed: J103.1, R118.2, R119.2
unnamed: J103.2, R120.2, R121.2
unnamed: J104.4, R133.1
unnamed: J104.5, R132.1
unnamed: J106.4, R135.1
unnamed: J106.5, R134.1
unnamed: C102.1, U102.6 (OSC1), Y101.1
unnamed: C101.2, U102.5 (OSC2), Y101.3
unnamed: C107.1, R101.2, R102.1, U103.6 (EN)
unnamed: C111.2, R109.2, R110.1, U103.7 (FB)
unnamed: C108.2, U104.8 (BST)
unnamed: C113.1, R107.1, U104.2 (COMP)
unnamed: R149.2, U104.6 (EN)
unnamed: R111.2, R112.1, U104.1 (FB)
unnamed: C109.1, U104.11 (VCC)
unnamed: U106.1 (SH+), U106.2 (IN+)
unnamed: U106.8 (SH-), U106.9 (IN-)
unnamed: R127.2, R128.1, U108.3 (CP2)
unnamed: R136.2, U108.10 (ILM)
unnamed: R125.2, R126.1, U108.5 (OV1)
unnamed: R129.2, R130.1, U108.4 (OV2)
unnamed: R123.2, R124.1, U108.6 (PR1)
unnamed: C119.2, U108.11 (SS)
unnamed: R148.1, U111.7 (CL)
unnamed: R103.2, U111.27 (EN1)
unnamed: R104.2, U111.28 (EN2)
unnamed: R147.2, U111.1 (EN3)
