ISSUIUC/ISS-PCB/boards/Motor-MK1/Motor-MK1.kicad_pcb

## KiCad design boards/Motor-MK1/Motor-MK1.kicad_pcb (2025-06-27)

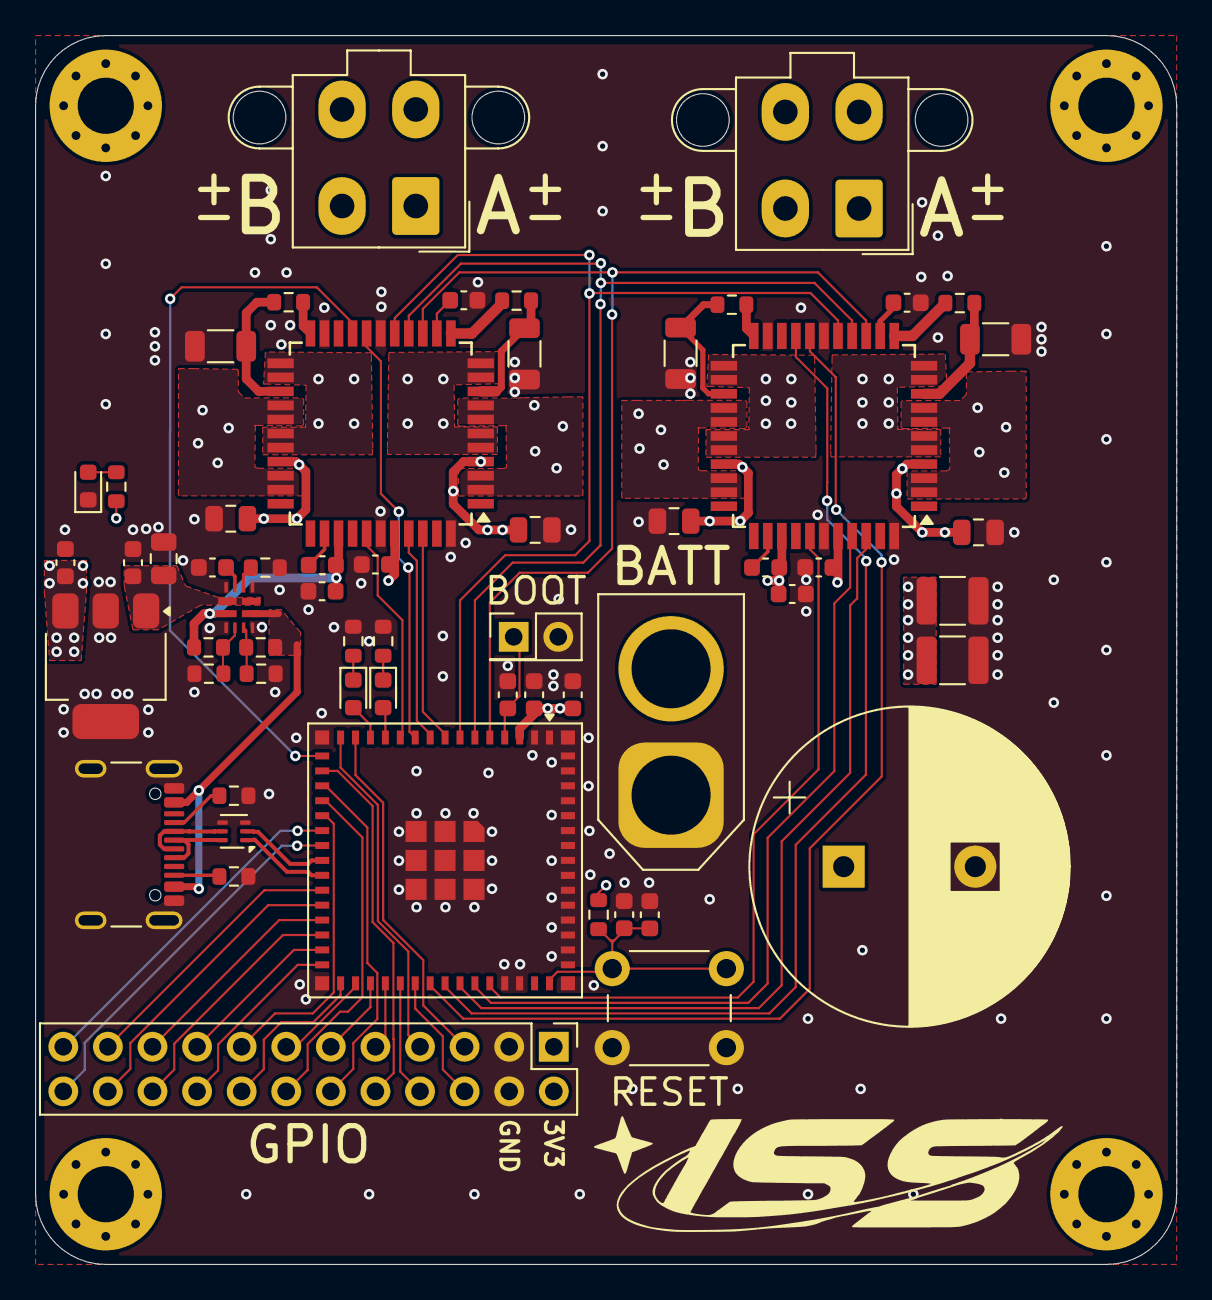
[picture p81: board Motor-MK1.kicad_pcb from above]

Board: 4 copper layers, 65.0 x 70.0 mm, 63 parts (0 on the bottom side), 75 nets.

Parts:
C1, C6: 470nF; C_0603_1608Metric
C2: 1200uF; CP_Radial_D18.0mm_P7.50mm
C3, C4: 100uF; C_1210_3225Metric
C5, C11, C13, C14, C16: 10uF; C_0805_2012Metric
C7, C9, C10, C12, C18, C102, C103, C104: 100nF; C_0603_1608Metric
C8, C15: 220nF; C_0603_1608Metric
C17, C101: 22uF; C_0603_1608Metric
C105, C206: 1uF; C_0603_1608Metric
D1, D2: LED; LED_0603_1608Metric
D201: RED LED; LED_0603_1608Metric
H1, H2, H3, H4: MountingHole; MountingHole_3.2mm_M3_Pad_Via
J1, J2: Conn_01x04; Molex_Mini-Fit_Jr_5566-04A2_2x02_P4.20mm_Vertical
J3: Conn_02x12_Counter_Clockwise; PinHeader_2x12_P2.54mm_Vertical
J4: Conn_01x02; AMASS_XT60-M_1x02_P7.20mm_Vertical
J101: USB_C_Receptacle_USB2.0_16P; USB_C_Receptacle_GCT_USB4105-xx-A_16P_TopMnt_Horizontal
R1, R3, R5, R6: 10; R_0603_1608Metric
R2, R4, R7, R8: 0.075; R_1206_3216Metric
R9, R10: 470; R_0603_1608Metric
R11: 23.7k; R_0603_1608Metric
R12: 5k; R_0603_1608Metric
R13: 30k; R_0603_1608Metric
R14: 1k; R_0603_1608Metric
R101: 100k; R_0603_1608Metric
R102, R103: 5.1k; R_0603_1608Metric
R201: 470 ohms; R_0603_1608Metric
R214: 20k; R_0603_1608Metric
SW101: SW_Push; PinHeader_2x01_P2.54mm_Vertical
SW102: SW_Push; SW_PUSH_6mm
U1: ESP32-S3-MINI-1U; ESP32-S2-MINI-1U
U2, U3: TMC2660C; TQFP-44_10x10mm_P0.8mm
U4: TLE42744; SOT-223
U102: ECMF02-2AMX6; ST_UQFN-6L_1.5x1.7mm_P0.5mm
U203: TPS2121; VQFN-HR-RUX0012A

Connections:
+3V3: C7.2, C9.2, C17.1, C101.2, C102.2, J3.1, J3.2, R101.1, R201.1, U1.3 (3V3), U2.40 (VCC_IO), U3.40 (VCC_IO), U4.3 (Q)
/D+: J101.A6 (D+), J101.B6 (D+), U102.6 (D+_out)
/D-: J101.A7 (D-), J101.B7 (D-), U102.5 (D-_out)
/DIR_0: U1.9 (IO5), U2.41 (DIR)
/DIR_1: U1.40 (RXD0), U3.41 (DIR)
/GPIO_10: J3.5, U1.14 (IO10)
/GPIO_11: J3.7, U1.15 (IO11)
/GPIO_13: J3.10, U1.17 (IO13)
/GPIO_14: J3.12, U1.18 (IO14)
/GPIO_15: J3.14, U1.19 (IO15)
/GPIO_16: J3.15, U1.20 (IO16)
/GPIO_17: J3.23, U1.21 (IO17)
/GPIO_18: J3.24, U1.22 (IO18)
/GPIO_21: J3.21, U1.25 (IO21)
/GPIO_26: J3.22, U1.26 (IO26)
/GPIO_33: J3.20, U1.28 (IO33)
/GPIO_34: J3.17, U1.29 (IO34)
/GPIO_35: J3.16, U1.31 (IO35)
/GPIO_36: J3.13, U1.32 (IO36)
/GPIO_37: J3.11, U1.33 (IO37)
/GPIO_38: J3.9, U1.34 (IO38)
/GPIO_39: J3.8, U1.35 (IO39)
/GPIO_40: J3.6, U1.36 (IO40)
/GPIO_47: J3.19, U1.27 (IO47)
/GPIO_48: J3.18, U1.30 (IO48)
/Power/SYS_Power: C16.1, C18.1, U4.1 (I), U203.1 (OUT), U203.8 (OUT)
/SCK: U1.7 (IO3), U2.16 (SCK), U3.16 (SCK)
/SDI: U1.6 (IO2), U2.15 (SDI), U3.15 (SDI)
/SDO: U1.5 (IO1), U2.14 (SDO), U3.14 (SDO)
/SG_TST_0: U1.11 (IO7), U2.38 (SG_TST)
/SG_TST_1: U1.41 (IO45), U3.38 (SG_TST)
/STEP_0: U1.8 (IO4), U2.42 (STEP)
/STEP_1: U1.39 (TXD0), U3.42 (STEP)
/USB_POWER: J101.A4 (VBUS), J101.A9 (VBUS), J101.B4 (VBUS), J101.B9 (VBUS), R11.1, U203.7 (IN1)
/VBAT: C2.1, C3.1, C4.1, C5.1, C8.1, C10.1, C11.1, C12.1, C13.1, C14.1, C15.1, J4.2, R13.1, U2.4 (VSA), U2.30 (VSB), U2.36 (VS), U3.4 (VSA), U3.30 (VSB), U3.36 (VS), U203.2 (IN2)
/~CS_0: U1.10 (IO6), U2.18 (~CS)
/~CS_1: U1.37 (IO41), U3.18 (~CS)
/~EN_0: U1.16 (IO12), U2.19 (~EN)
/~EN_1: U1.38 (IO42), U3.19 (~EN)
BOOT_SW: C103.1, SW101.1, U1.4 (IO0)
GND: C1.2, C2.2, C3.2, C4.2, C5.2, C6.2, C7.1, C9.1, C10.2, C11.2, C12.2, C13.2, C14.2, C16.2, C17.2, C18.2, C101.1, C102.1, C103.2, C104.2, C105.2, C206.2, D201.1 (K), J3.3, J3.4, J4.1, J101.A1 (GND), J101.A12 (GND), J101.B1 (GND), J101.B12 (GND), J101.S1 (SHIELD), R2.2, R4.2, R7.2, R8.2, R9.2, R10.2, R12.2, R14.2, R102.2, R103.2, R214.2, SW101.2, SW102.2, U1.1 (GND), U1.2 (GND), U1.42 (GND), U1.43 (GND), U1.46 (GND), U1.47 (GND), U1.48 (GND), U1.49 (GND), U1.50 (GND), U1.51 (GND), U1.52 (GND), U1.53 (GND), U1.54 (GND), U1.55 (GND), U1.56 (GND), U1.57 (GND), U1.58 (GND), U1.59 (GND), U1.60 (GND), U1.61 (GND), U1.62 (GND), U1.63 (GND), U1.64 (GND), U1.65 (GND), U2.17 (GND), U2.21 (CLK), U2.39 (GND), U2.44 (GND), U3.17 (GND), U3.21 (CLK), U3.39 (GND), U3.44 (GND), U4.2 (GND), U4.4 (GND), U102.3 (GND), U102.4 (NC), U203.3 (CP2), U203.6 (PR1), U203.9 (ST), U203.12 (GND)
unnamed: D1.2 (A), U1.13 (IO9)
unnamed: D1.1 (K), R9.1
unnamed: D2.2 (A), U1.12 (IO8)
unnamed: D2.1 (K), R10.1
unnamed: D201.2 (A), R201.2
unnamed: J1.1, U2.5 (OA2), U2.6 (OA2), U2.10 (OA2), U2.11 (OA2)
unnamed: J1.2, U2.23 (OB2), U2.24 (OB2), U2.28 (OB2), U2.29 (OB2)
unnamed: J1.3, U2.2 (OA1), U2.3 (OA1), U2.7 (OA1), U2.8 (OA1)
unnamed: J1.4, U2.26 (OB1), U2.27 (OB1), U2.31 (OB1), U2.32 (OB1)
unnamed: J2.1, U3.5 (OA2), U3.6 (OA2), U3.10 (OA2), U3.11 (OA2)
unnamed: J2.2, U3.23 (OB2), U3.24 (OB2), U3.28 (OB2), U3.29 (OB2)
unnamed: J2.3, U3.2 (OA1), U3.3 (OA1), U3.7 (OA1), U3.8 (OA1)
unnamed: J2.4, U3.26 (OB1), U3.27 (OB1), U3.31 (OB1), U3.32 (OB1)
unnamed: J101.A5 (CC1), R102.1
unnamed: J101.B5 (CC2), R103.1
unnamed: C1.1, U2.13 (5VOUT)
unnamed: R1.2, R2.1, U2.9 (BRA)
unnamed: R3.2, R4.1, U2.25 (BRB)
unnamed: R1.1, U2.12 (SRA)
unnamed: R3.1, U2.22 (SRB)
unnamed: C8.2, U2.35 (VHS)
unnamed: C6.1, U3.13 (5VOUT)
unnamed: R5.2, R7.1, U3.9 (BRA)
unnamed: R6.2, R8.1, U3.25 (BRB)
unnamed: R5.1, U3.12 (SRA)
unnamed: R6.1, U3.22 (SRB)
unnamed: C15.2, U3.35 (VHS)
unnamed: R214.1, U203.10 (ILM)
unnamed: R11.2, R12.1, U203.5 (OV1)
unnamed: R13.2, R14.1, U203.4 (OV2)
unnamed: C206.1, U203.11 (SS)
RESET_SW: C104.1, C105.1, R101.2, SW102.1, U1.45 (EN)
USB+: U1.24 (IO20), U102.1 (D+_in)
USB-: U1.23 (IO19), U102.2 (D-_in)
