ISSUIUC/ISS-PCB/boards/SPARK-MK1/SPARK-MK1.kicad_pcb

## KiCad design boards/SPARK-MK1/SPARK-MK1.kicad_pcb (2024-11-04)

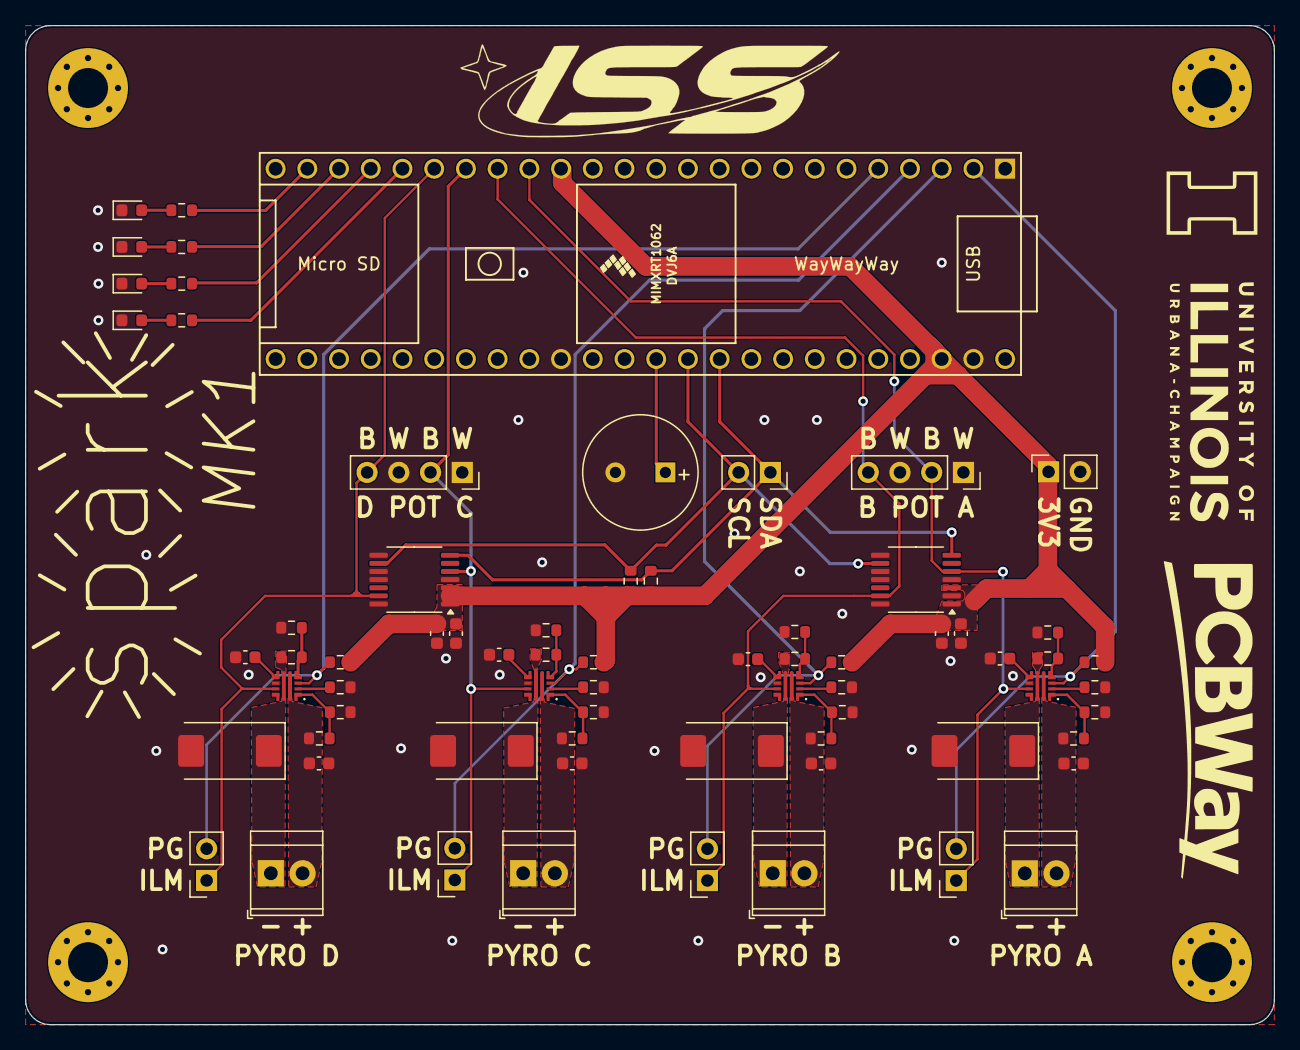
[picture p82: board SPARK-MK1.kicad_pcb from above]

Board: 2 copper layers, 100.0 x 80.0 mm, 74 parts (0 on the bottom side), 45 nets.

Parts:
BZ101: Buzzer; MagneticBuzzer_PUI_AT-0927-TT-6-R
C101, C103, C105, C106, C107, C108: 1uF; C_0603_1608Metric
C102, C104: 100nF; C_0603_1608Metric
C109, C110, C111, C112: 5.1nF; C_0603_1608Metric
C113, C114, C115, C116: 470uF; CP_EIA-7343-43_Kemet-X
D101: RED LED; LED_0603_1608Metric
D102: ORANGE LED; LED_0603_1608Metric
D103: GREEN LED; LED_0603_1608Metric
D104: BLUE LED; LED_0603_1608Metric
H101, H102, H103, H104: M3; MountingHole_3.2mm_M3_Pad_Via
J101, J102: Conn_01x04; PinSocket_1x04_P2.54mm_Vertical
J103, J104, J105, J106: Screw_Terminal_01x02; TerminalBlock_TE_282834-2_1x02_P2.54mm_Horizontal
J107, J108, J109, J110, J111, J112: Conn_01x02; PinSocket_1x02_P2.54mm_Vertical
R101, R102: 4.12k; R_0603_1608Metric
R103, R104, R105, R106: 470; R_0603_1608Metric
R107, R108, R109, R110, R127, R128, R129, R130: 470k; R_0603_1608Metric
R111, R112, R113, R114: 105k; R_0603_1608Metric
R115, R116, R117, R118: 390k; R_0603_1608Metric
R119, R120, R121, R122: 47k; R_0603_1608Metric
R123, R124, R125, R126: 120k; R_0603_1608Metric
U101, U103: AD5252; TSSOP-14_4.4x5mm_P0.65mm
U102: Teensy4.1_bare; Teensy41_bare_pins
U104, U105, U106, U107: TPS25947; VQFN-HR-RPW0010A

Connections:
+3V3: C101.1, C102.1, C103.1, C104.1, J112.1, R101.2, R102.2, R119.2, R120.2, R121.2, R122.2, U101.1 (VDD), U101.3 (~WP), U102.15 (3V3), U102.46 (3V3), U103.1 (VDD), U103.2 (AD0), U103.3 (~WP)
/B1_A: J101.2, J108.1, U101.5 (B1), U102.16 (24_A10_TX6_SCL2), U104.9 (ILM)
/B1_B: J102.2, J110.1, U102.18 (26_A12_MOSI1), U103.5 (B1), U106.9 (ILM)
/B3_A: J101.4, J109.1, U101.13 (B3), U102.17 (25_A11_RX6_SDA2), U105.9 (ILM)
/B3_B: J102.4, J111.1, U102.19 (27_A13_SCK1), U103.13 (B3), U107.9 (ILM)
/BUZZER: BZ101.1 (-), U102.37 (15_A1_RX3_SPDIF_IN)
/DVDT_6V_A: C109.1, U104.7 (DVDT)
/DVDT_6V_B: C110.1, U105.7 (DVDT)
/DVDT_6V_C: C111.1, U106.7 (DVDT)
/DVDT_6V_D: C112.1, U107.7 (DVDT)
/I2C_SCL: J107.2, R102.1, U101.9 (SCL), U102.38 (16_A2_RX4_SCL1), U103.9 (SCL)
/I2C_SDA: J107.1, R101.1, U101.7 (SDA), U102.39 (17_A3_TX4_SDA1), U103.7 (SDA)
/LED_BLUE: R106.1, U102.23 (31_CTX3)
/LED_GREEN: R105.1, U102.22 (30_CRX3)
/LED_ORANGE: R104.1, U102.21 (29_TX7)
/LED_RED: R103.1, U102.20 (28_RX7)
/OVLO_6V_A: R115.1, U104.2 (OVLO/OVCSEL)
/OVLO_6V_B: R116.1, U105.2 (OVLO/OVCSEL)
/OVLO_6V_C: R117.1, U106.2 (OVLO/OVCSEL)
/OVLO_6V_D: R118.1, U107.2 (OVLO/OVCSEL)
/PGTH_6V_A: R123.1, R127.1, U104.4 (PGTH/NFLT)
/PGTH_6V_B: R124.1, R128.1, U105.4 (PGTH/NFLT)
/PGTH_6V_C: R125.1, R129.1, U106.4 (PGTH/NFLT)
/PGTH_6V_D: R126.1, R130.1, U107.4 (PGTH/NFLT)
/PG_EF_A: J108.2, R119.1, U102.2 (0_RX1_CRX2_CS1), U104.3 (PG/AUXOFF)
/PG_EF_B: J109.2, R120.1, U102.3 (1_TX1_CTX2_MISO1), U105.3 (PG/AUXOFF)
/PG_EF_C: J110.2, R121.1, U102.4 (2_OUT2), U106.3 (PG/AUXOFF)
/PG_EF_D: J111.2, R122.1, U102.5 (3_LRCLK2), U107.3 (PG/AUXOFF)
/PYRO_A: C105.1, J103.2, R107.1, U104.5 (IN)
/PYRO_A_OUT: C113.1, J103.1, R127.2, U104.6 (OUT)
/PYRO_B: C106.1, J104.2, R108.1, U105.5 (IN)
/PYRO_B_OUT: C114.1, J104.1, R128.2, U105.6 (OUT)
/PYRO_C: C107.1, J105.2, R109.1, U106.5 (IN)
/PYRO_C_OUT: C115.1, J105.1, R129.2, U106.6 (OUT)
/PYRO_D: C108.1, J106.2, R110.1, U107.5 (IN)
/PYRO_D_OUT: C116.1, J106.1, R130.2, U107.6 (OUT)
/UVLO_6V_A: R107.2, R111.1, U104.1 (EN/UVLO)
/UVLO_6V_B: R108.2, R112.1, U105.1 (EN/UVLO)
/UVLO_6V_C: R109.2, R113.1, U106.1 (EN/UVLO)
/UVLO_6V_D: R110.2, R114.1, U107.1 (EN/UVLO)
GND: BZ101.2 (+), C101.2, C102.2, C103.2, C104.2, C105.2, C106.2, C107.2, C108.2, C109.2, C110.2, C111.2, C112.2, C113.2, C114.2, C115.2, C116.2, D101.1 (K), D102.1 (K), D103.1 (K), D104.1 (K), J101.1, J101.3, J102.1, J102.3, J112.2, R111.2, R112.2, R113.2, R114.2, R115.2, R116.2, R117.2, R118.2, R123.2, R124.2, R125.2, R126.2, U101.2 (AD0), U101.4 (W1), U101.8 (VSS), U101.10 (DGND), U101.11 (AD1), U101.14 (W3), U102.1 (GND), U102.34 (GND), U102.47 (GND), U103.4 (W1), U103.8 (VSS), U103.10 (DGND), U103.11 (AD1), U103.14 (W3), U104.8 (GND), U105.8 (GND), U106.8 (GND), U107.8 (GND)
unnamed: D101.2 (A), R103.2
unnamed: D102.2 (A), R104.2
unnamed: D103.2 (A), R105.2
unnamed: D104.2 (A), R106.2
