ISSUIUC/ISS-PCB/boards/MIDAS-MK1/MIDAS-MK1.1-revB/MIDAS-MK1.1.kicad_pcb

## KiCad design boards/MIDAS-MK1/MIDAS-MK1.1-revB/MIDAS-MK1.1.kicad_pcb (2024-09-16, an earlier design)

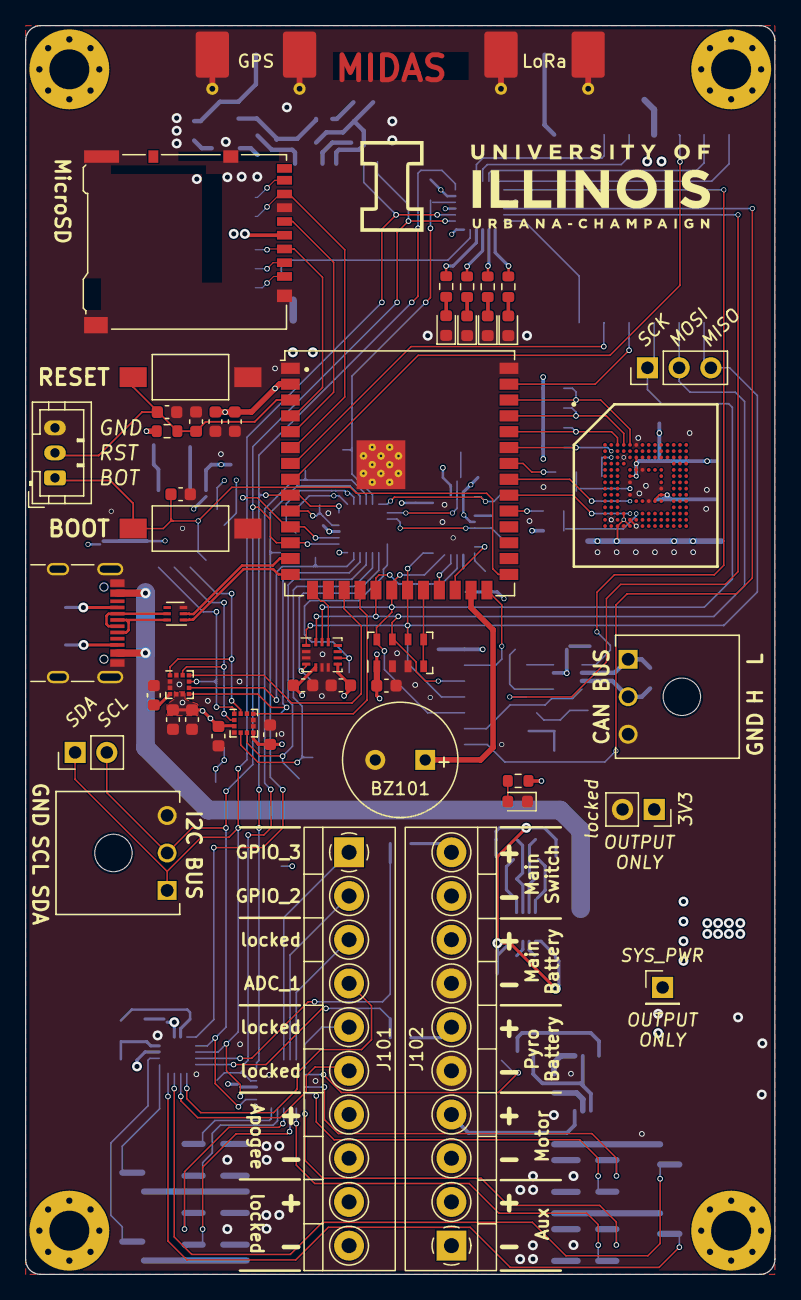
[picture p83: board MIDAS-MK1.1.kicad_pcb from above]

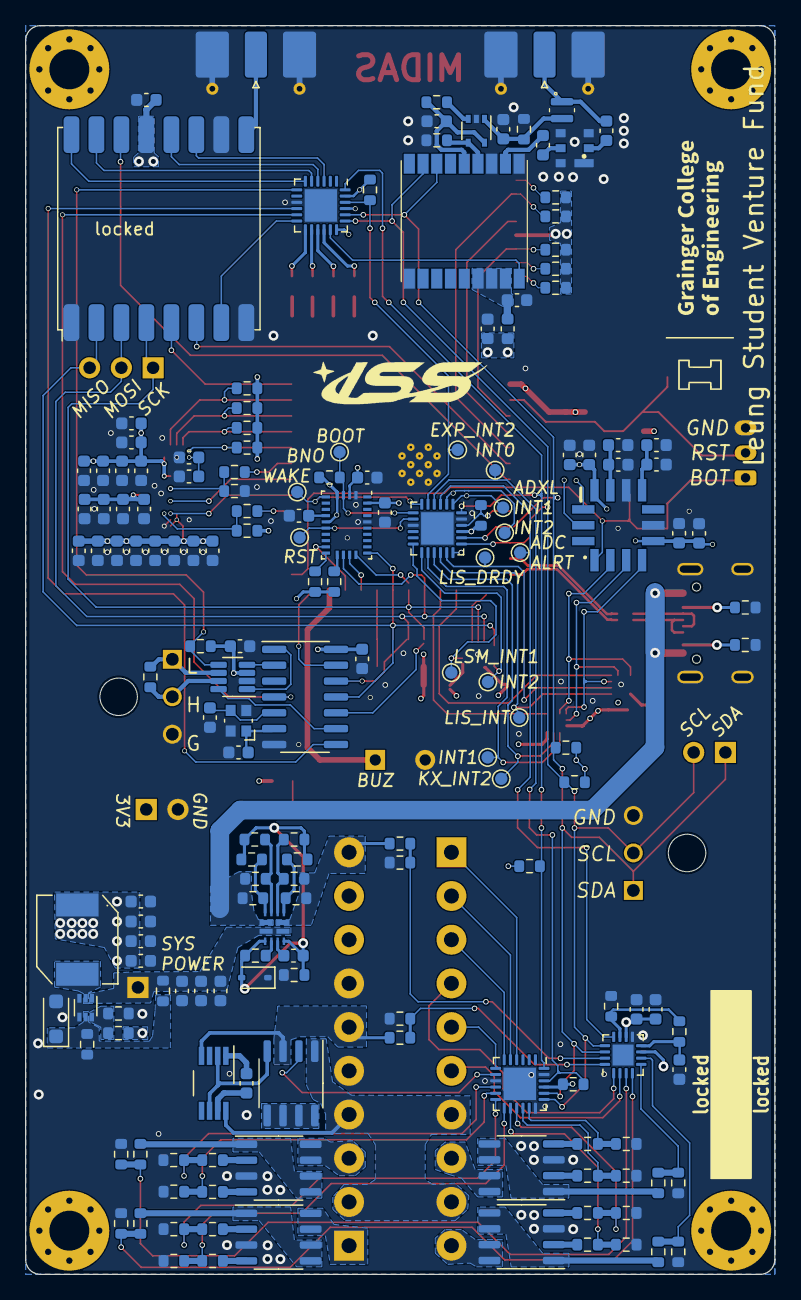
[picture p84: board MIDAS-MK1.1.kicad_pcb from below]

Board: 4 copper layers, 60.0 x 100.0 mm, 218 parts (169 on the bottom side), 159 nets.

Parts:
BZ101: AT-0927-TT-6-R; Buzzer_AT-0927-TT-6-R
C101, C102: 22pF; C_0603_1608Metric
C103, C105, C106, C107, C109, C110, C116, C118, C120, C122, C124, C126, C128, C130, C132, C302, C408, C502, C504, C506, C507, C508, C510, C511, C512, C513, C514, C515, C519: 0.1uF; C_0603_1608Metric
C104, C305, C306, C307, C308: 22uF; C_0603_1608Metric
C108, C111, C112, C113, C114, C201, C301, C501, C503, C505, C509, C516: 1uF; C_0603_1608Metric
C115, C117, C119, C121, C123, C125, C127, C129, C131: 2.2uF; C_0603_1608Metric
C303, C304, C402, C405: 10uF; C_0603_1608Metric
C401: 200pF; C_0603_1608Metric
C404: 120pF; C_0603_1608Metric
C406: 56pF; C_0603_1608Metric
C407: 10nF; C_0603_1608Metric
C517, C518: 100nF; C_0603_1608Metric
D101, D303: RED LED; LED_0603_1608Metric
D102: ORANGE LED; LED_0603_1608Metric
D103: GREEN LED; LED_0603_1608Metric
D104: BLUE LED; LED_0603_1608Metric
D301: BAS416; D_SOD-323
D302: BZT52H-A5V1-QX; D_SOD-123F
FL401: B3913; Qualcomm_SMD-6
H101, H102, H103, H104: M3; MountingHole_3.2mm_M3_Pad_Via
J101: Left; Phoenix_Terminal-Block_1751329_1x10_P3.5mm
J102: Right; Phoenix_Terminal-Block_1751329_1x10_P3.5mm
J103: DM3AT-SF-PEJM5; microSD_HC_Hirose_DM3AT-SF-PEJM5
J104: JST_PH_B3B-PH-K_1x03_P2.00mm_Vertical
J106: USB4105-GF-A; USB_C_Receptacle_GCT_USB4105-xx-A_16P_TopMnt_Horizontal
J108: Conn_01x02; PinHeader_1x02_P2.54mm_Vertical
J109: PinHeader_1x03_P2.54mm_Vertical
J110, J111: 2157601003; Molex_Micro-Fit-Plus_2157601003_1x03_P3.0mm
J301: TestPoint; PinHeader_1x01_P2.54mm_Vertical
J302: Conn_01x02; PinSocket_1x02_P2.54mm_Vertical
J401, J402: SMA; SMA_Molex_73251-2120_EdgeMount_Horizontal
L301: 2.2uH; L_TDK_SPM6530
L402: 27nH; L_0603_1608Metric
L403: 500nH; L_Coilcraft_XFL2010
Q201, Q202, Q203, Q204, Q205: DMNH6022SSDQ; SO-8_3.9x4.9mm_P1.27mm
R101, R102, R103, R104, R105, R106, R129, R130, R131, R132, R133, R134, R401, R501: 10k; R_0603_1608Metric
R107, R108, R109, R112, R113, R118, R120: 50k; R_0603_1608Metric
R110, R111: 22; R_0603_1608Metric
R114: 50; R_0603_1608Metric
R115, R403: 100k; R_0603_1608Metric
R116: TBD; R_0603_1608Metric
R117: 120; R_0603_1608Metric
R119, R121: 200k; R_0603_1608Metric
R122, R123: 5.1k; R_0603_1608Metric
R124, R125, R126, R127, R315: 470; R_0603_1608Metric
R128, R211, R212, R223, R224, R311: 20k; R_0603_1608Metric
R201, R202, R203, R204, R213, R214, R215, R216: 3.3k; R_0603_1608Metric
R205, R206, R207, R208, R217, R218, R219, R220: 1k; R_0603_1608Metric
R209, R210, R221, R222, R301, R302, R304, R306, R308: 5k; R_0603_1608Metric
R303: 27k; R_0603_1608Metric
R305: 33k; R_0603_1608Metric
R307: 69.8k; R_0603_1608Metric
R309: 0; R_0603_1608Metric
R310: 21.5k; R_0603_1608Metric
R312, R313: 30k; R_0603_1608Metric
R314: 135k; R_0603_1608Metric
R402: 500; R_0603_1608Metric
R502, R503: 2.2k; R_0603_1608Metric
SW101, SW102: SW_Push; SW_SPST_FSMSM
TP101, TP102, TP103, TP104, TP105, TP106, TP107, TP108, TP109, TP110, TP111, TP112, TP113, TP114: TestPoint_Small; TestPoint_Pad_D1.0mm
U101, U102, U103: TCAL9539-Q1; WQFN-24-1EP_4x4mm_P0.5mm_EP2.6x2.6mm
U104: ESP32-S3-WROOM-1U
U105: MCP2518FDT-xSL; SOIC-14_3.9x8.7mm_P1.27mm
U106: MTFCxxxx; TFBGA-153_11.5x13mm
U107: TCAN337G; SOT-23-8
U108: ADS7138-Q1; WQFN-16-1EP_3x3mm_P0.5mm_EP1.68x1.68mm
U109: ECMF02-2AMX6; ST_UQFN-6L_1.5x1.7mm_P0.5mm
U201: LM74670-Q1; VSSOP-8_3.0x3.0mm_P0.65mm
U301: TPS2121; VQFN-HR-RUX0012A
U302: TI_TPS566242; SOT-563
U401: RFM96W-433S2; HOPERF_RFM9XW_SMD
U402: TPS22943; SOT-353_SC-70-5
U403: Teseo-LIV3R
U501: KX134-1211; LGA-12_2x2mm_P0.5mm
U502: ADXL355; Analog_LGA_14-7.4x7.4mm
U503: LSM6DSLTR; Bosch_LGA-14_3x2.5mm_P0.5mm
U504: BNO086; LGA-28_5.2x3.8mm_P0.5mm
U505: LIS3MDL; LGA-12_2x2mm_P0.5mm
U506: MS5611-01BA03; LGA-8_3x5mm_P1.25mm
Y101: 40MHz; Crystal_SMD_Abracon_ABM10-4Pin_2.5x2.0mm

Connections:
+3V3: C104.1, C105.2, C106.1, C110.2, C112.1, C113.1, C115.1, C116.1, C117.1, C118.1, C119.1, C120.1, C121.1, C122.1, C123.1, C124.1, C125.1, C126.1, C127.1, C128.1, C129.1, C130.1, C131.1, C132.1, C305.1, C306.1, C307.1, C308.1, C402.1, C407.1, C501.2, C502.2, C503.2, C504.1, C506.1, C508.1, C511.1, C512.1, C514.1, C515.1, C516.2, C517.2, C519.1, J103.4 (VDD), J302.1, L301.1, L402.1, R101.2, R102.2, R103.2, R104.2, R105.2, R106.2, R107.2, R108.2, R109.2, R112.2, R113.2, R128.2, R129.1, R130.2, R131.2, R132.2, R133.2, R134.2, R314.2, R315.1, R501.2, R502.2, R503.2, U101.21 (VCC), U102.18 (A0), U102.21 (VCC), U103.18 (A0), U103.21 (VCC), U103.23 (A1), U104.2 (3V3), U105.14 (VDD), U106.C6 (VCCQ), U106.E6 (VCC), U106.F5 (VCC), U106.J10 (VCC), U106.K9 (VCC), U106.M4 (VCCQ), U106.N4 (VCCQ), U106.P3 (VCCQ), U106.P5 (VCCQ), U107.3 (VCC), U108.7 (AVDD), U108.10 (DVDD), U401.13 (3.3V), U501.3 (IO_VDD), U501.7 (VDD), U502.5 (V_{DDIO}), U502.11 (V_{SUPPLY}), U503.5 (VDDIO), U503.8 (VDD), U504.3 (VDD), U504.5 (PS1), U504.10 (CLKSEL0), U504.28 (VDDIO), U505.5 (Vdd), U505.6 (Vdd_IO), U506.1 (VDD)
/ADC_ALERT: TP103.1, U102.3 (P02), U108.12 (ALERT)
/ADC_DECAP: C111.1, R115.1, U108.8 (DECAP)
/ADXL355_CS: C103.2, J104.1, SW101.2, U104.27 (IO0), U502.1 (~CS/SCL)
/ADXL355_INT1: TP108.1, U102.1 (P00), U502.13 (INT2)
/ADXL355_INT2: TP107.1, U102.2 (P01), U502.12 (INT1)
/ARM_A: R201.1, R205.1, U101.16
/ARM_B: R213.1, R217.1, U101.14
/ARM_C: R202.1, R207.1, U101.10
/ARM_D: R214.1, R219.1, U101.12
/AUX_ADC_0: J101.6, U108.2 (AIN3/GPIO3)
/AUX_ADC_1: J101.4, U108.1 (ANI2/GPIO2)
/AUX_GPIO_0: J101.5, U101.7 (P06)
/AUX_GPIO_1: J101.3, U101.6 (P05)
/AUX_GPIO_2: J101.2, U101.5 (P04)
/AUX_GPIO_3: J101.1, U101.4 (P03)
/BNO086_BOOT: R501.1, TP106.1, U102.7 (P06), U504.4 (BOOTN)
/BNO086_CS: U104.23 (IO21), U504.18 (H_CSN)
/BNO086_INT: U104.24 (IO47), U504.14 (H_INTN)
/BNO086_RESET: TP104.1, U102.8 (P07), U504.11 (NRST)
/BNO086_WAKE: TP105.1, U102.6 (P05), U504.6 (PS0/WAKE)
/BUZZER: BZ101.1 (-), U104.25 (IO48)
/CAN_FAULT: R129.2, U103.7 (P06), U107.5 (FAULT)
/CAN_NCS: U104.26 (IO45), U105.13 (NCS)
/CAN_NINT: U103.11, U105.4 (~INT)
/CAN_NINT1: U103.10, U105.8 (~INT1/GPIO1)
/EXP_INT0: R101.1, TP101.1, U101.22 (~INT), U102.4 (P03)
/EXP_INT1: R102.1, U102.22 (~INT), U104.10 (IO17)
/EXP_INT2: R103.1, TP102.1, U102.5 (P04), U103.22 (~INT)
/EXP_RESET: R106.1, U101.24 (~RESET), U102.24 (~RESET), U103.24 (~RESET), U104.9 (IO16)
/FIRE_A: R203.1, R206.1, U101.17
/FIRE_B: R215.1, R218.1, U101.15
/FIRE_C: R204.1, R208.1, U101.11
/FIRE_D: R216.1, R220.1, U101.13
/I2C_SCL: J108.2, J111.2, R105.1, U101.19 (SCL), U102.19 (SCL), U103.19 (SCL), U104.12 (IO8), U108.13 (SCL), U403.17 (SCL)
/I2C_SDA: J108.1, J111.1, R104.1, U101.20 (SDA), U102.20 (SDA), U103.20 (SDA), U104.11 (IO18), U108.14 (SDA), U403.16 (SDA)
/KX134_CS: U104.18 (IO10), U501.10 (nCS)
/KX134_INT1: TP110.1, U102.14, U501.5 (INT1)
/KX134_INT2: TP109.1, U102.15, U501.6 (INT2)
/LED_BLUE: R127.1, U103.13
/LED_GREEN: R126.1, U103.14
/LED_ORANGE: R125.1, U103.15
/LED_RED: R124.1, U103.16
/LIS3MDL_CS: U104.17 (IO9), U505.10 (CS)
/LIS3MDL_DRDY: TP111.1, U102.17, U505.8 (DRDY)
/LIS3MDL_INT: TP112.1, U102.16, U505.7 (INT)
/LIV3R_RESET: U103.17, U403.9 (SYS_RSTn)
/LSM6DSLTR_INT1: TP113.1, U102.13, U503.4 (INT1)
/LSM6DSLTR_INT2: TP114.1, U102.12, U503.9 (INT2)
/LSM6DSL_CS: U104.15 (IO3), U503.12 (CS)
/MEM_CLK: R110.1, U104.31 (IO38)
/MEM_CMD: U104.32 (IO39), U106.M5 (CMD)
/MEM_DAT0: R112.1, U104.36 (RXD0), U106.A3 (DAT0)
/MEM_DAT1: R109.1, U104.37 (TXD0), U106.A4 (DAT1)
/MEM_DAT2: R108.1, U104.38 (IO2), U106.A5 (DAT2)
/MEM_DAT3: R107.1, U104.35 (IO42), U106.B2 (DAT3)
/MEM_DS: R111.2, U104.34 (IO41)
/MEM_RST_N: U104.33 (IO40), U106.K5 (RST_N)
/MS5611_CS: U104.22 (IO14), U506.4 (CSB), U506.5 (CSB)
/MicroSD_CLK: J103.5 (CLK), U104.5 (IO5)
/MicroSD_CMD: J103.3 (CMD), R132.1, U104.4 (IO4)
/MicroSD_DAT0: J103.7 (DAT0), R131.1, U104.6 (IO6)
/PYRO_A: J101.8, Q202.7 (D1), Q202.8 (D1)
/PYRO_B: J101.10, Q204.7 (D1), Q204.8 (D1)
/PYRO_C: J102.3, Q203.7 (D1), Q203.8 (D1)
/PYRO_D: J102.1, Q205.7 (D1), Q205.8 (D1)
/PYRO_EN: Q201.2 (G1), U101.8 (P07)
/PYRO_SENSE: R118.2, R119.1, U108.16 (AIN1/GPIO1)
/Power/MUX_CP2: R305.2, R306.1, U301.3 (CP2)
/Power/SYS_POWER: C302.1, C303.1, C304.1, J301.1, R311.1, U301.1 (OUT), U301.8 (OUT), U302.1 (VIN)
/RESET_SW: C107.1, C114.1, J104.2, R128.1, SW102.1, U104.3 (EN)
/RFM96W_CS: U104.39 (IO1), U401.5 (NSS)
/RFM96W_DI01: U103.5 (P04), U401.15 (DIO1)
/RFM96W_DI02: U103.6 (P05), U401.16 (DIO2)
/RFM96W_DI03: U103.3 (P02), U401.11 (DIO3)
/RFM96W_DI04: U103.4 (P03), U401.12 (DIO4)
/RFM96W_DI05: U103.12, U401.7 (DIO5)
/RFM96W_INT: U104.8 (IO15), U401.14 (DIO0)
/RFM96W_RESET: U104.7 (IO7), U401.6 (RESET)
/SENSE_A: R210.1, R211.2, U108.5 (AIN6/GPIO6)
/SENSE_B: R221.1, R223.2, U108.6 (AIN7/GPIO7)
/SENSE_C: R209.1, R212.2, U108.3 (AIN4/GPIO4)
/SENSE_D: R222.1, R224.2, U108.4 (AIN5/GPIO5)
/SPI_MISO: J109.3, U104.21 (IO13), U105.11 (SDI), U401.2 (MISO), U501.1 (SDO/ADDR), U502.4 (MISO/ASEL), U503.1 (SDO/SA0), U504.20 (H_SDA/H_MISO/TX), U505.9 (SDO/SA1), U506.6 (SDO)
/SPI_MOSI: J109.2, U104.19 (IO11), U105.12 (SDO), U401.3 (MOSI), U501.2 (SDI/SDA), U502.3 (MOSI/SDA), U503.14 (SDA), U504.17 (H_SA0_MOSI), U505.11 (SDA/SDI/SDO), U506.7 (SDI/SDA)
/SPI_SCK: J109.1, U104.20 (IO12), U105.10 (SCK), U401.4 (SCK), U501.12 (SCLK/SCL), U502.2 (SCLK/V_{SSIO}), U503.13 (SCL), U504.19 (H_SCL/SCK/RX), U505.1 (SCL/SPC), U506.8 (SCLK)
/USB_D+: U104.14 (IO20), U109.1 (D+_in)
/USB_D-: U104.13 (IO19), U109.2 (D-_in)
/USB_POWER: J106.A4 (VBUS), J106.A9 (VBUS), J106.B4 (VBUS), J106.B9 (VBUS), R301.1, R303.1, U301.7 (IN1)
/VBAT: J102.10, R120.1, R305.1, R307.1, U301.2 (IN2)
/VBAT_PYRO: J102.6, Q201.3 (S2), R118.1, U201.4 (ANODE)
/VBAT_SENSE: R120.2, R121.1, U108.15 (AIN0/GPIO0)
/V_PYRO: J101.7, J101.9, J102.2, J102.4, Q201.1 (S1), U201.8 (CATHODE)
GND: BZ101.2 (+), C101.1, C102.2, C103.1, C104.2, C105.1, C106.2, C107.2, C108.1, C109.1, C110.1, C111.2, C112.2, C113.2, C114.2, C115.2, C116.2, C117.2, C118.2, C119.2, C120.2, C121.2, C122.2, C123.2, C124.2, C125.2, C126.2, C127.2, C128.2, C129.2, C130.2, C131.2, C132.2, C302.2, C303.2, C304.2, C305.2, C306.2, C307.2, C308.2, C402.2, C405.2, C406.2, C407.2, C408.2, C501.1, C502.1, C503.1, C504.2, C505.1, C506.2, C507.2, C508.2, C509.1, C510.2, C511.2, C512.2, C513.2, C514.2, C515.2, C516.1, C517.1, C518.1, C519.2, D101.1 (K), D102.1 (K), D103.1 (K), D104.1 (K), D301.1 (K), D302.2 (A), D303.1 (K), FL401.1 (GND), FL401.3 (GND), FL401.4 (GND), FL401.6 (GND), J102.5, J102.7, J103.6 (VSS), J103.11 (SHIELD), J104.3, J106.A1 (GND), J106.A12 (GND), J106.B1 (GND), J106.B12 (GND), J106.S1 (SHIELD), J110.3, J111.3, J302.2, J401.2 (Ext), J402.2 (Ext), Q202.3 (S2), Q203.3 (S2), Q204.3 (S2), Q205.3 (S2), R114.2, R116.2, R119.2, R121.2, R122.2, R123.2, R201.2, R202.2, R203.2, R204.2, R211.1, R212.1, R213.2, R214.2, R215.2, R216.2, R223.1, R224.1, R309.2, R312.2, R313.2, R401.1, R402.1, SW101.1, SW102.2, U101.9 (GND), U101.18 (A0), U101.23 (A1), U101.25 (GND), U102.9 (GND), U102.23 (A1), U102.25 (GND), U103.9 (GND), U103.25 (GND), U104.1 (GND), U104.40 (GND), U104.41 (EPAD), U105.7 (VSS), U106.A6 (VSS), U106.C4 (VSSQ), U106.E7 (VSS), U106.G5 (VSS), U106.H10 (VSS), U106.J5 (VSS), U106.K8 (VSS), U106.N2 (VSSQ), U106.N5 (VSSQ), U106.P4 (VSSQ), U106.P6 (VSSQ), U107.2 (GND), U108.9 (GND), U108.17 (EPAD), U109.3 (GND), U302.3 (GND), U302.4 (AGND), U401.1 (GND), U401.8 (GND), U401.10 (GND), U402.2 (GND), U403.1 (GND), U403.10 (GND_RF), U403.12 (GND_RF), U501.4 (TRIG), U501.8 (GND), U501.9 (GND), U502.6 (V_{SSIO}), U502.9 (VSS), U503.2 (SDx), U503.3 (SCx), U503.6 (GND), U503.7 (GND), U504.2 (GND), U504.25 (GNDIO), U505.2 (Reserved), U505.3 (GND), U505.12 (Reserved), U506.2 (PS), U506.3 (GND), Y101.2, Y101.4
unnamed: D101.2 (A), R124.2
unnamed: D102.2 (A), R125.2
unnamed: D103.2 (A), R126.2
unnamed: D104.2 (A), R127.2
unnamed: C301.1, D301.2 (A), R302.2, R304.2, R306.2, R308.2, R309.1, R310.1, U301.9 (ST), U301.12 (GND)
unnamed: D302.1 (K), R311.2, R312.1, U302.5 (EN)
unnamed: D303.2 (A), R315.2
unnamed: C401.2, FL401.2 (IN)
unnamed: C404.1, FL401.5 (OUT)
unnamed: J102.8, J102.9
unnamed: J103.8 (DAT1), R130.1
unnamed: J103.1 (DAT2), R134.1
unnamed: J103.2 (DAT3/CD), R133.1
unnamed: J106.A5 (CC1), R122.1
unnamed: J106.B5 (CC2), R123.1
unnamed: J110.1, R117.2, U107.6 (CANL)
unnamed: J110.2, R117.1, U107.7 (CANH)
unnamed: C401.1, J401.1 (In), L403.1
unnamed: J402.1 (In), U401.9 (ANT)
unnamed: Q201.5 (D2), Q201.6 (D2), Q201.7 (D1), Q201.8 (D1)
unnamed: Q201.4 (G2), U201.2 (GATE_PULL_DOWN), U201.6 (GATE_DRIVE)
unnamed: Q202.2 (G1), R205.2
unnamed: Q202.1 (S1), Q202.5 (D2), Q202.6 (D2), R210.2
unnamed: Q202.4 (G2), R206.2
unnamed: Q203.2 (G1), R207.2
unnamed: Q203.1 (S1), Q203.5 (D2), Q203.6 (D2), R209.2
unnamed: Q203.4 (G2), R208.2
unnamed: Q204.2 (G1), R217.2
unnamed: Q204.1 (S1), Q204.5 (D2), Q204.6 (D2), R221.2
unnamed: Q204.4 (G2), R218.2
unnamed: Q205.2 (G1), R219.2
unnamed: Q205.1 (S1), Q205.5 (D2), Q205.6 (D2), R222.2
unnamed: Q205.4 (G2), R220.2
unnamed: C102.1, U105.6 (OSC1), Y101.1
unnamed: C101.2, U105.5 (OSC2), Y101.3
unnamed: U105.2 (RXCAN), U107.4 (RXD)
unnamed: U105.1 (TXCAN), U107.1 (TXD)
unnamed: U105.9 (~INT0/GPIO0/XSTBY), U107.8 (S)
unnamed: R110.2, R113.1, U106.M6 (CLK)
unnamed: R111.1, R114.1, U106.H5 (DS)
unnamed: C108.2, C109.2, U106.C2 (VDDIM)
unnamed: R115.2, R116.1, U108.11 (ADDR)
unnamed: J106.A6 (D+), J106.B6 (D+), U109.6 (D+_out)
unnamed: J106.A7 (D-), J106.B7 (D-), U109.5 (D-_out)
unnamed: C201.1, U201.7 (VCAPH)
unnamed: C201.2, U201.1 (VCAPL)
unnamed: R310.2, U301.10 (ILM)
unnamed: R303.2, R304.1, U301.5 (OV1)
unnamed: R307.2, R308.1, U301.4 (OV2)
unnamed: R301.2, R302.1, U301.6 (PR1)
unnamed: C301.2, U301.11 (SS)
unnamed: R313.1, R314.1, U302.6 (FB)
unnamed: L301.2, U302.2 (SW)
unnamed: C405.1, R403.2, U402.5 (IN), U403.14 (VCC_RF)
unnamed: R403.1, U402.3 (OC)
unnamed: R401.2, U402.4 (ON), U403.13 (Ant_OFF)
unnamed: C408.1, L403.2, R402.2, U402.1 (OUT)
unnamed: C404.2, U403.11 (RF_IN)
unnamed: C406.1, L402.2, U403.6 (Vbatt), U403.7 (VCC_IO), U403.8 (VCC)
unnamed: C505.2, C507.1, U502.10 (V_{1P8ANA})
unnamed: C509.2, C510.1, U502.8 (V_{1P8DIG})
unnamed: C513.1, U504.9 (CAP)
unnamed: R503.1, U504.15 (ENV_SCL)
unnamed: R502.1, U504.16 (ENV_SDA)
unnamed: C518.2, U505.4 (C1)
