ISSUIUC/ISS-PCB/boards/Onboarding/555-Timer-Demo-Circuit/555-Timer-Demo-Circuit.kicad_pcb

## KiCad design boards/Onboarding/555-Timer-Demo-Circuit/555-Timer-Demo-Circuit.kicad_pcb (2024-09-03)

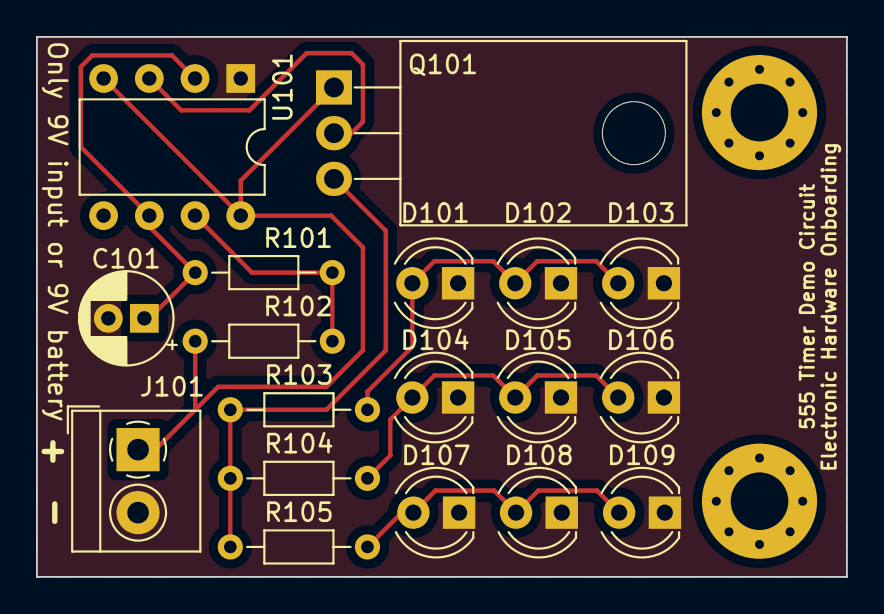
[picture p85: board 555-Timer-Demo-Circuit.kicad_pcb from above]

Board: 2 copper layers, 45.0 x 30.0 mm, 20 parts (0 on the bottom side), 9 nets.

Parts:
C101: 10uf; CP_Radial_D5.0mm_P2.00mm
D101, D104, D107: Red; LED_D4.0mm
D102, D105, D108: Blue; LED_D4.0mm
D103, D106, D109: Green; LED_D4.0mm
H101, H102: MountingHole; MountingHole_3.2mm_M3_Pad_Via
J101: Terminal Block; TerminalBlock_4Ucon_1x02_P3.50mm_Horizontal
Q101: NMOS; TO-220-3_Horizontal_TabDown
R101, R102: 50K; R_Axial_DIN0204_L3.6mm_D1.6mm_P7.62mm_Horizontal
R103, R104, R105: 500; R_Axial_DIN0204_L3.6mm_D1.6mm_P7.62mm_Horizontal
U101: LM555xN; DIP-8_W7.62mm

Connections:
+9V: J101.1, Q101.1 (D), R102.1, U101.4 (R), U101.8 (VCC)
/THR: C101.1, R101.2, U101.2 (TR), U101.6 (THR)
GND: C101.2, D101.1 (K), D102.1 (K), D103.1 (K), D104.1 (K), D105.1 (K), D106.1 (K), D107.1 (K), D108.1 (K), D109.1 (K), J101.2, U101.1 (GND)
unnamed: D101.2 (A), D102.2 (A), D103.2 (A), R103.2
unnamed: D104.2 (A), D105.2 (A), D106.2 (A), R104.2
unnamed: D107.2 (A), D108.2 (A), D109.2 (A), R105.2
unnamed: Q101.2 (G), U101.3 (Q)
unnamed: Q101.3 (S), R103.1, R104.1, R105.1
unnamed: R101.1, R102.2, U101.7 (DIS)
