ISSUIUC/ISS-PCB/boards/WeatherStation/Weather-Station-DAQ-MK1/Power.kicad_sch

## KiCad design boards/WeatherStation/Weather-Station-DAQ-MK1/Power.kicad_sch (2026-11-14)

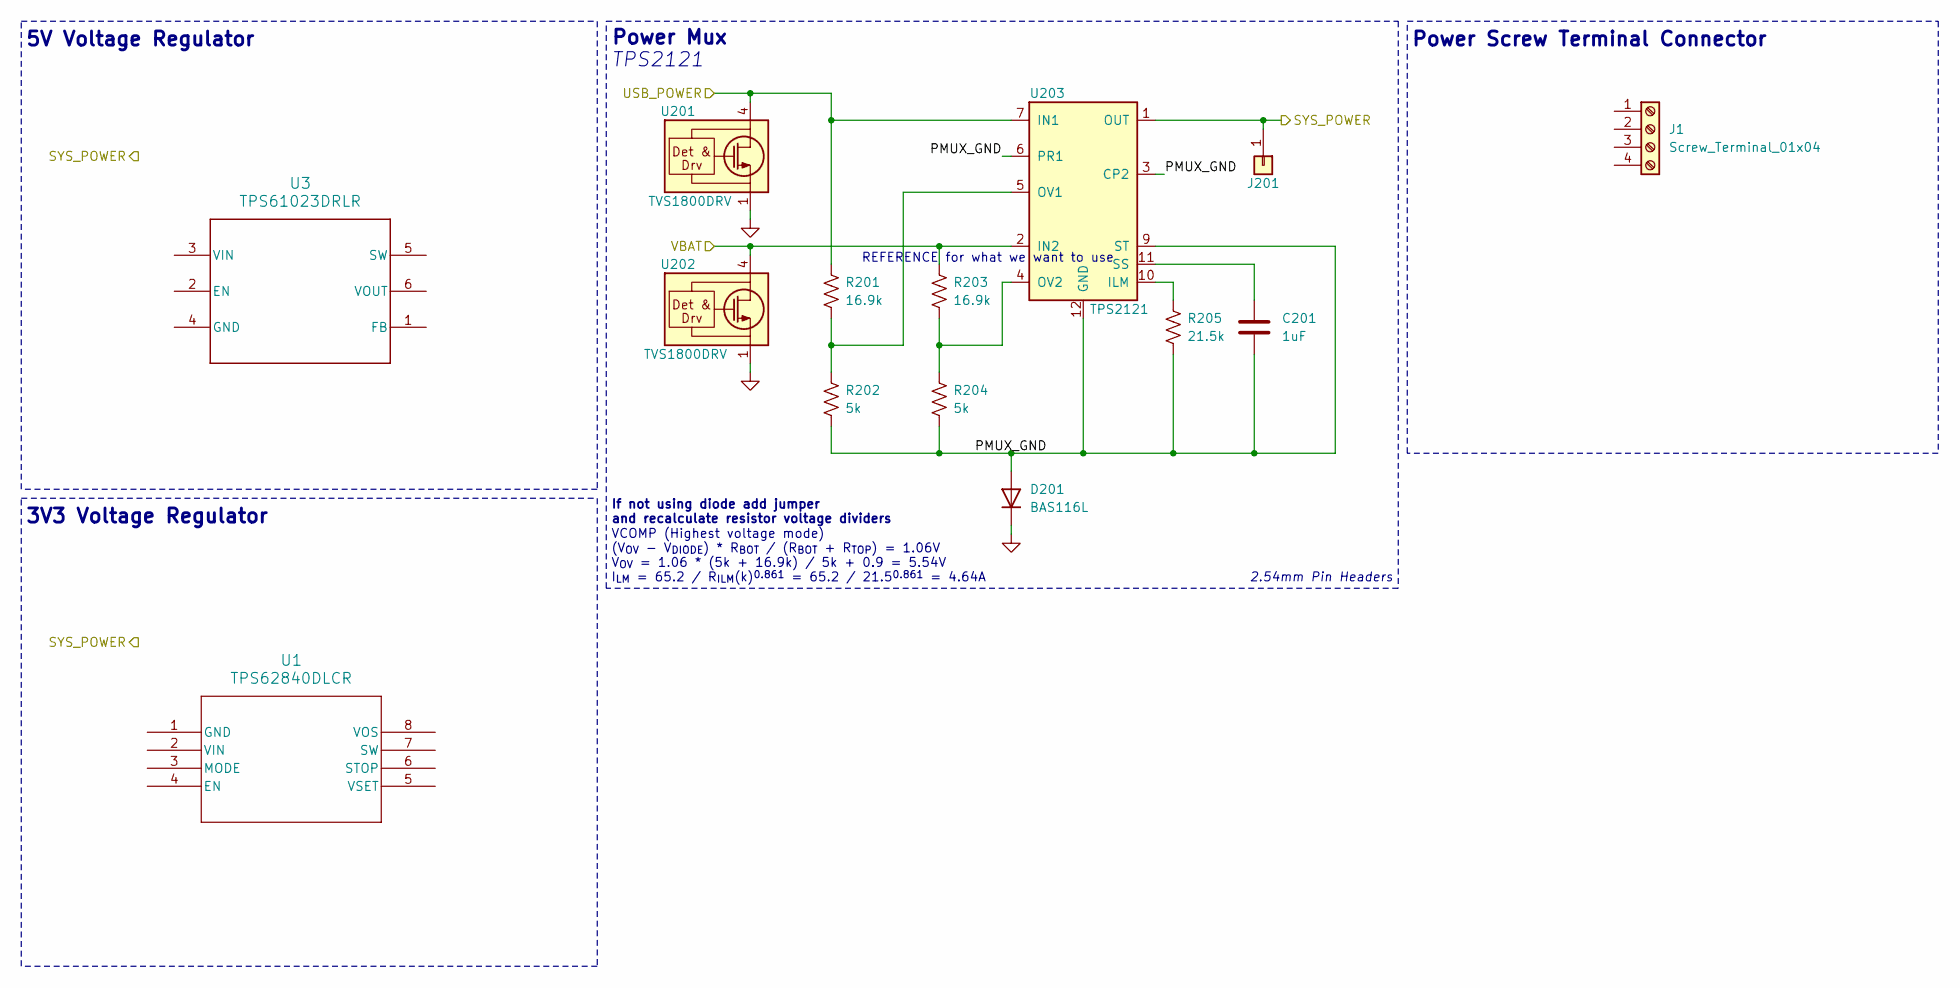
[picture p86: schematic Power.kicad_sch]

Parts:
C201: 1uF; C_0402_1005Metric
D201: BAS116L; D_SOD-882
J1: Screw_Terminal_01x04
J201: TestPoint; TestPoint_THTPad_1.5x1.5mm_Drill0.7mm
R201, R203: 16.9k; R_0402_1005Metric
R202, R204: 5k; R_0402_1005Metric
R205: 21.5k; R_0402_1005Metric
U1: TPS62840DLCR; VSON8_2P1X1P6_TEX
U3: TPS61023DRLR; DRL0006A
U201, U202: TVS1800DRV; WSON-6-1EP_2x2mm_P0.65mm_EP1x1.6mm
U203: TPS2121; Texas_VQFN-HR-12_2x2.5mm_P0.5mm

Connections:
GND: D201.1 (K), U201.1 (GND), U201.2 (GND), U201.3 (GND), U201.7 (GND), U202.1 (GND), U202.2 (GND), U202.3 (GND), U202.7 (GND)
unnamed: C201.2, U203.11 (SS)
unnamed: R201.2, R202.1, U203.5 (OV1)
unnamed: R203.2, R204.1, U203.4 (OV2)
unnamed: R205.2, U203.10 (ILM)
PMUX_GND: C201.1, D201.2 (A), R202.2, R204.2, R205.1, U203.3 (CP2), U203.6 (PR1), U203.9 (ST), U203.12 (GND)
SYS_POWER: J201.1, U203.1 (OUT), U203.8 (OUT)
USB_POWER: R201.1, U201.4 (IN), U201.5 (IN), U201.6 (IN), U203.7 (IN1)
VBAT: R203.1, U202.4 (IN), U202.5 (IN), U202.6 (IN), U203.2 (IN2)

Notes on the sheet:
VCOMP (Highest voltage mode) (V_{OV} - V_{DIODE}) * R_{BOT} / (R_{BOT} + R_{TOP}) = 1.06V V_{OV} = 1.06 * (5k + 16.9k) / 5k + 0.9 = 5.54V I_{LM} = 65.2 / R_{ILM}(k)^{0.861} = 65.2 / 21.5^{0.861} = 4.64A
Power Screw Terminal Connector
2.54mm Pin Headers
Power Mux
5V Voltage Regulator
3V3 Voltage Regulator
If not using diode add jumper and recalculate resistor voltage dividers
REFERENCE for what we want to use
TPS2121
