ISSUIUC/ISS-PCB/boards/WeatherStation/Weather-Station-DAQ-MK1/Sensors.kicad_sch

## KiCad design boards/WeatherStation/Weather-Station-DAQ-MK1/Sensors.kicad_sch (2026-11-11)

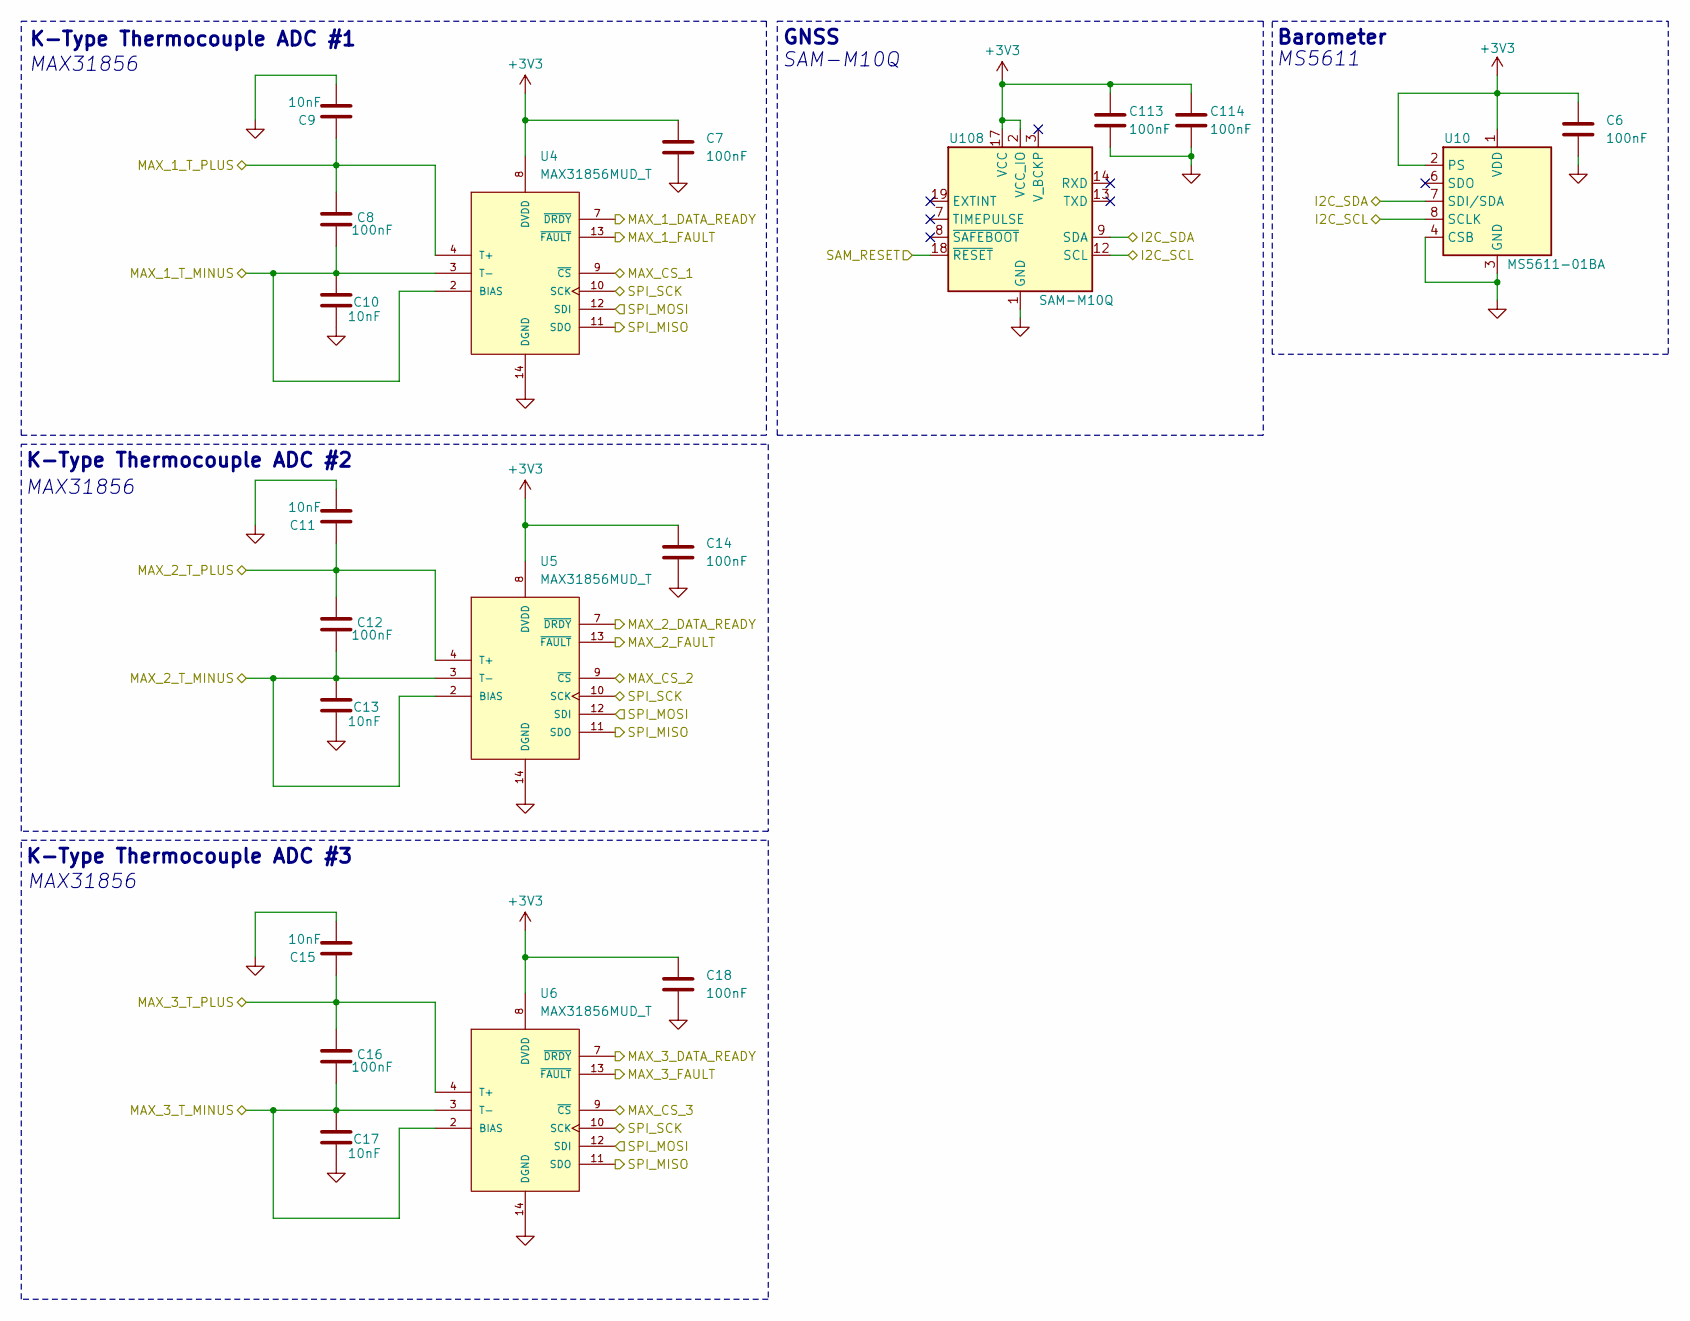
[picture p87: schematic Sensors.kicad_sch]

Parts:
C6, C7, C8, C12, C14, C16, C18, C113, C114: 100nF; C_0402_1005Metric
C9, C10, C11, C13, C15, C17: 10nF; C_0402_1005Metric
U4, U5, U6: MAX31856MUD_T; SOP65P640X110-14N; PARTREV 0
U10: MS5611-01BA; LGA-8_3x5mm_P1.25mm
U108: SAM-M10Q; ublox_SAM-M8Q

Connections:
+3V3: C6.1, C7.1, C14.1, C18.1, C113.2, C114.2, U4.5 (AVDD), U4.8 (DVDD), U5.5 (AVDD), U5.8 (DVDD), U6.5 (AVDD), U6.8 (DVDD), U10.1 (VDD), U10.2 (PS), U108.2 (VCC_IO), U108.17 (VCC)
GND: C6.2, C7.2, C9.2, C10.2, C11.2, C13.2, C14.2, C15.2, C17.2, C18.2, C113.1, C114.1, U4.1 (AGND), U4.14 (DGND), U5.1 (AGND), U5.14 (DGND), U6.1 (AGND), U6.14 (DGND), U10.3 (GND), U10.4 (CSB), U10.5 (CSB), U108.1 (GND), U108.4 (GND), U108.5 (GND), U108.6 (GND), U108.10 (GND), U108.11 (GND), U108.15 (GND), U108.16 (GND), U108.20 (GND)
I2C_SCL: U10.8 (SCLK), U108.12 (SCL)
I2C_SDA: U10.7 (SDI/SDA), U108.9 (SDA)
MAX_1_DATA_READY: U4.7 (~DRDY)
MAX_1_FAULT: U4.13 (~FAULT)
MAX_1_T_MINUS: C8.2, C10.1, U4.2 (BIAS), U4.3 (T-)
MAX_1_T_PLUS: C8.1, C9.1, U4.4 (T+)
MAX_2_DATA_READY: U5.7 (~DRDY)
MAX_2_FAULT: U5.13 (~FAULT)
MAX_2_T_MINUS: C12.2, C13.1, U5.2 (BIAS), U5.3 (T-)
MAX_2_T_PLUS: C11.1, C12.1, U5.4 (T+)
MAX_3_DATA_READY: U6.7 (~DRDY)
MAX_3_FAULT: U6.13 (~FAULT)
MAX_3_T_MINUS: C16.2, C17.1, U6.2 (BIAS), U6.3 (T-)
MAX_3_T_PLUS: C15.1, C16.1, U6.4 (T+)
MAX_CS_1: U4.9 (~CS)
MAX_CS_2: U5.9 (~CS)
MAX_CS_3: U6.9 (~CS)
SAM_RESET: U108.18 (~RESET)
SPI_MISO: U4.11 (SDO), U5.11 (SDO), U6.11 (SDO)
SPI_MOSI: U4.12 (SDI), U5.12 (SDI), U6.12 (SDI)
SPI_SCK: U4.10 (SCK), U5.10 (SCK), U6.10 (SCK)

Notes on the sheet:
K-Type Thermocouple ADC #1
SAM-M10Q
GNSS
K-Type Thermocouple ADC #2
K-Type Thermocouple ADC #3
MAX31856
Barometer
MS5611
