ISSUIUC/ISS-PCB/boards/WeatherStation/Weather-Station-DAQ-MK1/Weather-Station-DAQ-MK1.kicad_sch

## KiCad design boards/WeatherStation/Weather-Station-DAQ-MK1/Weather-Station-DAQ-MK1.kicad_sch (2026-11-11)

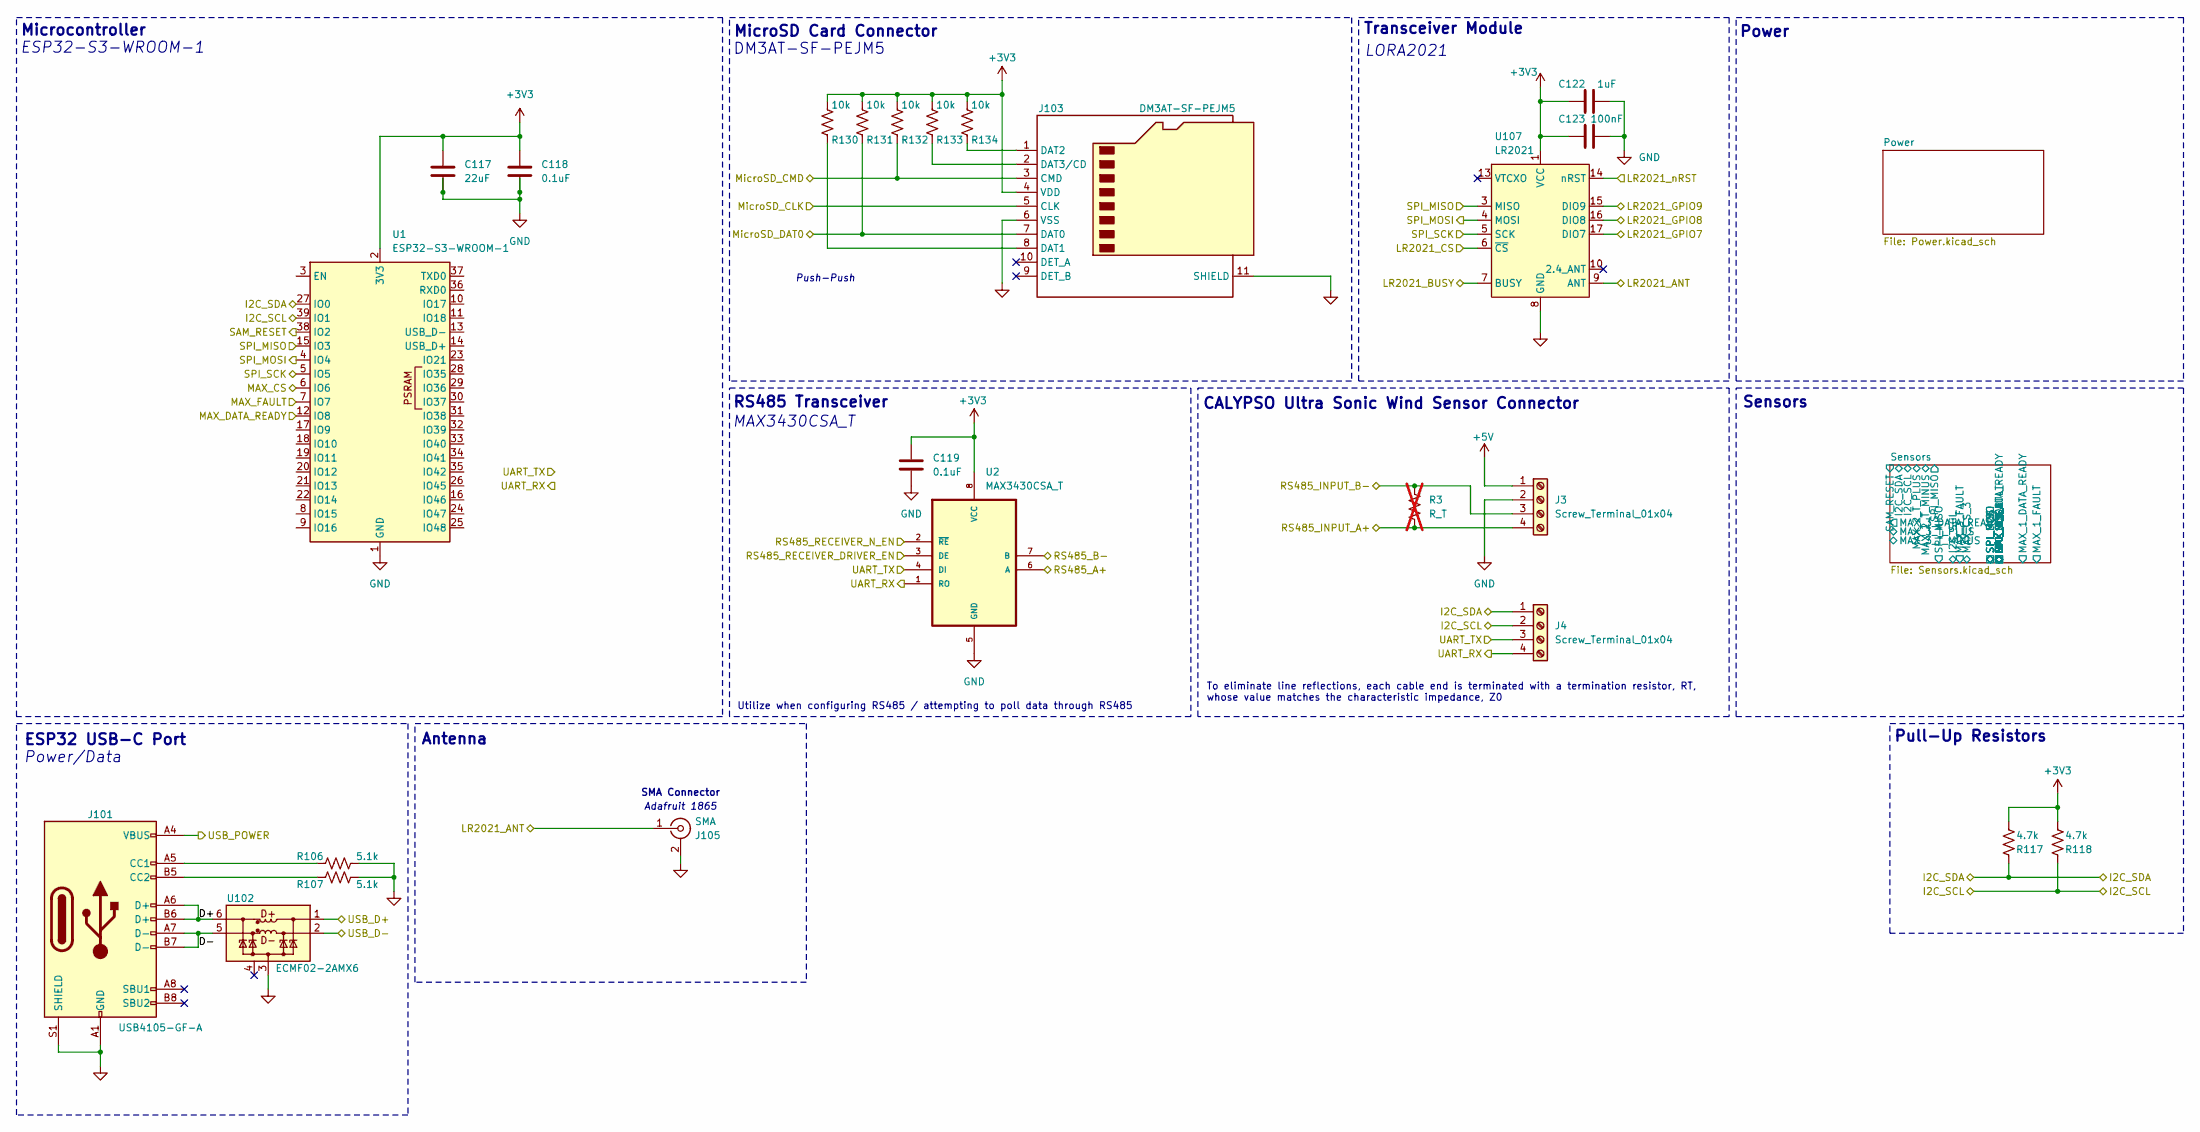
[picture p88: schematic Weather-Station-DAQ-MK1.kicad_sch]

Parts:
C117: 22uF
C118, C119: 0.1uF
C122: 1uF; C_0603_1608Metric
C123: 100nF; C_0603_1608Metric
J3, J4: Screw_Terminal_01x04
J101: USB4105-GF-A; USB_C_Receptacle_GCT_USB4105-xx-A_16P_TopMnt_Horizontal
J103: DM3AT-SF-PEJM5; microSD_HC_Hirose_DM3AT-SF-PEJM5
J105: SMA; SMA_Molex_73251-2120_EdgeMount_Horizontal
R3: R_T; not fitted
R106, R107: 5.1k; R_0402_1005Metric
R117, R118: 4.7k; R_0402_1005Metric
R130, R131, R132, R133, R134: 10k; R_0603_1608Metric
U1: ESP32-S3-WROOM-1
U2: MAX3430CSA_T; SOIC127P600X175-8N; MPN MAX3430CSA+T
U102: ECMF02-2AMX6; ST_UQFN-6L_1.5x1.7mm_P0.5mm
U107: LR2021

Connections:
+3V3: C117.1, C118.1, C119.1, C122.1, C123.1, J103.4 (VDD), R117.2, R118.2, R130.2, R131.2, R132.2, R133.2, R134.2, U1.2 (3V3), U2.8 (VCC), U107.1 (VCC)
+5V: J3.1
D+: J101.A6 (D+), J101.B6 (D+), U102.6 (D+_out)
D-: J101.A7 (D-), J101.B7 (D-), U102.5 (D-_out)
GND: C117.2, C118.2, C119.2, C122.2, C123.2, J3.2, J101.A1 (GND), J101.A12 (GND), J101.B1 (GND), J101.B12 (GND), J101.S1 (SHIELD), J103.6 (VSS), J103.11 (SHIELD), J105.2 (Ext), R106.2, R107.2, U1.1 (GND), U1.40 (GND), U1.41 (GND), U2.5 (GND), U102.3 (GND), U107.2 (GND), U107.8 (GND), U107.11 (GND), U107.12 (GND), U107.18 (GND)
I2C_SCL: J4.2, R118.1, U1.39 (IO1)
I2C_SDA: J4.1, R117.1, U1.27 (IO0)
LR2021_ANT: J105.1 (In), U107.9 (ANT)
LR2021_BUSY: U107.7 (BUSY)
LR2021_CS: U107.6 (~CS)
LR2021_GPIO7: U107.17 (DIO7)
LR2021_GPIO8: U107.16 (DIO8)
LR2021_GPIO9: U107.15 (DIO9)
LR2021_nRST: U107.14 (nRST)
MAX_CS: U1.6 (IO6)
MAX_DATA_READY: U1.12 (IO8)
MAX_FAULT: U1.7 (IO7)
MicroSD_CLK: J103.5 (CLK)
MicroSD_CMD: J103.3 (CMD), R132.1
MicroSD_DAT0: J103.7 (DAT0), R131.1
unnamed: J101.A5 (CC1), R106.1
unnamed: J101.B5 (CC2), R107.1
unnamed: J103.1 (DAT2), R134.1
unnamed: J103.2 (DAT3/CD), R133.1
unnamed: J103.8 (DAT1), R130.1
RS485_A+: U2.6 (A)
RS485_B-: U2.7 (B)
RS485_INPUT_A+: J3.4, R3.2
RS485_INPUT_B-: J3.3, R3.1
RS485_RECEIVER_DRIVER_EN: U2.3 (DE)
RS485_RECEIVER_N_EN: U2.2 (~RE)
SAM_RESET: U1.38 (IO2)
SPI_MISO: U1.15 (IO3), U107.3 (MISO)
SPI_MOSI: U1.4 (IO4), U107.4 (MOSI)
SPI_SCK: U1.5 (IO5), U107.5 (SCK)
UART_RX: J4.4, U2.1 (RO)
UART_TX: J4.3, U2.4 (DI)
USB_D+: U102.1 (D+_in)
USB_D-: U102.2 (D-_in)
USB_POWER: J101.A4 (VBUS), J101.A9 (VBUS), J101.B4 (VBUS), J101.B9 (VBUS)

Notes on the sheet:
Antenna
Push-Push
MAX3430CSA_T
CALYPSO Ultra Sonic Wind Sensor Connector
RS485 Transceiver
Transceiver Module
Power
ESP32 USB-C Port
ESP32-S3-WROOM-1
Power/Data
Microcontroller
MicroSD Card Connector
Pull-Up Resistors
To eliminate line reflections, each cable end is terminated with a termination resistor, RT, whose value matches the characteristic impedance, Z0
Sensors
LORA2021
Utilize when configuring RS485 / attempting to poll data through RS485
SMA Connector
DM3AT-SF-PEJM5
Adafruit 1865
