ISSUIUC/ISS-PCB/boards/WeatherStation/Gwyneth/PCB/PCB.kicad_sch

## KiCad design boards/WeatherStation/Gwyneth/PCB/PCB.kicad_sch (2026-10-31)

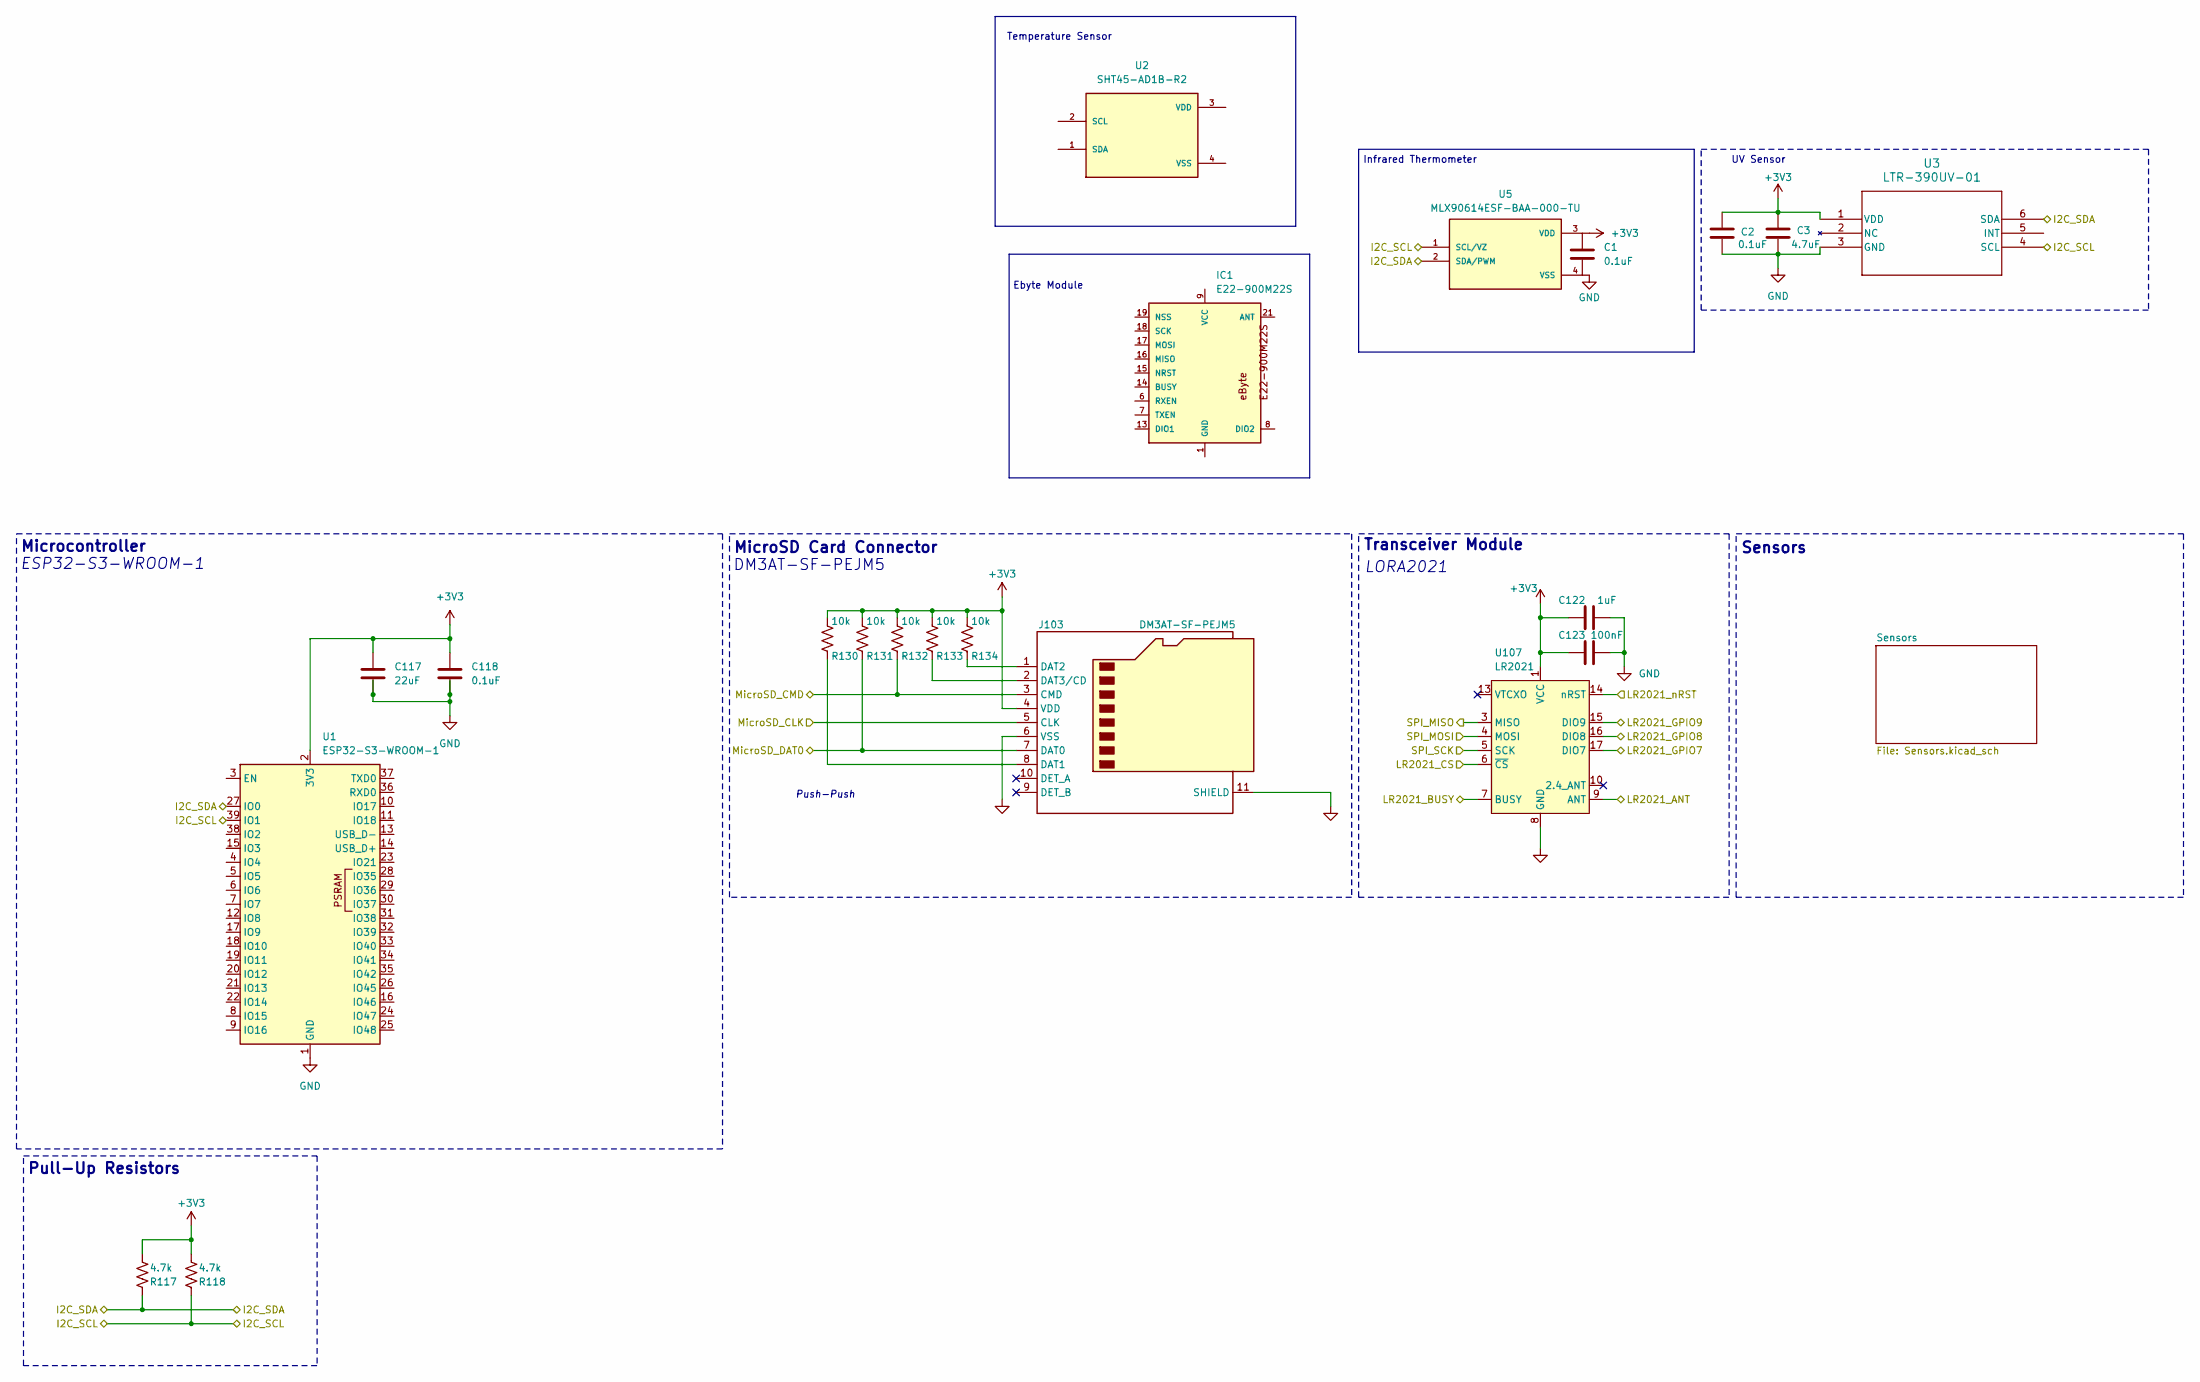
[picture p89: schematic PCB.kicad_sch]

Parts:
C1, C2, C118: 0.1uF
C3: 4.7uF
C117: 22uF
C122: 1uF; C_0603_1608Metric
C123: 100nF; C_0603_1608Metric
IC1: E22-900M22S
J103: DM3AT-SF-PEJM5; microSD_HC_Hirose_DM3AT-SF-PEJM5
R117, R118: 4.7k; R_0402_1005Metric
R130, R131, R132, R133, R134: 10k; R_0603_1608Metric
U1: ESP32-S3-WROOM-1
U2: SHT45-AD1B-R2; SHT4X
U3: LTR-390UV-01; SMD6_LTR-390UV-01_LTO
U5: MLX90614ESF-BAA-000-TU; TO254P942H425-4; PARTREV 13
U107: LR2021

Connections:
+3V3: C2.1, C3.1, C117.1, C118.1, C122.1, C123.1, J103.4 (VDD), R117.2, R118.2, R130.2, R131.2, R132.2, R133.2, R134.2, U1.2 (3V3), U3.1 (VDD), U5.3 (VDD), U107.1 (VCC)
GND: C2.2, C3.2, C117.2, C118.2, C122.2, C123.2, J103.6 (VSS), J103.11 (SHIELD), U1.1 (GND), U1.40 (GND), U1.41 (GND), U3.3 (GND), U5.4 (VSS), U107.2 (GND), U107.8 (GND), U107.11 (GND), U107.12 (GND), U107.18 (GND)
I2C_SCL: R118.1, U1.39 (IO1), U3.4 (SCL), U5.1 (SCL/VZ)
I2C_SDA: R117.1, U1.27 (IO0), U3.6 (SDA), U5.2 (SDA/PWM)
LR2021_ANT: U107.9 (ANT)
LR2021_BUSY: U107.7 (BUSY)
LR2021_CS: U107.6 (~CS)
LR2021_GPIO7: U107.17 (DIO7)
LR2021_GPIO8: U107.16 (DIO8)
LR2021_GPIO9: U107.15 (DIO9)
LR2021_nRST: U107.14 (nRST)
MicroSD_CLK: J103.5 (CLK)
MicroSD_CMD: J103.3 (CMD), R132.1
MicroSD_DAT0: J103.7 (DAT0), R131.1
unnamed: IC1.1 (GND), IC1.2 (GND), IC1.3 (GND), IC1.4 (GND), IC1.5 (GND), IC1.10 (GND), IC1.11 (GND), IC1.12 (GND), IC1.20 (GND), IC1.22 (GND)
unnamed: J103.1 (DAT2), R134.1
unnamed: J103.2 (DAT3/CD), R133.1
unnamed: J103.8 (DAT1), R130.1
SPI_MISO: U107.3 (MISO)
SPI_MOSI: U107.4 (MOSI)
SPI_SCK: U107.5 (SCK)

Notes on the sheet:
Infrared Thermometer
Push-Push
UV Sensor
Transceiver Module
Ebyte Module
ESP32-S3-WROOM-1
Microcontroller
MicroSD Card Connector
Pull-Up Resistors
Sensors
LORA2021
Temperature Sensor
DM3AT-SF-PEJM5
