ISSUIUC/ISS-PCB/boards/WeatherStation/Gwyneth/PCB/Sensors.kicad_sch

## KiCad design boards/WeatherStation/Gwyneth/PCB/Sensors.kicad_sch (2026-10-31)

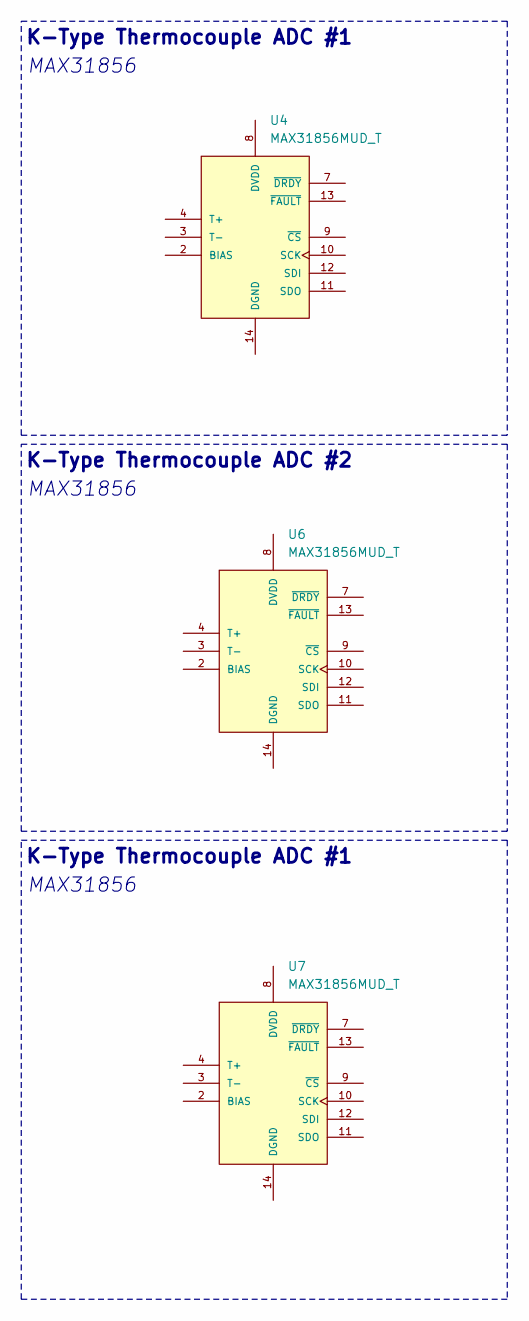
[picture p90: schematic Sensors.kicad_sch]

Parts:
U4, U6, U7: MAX31856MUD_T; SOP65P640X110-14N; PARTREV 0

Connections:
unnamed: U4.1 (AGND), U4.14 (DGND)
unnamed: U4.5 (AVDD), U4.8 (DVDD)
unnamed: U6.1 (AGND), U6.14 (DGND)
unnamed: U6.5 (AVDD), U6.8 (DVDD)
unnamed: U7.1 (AGND), U7.14 (DGND)
unnamed: U7.5 (AVDD), U7.8 (DVDD)

Notes on the sheet:
K-Type Thermocouple ADC #1
K-Type Thermocouple ADC #2
MAX31856
