ISSUIUC/ISS-PCB/(commit log)

2020-10-15 and thus it begins
    [ACTIVE_CONTROL.sch, COTS.sch, HYBRID.sch, MPU.sch, POWER.sch, TARS-MK1.kicad_pcb, TARS-MK1.sch, TELEMETRY.sch]
2020-10-15 Added MCU child schematics
    [COTS.sch, HYBRID.sch, MCU_AC.sch, MCU_HYBRID.sch, MPU.sch, POWER.sch, TARS-MK1.sch, TELEMETRY.sch]
2020-10-16 added AC teensy
    [ACTIVE_CONTROL.sch]
2020-10-16 added servo pins
    [ACTIVE_CONTROL.sch, COTS.sch, HYBRID.sch, MCU_AC.sch, MCU_HYBRID.sch, MPU.sch, POWER.sch, TARS-MK1.kicad_pcb]
2020-10-17 added pcb mount screws
    [HYBRID.sch]
2020-10-17 added screw terminal pins x3
2020-10-17 naming error
    [ACTIVE_CONTROL.sch, MCU_AC.sch]
2020-10-17 Added RFM95
    [TARS-MK1.sch, TELEMETRY.sch]
2020-10-17 Added labels to RFM95
    Hierarchical and global labels added, as well as sheet labels
    [ACTIVE_CONTROL.sch, COTS.sch, HYBRID.sch, MCU_AC.sch, MCU_HYBRID.sch, MPU.sch, POWER.sch, TARS-MK1.sch]
2020-10-17 Added no connection flags
    [TELEMETRY.sch]
2020-10-17 modified footprint of PT connections and created connections between hardware
    [HYBRID.sch]
2020-10-19 Got rid of no-connect pins
    [TELEMETRY.sch]
2020-10-19 add beaglebone
    [MPU.sch]
2020-10-19 Added IMU
    Not quite sure about all the capacitors but yolo
    [ACTIVE_CONTROL.sch]
2020-10-21 Added Barometric Pressure Sensor
    [ACTIVE_CONTROL.sch, MCU_AC.sch]
2020-10-22 adding capability for hybrid
    [ACTIVE_CONTROL.sch, MCU_AC.sch, Teensy_4.0_Assembly.STEP]
2020-10-22 Added the GPS module
    [ACTIVE_CONTROL.sch]
2020-10-22 minor edits
    [ACTIVE_CONTROL.sch]
2020-10-22 added mcu from AC
    [MCU_HYBRID.sch, Teensy_4.0_Assembly.STEP]
2020-10-22 integrated mcu for hybrid
    [ACTIVE_CONTROL.sch, COTS.sch, HYBRID.sch, MCU_AC.sch, MPU.sch, POWER.sch, TARS-MK1.sch, TELEMETRY.sch]
2020-10-23 added vent solenoid schematic
2020-10-23 added footprints and names to the solenoid schematic. Also improved a e s t h e t i c
2020-10-23 Added GPS (but actually)
    [ACTIVE_CONTROL.sch, MCU_AC.sch, ZOE_M8Q.sch]
2020-10-24 Added SMA connector
    [TELEMETRY.sch]
2020-10-24 added mosfet schematic
    [ACTIVE_CONTROL.sch, COTS.sch, HYBRID.sch, MCU_AC.sch, MCU_HYBRID.sch, MPU.sch, POWER.sch, TARS-MK1.sch]
2020-10-24 clarification of MPU library
    [ACTIVE_CONTROL.sch, COTS.sch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]
2020-10-24 small clean-ups
    [ACTIVE_CONTROL.sch, COTS.sch, HYBRID.sch, MCU_AC.sch, MCU_HYBRID.sch, MPU.sch, POWER.sch, TARS-MK1.sch]
2020-10-24 Fixes library paths
    [ACTIVE_CONTROL.sch, COTS.sch, HYBRID.sch, MCU_AC.sch, MCU_HYBRID.sch, MPU.sch, POWER.sch, TARS-MK1.sch]
2020-10-25 Made library for D25V50F5 5V step-down
    [ACTIVE_CONTROL.sch, HYBRID.sch, MCU_AC.sch, MCU_HYBRID.sch, POWER.sch, TELEMETRY.sch, ZOE_M8Q.sch]
2020-10-26 Added jst-xh lipo connectors
    [POWER.sch]
2020-10-26 added COTS and POWER chematics
    [ACTIVE_CONTROL.sch, COTS.sch, HYBRID.sch, MCU_AC.sch, MCU_HYBRID.sch, MPU.sch, POWER.sch, TARS-MK1.sch]
2020-10-26 Tweaks and cleanup
    [ACTIVE_CONTROL.sch, COTS.sch, HYBRID.sch, MCU_AC.sch, MCU_HYBRID.sch, MPU.sch, POWER.sch, TARS-MK1.sch]
2020-10-28 Connected MPU, reorganized power system, cleaned libraries, created BBB footprint
    [ACTIVE_CONTROL.sch, COTS.sch, HYBRID.sch, MCU_AC.sch, MCU_HYBRID.sch, MPU.sch, POWER.sch, TARS-MK1.kicad_pcb]
2020-10-28 Made StratologgerCF library
    [COTS.sch, POWER.sch]
2020-10-31 Reworked power system, added discrete regulators for hybrid servos
    [POWER.sch]
2020-10-31 added minecraft with shaders (jetson nano) + switched to Teensy 4.1
    [ACTIVE_CONTROL.sch, COTS.sch, HYBRID.sch, JETSON_NANO.sch, MCU_AC.sch, MCU_HYBRID.sch, MPU.sch, POWER.sch]
2020-10-31 small fixes
    [ACTIVE_CONTROL.sch, HYBRID.sch, MCU_AC.sch, MCU_HYBRID.sch, POWER.sch]
2020-10-31 started pcb layout
    [ACTIVE_CONTROL.sch, COTS.sch, HYBRID.sch, JETSON_NANO.sch, MCU_AC.sch, MCU_HYBRID.sch, MPU.sch, POWER.sch]
2020-10-31 resized PCB sheet
    [TARS-MK1.kicad_pcb]
2020-11-02 Restored all sensors to SPI, pruned Teensy footprint of unused pins
    [ACTIVE_CONTROL.sch, COTS.sch, HYBRID.sch, JETSON_NANO.sch, MCU_AC.sch, MCU_HYBRID.sch, MPU.sch, POWER.sch]
2020-11-02 Fixed D36V28F3 footprint, made a Telemetrum footprint and symbol
    [COTS.sch, POWER.sch, TARS-MK1.kicad_pcb]
2020-11-02 moved SL and TM battery connectors
    [TARS-MK1.kicad_pcb]
2020-11-03 Made symbols/footprints for locking Molex connectors
    [COTS.sch, POWER.sch, TARS-MK1.kicad_pcb]
2020-11-03 Wired UARTs between MPU and MCUs
    [MCU_AC.sch, MCU_HYBRID.sch, MPU.sch]
2020-11-03 Added batteries, interim mounting hardware, fancy logos
    [TARS-MK1.kicad_pcb]
2020-11-03 Rounded PCB corners
    [TARS-MK1.kicad_pcb]
2020-11-04 Added telemetry footprint
    [TELEMETRY.sch]
2020-11-04 Started D36V50F6 footprint, still needs work
2020-11-04 added AC connections
    [ACTIVE_CONTROL.sch, COTS.sch, HYBRID.sch, JETSON_NANO.sch, MCU_AC.sch, MCU_HYBRID.sch, MPU.sch, POWER.sch]
2020-11-04 Added 0.5in tabs
    [ACTIVE_CONTROL.sch, COTS.sch, HYBRID.sch, JETSON_NANO.sch, MCU_AC.sch, MCU_HYBRID.sch, MPU.sch, POWER.sch]
2020-11-06 Shortened PCB, made TM/SL veritcal
    [TARS-MK1.kicad_pcb]
2020-11-06 electrical connections, added 3rd active control servo, added footprints for hybrid regulators
    [ACTIVE_CONTROL.sch, COTS.sch, HYBRID.sch, JETSON_NANO.sch, MCU_AC.sch, MCU_HYBRID.sch, MPU.sch, POWER.sch]
2020-11-07 added footprints for resistors
    [TARS-MK1.kicad_pcb]
2020-11-07 just tried the BOM feature
    [TARS-MK1.csv]
2020-11-07 added footprints for capacitors, leds and diods
    [HYBRID.sch, POWER.sch, TARS-MK1.kicad_pcb]
2020-11-07 added footprints for diodes, leds, and capacitors
    [ACTIVE_CONTROL.sch, HYBRID.sch, MCU_AC.sch, MCU_HYBRID.sch, MPU.sch, POWER.sch, TELEMETRY.sch, ZOE_M8Q.sch]
2020-11-07 updated pcb to show new diode footprints
    [TARS-MK1.kicad_pcb]
2020-11-08 Routed various components
    [ACTIVE_CONTROL.sch, COTS.sch, HYBRID.sch, JETSON_NANO.sch, MCU_AC.sch, MCU_HYBRID.sch, MPU.sch, POWER.sch]
2020-11-08 Added LEDs
2020-11-08 extra files
    [TARS-MK1.kicad_pcb]
2020-11-08 added SPI connections and moved LoRa
    [TARS-MK1.kicad_pcb]
2020-11-08 Did PT connections
    [POWER.sch, TARS-MK1.kicad_pcb]
2020-11-09 added power for LoRa
    [TARS-MK1.kicad_pcb]
2020-11-09 added connections b/t beaglebone & LoRa
    [TARS-MK1.kicad_pcb]
2020-11-09 Added Teensy SPI0 connection
    [TARS-MK1.kicad_pcb]
2020-11-09 routing stuffs
    [TARS-MK1.kicad_pcb]
2020-11-09 added hybrid and AC servo connections b/t teenseys
    [TARS-MK1.kicad_pcb]
2020-11-09 added connection b/t teensey and AC & BV servo terminals
    [TARS-MK1.kicad_pcb]
2020-11-09 connected beaglebone to 5V_MPU_SUPPLY
    [TARS-MK1.kicad_pcb]
2020-11-09 Added blinky lights to Beaglebone
    [MCU_AC.sch, TARS-MK1.kicad_pcb]
2020-11-09 Did some routing and fixed ground fills
    [MCU_AC.sch, MCU_HYBRID.sch, POWER.sch, TARS-MK1.kicad_pcb]
2020-11-09 changed power wire thiccness and labels for conns
    [TARS-MK1.kicad_pcb]
2020-11-09 TARS-MK1 Complete!
    [TARS-MK1-B_Cu.gbr, TARS-MK1-B_Mask.gbr, TARS-MK1-B_Paste.gbr, TARS-MK1-B_SilkS.gbr, TARS-MK1-Edge_Cuts.gbr, TARS-MK1-F_Cu.gbr, TARS-MK1-F_Mask.gbr, TARS-MK1-F_Paste.gbr]
2020-11-09 fixed a smol mistake
    [TARS-MK1-B_Cu.gbr, TARS-MK1-B_Mask.gbr, TARS-MK1-B_Paste.gbr, TARS-MK1-B_SilkS.gbr, TARS-MK1-Edge_Cuts.gbr, TARS-MK1-F_Cu.gbr, TARS-MK1-F_Mask.gbr, TARS-MK1-F_Paste.gbr]
2020-11-13 Better Bill of Materials
2021-01-11 let there be TARS-MK2
    [ACTIVE_CONTROL.sch, COTS.sch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]
2021-01-11 let there be TARS-MK2(again)
    [ACTIVE_CONTROL.sch, COTS.sch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]
2021-01-15 TARS-MK2 project initialized
    [ACB.sch, COTS.sch, FCB.sch, MCU_AC.sch, MCU_HYBRID.sch, MPU.sch, POWER.sch, TARS-MK2.kicad_pcb]
2021-01-16 Added ISS logos and titles
    [ACB.sch, COTS.sch, FCB.sch, MCU_AC.sch, MCU_HYBRID.sch, MPU.sch, POWER.sch, TARS-MK2.kicad_pcb]
2021-01-16 moved PCB ISS logo to drawing layer instead of silkscreen
    [TARS-MK2.kicad_pcb]
2021-01-17 Found servo bug
2021-01-17 completed COTS schematics
    [ACB.sch, COTS.sch, FCB.sch, MCU_AC.sch, MCU_HYBRID.sch, MPU.sch, POWER.sch, TARS-MK2.sch]
2021-01-18 Imported MPU OSD3358 symbol and footprint library
    [MPU.sch]
2021-01-18 fixed footprints
2021-01-18 fixed schematic for COTS
    [COTS.sch, TARS-MK2.sch]
2021-01-18 Imported NXP MIMXRT1062DVJ6A (Teensy mcu) symbol and footprint library
    [MCU_AC.sch, MCU_HYBRID.sch]
2021-01-18 Added TLV75733P and some decoupling capacitors to MCU_AC schematic
    [MCU_AC.sch]
2021-01-18 added mounting holes for COTS alitmeters
2021-01-18 added mounting points for COTS
    [MCU_AC.sch, MCU_HYBRID.sch]
2021-01-18 COTS ironed out
    [COTS.sch, MCU_AC.sch, POWER.sch, TARS-MK2.sch]
2021-01-18 meeting notes
    [COTS.sch, TARS-MK2.sch]
2021-01-18 added dxf file for pcb
    [PCB_Substitute.dxf]
2021-01-18 voltage regulators
2021-01-19 Added more passives for MCU + MKL02 chip
    [MCU_AC.sch]
2021-01-20 Added Micro-SD
    [MCU_AC.sch]
2021-01-20 Added flash memory
    notes are in DEV_NOTES
    [MCU_AC.sch]
2021-01-21 Fixed voltage regs D24 + D36V28F3
2021-01-21 switching branches
2021-01-21 Added jetson nano lib + accurate 3D model for it
    [ACB.sch]
2021-01-21 Connected grounds for jetson nano
    [ACB.sch]
2021-01-21 fixing push error from earlier
    [ACB.sch, COTS.sch, FCB.sch, MCU_AC.sch, MCU_HYBRID.sch, MPU.sch, POWER.sch, TARS-MK2.sch]
2021-01-22 Added 5V input decoupling caps
    [ACB.sch]
2021-01-22 Added flash
    [MCU_AC.sch]
2021-01-22 Added I2C + SPI lables + power LED
    [ACB.sch]
2021-01-22 Made multiple projects to support multiple PCBs
    [ACB.kicad_pcb, COTS.kicad_pcb, FCB.kicad_pcb, POWER.kicad_pcb]
2021-01-23 Fixed footprint for COTS Altimeters
2021-01-23 begin PCB schematics for COTS
    [COTS.kicad_pcb, COTS.sch]
2021-01-24 Added power 1V8 and 3V3 power supplies for JN
    [ACB.sch]
2021-01-24 Added libraries for W25Q64
    Changed symbol and added footprint
    [FCB.sch, MCU_AC.sch, MCU_HYBRID.sch, MPU.sch]
2021-01-24 progress on PCB COTS
    [COTS.kicad_pcb]
2021-01-25 finished PCB for COTS. ready for review
    [COTS.kicad_pcb]
2021-01-28 Replaced PSRAM and flash
    [MCU_AC.sch]
2021-01-28 Cleaned up MCU_AC schematic
    [ACB.sch, COTS.sch, FCB.sch, MCU_AC.sch, MCU_HYBRID.sch, MPU.sch, POWER.sch, TARS-MK2.sch]
2021-01-30 MPU Power connections
    [MPU.sch]
2021-01-30 MPU power
    [MPU.sch]
2021-01-30 SD Card work with Maya
    Happy Birthday Locke.
    [MPU.sch]
2021-02-01 Worked on MPU power schematics
    [MPU.sch]
2021-02-02 added dxf folder
    [PCB_Substitute.dxf, mock_450mAh_battery_mount.dxf]
2021-02-03 Made preliminary PCB layout
    [FCB.kicad_pcb]
2021-02-04 Adding reset schematics
    [ACB.sch, MPU.sch]
2021-02-04 Finished micro-SD card
    [FCB.sch, MCU_AC.sch, MCU_HYBRID.sch, MPU.sch]
2021-02-04 Added ground ring around FCB board
    [FCB.kicad_pcb]
2021-02-04 Named the resistors and capacitors
    [MPU.sch]
2021-02-04 Added USB-A1HSW6 libary
    [FCB.sch, MCU_AC.sch, MCU_HYBRID.sch, MPU.sch]
2021-02-04 Adding TPS for the USB into lib files
    USB1 is in works, but not in its final form.
    [MPU.sch]
2021-02-05 added power schematics
    [POWER.sch]
2021-02-10 Added USB1, HOST schematic :heart:
    USB1 HOST schematic
    [MPU.sch]
2021-02-10 Added USB0, CLIENT schematic
    [FCB.sch, MCU_AC.sch, MCU_HYBRID.sch, MPU.sch]
2021-02-10 Updated DEV_NOTES on USB schematics
2021-02-13 merged power branch
    [ACB.sch, COTS.sch, FCB.sch, MCU_AC.sch, MCU_HYBRID.sch, MPU.sch, POWER.sch, TARS-MK2.kicad_pcb]
2021-02-14 Made board outlines uniform among all boards
    [ACB.kicad_pcb, COTS.kicad_pcb, FCB.kicad_pcb, POWER.kicad_pcb]
2021-02-14 Made COTS board outline uniform with all other boards
    [COTS.kicad_pcb]
2021-02-16 Switched labels in MCU schematics to hierarchical labels
    [FCB.sch, MCU_AC.sch, MCU_HYBRID.sch, MPU.sch]
2021-02-16 Added JTAG and 3D step files for OSD3358+MIMX
    [FCB.sch, MPU.sch]
2021-02-16 FCB- added LSM9 from MK-1
    Henry - I copied LSM9 from MK-1, I still had some issues with KiCad so someone should check and make sure I didn't break the github. No worries if I have to copy the sensor again it's kinda fun.
    [COTS.sch, FCB.sch, MCU_AC.sch, MCU_HYBRID.sch, MPU.sch]
2021-02-16 FCB - KX and MS sensors added
    Henry- added LX122 and MS5611 sensors from MK-1. I didn't add any labels other than values for capacitors so labels are still needed for the sensors, capacitors, and jumpers.
    [FCB.sch]
2021-02-17 Made FCB schematic an A3 page
    [FCB.sch, MCU_AC.sch, MCU_HYBRID.sch, MPU.sch]
2021-02-17 Added ZOE-M8Q MK1 to MK2
    [FCB.sch, MCU_AC.sch, MCU_HYBRID.sch, MPU.sch, ZOE-M8Q.sch]
2021-02-18 Added ZOE-M8Q 3D Step file and footprints for passives
    [FCB.sch, MCU_AC.sch, MPU.sch, ZOE-M8Q.sch]
2021-02-18 Added BNO055 IMU
    [FCB.sch]
2021-02-20 revamped GPS schematic
    [FCB.sch, ZOE-M8Q.sch]
2021-02-20 Added SAM-M8Q
    [FCB.sch, ZOE-M8Q.sch]
2021-02-20 Added some components to the FCB layout
    [FCB.kicad_pcb]
2021-02-21 Added 135x240 TFT display
    [FCB.kicad_pcb]
2021-02-21 Added Footprint and Symbol for 1.25mm Molex Connector
2021-02-21 Added LSM9DS1 footprint
    [ACB.sch, COTS.sch, FCB.sch, MCU_AC.sch, MCU_HYBRID.sch, MPU.sch, POWER.sch, TARS-MK2.sch]
2021-02-22 Added footprints to MPU components
    [FCB.sch, MCU_AC.sch, MCU_HYBRID.sch, MPU.sch, ZOE-M8Q.sch]
2021-02-22 MCU_AC microUSB + MCU power circuitry + MLPLus 6pos fix
    [FCB.kicad_pcb, FCB.sch, MCU_AC.sch, MCU_HYBRID.sch, MPU.sch]
2021-02-23 organized power board and added routes
    [POWER.kicad_pcb]
2021-02-24 Added MIMX crystal oscillator + finalized MCU schematic
    [FCB.sch, MCU_AC.sch]
2021-02-24 Added footprints for a few small components
    [MPU.sch]
2021-02-25 Added Traces to COTS board
    [COTS.kicad_pcb, COTS.sch]
2021-02-26 Finished adding traces to COTS board
    [COTS.kicad_pcb]
2021-02-27 Added 6 circuit 2.00mm molex connector.
2021-02-27 fixed minor spacing errors on COTS board
    [COTS.kicad_pcb]
2021-02-27 Added the Molex 6 pin 2.0 mm connections
    [FCB.kicad_pcb, FCB.sch]
2021-02-27 made notes in FCB.sch during meeting
    [FCB.sch, MCU_AC.sch, MCU_HYBRID.sch, MPU.sch, ZOE-M8Q.sch]
2021-02-28 merged everything into main, got rid of TARS-MK2 project
    [ACB.kicad_pcb, COTS.kicad_pcb, COTS.sch, TARS-MK2.kicad_pcb, TARS-MK2.sch]
2021-03-06 Copied components from MCU_AC to MCU_HYBRID
    [FCB.sch, MCU_AC.sch, MCU_HYBRID.sch]
2021-03-12 Started on Teensy pin associations
    [MCU_AC.sch]
2021-03-12 Finished Teensy pin associations
    [MCU_AC.sch]
2021-03-12 added connections for MPU_9250 - CHECK DEV NOTES FOR PINS
    [FCB.sch, MCU_AC.sch, MCU_HYBRID.sch, MPU.sch, ZOE-M8Q.sch]
2021-03-13 major cots changes
    [COTS.kicad_pcb, COTS.sch]
2021-03-13 Henry- Copied RFM95W onto MK-2 FCB
    [FCB.sch, MCU_AC.sch, MCU_HYBRID.sch, MPU.sch, ZOE-M8Q.sch]
2021-03-13 Added MPU SYSBOOT config resistors
    [FCB.kicad_pcb, FCB.sch, MCU_AC.sch, MCU_HYBRID.sch, MPU.sch, ZOE-M8Q.sch]
2021-03-14 Made thermal relief traces in the ESD ring
    [FCB.kicad_pcb]
2021-03-15 Figured out trace/via tolerances
    [FCB.kicad_pcb, FCB.sch, MCU_AC.sch, MPU.sch]
2021-03-15 Wired sensors to MCU
    [FCB.sch]
2021-03-18 added traces to FCB board
    [FCB.kicad_pcb, FCB.sch, MCU_AC.sch, MCU_HYBRID.sch, MPU.sch, ZOE-M8Q.sch]
2021-03-18 started spi connections
    [FCB.kicad_pcb]
2021-03-19 MCU_AC crystal+bootloader routing
    [FCB.kicad_pcb, FCB.sch, MCU_AC.sch, MCU_HYBRID.sch, MPU.sch, ZOE-M8Q.sch]
2021-03-20 rotated left MCU
    [FCB.kicad_pcb, FCB.sch, TARS-MK2.kicad_pcb, TARS-MK2.sch]
2021-03-20 smol spi tweaks
    [FCB.kicad_pcb]
2021-03-22 Added some connections to the resistors
    [FCB.kicad_pcb]
2021-03-22 Various FCB work
    [FCB.kicad_pcb]
2021-03-23 Finished connecting the resistors to the MPU
    [FCB.kicad_pcb]
2021-03-24 MPU crystal + grounding + SYSBOOT tweaks
    [FCB.kicad_pcb, FCB.sch, MPU.sch]
2021-03-25 MPU JTAG + various MCU_AC power component routing
    [FCB.kicad_pcb, MCU_AC.sch, MCU_HYBRID.sch, MPU.sch]
2021-03-25 MCU_AC power circuitry
    [FCB.kicad_pcb, MCU_AC.sch]
2021-03-26 started left mcu routing
    [FCB.kicad_pcb]
2021-03-27 added routes for left mcu
    [FCB.kicad_pcb]
2021-03-27 changed cap footprints
    [FCB.kicad_pcb, FCB.sch, MCU_AC.sch, MCU_HYBRID.sch, MPU.sch, ZOE-M8Q.sch]
2021-03-28 comment on Ben's routing
    [FCB.kicad_pcb]
2021-03-28 Broke out MCU communication buses
    [FCB.sch, MCU_AC.sch, MCU_HYBRID.sch, MPU.sch, ZOE-M8Q.sch]
2021-03-29 Added test points to MCU schematic
    [MCU_AC.sch]
2021-03-29 Wiring of USB and MicroUSB chips
    Wired up USB and MicroUSB Chips
2021-03-30 Allocated LPSPI2 to B2B SPI bus, found SPI mapping of SNS_SPI and MPU-MCU SPI busses
    [FCB.sch, MCU_AC.sch, MCU_HYBRID.sch, MPU.sch]
2021-03-31 Added connections to left MCU
    [FCB.kicad_pcb, MCU_AC.sch]
2021-03-31 added CS pin connections
    [FCB.kicad_pcb]
2021-03-31 Changed names of test points on MCU
    [MCU_AC.sch]
2021-03-31 Updates test points in PCB
    [FCB.kicad_pcb]
2021-03-31 Did test points stuff
    [FCB.kicad_pcb]
2021-04-01 wrapped up CS connections for right MCU
    [FCB.kicad_pcb, FCB.sch, MCU_AC.sch, MCU_HYBRID.sch, MPU.sch, ZOE-M8Q.sch]
2021-04-01 replaced B2B mlplus with 8pos, added phoenix terminals for hybrid
    [FCB.kicad_pcb, FCB.sch, MCU_AC.sch, MCU_HYBRID.sch, MPU.sch, ZOE-M8Q.sch]
2021-04-01 Added fancy 3D files
    [FCB.kicad_pcb, MPU.sch]
2021-04-01 Connected Capacitors to Sensors
    =D
    -Ben and Henry
    [FCB.kicad_pcb]
2021-04-03 Wired the Solenoid Circuit
    [FCB.kicad_pcb, FCB.sch]
2021-04-04 Routed solenoid trigger circuitry
    [FCB.kicad_pcb, FCB.sch]
2021-04-06 Moved TP304; swapped SD card symbols
    [FCB.kicad_pcb, MPU.sch]
2021-04-06 Made TP connections
    [FCB.kicad_pcb]
2021-04-07 MPU sd card and usb routing
    [FCB.kicad_pcb, MPU.sch]
2021-04-07 started left mcu connections
    [FCB.kicad_pcb, FCB.sch, MCU_AC.sch, MCU_HYBRID.sch, MPU.sch, ZOE-M8Q.sch]
2021-04-07 Routed MCU_AC SD card connections
    [FCB.kicad_pcb, FCB.sch, MCU_AC.sch, MCU_HYBRID.sch, MPU.sch, ZOE-M8Q.sch]
2021-04-08 Added more connections to the MCU
    [FCB.kicad_pcb]
2021-04-08 tweaked left mcu connections
    [FCB.kicad_pcb]
2021-04-08 wrapped up cs connections
    [FCB.kicad_pcb]
2021-04-08 added sd card connections
    [FCB.kicad_pcb, FCB.sch, MCU_AC.sch, MCU_HYBRID.sch, MPU.sch, ZOE-M8Q.sch]
2021-04-10 Tweaks for octavo + sexy ISS logo
    [FCB.kicad_pcb, FCB.sch, MCU_AC.sch, MCU_HYBRID.sch, MPU.sch, ZOE-M8Q.sch]
2021-04-10 Moved the bootloader and added all its connections
    [FCB.kicad_pcb, MCU_HYBRID.sch]
2021-04-12 connected MPU-MCU UARTs + MPU-LCD/TLM SPI bus + misc
    [FCB.kicad_pcb, FCB.sch, MCU_HYBRID.sch, MPU.sch]
2021-04-12 MPU-TLM GPIO connections + LCD circuitry
    [FCB.kicad_pcb, FCB.sch, MPU.sch]
2021-04-12 Started on telemetry connections
    [FCB.kicad_pcb]
2021-04-13 Added LoRa Module connections
    [FCB.kicad_pcb]
2021-04-13 started new spi bus
    [FCB.kicad_pcb, FCB.sch, MCU_AC.sch, MCU_HYBRID.sch, MPU.sch, ZOE-M8Q.sch]
2021-04-13 GPS Placement
    [FCB.kicad_pcb]
2021-04-13 ZOE-M8Q connections (Aeroka)
    [FCB.kicad_pcb]
2021-04-15 Added connections to SPI bus and molex connectors
    [FCB.kicad_pcb]
2021-04-15 servo bus done
    [FCB.kicad_pcb]
2021-04-15 left mcu bootloader
    [FCB.kicad_pcb]
2021-04-15 big chungus
    [FCB.kicad_pcb, FCB.sch, MCU_AC.sch, MCU_HYBRID.sch, MPU.sch, ZOE-M8Q.sch]
2021-04-15 PT circuit + various routing
    [FCB.kicad_pcb, FCB.sch, MPU.sch]
2021-04-15 mcu to mpu connnections
    [FCB.kicad_pcb]
2021-04-15 MPU connections and various
    [FCB.kicad_pcb]
2021-04-16 rip SAM-M8
    [COTS.kicad_pcb, FCB.kicad_pcb]
2021-04-16 left mcu power connections
    [FCB.kicad_pcb, FCB.sch, MCU_AC.sch, MCU_HYBRID.sch, MPU.sch, ZOE-M8Q.sch]
2021-04-17 MPU reset circutry + various tweaks
    [FCB.kicad_pcb, FCB.sch, MCU_AC.sch, MCU_HYBRID.sch, MPU.sch, ZOE-M8Q.sch]
2021-04-17 Changes to COTS
    [COTS.kicad_pcb]
2021-04-17 MCU_HYBRID test points
    [FCB.kicad_pcb, MCU_HYBRID.sch, MPU.sch]
2021-04-17 COTS board stuff
    [COTS.kicad_pcb, COTS.sch]
2021-04-17 Power Board molex connectors
    [POWER.kicad_pcb, POWER.sch]
2021-04-18 PT+SLND connections + various tweaks
    [ACB.kicad_pcb, COTS.kicad_pcb, FCB.kicad_pcb, FCB.sch, MCU_AC.sch, POWER.kicad_pcb]
2021-04-18 Routed Power Board
    [POWER.kicad_pcb, POWER.sch]
2021-04-19 Final COTS silkscree+Ben memes
    [COTS.kicad_pcb]
2021-04-19 gps battery connector
    [FCB.kicad_pcb, FCB.sch, MCU_AC.sch, MCU_HYBRID.sch, MPU.sch, ZOE-M8Q.sch]
2021-04-19 POWER board completed woo
    [POWER.kicad_pcb, POWER.sch]
2021-04-19 gps cs pin
    [COTS.kicad_pcb, FCB.kicad_pcb, FCB.sch]
2021-04-19 mcu leds
    [FCB.kicad_pcb]
2021-04-19 flipped names
    [FCB.kicad_pcb]
2021-04-19 re-generated copper fills + more chungus
    [COTS.kicad_pcb, FCB.kicad_pcb, POWER.kicad_pcb]
2021-04-22 TARS-MK2 rev.A complete!
    [COTS-B_Cu.gbr, COTS-B_Mask.gbr, COTS-B_Paste.gbr, COTS-B_SilkS.gbr, COTS-Edge_Cuts.gbr, COTS-F_Cu.gbr, COTS-F_Mask.gbr, COTS-F_Paste.gbr]
2021-04-24 Repo cleanup + archive of MK2 rev.A board
    [COTS.kicad_pcb, COTS.sch, FCB.kicad_pcb, FCB.sch, MCU_AC.sch, MCU_HYBRID.sch, MPU.sch, PCB_Substitute.dxf]
2021-04-24 Archived MK1 and MK2_rev.A as .zip files
    [COTS.kicad_pcb, COTS.sch, FCB.kicad_pcb, FCB.sch, MCU_AC.sch, MCU_HYBRID.sch, MPU.sch, POWER.kicad_pcb]
2021-07-26 Fixed mistakes in comments in FCB.sch
    [FCB.sch]
2021-09-25 Created FCB-Lite!
    [FCB-Lite.kicad_pcb, FCB-Lite.sch]
2021-09-25 added teensy libraries
    [FCB-Lite.sch, PCB_Substitute.dxf]
2021-09-25 started connecting LSMDS91 IMU
    [FCB-Lite.sch]
2021-09-26 LSM9DS1 schematic layout ready for review
    [FCB-Lite.sch]
2021-09-26 started KX122 imu connections
    [FCB-Lite.sch]
2021-09-28 Added B2B molex connectors to the FCB-Lite schematic
    [FCB-Lite.sch]
2021-09-28 Added MS5611 Barometer to FCB-Lite
    [FCB-Lite.sch]
2021-09-28 Added MPU9250 to FCB-Lite.sch
    [FCB-Lite.sch]
2021-09-29 kx122
    Finished KX122
    [FCB-Lite.sch]
2021-09-30 added ZOE-MQ8 sparkfun breakout symbol to library, did not add footprint
2021-10-01 Added TARS_Lite Outline
    [FCB-Lite.kicad_pcb]
2021-10-01 Updated LSM9DS1 capacitor footprints
    [FCB-Lite.sch]
2021-10-01 Fixed KX122
    Fixed KX122 Reviews
    [COTS.sch, FCB-Lite.sch, FCB.sch, MCU_AC.sch, MCU_HYBRID.sch, MPU.sch, POWER.sch, ZOE-M8Q.sch]
2021-10-01 Created ZOE-M8Q Breakout Footprint
2021-10-01 added footprints for MPU-9250 assembly
    [FCB-Lite.sch]
2021-10-01 fixed all issues pertaining to ZOE-MQ8-Breakout symbol/footprint
    [FCB-Lite.sch]
2021-10-02 started teensy pin connections
    [FCB-Lite.sch]
2021-10-02 Continued working on Teensy Connections
    [FCB-Lite.sch]
2021-10-02 worked on LSM9D connection to teensy
    [FCB-Lite.sch]
2021-10-03 added snesors pins to board
    [FCB-Lite.kicad_pcb, FCB-Lite.sch]
2021-10-03 Added Teensy Footprint to FCB-Lite
    [FCB-Lite.kicad_pcb, FCB-Lite.sch]
2021-10-03 Added footprints to MS5611 Barometer
    [FCB-Lite.sch]
2021-10-03 Fixups with resistor packages, added SPI Pullups, connected Teensy to b2b data lines
    [FCB-Lite.sch]
2021-10-03 added MPU 9250 CS pin connection to teensy
    [FCB-Lite.kicad_pcb, FCB-Lite.sch]
2021-10-04 Made components on PCB consistent with schematic
    [FCB-Lite.kicad_pcb]
2021-10-05 Fixed and placed Molex B2B connectors on FCB-Lite
    [FCB-Lite.kicad_pcb, FCB-Lite.sch]
2021-10-05 Added design rules to FCB-Lite, assuming OSHPark as the manufacturer
    [FCB-Lite.kicad_pcb]
2021-10-05 started PCB; read dev notes for details
    [FCB-Lite.kicad_pcb]
2021-10-05 Added 3.3V Rail
    [FCB-Lite.kicad_pcb]
2021-10-05 Connected MPU
    Connected MPU
    [FCB-Lite.kicad_pcb]
2021-10-05 worked on FCB Lite
    [FCB-Lite.kicad_pcb]
2021-10-06 added capacitors and more wiring
    [FCB-Lite.kicad_pcb]
2021-10-06 board fixups and undeleted dev notes
    [FCB-Lite.kicad_pcb]
2021-10-06 connected sensors to SPI
    [FCB-Lite.kicad_pcb]
2021-10-06 Added Board-To-Board Connections
    [FCB-Lite.kicad_pcb]
2021-10-06 Finished routing FCB-Lite
    [FCB-Lite.kicad_pcb, FCB-Lite.sch]
2021-10-06 minor fixups with routing
    [FCB-Lite.kicad_pcb]
2021-10-06 FCB-Lite silkscreen tweaks
    [FCB-Lite.kicad_pcb]
2021-10-06 fixed ground connection
    [FCB-Lite.kicad_pcb]
2021-10-06 added funnys to FCB lite PCB and did minor fixes
    [FCB-Lite.kicad_pcb]
2021-10-06 removed unneeded vias
    [FCB-Lite.kicad_pcb]
2021-10-06 fixed SPI pullup resistors
    [FCB-Lite.kicad_pcb]
2021-10-06 made memes smaller on FCB-Lite
    [FCB-Lite.kicad_pcb]
2021-10-06 refilled copper layers
    [FCB-Lite.kicad_pcb]
2021-10-07 Added I2C/UART expansion port + various small tweaks
    [FCB-Lite.kicad_pcb, FCB-Lite.sch]
2021-10-07 regenerated copper layer
    [FCB-Lite.kicad_pcb]
2021-10-08 generated gerbers and excellon drill files
    [FCB-Lite-B_Cu.gbr, FCB-Lite-B_Mask.gbr, FCB-Lite-B_Paste.gbr, FCB-Lite-B_SilkS.gbr, FCB-Lite-Edge_Cuts.gbr, FCB-Lite-F_Cu.gbr, FCB-Lite-F_Mask.gbr, FCB-Lite-F_Paste.gbr]
2021-10-10 fixed resistor values
    [FCB-Lite.sch]
2021-12-06 Created DAQ files
    [DAQ.kicad_pcb, DAQ.sch, FCB.kicad_pcb]
2021-12-23 created starter files for TARS MK3
    [COTS-B_Cu.gbr, COTS-B_Mask.gbr, COTS-B_Paste.gbr, COTS-B_SilkS.gbr, COTS-Edge_Cuts.gbr, COTS-F_Cu.gbr, COTS-F_Mask.gbr, COTS-F_Paste.gbr]
2021-12-24 Added LSM9DS1
    Created Sensor Suite Schematic and added B2B outline and LSM9DS1 Schematic
    [SENSOR_SUITE.sch]
2021-12-24 Updated DEV_NOTES.txt
    updated dev notes
    [SENSOR_SUITE.sch]
2021-12-24 added barometer schematic
2021-12-24 DEV NOTES and minor fixes
    [SENSOR_SUITE.sch]
2021-12-27 Added H3LIS331DL to sensor suite schematic
    [SENSOR_SUITE.kicad_sch]
2021-12-28 Designed sensor suite symbol and hooked it up to the footprint
2021-12-29 Add ZOE-M8Q schematic
    Add ZOE-M8Q schematic
    [SENSOR_SUITE.sch, ZOE-M8Q.sch]
2021-12-29 updated ZOE-M8Q schematic
    updated ZOE-M8Q schematic
    [ZOE-M8Q.sch]
2021-12-29 added SENSOR SUITE PCB
    added SENSOR SUITE PCB
    [SENSOR_SUITE.kicad_pcb]
2021-12-29 Added KX-122 HIGH-G
    Added KX-122 HIGH-G
    [SENSOR_SUITE.sch, ZOE-M8Q.sch]
2021-12-29 update ZOE-M8Q to Kicad 6 ver.
    update ZOE-M8Q to Kicad 6 ver.
    [ZOE-M8Q.kicad_sch]
2021-12-30 Updated KX-122 HIGH-G for ver. 6
    Updated KX-122 HIGH-G for ver. 6
    [SENSOR_SUITE.kicad_sch]
2021-12-30 Added ZED_F9P schematic
    Added ZED_F9P schematic
    [SENSOR_SUITE.kicad_sch, ZED_F9P.kicad_sch]
2021-12-30 added fcb power system
2021-12-30 added AC SERVO POWER SYSTEM to PMB Schematic
    [POWER.kicad_sch]
2021-12-31 Finished ZED-F9P schematic
    Finished ZED-F9P schematic
    [SENSOR_SUITE.kicad_sch, ZED_F9P.kicad_sch]
2022-01-01 Added the 6V hybrid power system (batt 3.1) to the schematic
    [POWER.kicad_sch]
2022-01-01 fixups with sensor suite files
    [SENSOR_SUITE.kicad_sch]
2022-01-01 ZED-F9P fixups and other sensor suite stuff
    [SENSOR_SUITE.kicad_sch, ZED_F9P.kicad_sch]
2022-01-01 fixed prior commit
    [SENSOR_SUITE.kicad_sch]
2022-01-03 added UART connections to ZOE m8q and slightly changed sensor suite pinout, also added 3V battery backup option should we want it
    [SENSOR_SUITE.kicad_sch, ZED_F9P.kicad_sch, ZOE-M8Q.kicad_sch]
2022-01-03 Added Low Noise Amplifier to ZED-F9P
    Added Low Noise Amplifier to ZED-F9P
    [SENSOR_SUITE.kicad_sch, ZED_F9P.kicad_sch, ZOE-M8Q.kicad_sch]
2022-01-05 connected stuff to sensor module on schematic, sensor suite schematic done
    [SENSOR_SUITE.kicad_sch]
2022-01-05 Starting routing
    Starting routing
    [SENSOR_SUITE.kicad_pcb, SENSOR_SUITE.kicad_sch, ZED_F9P.kicad_sch, ZOE-M8Q.kicad_sch]
2022-01-05 Routed KX122
    [SENSOR_SUITE.kicad_pcb]
2022-01-05 Add ZOE-M8Q footprint to Sensor Suite
    Add ZOE-M8Q footprint to Sensor Suite
    [SENSOR_SUITE.kicad_pcb, SENSOR_SUITE.kicad_sch, ZOE-M8Q.kicad_sch]
2022-01-06 Added new sensor suite
    Added new sensor suite
2022-01-06 worked on PMB schematic and researched crystal oscillator
    [POWER.kicad_sch]
2022-01-07 replicated Adafruit RFM69HCW and RFM9X LoRa Packet Radio Breakouts
    [COTS_TELEM.kicad_sch]
2022-01-07 Adding Teensy to FCB
    Did half of teensy schematic so that Arna does other half
    [FCB.kicad_sch]
2022-01-07 worked on teensy on fcb with daniel
    [FCB.kicad_sch]
2022-01-07 Continued working on ATmega328 schematic on PMB
    [POWER.kicad_sch]
2022-01-08 Added template board
    [TEMPLATE.kicad_pcb, TEMPLATE.kicad_sch]
2022-01-08 add new sensors
    add new sensors
2022-01-09 Added the 9*12 board and SPI lines
    Added the 9*12 board and SPI lines
    [SENSOR_SUITE.kicad_pcb, SENSOR_SUITE.kicad_sch]
2022-01-09 updated DEV-NOTE
    updated DEV-NOTE
    [SENSOR_SUITE.kicad_pcb, SENSOR_SUITE.kicad_sch]
2022-01-10 Routed MS5611
    [SENSOR_SUITE.kicad_pcb]
2022-01-11 Added vias for B2B
    [TEMPLATE.kicad_pcb]
2022-01-11 save point 1
    [TEMPLATE.kicad_pcb]
2022-01-11 Routed B2Bs
    [TEMPLATE.kicad_pcb, TEMPLATE.kicad_sch]
2022-01-11 Finished B2B fully
    [TEMPLATE.kicad_pcb]
2022-01-11 added arduino feather and RFM96 dimensions to template board
    [TEMPLATE.kicad_pcb]
2022-01-11 Routed KX122
    Routed KX122
    [SENSOR_SUITE.kicad_pcb, SENSOR_SUITE.kicad_sch]
2022-01-11 started FCB
    [FCB.kicad_pcb, FCB.kicad_sch, FCB.sch]
2022-01-11 Routed ZOE-M8Q
    Routed ZOE-M8Q
    [SENSOR_SUITE.kicad_pcb, SENSOR_SUITE.kicad_sch]
2022-01-11 DEV NOTES
    DEV NOTES
    [SENSOR_SUITE.kicad_pcb]
2022-01-12 Edited ZED-F9P schematic
    Edited ZED-F9P schematic
    [SENSOR_SUITE.kicad_pcb, SENSOR_SUITE.kicad_sch, ZED_F9P.kicad_sch]
2022-01-12 Added some minor monitoring to PMB
    [POWER.kicad_sch]
2022-01-12 AV321 Wiring FCB
2022-01-13 Removed .sch and .pro file cruft. Please upgrade to 6.0 if you wish to work on PCBs from now on
    [COTS_TELEM.sch, POWER.sch, SENSOR_SUITE.sch, ZOE-M8Q.sch]
2022-01-13 minor cots telem fixups
    [COTS_TELEM.kicad_sch]
2022-01-13 routed accelerometer chip
2022-01-13 routed acceleromater
    [SENSOR_SUITE.kicad_pcb]
2022-01-13 applied template to pmb
    [POWER.kicad_pcb, POWER.kicad_sch]
2022-01-14 laid out new B2B spec schematic
    [TEMPLATE_2.kicad_pcb, TEMPLATE_2.kicad_sch]
2022-01-14 traced LSM9DS1 and unified the via size
    traced LSM9DS1 and unified the via size
    [SENSOR_SUITE.kicad_pcb, SENSOR_SUITE.kicad_sch]
2022-01-14 added sensor suites edge cuts
    added sensor suite edge cuts
    [SENSOR_SUITE.kicad_pcb]
2022-01-15 started routing 9v converter on pmb
    [POWER.kicad_pcb]
2022-01-15 Finished b2b template v2 schemtic
    [TEMPLATE_2.kicad_sch]
2022-01-15 Laid out template PCB v2
    [TEMPLATE_2.kicad_pcb]
2022-01-16 ZOE-M8Q Routing
    ZOE-M8Q Routing
    [SENSOR_SUITE.kicad_pcb, ZOE-M8Q.kicad_sch]
2022-01-17 Added template status LEDs
    [TEMPLATE_2.kicad_pcb]
2022-01-17 laid out template v2!
    [TEMPLATE_2.kicad_pcb]
2022-01-17 added uFL footprint from adafruit breakout
    [SENSOR_SUITE.kicad_sch, ZOE-M8Q.kicad_sch]
2022-01-17 Deleted ZED-F9P from Sensor schematic
    [SENSOR_SUITE.kicad_sch]
2022-01-17 Completed sensor suite and added uFL connector
    [SENSOR_SUITE.kicad_pcb, SENSOR_SUITE.kicad_sch, ZOE-M8Q.kicad_sch]
2022-01-17 Applied template to COTS_TELEM
    [COTS_TELEM.kicad_pcb, COTS_TELEM.kicad_sch]
2022-01-17 Finished COTS_TELEM PCB
    [COTS_TELEM.kicad_pcb, COTS_TELEM.kicad_sch]
2022-01-17 Applied new template to POWER
    [POWER.kicad_pcb, POWER.kicad_sch]
2022-01-17 Updated PCB from POWER schematic
    [POWER.kicad_pcb, POWER.kicad_sch]
2022-01-17 Put regulators on PMB and began layout
    [POWER.kicad_pcb, POWER.kicad_sch]
2022-01-17 Put regulators on PMB and began layout part 2
    [POWER.kicad_pcb]
2022-01-17 Applied template to FCB
    [FCB.kicad_pcb, FCB.kicad_sch]
2022-01-21 moved some components
    moved some components
    [POWER.kicad_pcb]
2022-01-21 updated powerboard footprint
    updated powerboard footprint
    [POWER.kicad_pcb, POWER.kicad_sch]
2022-01-21 update power board footprint
    update power board footprint
    [POWER.kicad_pcb]
2022-01-22 finished POWER
    [POWER.kicad_pcb, POWER.kicad_sch]
2022-01-23 revised powerboard routing
    [POWER.kicad_pcb]
2022-01-25 added feather
    [COTS_TELEM.kicad_sch]
2022-01-26 restored corrupted power board files to working versions
    [POWER.kicad_pcb]
2022-01-26 minor tweaks
    [COTS_TELEM.kicad_sch, SENSOR_SUITE.kicad_pcb]
2022-01-26 Connected continuity check pins correctly on PMB schematic
    [POWER.kicad_sch]
2022-01-26 applied prior changes to PMB
    [POWER.kicad_pcb]
2022-01-26 set up FCB to use 4.0
    [FCB.kicad_pcb]
2022-01-27 Sensor suite cut corner
    sensor suite got a diet
    [SENSOR_SUITE.kicad_pcb]
2022-01-27 updated sensor suite on FCB
    updated sensor suite on FCB
    [FCB.kicad_pcb, FCB.kicad_sch]
2022-01-28 Added LEDs to edge of FCB and connected them to Teensy
    [FCB.kicad_pcb]
2022-01-29 Routed Sensor Suite to Teensy
    [FCB.kicad_pcb]
2022-01-29 pain, started shifting B2B connectors
    [FCB.kicad_pcb, FCB.kicad_sch]
2022-01-29 moved b2bs on fcb again
    [FCB.kicad_pcb, FCB.kicad_sch]
2022-01-29 trace COTS and TELEM
    trace COTS and TELEM
    [COTS_TELEM.kicad_pcb]
2022-01-29 Created the passive board schematic
    [ALTIMETER_HOLDER.kicad_pcb, ALTIMETER_HOLDER.kicad_sch, COTS.kicad_sch]
2022-01-29 Routed FCB
    [FCB.kicad_pcb]
2022-01-29 Moved B2B connectors on PMB
    [POWER.kicad_pcb]
2022-01-30 worked on routing pmb
    [POWER.kicad_pcb]
2022-01-30 Made Sensor Breakout
    [SENSOR_BREADBOARD.kicad_pcb, SENSOR_BREADBOARD.kicad_sch]
2022-01-30 Routed Sensor Suite Breakout
    [SENSOR_BREADBOARD.kicad_pcb, SENSOR_BREADBOARD.kicad_sch]
2022-01-30 Modified passive board to be correct
    [ALTIMETER_HOLDER.kicad_sch]
2022-01-30 continued holder board
    [ALTIMETER_HOLDER.kicad_pcb]
2022-01-31 Created passive COTS holder
    [ALTIMETER_HOLDER.kicad_pcb, ALTIMETER_HOLDER.kicad_sch]
2022-02-01 added LEDs to FCB
    ADD LEDs to FCB
    [FCB.kicad_pcb]
2022-02-01 Detect multiple issues in FCB
    Detect multiple issues in FCB
    [FCB.kicad_pcb, FCB.kicad_sch, SENSOR_SUITE.kicad_sch]
2022-02-01 added edge cuts to breadboard breakout
    [SENSOR_BREADBOARD.kicad_pcb]
2022-02-01 created other projects folder. For stuff not directly related to whatever flies on the rocket
    [SENSOR_BREADBOARD.kicad_pcb, SENSOR_BREADBOARD.kicad_sch]
2022-02-01 allocated telemetry b2b and added battery connector
    [COTS_TELEM.kicad_sch, FCB.kicad_sch, POWER.kicad_pcb, POWER.kicad_sch]
2022-02-02 Altimeter Holder - Stratologger & Telemetrum Flipped
    [ALTIMETER_HOLDER.kicad_pcb]
2022-02-02 worked on teensy schematic
    [FCB.kicad_sch]
2022-02-02 added new sensor module footprint 8x10 version
    added new sensor module footprint 8x10 version
2022-02-03 Prepared FCB for routing
    [FCB.kicad_pcb, FCB.kicad_sch]
2022-02-03 Prepared sensor suite for change to 8x10
    [SENSOR_SUITE.kicad_pcb, SENSOR_SUITE.kicad_sch]
2022-02-04 deleted traces
    [SENSOR_SUITE.kicad_pcb]
2022-02-04 more routing
    [FCB.kicad_sch]
2022-02-04 zoe routing
    [SENSOR_SUITE.kicad_pcb]
2022-02-04 finished routing sensor suite
    [SENSOR_SUITE.kicad_pcb]
2022-02-04 Changed dimensions of passive board for AV structures v385012
    [ALTIMETER_HOLDER.kicad_pcb]
2022-02-04 More passive board stuff
    [ALTIMETER_HOLDER.kicad_pcb]
2022-02-04 added sensor suite edge cut
    [SENSOR_SUITE.kicad_pcb]
2022-02-04 finished sensors
    [SENSOR_SUITE.kicad_pcb, SENSOR_SUITE.kicad_sch]
2022-02-04 laid out passive board again
    [ALTIMETER_HOLDER.kicad_pcb]
2022-02-05 PMB fixups
    [COTS_TELEM.kicad_pcb, FCB.kicad_pcb, POWER.kicad_sch, SENSOR_SUITE.kicad_pcb, SENSOR_SUITE.kicad_sch, ZOE-M8Q.kicad_sch]
2022-02-05 Power Silkscreen
    [POWER.kicad_pcb]
2022-02-05 SilkScreen for Cots Telem
    [COTS_TELEM.kicad_pcb]
2022-02-05 sensorsuite breakout board
    [SENSOR_BREADBOARD_8X10.kicad_pcb, SENSOR_BREADBOARD_8X10.kicad_sch]
2022-02-05 silkscreen for sensor suite
    [SENSOR_SUITE.kicad_pcb]
2022-02-05 Removed Wiring for rewiring
    [COTS_TELEM.kicad_pcb]
2022-02-06 new tracing
    [COTS_TELEM.kicad_pcb]
2022-02-06 moved connectors to top
    [COTS_TELEM.kicad_pcb, COTS_TELEM.kicad_sch, FCB.kicad_sch, POWER.kicad_pcb, POWER.kicad_sch]
2022-02-06 refilled PMB
    [POWER.kicad_pcb]
2022-02-06 restored broken schematic file from backup
    [SENSOR_BREADBOARD_8X10.kicad_sch]
2022-02-06 added b2b labels and made power lines thicker on PMB
    [COTS_TELEM.kicad_pcb, FCB.kicad_pcb, POWER.kicad_pcb]
2022-02-06 add evil anshuck
    [FCB.kicad_pcb]
2022-02-06 update evil
    [FCB.kicad_pcb]
2022-02-06 added silkscreen to sensor breakout
    [SENSOR_BREADBOARD_8X10.kicad_pcb, SENSOR_BREADBOARD_8X10.kicad_sch]
2022-02-06 add memes
    [COTS_TELEM.kicad_pcb, FCB.kicad_pcb]
2022-02-06 add amogus
    [SENSOR_SUITE.kicad_pcb]
2022-02-06 add words
    [FCB.kicad_pcb]
2022-02-06 add tars
    [POWER.kicad_pcb]
2022-02-07 added names
    [COTS_TELEM.kicad_pcb, FCB.kicad_pcb, POWER.kicad_pcb]
2022-02-07 Add Endurance
    [COTS_TELEM.kicad_pcb]
2022-02-07 remove evil anshucc
    [FCB.kicad_pcb, POWER.kicad_pcb]
2022-02-07 add larger endurance
    [COTS_TELEM.kicad_pcb]
2022-02-07 final fixes
    [COTS_TELEM.kicad_pcb, FCB.kicad_pcb, POWER.kicad_pcb]
2022-02-07 moved battery and other stuff
    [COTS_TELEM.kicad_pcb, FCB.kicad_pcb, POWER.kicad_pcb]
2022-02-07 fixed smol trace bugs on all boards
    [ALTIMETER_HOLDER.kicad_pcb, COTS_TELEM.kicad_pcb, FCB.kicad_pcb, POWER.kicad_pcb, SENSOR_SUITE.kicad_pcb]
2022-02-07 fixed edge cuts on altimeter holder
    [ALTIMETER_HOLDER.kicad_pcb]
2022-02-07 correct things
    [COTS_TELEM.kicad_pcb, FCB.kicad_pcb, POWER.kicad_pcb]
2022-02-07 redesigned altimeter holder for the millionth time
    [ALTIMETER_HOLDER.kicad_pcb]
2022-02-07 altimeter holder redesign changed a bit
    [ALTIMETER_HOLDER.kicad_pcb]
2022-02-08 deleted Valorant related meme footprints
    [FCB.kicad_pcb]
2022-02-08 minor changes on silkscreen for the batteries
    [ALTIMETER_HOLDER.kicad_pcb, COTS_TELEM.kicad_pcb, FCB.kicad_pcb, POWER.kicad_pcb, SENSOR_SUITE.kicad_pcb]
2022-02-08 added ISS LOGO
    [ALTIMETER_HOLDER.kicad_pcb, COTS_TELEM.kicad_pcb, FCB.kicad_pcb, POWER.kicad_pcb, SENSOR_SUITE.kicad_pcb]
2022-02-08 added sensor suite words
    [SENSOR_SUITE.kicad_pcb]
2022-02-09 nuked AC switches
2022-02-09 Revert "nuked AC switches"
    This reverts commit 708a14a5db239bf08ea2a2e44833e946bca04865.
2022-02-09 add ham for peter
    [COTS_TELEM.kicad_pcb, FCB.kicad_pcb]
2022-02-09 correct typos
    [FCB.kicad_pcb]
2022-02-09 small tweaks to cots telem
    [COTS_TELEM.kicad_pcb]
2022-02-09 moved caps on pmb
    [POWER.kicad_pcb]
2022-02-10 fixed edge cuts on COTS_TELEM board
    [COTS_TELEM.kicad_pcb, COTS_TELEM.step, FCB.kicad_pcb]
2022-02-10 add mountingholes
    [COTS_TELEM.kicad_pcb, FCB.kicad_pcb, POWER.kicad_pcb]
2022-02-10 minor tweaks on pmb
    [POWER.kicad_pcb]
2022-02-10 fixed trace
    [POWER.kicad_pcb]
2022-02-10 Add standoff pads
    [ALTIMETER_HOLDER.kicad_pcb, COTS_TELEM.kicad_pcb, FCB.kicad_pcb, POWER.kicad_pcb]
2022-02-10 minor change on Telem
    [COTS_TELEM.kicad_pcb]
2022-02-10 minor trace changes for servos on telem board (Hi Kenneth)
    [COTS_TELEM.kicad_pcb, FCB.kicad_pcb, POWER.kicad_pcb]
2022-02-11 moved voltage regulators on PMB
    [POWER.kicad_pcb]
2022-02-11 remove battery on FCB
    [FCB.kicad_pcb]
2022-02-11 added 3v linear
    [FCB.kicad_pcb]
2022-02-11 fixed traces on FCB
    [FCB.kicad_pcb]
2022-02-11 generated gerbers
    [ALTIMETER_HOLDER-B_Cu.gbr, ALTIMETER_HOLDER-B_Mask.gbr, ALTIMETER_HOLDER-B_Paste.gbr, ALTIMETER_HOLDER-B_Silkscreen.gbr, ALTIMETER_HOLDER-Edge_Cuts.gbr, ALTIMETER_HOLDER-F_Cu.gbr, ALTIMETER_HOLDER-F_Mask.gbr, ALTIMETER_HOLDER-F_Paste.gbr]
2022-02-12 add values to sensor suite sch
    [SENSOR_SUITE.kicad_sch]
2022-02-12 created DAQ project and began schematic with teensy and LED
    [DAQ.kicad_pcb, DAQ.kicad_sch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]
2022-02-12 added another led
    [DAQ.kicad_sch]
2022-02-12 added led
    [DAQ.kicad_sch]
2022-02-15 changed the trumpet skeleton position on FCB
    changed the trumpet skeleton position on FCB
    [FCB.kicad_pcb]
2022-02-15 replaced right footprint for standoffs on ALTIMETER HOLDER
    [ALTIMETER_HOLDER.kicad_pcb, POWER.kicad_pcb]
2022-02-19 started 3v3 regulator recreation
    [AP63203_Recreation.kicad_pcb, AP63203_Recreation.kicad_sch]
2022-02-19 finished schematic
    [AP63203_Recreation.kicad_sch]
2022-02-19 PowerBoost500 Schematic
    [POWERBOOST500.kicad_pcb, POWERBOOST500.kicad_sch]
2022-02-19 created schematic
    [5v buck .kicad_pcb, 5v buck .kicad_sch, COTS_TELEM.csv]
2022-03-02 fixed file names
    [5v buck .kicad_pcb, 5v buck .kicad_sch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]
2022-03-03 updated schematic with led colors
2022-03-24 Starting project
    [SKY65366_BDA.kicad_pcb, SKY65366_BDA.kicad_sch]
2022-03-24 Started Schematic
    [SKY65366_BDA.kicad_sch]
2022-03-24 3V3 label
    3V3 label
    [SKY65366_BDA.kicad_pcb]
2022-03-24 Power Schematics
    [SKY65366_BDA.kicad_sch]
2022-03-24 update on cots telem
    add sky amp
    [COTS_TELEM.kicad_sch]
2022-03-24 delete sky amp schimatic
    delete sky amp schimatic
    [SKY65366_BDA.kicad_pcb, SKY65366_BDA.kicad_sch]
2022-03-24 add passives to cots telem
    add passives to cots telem
    [COTS_TELEM.kicad_sch]
2022-03-24 Set RX1 and RX2 Labels
    Set RX1 and RX2 Labels
    [COTS_TELEM.kicad_sch]
2022-03-28 Black Box Project
    [Black Box.kicad_pcb, Black Box.kicad_sch]
2022-03-28 Added Arna and Rohini's black box initial work
    [Black Box.kicad_pcb, Black Box.kicad_sch, Blackbox.kicad_pcb, Blackbox.kicad_sch]
2022-03-29 Added Jumpers
    Added Jumpers
    [COTS_TELEM.kicad_sch]
2022-03-29 update board for buffett
    update board for buffett
    [COTS_TELEM.kicad_sch]
2022-03-29 Conencted TR, EN, BYP to gpio
    Conencted TR, EN, BYP to gpio
    [COTS_TELEM.kicad_sch]
2022-03-29 Start 3V3 Regulator
    Start 3V3 Regulator
    [3V3_REGULATOR.kicad_sch]
2022-03-29 Did schematic
    Did schematic
    [3V3_REGULATOR.kicad_pcb, 3V3_REGULATOR.kicad_sch]
2022-03-30 fix trace and passive on PMB
    fix trace and passive on PMB
    [POWER.kicad_pcb]
2022-03-31 finished DIY 3.3V regulator
    [3V3_REGULATOR.kicad_pcb, 3V3_REGULATOR.kicad_sch]
2022-04-02 startingwiring rp2040
    [Blackbox.kicad_pcb, Blackbox.kicad_sch]
2022-04-02 created L4971 symbol
    [COMBINED_REGULATOR.kicad_pcb, COMBINED_REGULATOR.kicad_sch]
2022-04-02 started layout of srad regulators
    [COMBINED_REGULATOR.kicad_sch]
2022-04-02 add B2B_ZOE-M8Q_BKT_CS pin
    add B2B_ZOE-M8Q_BKT_CS pin
    [FCB.kicad_pcb, FCB.kicad_sch]
2022-04-03 Pin Assingments RP2040
    [Blackbox.kicad_sch]
2022-04-03 Regulator Symbols
    Created Symbols for LM2676, LM2677, LM2678
2022-04-03 SD card to blackbox
    [Blackbox.kicad_sch]
2022-04-04 Regulator Schematics
    Schematics for SI-8050JD, SI-8050Y, and SI-8050S
2022-04-06 worked on rp2040
    [Blackbox.kicad_sch]
2022-04-09 board layout for blackbox
    [Blackbox.kicad_sch]
2022-04-09 Finish MicroSD and add Headers
    [Blackbox.kicad_sch]
2022-04-10 worked on srad regulators
    [COMBINED_REGULATOR.kicad_sch]
2022-04-10 Update footprints MicroSD
    [Blackbox.kicad_sch]
2022-04-10 merged stuff for blackbox
    [Blackbox.kicad_pcb]
2022-04-10 made kicad not treat kicad files as text
2022-04-10 placed things on blackbox
    [Blackbox.kicad_pcb, Blackbox.kicad_sch]
2022-04-11 fixed more merge conflicts
    [Blackbox.kicad_pcb, Blackbox.kicad_sch]
2022-04-17 Changes to BlackBox Schematic, PCB
    [Blackbox.kicad_pcb, Blackbox.kicad_sch]
2022-04-19 added a few connectors to black box PCB
    [Blackbox.kicad_pcb, Blackbox.kicad_sch]
2022-04-21 Tracing for Blackbox
    [Blackbox.kicad_pcb]
2022-04-24 blackbox PCB changes
    [Blackbox.kicad_pcb]
2022-04-24 made mcp73831 charger
    [battery_charger.kicad_pcb, battery_charger.kicad_sch]
2022-04-25 BlackBox PCB updates
    [Blackbox.kicad_pcb, Blackbox.kicad_sch]
2022-04-26 worked on bbx routing
    [Blackbox.kicad_pcb, Blackbox.kicad_sch]
2022-04-28 Blackbox PCB updates
    PCB done, ready to be reviewed. Just needs linear regulator and memes ofc.
    [Blackbox.kicad_pcb, Blackbox.kicad_sch]
2022-04-30 blackbox memes
    [Blackbox.kicad_pcb]
2022-04-30 changed resistor symbol on battery charger
    changed resistor symbol on battery charger
    [battery_charger.kicad_sch]
2022-04-30 SI-8050Y Schematic
    Created SI-8050Y Schematic
    [COMBINED_REGULATOR.kicad_sch]
2022-04-30 corrected overlapping front silkscreen on battery charger
    corrected overlapping front silkscreen on battery charger
    [battery_charger.kicad_pcb]
2022-04-30 Blackbox updates
    [Blackbox.kicad_pcb, Blackbox.kicad_sch]
2022-04-30 created battery charger for payload
    created battery charger for payload
    [Power management system.kicad_pcb, Power management system.kicad_sch]
2022-04-30 add iss logo
    ISS logo added
    [battery_charger.kicad_pcb]
2022-05-01 added design rules to blackbox
    [COMBINED_REGULATOR.kicad_sch]
2022-05-02 worked on bbx
    [Blackbox.kicad_pcb]
2022-05-04 minor blackbox fixes
    [Blackbox.kicad_pcb, Blackbox.kicad_sch]
2022-05-07 set up bms
    [BMS.kicad_pcb, BMS.kicad_sch, CELLS.kicad_sch, CHARGERS.kicad_sch, LOGIC.kicad_sch, REGULATOR.kicad_sch, untitled.kicad_sch]
2022-05-07 testing stuff
    [LOGIC.kicad_sch]
2022-05-07 finished bbx
    [Blackbox.kicad_pcb, Blackbox.kicad_sch]
2022-05-07 TS2596 Symbol and Schematic
    TS2596 Symbol and Schematic Made
    [REGULATOR.kicad_sch]
2022-05-08 retrying ts2596 schematic
    [REGULATOR.kicad_sch]
2022-05-09 got rid of extra MS5611 pin
    [Blackbox.kicad_pcb, Blackbox.kicad_sch]
2022-05-17 added a few vias to the blackbox
    [Blackbox.kicad_pcb]
2022-05-17 changed design rules on black box to coincide with JLC
    [Blackbox.kicad_pcb]
2022-05-18 Moved components around for design rule checker
    [Blackbox.kicad_pcb]
2022-05-19 finished blackbox?
    [Blackbox.kicad_pcb]
2022-05-20 Add BMS Logic
    Add BMS Logic
    [BMS.kicad_sch, CELLS.kicad_sch, LOGIC.kicad_sch]
2022-05-21 Started BMS board
    [BMS.kicad_pcb, BMS.kicad_sch]
2022-05-22 continued bms and made usb port footprint
    [BMS.kicad_pcb, BMS.kicad_sch, Blackbox-BOM.csv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]
2022-05-22 did bms stuff
    [BMS.kicad_pcb, BMS.kicad_sch, CONNECTORS.kicad_sch, LOGIC.kicad_sch, REGULATOR.kicad_sch]
2022-05-23 fixed silkscreen-soldermask collisions
    [BMS.kicad_pcb]
2022-05-29 Started restructuring
    [3V3_REGULATOR.kicad_pcb, 3V3_REGULATOR.kicad_sch, 5v buck .kicad_pcb, 5v buck .kicad_sch, ACB.kicad_pcb, ACB.sch, ACTIVE_CONTROL.sch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]
2022-05-29 continued directory restructuring
    [BMS.kicad_pcb, BMS.kicad_sch, BMS.step, Blackbox.kicad_pcb, Blackbox.kicad_sch, CELLS.kicad_sch, CHARGERS.kicad_sch, CONNECTORS.kicad_sch]
2022-06-08 deleted old files
    [CELLS.kicad_sch, test.kicad_sch]
2022-06-18 started to set up next year's boards
    [3V3_REG.kicad_sch, 5V_REG.kicad_sch, 6V_REG.kicad_sch, 9V_REG.kicad_sch, BATTERY_MANAGEMENT.kicad_sch, CELLS.kicad_sch, CONTROL.kicad_sch, COTS_TELEM.kicad_pcb]
2022-07-11 removed redundant folders
    [3V3_REGULATOR.kicad_pcb, 3V3_REGULATOR.kicad_sch, 5v buck .kicad_pcb, 5v buck .kicad_sch, ACB.kicad_pcb, ACB.sch, ACTIVE_CONTROL.sch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]
2022-07-11 deleted local fp and sym tables from new boards
2022-07-11 removed file fp and sym tables from new boards
2022-07-17 added MK3 sensor suite board to current boards
    [SENSOR_SUITE.csv, SENSOR_SUITE.kicad_pcb, SENSOR_SUITE.kicad_sch]
2022-07-17 put tars boards into subfolders for MK3 and MK4
    [3V3_REG.kicad_sch, 5V_REG.kicad_sch, 6V_REG.kicad_sch, 9V_REG.kicad_sch, BATTERY_MANAGEMENT.kicad_sch, CONTROL.kicad_sch, COTS_TELEM.kicad_pcb, COTS_TELEM.kicad_sch]
2022-07-17 deleted duplicate boards
    [3V3_REG.kicad_sch, 5V_REG.kicad_sch, 6V_REG.kicad_sch, 9V_REG.kicad_sch, BATTERY_MANAGEMENT.kicad_sch, CONTROL.kicad_sch, COTS_TELEM.kicad_pcb, COTS_TELEM.kicad_sch]
2022-07-19 started making pmb template 1
    [3V3.kicad_sch, 3V3_REG.kicad_sch, 5V.kicad_sch, 5V_REG.kicad_sch, 6V.kicad_sch, 6V_REG.kicad_sch, 9V.kicad_sch, 9V_REG.kicad_sch]
2022-07-19 continued making template
    [BATTERY.kicad_sch, MCU.kicad_sch]
2022-07-22 dug up old telemetry board
    [COTS_TELEM.kicad_pcb, COTS_TELEM.kicad_sch, FCB.csv, FCB.kicad_pcb, FCB.kicad_sch, POWER.kicad_pcb, POWER.kicad_sch, SENSOR_SUITE.csv]
2022-08-01 New repo structure tars mk2 and mk1 forwardport (#74)
    * restored TARS MK1
    * restored TARS-MK2
    * restored fp and sym tables
    * renamed stuff to 1.0
    [ACB.kicad_pcb, ACB.kicad_sch, ACTIVE_CONTROL.kicad_sch, COTS.kicad_pcb, COTS.kicad_sch, FCB-Lite.kicad_pcb, FCB-Lite.kicad_sch, FCB.kicad_pcb]
2022-08-01 Old Library Forward-port and sorting (#80)
    * started lib table cleaner script
    * copied legacy symbols
    * copied recent symbols
    * forward-ported 3d models
    * copied footprints
    * sorted footprints
    * nuked archive
    * git rm-ed cruft
2022-10-23 Removed csv BOMS from MK3
    [FCB.csv, SENSOR_SUITE.csv]
2022-10-23 Removed .kicad_prl files from Mk3
2022-12-01 Deleted old example files from MK4 folder
    [3V3.kicad_sch, 5V.kicad_sch, 6V.kicad_sch, 9V.kicad_sch, BATTERY.kicad_sch, MCU.kicad_sch, REGULATORS.kicad_sch, TARS-MK4-PMB-TEMPLATE1.kicad_pcb]
2022-12-01 Made basic project file
    [TARS-MK4-TEMPLATE.kicad_pcb, TARS-MK4-TEMPLATE.kicad_sch]
2022-12-01 Added BTB connector 3D files NO COLOR :(
2022-12-01 Added lib file path for BTB footprints
2022-12-01 Fixed relative BTB footprint lib path
2022-12-01 Finished floating molex BTB connector review
2022-12-01 Finished SlimStack footprint files
2022-12-03 Added JLCPCB DRC to PCB properties
    [TARS-MK4-TEMPLATE.kicad_pcb]
2022-12-03 Fixed DRC error on footprint courtyard
2022-12-03 Cleaned up pcb, Nearly done!
    [TARS-MK4-TEMPLATE.kicad_pcb]
2022-12-03 added axis silkscreen to templates
    [TARS-MK4-TEMPLATE.kicad_pcb]
2022-12-03 Annotated connectors to link to schematic
    [TARS-MK4-TEMPLATE.kicad_pcb]
2022-12-03 Added BTB connectors to sch and linked to PCB
    [TARS-MK4-TEMPLATE.kicad_sch]
2022-12-03 Added +z and -z to pcb silkscreen for BTB connectors
    [TARS-MK4-TEMPLATE.kicad_pcb]
2022-12-03 Add contributors to schematic title block
    [TARS-MK4-TEMPLATE.kicad_sch]
2022-12-03 added names to templates
    [TARS-MK4-TEMPLATE.kicad_pcb, TARS-MK4-TEMPLATE.kicad_sch]
2022-12-06 added mounting holes w vias to template boards
    [TARS-MK4-TEMPLATE.kicad_pcb]
2022-12-06 final mod on mounting holes
    [TARS-MK4-TEMPLATE.kicad_pcb]
2022-12-07 added folders for FCB, PMB, and TELEM
    [TARS-MK4-FCB.kicad_pcb, TARS-MK4-FCB.kicad_sch, TARS-MK4-PMB.kicad_pcb, TARS-MK4-PMB.kicad_sch, TARS-MK4-TELEM.kicad_pcb, TARS-MK4-TELEM.kicad_sch]
2022-12-07 random push to pmb
    [TARS-MK4-PMB.kicad_sch]
2022-12-07 copied over stuff from tars 3.1
    [TARS-MK4-FCB.kicad_sch]
2022-12-17 Finished BNO schematic and attempted to designate pinouts for teensy.
    [TARS-MK4-FCB.kicad_sch]
2022-12-21 Organized schematics and added links to datasheets for most of the sensors
    [TARS-MK4-FCB.kicad_sch]
2022-12-21 updated symbol library and footprint locations
    [TARS-MK4-FCB.kicad_sch]
2022-12-21 deleted misplaced footprint folders and no longer used footprints
2022-12-21 added updated footprint library table
2022-12-21 All sensor schematics done
    [TARS-MK4-FCB.kicad_sch]
2022-12-21 Fixed bno schematic
    [TARS-MK4-FCB.kicad_sch]
2022-12-22 updated kx symbol to reflect accurate datasheet, started work on teensy labels.
    [TARS-MK4-FCB.kicad_sch]
2022-12-27 modified schematics
    modified schematics
    [TARS-MK4-FCB.kicad_pcb, TARS-MK4-FCB.kicad_sch]
2022-12-27 update B2B pinout
    update B2B pinout
    [TARS-MK4-FCB.kicad_sch]
2022-12-27 update schematic footprint assignment
    update schematic footprint assignment
    [TARS-MK4-FCB.kicad_pcb, TARS-MK4-FCB.kicad_sch]
2022-12-27 assigned teensy pinout
    assigned teensy pinout
    [TARS-MK4-FCB.kicad_pcb, TARS-MK4-FCB.kicad_sch]
2022-12-27 Updated location of UFL connector footprint
    [TARS-MK4-FCB.kicad_sch]
2022-12-27 Added piezo buzzer, program button, and updated teensy schematic.
    [TARS-MK4-FCB.kicad_sch]
2022-12-28 Complete FCB schematics and PCB footprint matching
    Complete FCB schematics and PCB footprint matching
    [TARS-MK4-FCB.kicad_pcb, TARS-MK4-FCB.kicad_sch]
2022-12-29 B2B assign corrections
    B2B pin correction
    [TARS-MK4-FCB.kicad_pcb, TARS-MK4-FCB.kicad_sch]
2022-12-29 update z+ B2B pinout
    update z+ B2B pinout
    [TARS-MK4-PMB.kicad_sch]
2022-12-29 update B2B pinout and match footprints
    update B2B pinout and match footprints
    [TARS-MK4-PMB.kicad_pcb, TARS-MK4-PMB.kicad_sch]
2022-12-29 Started BNO routing
    [TARS-MK4-FCB.kicad_pcb, TARS-MK4-FCB.kicad_sch]
2022-12-29 Everything is routed except MAXM10S
    [TARS-MK4-FCB.kicad_pcb, TARS-MK4-FCB.kicad_sch]
2023-01-02 Added PMB Connectors
    Added PMB Connectors
    [TARS-MK4-PMB.kicad_pcb, TARS-MK4-PMB.kicad_sch]
2023-01-02 Minor changes to Antenna footprint
    Minor changes to Antenna footprint
    [TARS-MK4-FCB.kicad_pcb, TARS-MK4-FCB.kicad_sch]
2023-01-02 Add MCU (still editing)
    Add MCU (still editing)
    [TARS-MK4-PMB.kicad_pcb, TARS-MK4-PMB.kicad_sch]
2023-01-02 Add MCU (more changes)
    Add MCU (more changes)
    [TARS-MK4-PMB.kicad_sch]
2023-01-02 Minor B2B corrections
    B2B pin corrections
    [TARS-MK4-FCB.kicad_sch]
2023-01-02 Complete analog measurement circuit and LEDs
    Complete analog measurement circuit and LEDs
    [TARS-MK4-PMB.kicad_pcb, TARS-MK4-PMB.kicad_sch]
2023-01-03 Cleaned Schematic Layout
    [TARS-MK4-FCB.kicad_sch]
2023-01-03 Add better symbol descriptions
    [TARS-MK4-FCB.kicad_sch]
2023-01-04 Updated Teensy Library
2023-01-04 Updated keywords for teensy symbols
2023-01-04 Updated Max10 footprint to generic
2023-01-04 Began fixing BNO pins
    [TARS-MK4-FCB.kicad_sch]
2023-01-05 Add pullup resistors to BNO086 sensor
    Add pullup resistors to BNO086 sensor
    [TARS-MK4-FCB.kicad_pcb, TARS-MK4-FCB.kicad_sch]
2023-01-05 Finished FCB schematic. NEEDS REVIEW
    [TARS-MK4-FCB.kicad_sch]
2023-01-05 Fixed antenna UFL lib. READY TO ROUTE
    [TARS-MK4-FCB.kicad_sch]
2023-01-05 Routing progress (Denver push)
    Routing progress (Denver push)
    [TARS-MK4-FCB.kicad_pcb, TARS-MK4-FCB.kicad_sch]
2023-01-05 routing progress push 2.0 (Denver Depart)
    routing progress push 2.0 (Denver Depart)
    [TARS-MK4-FCB.kicad_pcb, TARS-MK4-FCB.kicad_sch]
2023-01-06 fix gps antenna footprint and symbol
    fix gps antenna footprint and symbol
    [TARS-MK4-FCB.kicad_pcb, TARS-MK4-FCB.kicad_sch]
2023-01-06 Cleaned symbol label positions
    [TARS-MK4-FCB.kicad_pcb]
2023-01-06 Revert "Cleaned symbol label positions"
    This reverts commit 70aa8cfbf4e00eab6dd73cf060147016ed760cc4.
    [TARS-MK4-FCB.kicad_pcb]
2023-01-06 Actually cleaned schematic label positions
    [TARS-MK4-FCB.kicad_sch]
2023-01-06 Replaced antenna with coax connector, used standard footprint
    [TARS-MK4-FCB.kicad_sch]
2023-01-06 Relinked pcb to schematic, replaced antenna footprint
    [TARS-MK4-FCB.kicad_pcb]
2023-01-06 Removed unused footprint libs from table
2023-01-06 Added component outline
    [TARS-MK4-TELEM.kicad_sch]
2023-01-07 Routing
    Routing
    [TARS-MK4-FCB.kicad_pcb, TARS-MK4-FCB.kicad_sch]
2023-01-07 Finished BNO routing
    [TARS-MK4-FCB.kicad_pcb]
2023-01-07 update BNO routing
    update BNO routing
    [TARS-MK4-FCB.kicad_pcb]
2023-01-07 Added 3d models, updated schematic for molex connectors
    [TARS-MK4-PMB.kicad_pcb, TARS-MK4-PMB.kicad_sch]
2023-01-07 Finished routing everything except maxm10s and stylistic changes
    [TARS-MK4-FCB.kicad_pcb]
2023-01-07 created esp32 symbol
2023-01-07 Complete FCB traces and optimization. Need Review
    Complete FCB traces and optimization. Need Review
    [TARS-MK4-FCB.kicad_pcb, TARS-MK4-FCB.kicad_sch]
2023-01-08 Updated ESP32 symbol
2023-01-08 Added ESP32 footprint
2023-01-08 Added ESP32 3D model
2023-01-08 Added new parts from custom libs to sch and pcb
    [TARS-MK4-TELEM.kicad_pcb, TARS-MK4-TELEM.kicad_sch]
2023-01-08 Made basic outline of TELEM PCB and SCH
    [TARS-MK4-TELEM.kicad_pcb, TARS-MK4-TELEM.kicad_sch]
2023-01-08 Done basic labeling
    Done basic labeling
    [TARS-MK4-FCB.kicad_pcb]
2023-01-09 Test Push, Issued date on sch
    [TARS-MK4-TELEM.kicad_sch]
2023-01-09 Added B2B labels to schematic
    Added B2B labels to schematic
    [TARS-MK4-TELEM.kicad_sch]
2023-01-09 update label
    update label
    [TARS-MK4-FCB.kicad_pcb]
2023-01-10 created labels for B2B and added regulators
    [TARS-MK4-PMB.kicad_sch]
2023-01-10 added current monitor to schematic
    [TARS-MK4-PMB.kicad_sch]
2023-01-10 formatting changes
    [TARS-MK4-PMB.kicad_sch]
2023-01-10 Updated datasheet on ESP32 lib
2023-01-10 Updated schematic B2B spacing and relinked to pcb
    [TARS-MK4-TELEM.kicad_pcb, TARS-MK4-TELEM.kicad_sch]
2023-01-10 Complete FCB. Require review full board
    Complete FCB. Require review full board
    [TARS-MK4-FCB.kicad_pcb, TARS-MK4-FCB.kicad_sch]
2023-01-10 update minor corrections
    update minor corrections
    [TARS-MK4-FCB.kicad_pcb]
2023-01-10 added ground vias
    added ground vias
    [TARS-MK4-FCB.kicad_pcb]
2023-01-10 added buzzer 3D and multiple silkscreen changes
    added buzzer 3D and multiple silkscreen changes
    [TARS-MK4-FCB.kicad_pcb]
2023-01-10 Updated B2B footprints and 3D models
2023-01-10 fixed b2b and buzzer 3d models
    [TARS-MK4-FCB.kicad_pcb, TARS-MK4-FCB.kicad_sch]
2023-01-10 Added MAX and UFL 3d shapes
    [TARS-MK4-FCB.kicad_pcb]
2023-01-11 Voltage regulator shematics
    [TARS-MK4-PMB.kicad_sch]
2023-01-11 Fixed formatting
    [TARS-MK4-PMB.kicad_sch]
2023-01-11 fixed boxes
    [TARS-MK4-PMB.kicad_sch]
2023-01-11 Add basic MCU connections to TELEM
    [TARS-MK4-TELEM.kicad_sch]
2023-01-12 added corresponding datasheets & annotated schematic
    [TARS-MK4-PMB.kicad_sch]
2023-01-12 Worked on ESP and started Particle
    [TARS-MK4-TELEM.kicad_pcb, TARS-MK4-TELEM.kicad_sch]
2023-01-12 added crystal oscillator, updated b2b to include VBAT, and assigned 2 LEDs
    [TARS-MK4-PMB.kicad_sch]
2023-01-12 update B2B with VBAT
    update B2B with VBAT
    [TARS-MK4-PMB.kicad_sch]
2023-01-12 added VBAT to B2B, correct B2B labels and routing, added molex logo
    added VBAT to B2B, correct B2B labels and routing, added molex logo
    [TARS-MK4-FCB.kicad_pcb, TARS-MK4-FCB.kicad_sch]
2023-01-13 Added names and prepared for MOSFET ON/OFF
    Added names and prepared for MOSFET ON/OFF
    [TARS-MK4-FCB.kicad_pcb, TARS-MK4-FCB.kicad_sch]
2023-01-13 correct B2B labeling
    correct B2B labeling
    [TARS-MK4-PMB.kicad_pcb, TARS-MK4-PMB.kicad_sch]
2023-01-13 added B2B vias
    added B2B vias
    [TARS-MK4-PMB.kicad_pcb]
2023-01-13 cleared uncleaned traces
    cleared uncleaned traces
    [TARS-MK4-FCB.kicad_pcb]
2023-01-13 minor tweak to size and trace
    minor tweak to size and trace
    [TARS-MK4-FCB.kicad_pcb]
2023-01-13 updated footprints and schematics
    updated footprints and schematics
    [TARS-MK4-PMB.kicad_pcb, TARS-MK4-PMB.kicad_sch]
2023-01-13 Fixed RF UFL connector (MCRF)
    [TARS-MK4-FCB.kicad_pcb]
2023-01-13 footprints assigned and ready to route
    footprints assigned and ready to route
    [TARS-MK4-PMB.kicad_pcb, TARS-MK4-PMB.kicad_sch]
2023-01-13 Edited BTB footprint description, added 3d model back
2023-01-13 updated BTB connectors on PCB
    [TARS-MK4-FCB.kicad_pcb]
2023-01-13 Updated teensy fp names
2023-01-13 Fixed naming of teensy 3d models
2023-01-13 Added Teensy 3d model back to PCB
    [TARS-MK4-FCB.kicad_pcb]
2023-01-13 Added Gas Sensor!
    [TARS-MK4-FCB.kicad_sch]
2023-01-13 Added Teensy ON/OFF and Gas snsesor to pcb/sch
    [TARS-MK4-FCB.kicad_pcb, TARS-MK4-FCB.kicad_sch]
2023-01-13 Added custom lib description to gas sensor
2023-01-13 Updated MOSFET resistor footprints
    [TARS-MK4-FCB.kicad_pcb, TARS-MK4-FCB.kicad_sch]
2023-01-13 Changed BNO Resistor FP's, Added MOSFET Resistors
    [TARS-MK4-FCB.kicad_pcb, TARS-MK4-FCB.kicad_sch]
2023-01-13 Changed Pad fill zone: Thermal Relief -> Solid Fill
    [TARS-MK4-FCB.kicad_pcb]
2023-01-13 Added regulator symbol back
2023-01-13 Added new regulator to 5V line, Need to update rest
    [TARS-MK4-PMB.kicad_sch]
2023-01-13 Deleted old regulator lib
2023-01-13 routed MOSFET and GAS SENSOR
    routed MOSFET and GAS SENSOR
    [TARS-MK4-FCB.kicad_pcb, TARS-MK4-FCB.kicad_sch]
2023-01-14 update silkscreen design and minor trace adjustment
    update silkscreen design and minor trace adjustment
    [TARS-MK4-FCB.kicad_pcb]
2023-01-14 Started ATMega routing
    [TARS-MK4-PMB.kicad_pcb, TARS-MK4-PMB.kicad_sch]
2023-01-14 Updated 5V regulator
    [TARS-MK4-PMB.kicad_sch]
2023-01-14 Organizing and Footprint assigning
    [TARS-MK4-PMB.kicad_sch]
2023-01-14 Organize boards more
    [TARS-MK4-TELEM.kicad_sch]
2023-01-14 Added Proton B404xM2 3D Model
    [TARS-MK4-TELEM.kicad_pcb]
2023-01-14 update MOSFET resistance values and modified silkscreen
    update MOSFET resistance values and modified silkscreen
    [TARS-MK4-FCB.kicad_pcb, TARS-MK4-FCB.kicad_sch]
2023-01-14 update B2B to fit FCB spec
    update B2B to fit FCB spec
    [TARS-MK4-TELEM.kicad_sch]
2023-01-14 update B2B to FCB spec
    update B2B to FCB spec
    [TARS-MK4-PMB.kicad_sch]
2023-01-14 correct B2B labels
    correct B2B labels
    [TARS-MK4-FCB.kicad_pcb, TARS-MK4-FCB.kicad_sch]
2023-01-14 correct B2B lablels
    correct B2B lablels
    [TARS-MK4-TELEM.kicad_sch]
2023-01-14 Organized PMB schematic
    [TARS-MK4-PMB.kicad_pcb, TARS-MK4-PMB.kicad_sch]
2023-01-14 Edited Molex 3D Models
    [TARS-MK4-PMB.kicad_pcb]
2023-01-14 Further organized schematic
    [TARS-MK4-PMB.kicad_sch]
2023-01-14 Updated PCB with sch components
    [TARS-MK4-TELEM.kicad_pcb]
2023-01-14 reduced # of debug LED's and looked into new inductors
    [TARS-MK4-PMB.kicad_sch]
2023-01-15 reviewed all pinouts, added debug pins, added footprint for smaller inductor, began routing
    [TARS-MK4-PMB.kicad_pcb, TARS-MK4-PMB.kicad_sch]
2023-01-15 all components are connected (besides ground) but there are a TON of clearence violations... we need to update constraints on this board and move traces around accordingly
    [TARS-MK4-PMB.kicad_pcb]
2023-01-15 edit constraints
    edit constraints
    [TARS-MK4-PMB.kicad_pcb]
2023-01-15 review and edit constraints and DRC issues
    review and edit constraints and DRC issues
    [TARS-MK4-FCB.kicad_pcb]
2023-01-15 began reroute process
    [TARS-MK4-PMB.kicad_pcb]
2023-01-16 fixed B2B label issues
    fixed B2B label issues
    [TARS-MK4-PMB.kicad_pcb, TARS-MK4-PMB.kicad_sch]
2023-01-16 complete 6V regulator routing and Molex connector placement
    complete 6V regulator routing and Molex connector placement
    [TARS-MK4-PMB.kicad_pcb, TARS-MK4-PMB.kicad_sch]
2023-01-16 starting MCU routing
    starting MCU routing
    [TARS-MK4-PMB.kicad_pcb, TARS-MK4-PMB.kicad_sch]
2023-01-17 Route 5V regulator
    Route 5V regulator
    [TARS-MK4-PMB.kicad_pcb, TARS-MK4-PMB.kicad_sch]
2023-01-17 finish regulator routing
    finish regulator routing
    [TARS-MK4-PMB.kicad_pcb]
2023-01-17 completed PMB routing, no DRC complaints, need to review trace widths for a number of components
    [TARS-MK4-PMB.kicad_pcb]
2023-01-17 Added better mosfet, need to route
    [TARS-MK4-FCB.kicad_sch]
2023-01-17 Updated MOSFET, Silkscreen and routing
    [TARS-MK4-FCB.kicad_pcb, TARS-MK4-FCB.kicad_sch]
2023-01-17 worked on sch
    [TARS-MK4-TELEM.kicad_sch]
2023-01-17 Fix traces and labeling for the power debug pins and added UIUC
    Fix traces and labeling for the power debug pins and added UIUC
    [TARS-MK4-FCB.kicad_pcb]
2023-01-18 Updated power trace widths and added debugging pins
    [TARS-MK4-PMB.kicad_pcb, TARS-MK4-PMB.kicad_sch]
2023-01-18 update Trace and silkscreen
    update Trace and silkscreen
    [TARS-MK4-FCB.kicad_pcb]
2023-01-18 trace adjust and add additional debug pins
    trace adjust and add additional debug pins
    [TARS-MK4-PMB.kicad_pcb]
2023-01-18 Add a name that we forgot to put
    Add a name that we forgot to put
    [TARS-MK4-FCB.kicad_pcb]
2023-01-18 added 3.7 v regulator and changed esp labels
    [TARS-MK4-TELEM.kicad_sch]
2023-01-18 organized front silkscreen
    organized front silkscreen
    [TARS-MK4-PMB.kicad_pcb]
2023-01-18 Update TARS-MK4-TELEM.kicad_sch
    USB Changes
    [TARS-MK4-TELEM.kicad_sch]
2023-01-18 Update TARS-MK4-TELEM.kicad_sch
    1.5 -> 1.8 3.7 Voltage inductor
    [TARS-MK4-TELEM.kicad_sch]
2023-01-18 added swaggy footprints
    [TARS-MK4-PMB.kicad_pcb, TARS-MK4-PMB.kicad_sch]
2023-01-18 minor width change
    minor width change
    [TARS-MK4-FCB.kicad_pcb]
2023-01-18 Complete PMB silkscreen design(waiting on FULL AV team list)
    Complete PMB silkscreen design(waiting on FULL AV team list)
    [TARS-MK4-PMB.kicad_pcb, TARS-MK4-PMB.kicad_sch]
2023-01-18 update trace and passive placement for larger name space
    update trace and passive placement for larger name space
    [TARS-MK4-PMB.kicad_pcb]
2023-01-19 AV LIST added
    AV LIST added
    [TARS-MK4-PMB.kicad_pcb]
2023-01-19 update DR
    update DR
    [TARS-MK4-PMB.kicad_pcb]
2023-01-19 Name order correction
    Name order correction
    [TARS-MK4-PMB.kicad_pcb]
2023-01-19 Update silkscreen
    Update silkscreen
    [TARS-MK4-FCB.kicad_pcb]
2023-01-19 3v3 Regulator for ESP USB
    Changing Labels to match Board to Board
    3v3 Regulator added for USB Power
    [TARS-MK4-TELEM.kicad_sch]
2023-01-19 Update TARS-MK4-TELEM.kicad_sch
    Deleting 3V3 Converter
    Adding Connector for Emergency Power
    [TARS-MK4-TELEM.kicad_sch]
2023-01-19 changed voltage monitoring on vbat to be 200k
    [TARS-MK4-PMB.kicad_sch]
2023-01-19 final update
    final update
    [TARS-MK4-PMB.kicad_pcb]
2023-01-19 Added vbat voltage divider
    [TARS-MK4-TELEM.kicad_pcb, TARS-MK4-TELEM.kicad_sch]
2023-01-19 final change
    final change
    [TARS-MK4-PMB.kicad_pcb]
2023-01-19 added spi for lora and changed boxes
    [TARS-MK4-TELEM.kicad_sch]
2023-01-19 locked in m2 hole
    [TARS-MK4-TELEM.kicad_pcb, TARS-MK4-TELEM.kicad_sch]
2023-01-20 Mostly everything routed except voltage regulator circuit and a couple other things
    [TARS-MK4-TELEM.kicad_pcb, TARS-MK4-TELEM.kicad_sch]
2023-01-20 Updated schematic with reset RFM pin and PCB
    [TARS-MK4-TELEM.kicad_pcb, TARS-MK4-TELEM.kicad_sch]
2023-01-20 continuing remaining routing
    continuing remaining routing
    [TARS-MK4-TELEM.kicad_pcb]
2023-01-20 Finished cleaning schematic
    [TARS-MK4-PMB.kicad_sch]
2023-01-20 PMB IS DONE
    [TARS-MK4-PMB.kicad_pcb]
2023-01-20 complete routing
    complete routing
    [TARS-MK4-TELEM.kicad_pcb, TARS-MK4-TELEM.kicad_sch]
2023-01-20 update schematic due to TELEM changes
    update schem due to TELEM
    [TARS-MK4-FCB.kicad_pcb, TARS-MK4-FCB.kicad_sch]
2023-01-20 update and correct repetitive silkscreen
    update and correct repetitive silkscreen
    [TARS-MK4-PMB.kicad_pcb]
2023-01-21 Updated silkscreen and pcb
    [TARS-MK4-PMB.kicad_pcb]
2023-01-21 Updated silkscreen
    [TARS-MK4-FCB.kicad_pcb]
2023-01-21 replaced op amp on current sensing schematic
    [TARS-MK4-PMB.kicad_pcb, TARS-MK4-PMB.kicad_sch]
2023-01-21 Updated BTB's
    [TARS-MK4-TELEM.kicad_sch]
2023-01-21 Updated B2B'
    [TARS-MK4-PMB.kicad_pcb, TARS-MK4-PMB.kicad_sch]
2023-01-21 Changed B2B_TELEM to B2B_RF96W
    [TARS-MK4-TELEM.kicad_sch]
2023-01-21 added silkscreen and edited to have no DRC issues
    [TARS-MK4-TELEM.kicad_pcb]
2023-01-21 Updated B2B's
    [TARS-MK4-PMB.kicad_pcb, TARS-MK4-PMB.kicad_sch]
2023-01-21 updated op-amp with correct libs
    [TARS-MK4-PMB.kicad_sch]
2023-01-21 Added 3d model for b2b
    [TARS-MK4-TELEM.kicad_pcb]
2023-01-22 Cleaned sch need to fix pcb routing
    [TARS-MK4-TELEM.kicad_pcb, TARS-MK4-TELEM.kicad_sch]
2023-01-23 Fixed labeling, Antenna pad and RGB light
    [TARS-MK4-TELEM.kicad_pcb, TARS-MK4-TELEM.kicad_sch]
2023-01-23 Added 3V7 debug pin
    [TARS-MK4-TELEM.kicad_pcb, TARS-MK4-TELEM.kicad_sch]
2023-01-23 Updaed RFM96 labels to FCB
    [TARS-MK4-FCB.kicad_pcb, TARS-MK4-FCB.kicad_sch]
2023-01-23 Updated RFM BTB labels on PMB
    [TARS-MK4-PMB.kicad_pcb, TARS-MK4-PMB.kicad_sch]
2023-01-23 Updated FCB sch (cleaning)
    [TARS-MK4-FCB.kicad_sch]
2023-01-23 Cleaned sch
    [TARS-MK4-TELEM.kicad_sch]
2023-01-23 Updated Zener values in PMB
    [TARS-MK4-PMB.kicad_sch]
2023-01-23 Added names to PMB
    [TARS-MK4-PMB.kicad_pcb]
2023-01-23 Final edits to PMB
    [TARS-MK4-PMB.kicad_pcb, TARS-MK4-PMB.kicad_sch]
2023-01-23 Final FCB changes
    [TARS-MK4-FCB.kicad_pcb, TARS-MK4-FCB.kicad_sch]
2023-01-23 updated telem
    [TARS-MK4-TELEM.kicad_pcb]
2023-01-24 Added missing 3d modles to TELEM
    [TARS-MK4-TELEM.kicad_pcb]
2023-01-24 Added inductor 3d model to TELEM pcb
    [TARS-MK4-TELEM.kicad_pcb]
2023-01-24 Updated Silk TELEM
    [TARS-MK4-TELEM.kicad_pcb]
2023-01-24 Moved molex silkscreen TELEM
    [TARS-MK4-TELEM.kicad_pcb]
2023-01-24 idk what this is
    [TARS-MK4-TELEM.kicad_pcb]
2023-01-24 Updated silk and fixed double telem ints
    [TARS-MK4-TELEM.kicad_pcb, TARS-MK4-TELEM.kicad_sch]
2023-01-24 Fix silkscreen overlaps
    Fix silkscreen overlaps
    [TARS-MK4-TELEM.kicad_pcb]
2023-01-24 Added switch datasheet to pmb
    [TARS-MK4-PMB.kicad_sch]
2023-01-24 Updated ground fills on b2b connectors
    [TARS-MK4-FCB.kicad_pcb, TARS-MK4-PMB.kicad_pcb, TARS-MK4-TELEM.kicad_pcb]
2023-01-24 Added extra GND vias TELEM
    [TARS-MK4-TELEM.kicad_pcb]
2023-01-25 Added IO breakout to particle TELEM
    [TARS-MK4-TELEM.kicad_pcb, TARS-MK4-TELEM.kicad_sch]
2023-01-25 Fixed TELEM DRC
    [TARS-MK4-TELEM.kicad_pcb]
2023-02-14 Renamed FCB to revA
    [TARS-MK4-FCB.kicad_pcb, TARS-MK4-FCB.kicad_sch]
2023-02-14 Renamed PMB to revA
    [TARS-MK4-PMB.kicad_pcb, TARS-MK4-PMB.kicad_sch]
2023-02-14 Renamed TELEM to revA
    [TARS-MK4-TELEM.kicad_pcb, TARS-MK4-TELEM.kicad_sch]
2023-02-14 Copied RevA to make RevB
    [TARS-MK4-FCB.kicad_pcb, TARS-MK4-FCB.kicad_sch, TARS-MK4-PMB.kicad_pcb, TARS-MK4-PMB.kicad_sch, TARS-MK4-TELEM.kicad_pcb, TARS-MK4-TELEM.kicad_sch]
2023-02-14 Updated TELEM pcb/sch naming for revB
    [TARS-MK4-TELEM.kicad_pcb, TARS-MK4-TELEM.kicad_sch]
2023-02-14 Updated PMB pcb/sch naming
    [TARS-MK4-PMB.kicad_pcb, TARS-MK4-PMB.kicad_sch]
2023-02-14 Updated FCB pcb/sch naming for revB
    [TARS-MK4-FCB.kicad_pcb, TARS-MK4-FCB.kicad_sch]
2023-02-14 Updated title cards with correct revision and board titles
    [TARS-MK4-FCB.kicad_pcb, TARS-MK4-FCB.kicad_sch, TARS-MK4-TELEM.kicad_pcb]
2023-02-14 Updated title blocks to fully spell board names
    [TARS-MK4-FCB.kicad_pcb, TARS-MK4-FCB.kicad_sch, TARS-MK4-TELEM.kicad_pcb]
2023-02-14 Updated Silkscreens
    [TARS-MK4-FCB.kicad_pcb, TARS-MK4-PMB.kicad_pcb, TARS-MK4-TELEM.kicad_pcb]
2023-02-14 Fixed solder mask, now 0mm
    [TARS-MK4-FCB.kicad_pcb, TARS-MK4-PMB.kicad_pcb, TARS-MK4-TELEM.kicad_pcb]
2023-02-14 Refilled zones ready for gerbers
    [TARS-MK4-FCB.kicad_pcb, TARS-MK4-PMB.kicad_pcb, TARS-MK4-TELEM.kicad_pcb]
2023-03-25 Changed BTB connector pads from GND to MP (Mounting Pad) in footprint
2023-03-25 Make RevC of TELEM
    [TARS-MK4-TELEM.kicad_pcb, TARS-MK4-TELEM.kicad_sch]
2023-03-25 Added Rev.C of PMB
    [TARS-MK4-PMB.kicad_pcb, TARS-MK4-PMB.kicad_sch]
2023-03-25 Added Rev.C of FCB
    [TARS-MK4-FCB.kicad_pcb, TARS-MK4-FCB.kicad_sch]
2023-03-26 Changed BTB mounting pegs from edgecuts to NPTH's
2023-03-26 Make Rev.C with mounting pin on BTB's, fixed some reference matching
    [TARS-MK4-FCB.kicad_pcb, TARS-MK4-FCB.kicad_sch, TARS-MK4-PMB.kicad_pcb, TARS-MK4-PMB.kicad_sch, TARS-MK4-TELEM.kicad_pcb, TARS-MK4-TELEM.kicad_sch]
2023-03-26 Added TELEM 4.1 Boards
    [TARS-MK4.1-TELEM.kicad_pcb, TARS-MK4.1-TELEM.kicad_sch]
2023-03-26 Made FCB 4.1
    [TARS-MK4.1-FCB.kicad_pcb, TARS-MK4.1-FCB.kicad_sch]
2023-03-26 Updated silkscreen on TELEM for TARS 4.1 spacing
    [TARS-MK4.1-TELEM.kicad_pcb]
2023-03-26 Made PMB 4.1
    [TARS-MK4.1-PMB.kicad_pcb, TARS-MK4.1-PMB.kicad_sch]
2023-03-26 Ported over altimeter holder
    [TARS-MK3-COTSMOUNT_v3.1.kicad_pcb, TARS-MK3-COTSMOUNT_v3.1.kicad_sch]
2023-03-26 Updatd Title Blocks PCB and SCH still sub-par though
    [TARS-MK3-COTSMOUNT_v3.1.kicad_pcb, TARS-MK3-COTSMOUNT_v3.1.kicad_sch]
2023-03-26 Added MK4.1 CAB files from old 3.1 files
    [TARS-MK4.1-CAB.kicad_pcb, TARS-MK4.1-CAB.kicad_sch]
2023-03-29 Finished schematic need to add correct footprints though
    [TARS-MK4.1-CAB.kicad_sch]
2023-04-02 Added Atmega328PB
    [TARS-MK4.1-PMB.kicad_pcb, TARS-MK4.1-PMB.kicad_sch]
2023-04-02 AV-958 branch added and regulators updated on schematic.
    [TARS-MK4.1-PMB.kicad_sch]
2023-04-02 Created efuse symbol, and added footprint and 3d model
2023-04-04 updated pcb and schematics for PMB and TELEM fixed regulators and inductors. Imported new symbols for inductors and fixed new regulator symbols.
    [TARS-MK4.1-PMB.kicad_pcb, TARS-MK4.1-PMB.kicad_sch, TARS-MK4.1-TELEM.kicad_pcb, TARS-MK4.1-TELEM.kicad_sch]
2023-04-09 updated PCB schematic with e-fuses
    [TARS-MK4.1-PMB.kicad_sch]
2023-04-09 Removed unused regulator libs
2023-04-10 Renamed eFuse and edited symbol/footprint
2023-04-10 Worked on PMB SCH
    [TARS-MK4.1-PMB.kicad_sch]
2023-04-10 Fixed Molex MicroFitPlus connector 3d model, added inductor lib to footprint table
2023-04-10 Added old we-mapi to footprint table lib
2023-04-10 Edited the PMB
    [TARS-MK4.1-PMB.kicad_pcb, TARS-MK4.1-PMB.kicad_sch]
2023-04-11 finished schematic for review
    [TARS-MK4.1-PMB.kicad_pcb, TARS-MK4.1-PMB.kicad_sch]
2023-04-11 prepared boards for routing and fixed schematics
    [TARS-MK4.1-PMB.kicad_pcb, TARS-MK4.1-PMB.kicad_sch]
2023-04-11 Added sense back to PMB, labeled, organized
    [TARS-MK4.1-PMB.kicad_pcb, TARS-MK4.1-PMB.kicad_sch]
2023-04-12 changed all resistors and capacitors from 0805 to 0603
    [TARS-MK4.1-PMB.kicad_pcb, TARS-MK4.1-PMB.kicad_sch]
2023-04-12 Added new zener and schottky diodes
    [TARS-MK4.1-PMB.kicad_sch]
2023-04-12 Edited LEDs still need to double check resistor values
    [TARS-MK4.1-PMB.kicad_sch]
2023-04-12 Updated courtyard for better clearance of micro-fit-plus connectors
2023-04-12 Removed redundant inductor footprints and 3d models
2023-04-12 Updated Inductors on PMB and made everything ready to route
    [TARS-MK4.1-PMB.kicad_pcb, TARS-MK4.1-PMB.kicad_sch]
2023-04-13 Added ESD chips and RTL-SDR pins
    Added ESD chips and RTL-SDR pins
    [TARS-MK4-TELEM.kicad_pcb, TARS-MK4-TELEM.kicad_sch]
2023-04-13 Preliminary routing design for 6V regulator and 6V efuse finished
    [TARS-MK4.1-PMB.kicad_pcb, TARS-MK4.1-PMB.kicad_sch]
2023-04-13 made progress on TELEM regulator and efuse
    [TARS-MK4.1-TELEM.kicad_pcb, TARS-MK4.1-TELEM.kicad_sch]
2023-04-13 Fixed schematic to pass ERC, can still clean up format more. Added net labels for efuses to get rid of 'c10x pad 2' type nets while routing
    [TARS-MK4.1-PMB.kicad_pcb, TARS-MK4.1-PMB.kicad_sch]
2023-04-13 Finished adding net labels for routing purposes. Cleaned up affected areas of schematic a bit.
    [TARS-MK4.1-PMB.kicad_pcb, TARS-MK4.1-PMB.kicad_sch]
2023-04-14 TELEM almost done except one net
    [TARS-MK4.1-TELEM.kicad_pcb]
2023-04-14 TELEM is done and needs review
    [TARS-MK4.1-TELEM.kicad_pcb]
2023-04-14 updated the zone fill on TELEM
    [TARS-MK4.1-TELEM.kicad_pcb]
2023-04-14 made a few final tweaks to TELEM still needs review
    [TARS-MK4.1-TELEM.kicad_pcb]
2023-04-14 last commit for the night, efuse and 3V7 regulator are good and TELEM is waiting for Rishi G additions.
    [TARS-MK4.1-TELEM.kicad_pcb, TARS-MK4.1-TELEM.kicad_sch]
2023-04-14 Routed almost all of PMB. Need to route final (hardest imo) signals. Jumpers added on current sensing lines will need to be cleaned up in schematic, added them in a rush.
    [TARS-MK4.1-PMB.kicad_pcb, TARS-MK4.1-PMB.kicad_sch]
2023-04-14 Added new ESD chips and routed SDR Enable pin
    Added new ESD chips and routed SDR Enable pin
    [TARS-MK4.1-TELEM.kicad_pcb, TARS-MK4.1-TELEM.kicad_sch]
2023-04-14 Added Micro-fit connector
    Added Micro-fit connector
    [TARS-MK4.1-TELEM.kicad_pcb, TARS-MK4.1-TELEM.kicad_sch]
2023-04-14 Re-added test pin connector
    Re-added test pin connector
    [TARS-MK4.1-TELEM.kicad_pcb]
2023-04-15 finished routing, fixed unconnected drc issues, still need to review zoning drc issues
    [TARS-MK4.1-PMB.kicad_pcb]
2023-04-15 Optimized traces and fixed minor issues
    Optimized traces and fixed minor issues
    [TARS-MK4.1-TELEM.kicad_pcb]
2023-04-15 Fixed power zones
    Fixed power zones
    [TARS-MK4.1-TELEM.kicad_pcb]
2023-04-15 fixed all drc errors, modified silkscreen, ready for review
    [TARS-MK4.1-PMB.kicad_pcb, TARS-MK4.1-PMB.kicad_sch]
2023-04-15 Fixed zoning issues
    Fixed zoning issues
    [TARS-MK4.1-TELEM.kicad_pcb]
2023-04-15 final review of pmb with eisha, rishi p, and rishi g
    [TARS-MK4.1-PMB.kicad_sch]
2023-04-15 Hello Eisha
    Hello Eisha
    [TARS-MK4.1-TELEM.kicad_pcb, TARS-MK4.1-TELEM.kicad_sch]
2023-04-15 modified ILM on regulator, changed B2B to give 6 pins to VBAT for 3 amps
    [TARS-MK4.1-TELEM.kicad_pcb, TARS-MK4.1-TELEM.kicad_sch]
2023-04-15 changed b2b to allocate 6 pins for VBAT at 3A, modified regulator ILIM value
    [TARS-MK4.1-PMB.kicad_pcb, TARS-MK4.1-PMB.kicad_sch]
2023-04-15 Fixed VBAT Trace
    Fixed VBAT Trace
    [TARS-MK4.1-PMB.kicad_pcb]
2023-04-15 flipped connector bc rishi g put it on backwards
    [TARS-MK4.1-TELEM.kicad_pcb]
2023-05-16 Removed bad commit
    [TARS-MK4-TELEM.kicad_pcb, TARS-MK4-TELEM.kicad_sch]
2023-05-17 Updated sch, still needs review. Inconsistent
    [TARS-MK4.1-TELEM.kicad_sch]
2023-05-17 Finished PMB
    [TARS-MK4.1-PMB.kicad_pcb, TARS-MK4.1-PMB.kicad_sch]
2023-05-17 Worked on Telem, Finished needs final passs
    [TARS-MK4.1-TELEM.kicad_pcb, TARS-MK4.1-TELEM.kicad_sch]
2023-05-17 Updated Regulator sym
2023-05-18 Added new particle 3d model path to pcb fp
    [TARS-MK4.1-TELEM.kicad_pcb]
2023-05-18 Updated ESD fp, added Molex ML 3D Model
    [TARS-MK4.1-TELEM.kicad_pcb, TARS-MK4.1-TELEM.kicad_sch]
2023-05-18 Added updated efuse 3D model to board
    [TARS-MK4.1-PMB.kicad_pcb, TARS-MK4.1-PMB.kicad_sch, TARS-MK4.1-TELEM.kicad_pcb]
2023-05-18 Added Cree LED 3D Model to TELEM
    [TARS-MK4.1-TELEM.kicad_pcb]
2023-05-18 Cleaned up PMB + TELEM BTB's
    [TARS-MK4.1-PMB.kicad_pcb, TARS-MK4.1-PMB.kicad_sch, TARS-MK4.1-TELEM.kicad_sch]
2023-05-18 Updated FCB B2B's to match PMB and TELEM
    [TARS-MK4.1-FCB.kicad_pcb, TARS-MK4.1-FCB.kicad_sch]
2023-05-18 Changed position of VBATT label on BTB to follow KLC
    [TARS-MK4.1-TELEM.kicad_pcb, TARS-MK4.1-TELEM.kicad_sch]
2023-05-19 Fixed CAB
    [TARS-MK4.1-CAB.kicad_pcb, TARS-MK4.1-CAB.kicad_sch]
2023-05-20 Added I/O labels to PMB regulators
    [TARS-MK4.1-PMB.kicad_sch]
2023-08-09 Added US resistor images
2023-08-27 Made Schematic Conventions
2023-08-27 Finished v1 of schematic conventions, fixed spacing
2023-09-19 created project files for AV-1028/SPARK
    [SPARK-MK1.kicad_pcb, SPARK-MK1.kicad_sch]
2023-10-08 parts down and couple wires made
    [SPARK-MK1.kicad_sch]
2023-10-09 added debug pins/leds, buzzer, and power input
    [SPARK-MK1.kicad_sch]
2023-10-10 SPARK update 9OCT2023
    [SPARK-MK1.kicad_sch]
2023-10-12 added comments, added incandescent bulbs
    [SPARK-MK1.kicad_sch]
2023-10-13 Removed eFuse Output
    [SPARK-MK1.kicad_sch]
2023-10-13 Everything But POWER (and SD)
    [SPARK-MK1.kicad_sch]
2023-10-13 Everything but POWERgit add boards/SPARK-MK1/SPARK-MK1.kicad_sch!
    [SPARK-MK1.kicad_sch]
2023-10-16 Av 1024/midas pyro (#220)
    * Created MIDAS schematic files
    * updated root sheet
    * Renamed files and added hierachical labels to root sheet
    * deleted backups
    * Initial pyro circuit added
    * Added custom symbols and footprints for MOSFET and GPIO Expanders
    * added preliminary schematic for pyro
    * Added custom mosfet symbol
    * updated mosfet symbols and fixed master fet
    * fixed some pyro errors before RCP implementation
    * Added efuse, need to implement, may change
    * Solved continuity issue, continuing work on efuse
    * Added and assigned footprints, still need to finish efuse
    * Bypassed efuse, pending removal at approval
    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
    [MIDAS-MK1-Power.kicad_sch, MIDAS-MK1-Pyro.kicad_sch, MIDAS-MK1-RF.kicad_sch, MIDAS-MK1-Sensors.kicad_sch, MIDAS-MK1.kicad_pcb, MIDAS-MK1.kicad_sch]
2023-10-16 Revert "Av 1024/midas pyro (#220)" (#224)
    This reverts commit 7123e11908aeb5e92dd0afe741611b470fb86e6c.
    [MIDAS-MK1-Power.kicad_sch, MIDAS-MK1-Pyro.kicad_sch, MIDAS-MK1-RF.kicad_sch, MIDAS-MK1-Sensors.kicad_sch, MIDAS-MK1.kicad_pcb, MIDAS-MK1.kicad_sch]
2023-10-16 Finishing Touches
    [SPARK-MK1.kicad_sch]
2023-10-23 fixing missing footprints
    [SPARK-MK1.kicad_sch]
2023-11-03 fixing small stuff
    [SPARK-MK1.kicad_sch]
2023-11-03 updated footprints
    [SPARK-MK1.kicad_sch]
2023-11-03 PCB set
    [SPARK-MK1.kicad_pcb, SPARK-MK1.kicad_sch]
2023-11-07 Learning how to route
    [SPARK-MK1.kicad_pcb, SPARK-MK1.kicad_sch]
2024-01-06 Rerouting SPARK
    [SPARK-MK1.kicad_pcb, SPARK-MK1.kicad_sch]
2024-01-06 Routing Update
    [SPARK-MK1.kicad_pcb]
2024-01-06 Finished inital route
    [SPARK-MK1.kicad_pcb]
2024-01-10 Created MIDAS schematic files
    [MIDAS-MK1.kicad_pcb, MIDAS-MK1.kicad_sch, Power_and_Sensors.kicad_sch, PyroCircuitry.kicad_sch, RF.kicad_sch]
2024-01-10 updated root sheet
    [MIDAS-MK1.kicad_sch]
2024-01-10 Renamed files and added hierachical labels to root sheet
    [MIDAS-MK1-Power.kicad_sch, MIDAS-MK1-Pyro.kicad_sch, MIDAS-MK1-RF.kicad_sch, MIDAS-MK1-Sensors.kicad_sch, MIDAS-MK1.kicad_sch, Power_and_Sensors.kicad_sch, PyroCircuitry.kicad_sch, RF.kicad_sch]
2024-01-10 Av 1026/midas rf (#222)
    * Added chips
    i like potato
    * add hierarchical sheets
    * Board Layout rev A Complete
    yay
    * RF
    * linked footprints
    * Library changes
    * Library linking
    * basic PCB layout
    * remove extraneous pins
    * Finished HOPE sch
    Finished HOPE sch
    * Post-merge cleanup work
    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
    [MIDAS-MK1-Pyro.kicad_sch, MIDAS-MK1-RF.kicad_sch, MIDAS-MK1.kicad_pcb, MIDAS-MK1.kicad_sch]
2024-01-10 Revert "Av 1026/midas rf (#222)" (#223)
    This reverts commit 549a5f77116fb332af870fa6efee58222ba06e32.
    [MIDAS-MK1-Pyro.kicad_sch, MIDAS-MK1-RF.kicad_sch, MIDAS-MK1.kicad_pcb, MIDAS-MK1.kicad_sch]
2024-01-10 Av 1024/midas pyro (#225)
    * Started to make pyro pretty
    * Started to make pyro pretty
    * Finalized Pyro schematic for review
    * Finalized Pyro schematic for review
    * Finalized Pyro schematic for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
    [MIDAS-MK1-Pyro.kicad_sch]
2024-01-10 Av 1027/midas mcu mem can eMMC (#218)
    * Made initial memory library
    * Updated Symbol Table
    * Finalized draft of eMMC symbol
    * Made changes to eMMC symbol design
    * Made Custom Library for Micro SSD
    * Symbol for Micro SD
    * Finished draft of CAN chip, added MCU to schematic
    * Added to schematic
    * Not sure if I commited this right
    * added USB receptacle and ESD chip to schematic
    * added LEDs, buzzer, and reset switch
    * added debug headers and reset header
    * added terminal blocks
    * making schematic better
    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
    [MIDAS-MK1.kicad_sch]
2024-01-10 Av 1025/midas pow (#226)
    * edited 3V3 Regulator
    * edited 3V3 Regulator symbol
    * added 3V3 regulator
    * added power schematics
    * Editted Power Schematic
    * Editted Power Schematic
    * Add files via upload
    * Editted Power Schematic
    * created symbol for power MUX and started schematic
    * finished layout of power mux
    * made a couple small changes to schematic, need to input variable resistor values
    * Finished power mux schematic
    * deleted .lck files
    * Found symbol/footprint online and updated labels to hierarchal
    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
    [MIDAS-MK1-Power.kicad_sch, MIDAS-MK1-Pyro.kicad_sch, MIDAS-MK1-RF.kicad_sch, MIDAS-MK1-Sensors.kicad_sch, MIDAS-MK1.kicad_sch]
2024-01-10 Revert "Av 1025/midas pow (#226)" (#227)
    This reverts commit c61530bf88945ee3273e8de295040427b45c7b7d.
    [MIDAS-MK1-Power.kicad_sch, MIDAS-MK1-Pyro.kicad_sch, MIDAS-MK1-RF.kicad_sch, MIDAS-MK1-Sensors.kicad_sch, MIDAS-MK1.kicad_sch]
2024-01-10 Av 1025/midas pow (#228)
    * added comments and cleaned some things up
    * Removed E-Fuses and routed the voltage regulators directly to the MUX
    * fixed footprint
    * omi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
    [MIDAS-MK1-Power.kicad_sch, MIDAS-MK1-Pyro.kicad_sch, MIDAS-MK1-RF.kicad_sch, MIDAS-MK1-Sensors.kicad_sch, MIDAS-MK1.kicad_sch]
2024-01-10 Revert "Av 1025/midas pow (#228)" (#229)
    This reverts commit 0c03e670b6b5c77b8d2ef66a8f13122089cb2a88.
    [MIDAS-MK1-Power.kicad_sch, MIDAS-MK1-Pyro.kicad_sch, MIDAS-MK1-RF.kicad_sch, MIDAS-MK1-Sensors.kicad_sch, MIDAS-MK1.kicad_sch]
2024-01-10 Av 1025/midas sens (#230)
    * Finished getting all sensors
    * Added labels to all sensors
    * added LSM6DSL for gyro
    * edited sensor schematic
    * removed gas sensor, added comments, and added footprints for caps
    * Editted Sensor schematic and added to the footprint library
    * Changed res footprints to 0603
    ---------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
    [MIDAS-MK1-Power.kicad_sch, MIDAS-MK1-Sensors.kicad_sch]
2024-01-10 Av 1025/midas pow (#231)
    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
    [MIDAS-MK1-Power.kicad_sch, MIDAS-MK1-Pyro.kicad_sch, MIDAS-MK1-RF.kicad_sch, MIDAS-MK1-Sensors.kicad_sch, MIDAS-MK1.kicad_sch]
2024-01-10 Revert "Av 1025/midas pow (#231)" (#232)
    This reverts commit 87e6dc53c675f6ffee6bb6cc4eb7d78669cb95e1.
    [MIDAS-MK1-Power.kicad_sch, MIDAS-MK1-Pyro.kicad_sch, MIDAS-MK1-RF.kicad_sch, MIDAS-MK1-Sensors.kicad_sch, MIDAS-MK1.kicad_sch]
2024-01-10 made some visual changes
    [MIDAS-MK1-Power.kicad_sch, MIDAS-MK1-Pyro.kicad_sch, MIDAS-MK1-Sensors.kicad_sch]
2024-01-10 Updated ADC symbol
2024-01-10 Updated regulator library
2024-01-10 Deleted redundant libray: Look at Power_eFuses
2024-01-10 Removed redundant footprint: Check Packages_VQFN
2024-01-10 Updated power MUX
2024-01-10 Updated ideal diode library
2024-01-10 Removed unused footprints
2024-01-10 adjusting placement and labels
    [MIDAS-MK1-Power.kicad_sch, MIDAS-MK1-Pyro.kicad_sch, MIDAS-MK1-Sensors.kicad_sch, MIDAS-MK1.kicad_sch]
2024-01-10 general improvements
    [MIDAS-MK1-Power.kicad_sch, MIDAS-MK1-Pyro.kicad_sch, MIDAS-MK1-RF.kicad_sch, MIDAS-MK1-Sensors.kicad_sch, MIDAS-MK1.kicad_sch]
2024-01-10 Updated SAW filter to follow KLC
2024-01-10 Added regulator inductor and fixed sym table for analog sens
2024-01-10 Updated MOSFETs to follow KLC
2024-01-10 Updated ESP32 sym lib to use Kicad footprint
2024-01-10 Added new symbols with correct fps, need to connect
    [MIDAS-MK1-Power.kicad_sch, MIDAS-MK1-Pyro.kicad_sch, MIDAS-MK1-RF.kicad_sch, MIDAS-MK1-Sensors.kicad_sch, MIDAS-MK1.kicad_sch]
2024-01-10 Updated sch to have new libs
    [MIDAS-MK1-Power.kicad_sch, MIDAS-MK1-Pyro.kicad_sch, MIDAS-MK1-RF.kicad_sch, MIDAS-MK1-Sensors.kicad_sch, MIDAS-MK1.kicad_sch]
2024-01-10 reworked power sch
    [MIDAS-MK1-Power.kicad_sch]
2024-01-10 Updated RF sch
    [MIDAS-MK1-RF.kicad_sch]
2024-01-10 Began rough outline
    [MIDAS-MK1.kicad_pcb, MIDAS-MK1.kicad_sch]
2024-01-10 reworked pyro schematic
    [MIDAS-MK1-Pyro.kicad_sch]
2024-01-10 pcb updated
    [MIDAS-MK1.kicad_pcb]
2024-01-10 added footprint for ADXL
    [MIDAS-MK1-Power.kicad_sch, MIDAS-MK1-Pyro.kicad_sch, MIDAS-MK1-RF.kicad_sch, MIDAS-MK1-Sensors.kicad_sch, MIDAS-MK1.kicad_sch]
2024-01-10 updated PCB file
    [MIDAS-MK1.kicad_pcb]
2024-01-10 updated sch files, fixed short
    [MIDAS-MK1-Power.kicad_sch, MIDAS-MK1-Pyro.kicad_sch, MIDAS-MK1-Sensors.kicad_sch, MIDAS-MK1.kicad_sch]
2024-01-10 updated sch files for review
    [MIDAS-MK1-Power.kicad_sch, MIDAS-MK1-Pyro.kicad_sch, MIDAS-MK1-RF.kicad_sch, MIDAS-MK1-Sensors.kicad_sch, MIDAS-MK1.kicad_sch]
2024-01-10 added pull up resistors on EXP_INT 1 and 2
    [MIDAS-MK1.kicad_sch]
2024-01-10 made CAN connector libs relative paths
2024-01-10 progress on routing
    [MIDAS-MK1.kicad_sch]
2024-01-10 routing updated
    [MIDAS-MK1.kicad_pcb, MIDAS-MK1.kicad_sch]
2024-01-10 routing done and sch updated
    [MIDAS-MK1-Pyro.kicad_sch, MIDAS-MK1-RF.kicad_sch, MIDAS-MK1-Sensors.kicad_sch, MIDAS-MK1.kicad_pcb, MIDAS-MK1.kicad_sch]
2024-01-10 Started cleaning schematic
    [MIDAS-MK1.kicad_sch]
2024-01-10 Added molex micro fit plus to schematic
2024-01-10 Continued working on cleanup
    [MIDAS-MK1.kicad_sch]
2024-01-10 Updates ESP libs and cleaned more schematic
    [MIDAS-MK1.kicad_sch]
2024-01-10 Continued schematic work nearly done
    [MIDAS-MK1.kicad_sch]
2024-01-10 Finished cleaning root sch, need to place back inside sheet
    [MIDAS-MK1-Pyro.kicad_sch, MIDAS-MK1-RF.kicad_sch, MIDAS-MK1-Sensors.kicad_sch, MIDAS-MK1.kicad_sch]
2024-01-10 Worked on organizing stuff inside of A4 sch sheet
    [MIDAS-MK1.kicad_sch]
2024-01-10 Finsihed organizing root sch need to finish other sheets
    [MIDAS-MK1.kicad_sch]
2024-01-10 Added some comments for review and cleaned some more
    [MIDAS-MK1-Pyro.kicad_sch, MIDAS-MK1.kicad_sch]
2024-01-10 Cleaned other sheets
    [MIDAS-MK1-Power.kicad_sch, MIDAS-MK1-Pyro.kicad_sch, MIDAS-MK1-RF.kicad_sch, MIDAS-MK1-Sensors.kicad_sch, MIDAS-MK1.kicad_sch]
2024-01-10 Added sys power label in power sch
    [MIDAS-MK1-Power.kicad_sch]
2024-01-10 pcb changes
    [MIDAS-MK1.kicad_pcb]
2024-01-10 moved sma connectors and updated pcb
    [MIDAS-MK1-Sensors.kicad_sch, MIDAS-MK1.kicad_pcb]
2024-01-10 Revert "moved sma connectors and updated pcb"
    This reverts commit 712db316c282e6692a0b81c0ad7abc7397cc36b6.
    [MIDAS-MK1-Sensors.kicad_sch, MIDAS-MK1.kicad_pcb]
2024-01-10 Revert "pcb changes"
    This reverts commit 86c75ac5717706db91b06acaea677e018d305976.
    [MIDAS-MK1.kicad_pcb]
2024-01-10 Changed Q201 MOSfet Side and changed V_Pyro routing
    [MIDAS-MK1.kicad_pcb]
2024-01-10 Updated PMB: senses, labels, formats
    [MIDAS-MK1.kicad_pcb]
2024-01-10 began rerouting
    [MIDAS-MK1.kicad_pcb]
2024-01-10 Added 3D Models
    [MIDAS-MK1-RF.kicad_sch, MIDAS-MK1-Sensors.kicad_sch, MIDAS-MK1.kicad_pcb, MIDAS-MK1.kicad_sch]
2024-01-10 Began basic routing
    [MIDAS-MK1-Power.kicad_sch, MIDAS-MK1-Pyro.kicad_sch, MIDAS-MK1-RF.kicad_sch, MIDAS-MK1-Sensors.kicad_sch, MIDAS-MK1.kicad_pcb, MIDAS-MK1.kicad_sch]
2024-01-10 Half the board is re-routed
    [MIDAS-MK1.kicad_pcb]
2024-01-10 Updated board fab outputs
2024-01-10 Began routing eMMC chip
    [MIDAS-MK1-RF.kicad_sch, MIDAS-MK1-Sensors.kicad_sch, MIDAS-MK1.kicad_pcb, MIDAS-MK1.kicad_sch]
2024-01-10 Continued routing
    [MIDAS-MK1.kicad_pcb]
2024-01-10 Worked on more routing of sensors
    [MIDAS-MK1.kicad_pcb, MIDAS-MK1.kicad_sch]
2024-01-10 Nearly finished routing
    [MIDAS-MK1.kicad_pcb, MIDAS-MK1.kicad_sch]
2024-01-10 Mirrored RF modules, moved SD reader
    [MIDAS-MK1-Power.kicad_sch, MIDAS-MK1.kicad_pcb, MIDAS-MK1.kicad_sch]
2024-01-10 Finished routing, need to add graphics and test points
    [MIDAS-MK1.kicad_pcb, MIDAS-MK1.kicad_sch]
2024-01-10 Finished routing
    [MIDAS-MK1-Power.kicad_sch, MIDAS-MK1.kicad_pcb]
2024-01-10 Cleaned schematic a tad bit
    [MIDAS-MK1.kicad_sch]
2024-01-10 Updated CAN chip and some symbols
    [MIDAS-MK1-Power.kicad_sch, MIDAS-MK1-Sensors.kicad_sch, MIDAS-MK1.kicad_pcb, MIDAS-MK1.kicad_sch]
2024-01-10 Flipped MOSFET for Pyro EN
    [MIDAS-MK1-Pyro.kicad_sch, MIDAS-MK1.kicad_pcb]
2024-01-10 Updated IO_VDD pin name on KX
2024-01-10 Updated symbol pin names on LIS3 and LSM6
2024-01-10 Updated TI TPS566242 pin number for SW, FB, EN
2024-01-10 Updated power mux to follow KLC
2024-01-10 Updated eMMC, Ideal Diode, and footprints to follow KLC
2024-01-10 Updated 3D model for VQFN footprint (Efuse)
2024-01-10 Updated ESP32-S3 Footprint to follow KLC
2024-01-10 Moddified footprints to follow KLC
2024-01-10 Moved MIDAS to MK1 revA folder
    [MIDAS-MK1-Power.kicad_sch, MIDAS-MK1-Pyro.kicad_sch, MIDAS-MK1-RF.kicad_sch, MIDAS-MK1-Sensors.kicad_sch, MIDAS-MK1.kicad_pcb, MIDAS-MK1.kicad_sch]
2024-01-10 Removed orange annotations on Pyro
    [MIDAS-MK1-Pyro.kicad_sch]
2024-01-10 Rev B changes: remapped power regulators, changed USB resistors, opened up GPIO46, fixed silkscreen
    [MIDAS-MK1-Power.kicad_sch, MIDAS-MK1-Pyro.kicad_sch, MIDAS-MK1-RF.kicad_sch, MIDAS-MK1-Sensors.kicad_sch, MIDAS-MK1.kicad_pcb, MIDAS-MK1.kicad_sch]
2024-01-10 Revert 220 av 1024/midas pyro (#221)
    * Av 1024/midas pyro (#220)
    * Bypassed efuse, pending removal at approva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
2024-01-10 Created AV-1029/SG_CAM project files
    [SG_CAM.kicad_pcb, SG_CAM.kicad_sch]
2024-01-10 Added eFuse and Voltage Regulators
    [SG_CAM.kicad_sch]
2024-01-10 Added eFuses and Voltage Regulators V2
2024-01-10 Added MCU
    Named some pins
    [SG_CAM.kicad_sch]
2024-01-10 Changed Power Regulators and Added Footprints
    [SG_CAM.kicad_sch]
2024-01-10 Added VBAT
    Added battery connector locations
    [SG_CAM.kicad_sch]
2024-01-10 added buzzer, leds, power input, debug headers
    [SG_CAM.kicad_sch]
2024-01-10 Updated Labels and UBS-C
    [SG_CAM.kicad_sch]
2024-01-10 Added Power MUX, CAN, 3V3 Regulator, Updated Footprints
    [SG_CAM.kicad_sch]
2024-01-10 Updated Power and Added Pin Headers
    [SG_CAM.kicad_sch]
2024-01-10 Minor Changes
    [SG_CAM.kicad_sch]
2024-01-10 Updated Border Lines
    [SG_CAM.kicad_sch]
2024-01-10 Fixed Footprint Paths and Added Extra Power Outputs
    [SG_CAM.kicad_sch]
2024-01-10 Placed footprints + some routing
    [SG_CAM.kicad_pcb, SG_CAM.kicad_sch]
2024-01-10 Finished V1 of CAM Board Routing
    [SG_CAM.kicad_pcb, SG_CAM.kicad_sch]
2024-01-10 added fill and adjusted footprints
    [SG_CAM.kicad_pcb, SG_CAM.kicad_sch]
2024-01-10 added mounting holes
    [SG_CAM.kicad_pcb, SG_CAM.kicad_sch]
2024-01-10 Made a Few Routing Changes
    To Do:
    - Increase Width of Power Traces
    - Fix CAN Connections
    - Add Screw Terminal for Battery Power
    [SG_CAM.kicad_pcb, SG_CAM.kicad_sch]
2024-01-10 Updated Camera Control Traces
    [SG_CAM.kicad_pcb]
2024-01-10 Updated camera power traces
2024-01-10 Fixed CAN Chip and Increased Power Trace Width
    [SG_CAM.kicad_pcb, SG_CAM.kicad_sch]
2024-01-10 Fixed DRC Errors and Removed Right Angles in Tracing
    [SG_CAM.kicad_pcb, SG_CAM.kicad_sch]
2024-01-10 Rotated CAN Connector
    [SG_CAM.kicad_pcb]
2024-01-10 Cam Board 1.0 Rev A Version 1
    [SG_CAM.kicad_sch]
2024-01-10 created onboarding project schematics
    [SpaceShot_Onboarding_Project.kicad_pcb, SpaceShot_Onboarding_Project.kicad_sch]
2024-01-10 Fixed grid stuff
    [SpaceShot_Onboarding_Project.kicad_sch]
2024-01-10 added footprints, routed a one layer board
    [SpaceShot_Onboarding_Project.kicad_pcb, SpaceShot_Onboarding_Project.kicad_sch]
2024-01-10 changed a few details on the layout
    [SpaceShot_Onboarding_Project.kicad_pcb]
2024-01-10 added SMD components, minor tweaks
    [SpaceShot_Onboarding_Project.kicad_pcb, SpaceShot_Onboarding_Project.kicad_sch]
2024-01-10 finalized onboarding 555 timer
    [555-Timer-Demo-Circuit.kicad_pcb, 555-Timer-Demo-Circuit.kicad_sch, SpaceShot_Onboarding_Project.kicad_pcb, SpaceShot_Onboarding_Project.kicad_sch]
2024-01-10 completed L1 Altimeter schematic
    [L1-Altimeter.kicad_pcb, L1-Altimeter.kicad_sch]
2024-01-10 added more to schematic and completed routing
    [L1-Altimeter.kicad_pcb, L1-Altimeter.kicad_sch]
2024-01-10 cleaning things up
    [L1-Altimeter.kicad_pcb, L1-Altimeter.kicad_sch]
2024-01-10 properly assigned terminal block 3dmodels
    [555-Timer-Demo-Circuit.kicad_pcb, L1-Altimeter.kicad_pcb]
2024-01-10 fixing Onboarding folder capitalization
    [555-Timer-Demo-Circuit.kicad_pcb, 555-Timer-Demo-Circuit.kicad_sch, L1-Altimeter.kicad_pcb, L1-Altimeter.kicad_sch]
2024-01-10 fixed Onboarding folder capitalization
    [555-Timer-Demo-Circuit.kicad_pcb, 555-Timer-Demo-Circuit.kicad_sch, L1-Altimeter.kicad_pcb, L1-Altimeter.kicad_sch]
2024-01-10 changed MOSFET footprint
    [555-Timer-Demo-Circuit.kicad_pcb, 555-Timer-Demo-Circuit.kicad_sch]
2024-01-10 added 555 Timer render to README
2024-01-11 updated revision silkscreen label
    [MIDAS-MK1.kicad_pcb]
2024-01-11 updated dates for changed files
    [MIDAS-MK1-Power.kicad_sch, MIDAS-MK1-RF.kicad_sch, MIDAS-MK1.kicad_pcb, MIDAS-MK1.kicad_sch]
2024-01-11 Updated missing 3D models on MIDAS
    [MIDAS-MK1.kicad_pcb]
2024-01-11 added revA to avoid conflicts
    [MIDAS-MK1-Power.kicad_sch, MIDAS-MK1-Pyro.kicad_sch, MIDAS-MK1-RF.kicad_sch, MIDAS-MK1-Sensors.kicad_sch, MIDAS-MK1.kicad_pcb, MIDAS-MK1.kicad_sch]
2024-01-11 added crystal 3D model to revB
    [MIDAS-MK1.kicad_pcb]
2024-01-11 Updated USB label on ESP and centered MIDAS logo on layout
    [MIDAS-MK1.kicad_pcb, MIDAS-MK1.kicad_sch]
2024-01-11 updated MicroSD + SPI labels and no-connects
    [MIDAS-MK1.kicad_sch]
2024-01-12 initial MK1.1 setup
    [MIDAS-MK1.1-Power.kicad_sch, MIDAS-MK1.1-Pyro.kicad_sch, MIDAS-MK1.1-RF.kicad_sch, MIDAS-MK1.1-Sensors.kicad_sch, MIDAS-MK1.1.kicad_pcb, MIDAS-MK1.1.kicad_sch]
2024-01-12 updated all symbols, associated changes, other formatting
    [MIDAS-MK1.1-Power.kicad_sch, MIDAS-MK1.1-Pyro.kicad_sch, MIDAS-MK1.1-RF.kicad_sch, MIDAS-MK1.1-Sensors.kicad_sch, MIDAS-MK1.1.kicad_sch]
2024-01-12 changed mounting holes, add 3v3 debug LED, removed 5V reg
    [MIDAS-MK1.1-Power.kicad_sch, MIDAS-MK1.1.kicad_sch]
2024-01-13 Finished CAN Schematics
    [MIDAS-MK1.1-Power.kicad_sch, MIDAS-MK1.1.kicad_sch]
2024-01-13 added SAW filter and switch symbols, most of GNSS schematic
    [MIDAS-MK1.1-RF.kicad_sch]
2024-01-13 changed SAW filter, added associated libraries
    [MIDAS-MK1.1-RF.kicad_sch]
2024-01-14 updated/reformatted CAN, microSD, 3V3 LED
    [MIDAS-MK1.1-Power.kicad_sch, MIDAS-MK1.1.kicad_sch]
2024-01-14 added CAN connector to CAN box
    [MIDAS-MK1.1.kicad_sch]
2024-01-14 reformatted GNSS schematic
    [MIDAS-MK1.1-RF.kicad_sch]
2024-01-14 fixed CAN_Fault to be an output
    [MIDAS-MK1.1.kicad_sch]
2024-01-14 Updated mux resistances to reflect addition of diode
    [MIDAS-MK1.1-Power.kicad_sch]
2024-01-15 switched LSM CS for ADXL CS on MCU and made small adjustments
    [MIDAS-MK1.1-Power.kicad_sch, MIDAS-MK1.1.kicad_sch]
2024-01-16 added CAN_FAULT pullup
    [MIDAS-MK1.1.kicad_sch]
2024-01-16 corrected bias tee design, added values
    [MIDAS-MK1.1-RF.kicad_sch]
2024-01-16 assigned correct footprints for RF passives
    [MIDAS-MK1.1-RF.kicad_sch]
2024-01-17 Added pyro connector
    [SPARK-MK1.kicad_sch]
2024-01-17 finished major routing, made small schematic changes
    [MIDAS-MK1.1-RF.kicad_sch, MIDAS-MK1.1.kicad_pcb, MIDAS-MK1.1.kicad_sch]
2024-01-17 reorganized 3V3 regulator area
    [MIDAS-MK1.1.kicad_pcb]
2024-01-18 CAM Board 1.0 Rev A Version 2
    [SG_CAM.kicad_sch]
2024-01-19 changed terminal blocks and added U.FL/SMA footprint
    [MIDAS-MK1.1-RF.kicad_sch, MIDAS-MK1.1.kicad_pcb, MIDAS-MK1.1.kicad_sch]
2024-01-19 changed all pages to A3
    [MIDAS-MK1.1-Power.kicad_sch, MIDAS-MK1.1-RF.kicad_sch, MIDAS-MK1.1-Sensors.kicad_sch]
2024-01-19 Minor Misc formatting/routing changes
    [MIDAS-MK1.1-RF.kicad_sch, MIDAS-MK1.1.kicad_pcb, MIDAS-MK1.1.kicad_sch]
2024-01-19 added testpoint labels
    [MIDAS-MK1.1.kicad_pcb]
2024-01-19 rerouted regulator, added correct terminal block MPN to sch
    [MIDAS-MK1.1.kicad_pcb, MIDAS-MK1.1.kicad_sch]
2024-01-19 minor regulator routing changes
    [MIDAS-MK1.1.kicad_pcb]
2024-01-19 changed SMA connector, centered boot/reset labels
    [MIDAS-MK1.1.kicad_pcb]
2024-01-20 finalized SMA, renamed expander symbols, added backside labels, changed SYS_POWER test point, changed microSD 3D model color, other small stuff
    [MIDAS-MK1.1-Power.kicad_sch, MIDAS-MK1.1.kicad_pcb, MIDAS-MK1.1.kicad_sch]
2024-01-20 fixed GPIO/ADC expander symbol library naming ptII
2024-01-20 added logos to back silkscreen
    [MIDAS-MK1.1.kicad_pcb]
2024-01-20 made minor changes and removed a few 90 degree angles
    [MIDAS-MK1.1.kicad_pcb]
2024-01-21 fixed inconsistent trace widths and angles
    [MIDAS-MK1.1.kicad_pcb]
2024-01-21 schematic organizational changes
    [MIDAS-MK1.1-Power.kicad_sch, MIDAS-MK1.1.kicad_sch]
2024-01-21 prettied up traces
    [MIDAS-MK1.1.kicad_pcb]
2024-01-21 changed 10pF to 10nF on RF schematic
    [MIDAS-MK1.1-RF.kicad_sch]
2024-01-22 CAM Board 1.0 Rev A Version 3
    [SG_CAM.kicad_sch]
2024-01-22 CAM Board 1.0 Rev A Version 3.1
    [SG_CAM.kicad_sch]
2024-01-23 CAM Board 1.0 Rev A Version D
    [SG_CAM.kicad_sch]
2024-01-24 added to silkscreen and updated contributors
    [MIDAS-MK1.1-Power.kicad_sch, MIDAS-MK1.1-RF.kicad_sch, MIDAS-MK1.1-Sensors.kicad_sch, MIDAS-MK1.1.kicad_pcb]
2024-01-24 CAM Board 1.0 Rev A Version 5
    [SG_CAM.kicad_sch]
2024-01-24 removed mention of 5v on hierarchical sheet
    [MIDAS-MK1.1.kicad_sch]
2024-01-24 added back height measurment use drawing
    [MIDAS-MK1.1.kicad_pcb]
2024-01-24 Preliminary SPARK Changes
    [SPARK-MK1.kicad_sch]
2024-01-24 added 3d model to 4pin connector
2024-01-25 Starting to revise schematic
    [SPARK-MK1.kicad_sch]
2024-01-25 Started Routing
    Placed all components (no traces), need to prevent reference overlaps
    [SG_CAM.kicad_pcb, SG_CAM.kicad_sch]
2024-01-25 routed 3v3 regulator
    [SG_CAM.kicad_pcb, SG_CAM.kicad_sch]
2024-01-25 Forgot to commit this
    [untitled.kicad_sch]
2024-01-25 routed much of power circuitry
    [SG_CAM.kicad_pcb]
2024-01-26 Fixing Errors ???
    [SPARK-MK1.kicad_sch]
2024-01-26 Completely Redoing the Board
    [SPARK-MK1.kicad_sch, untitled.kicad_sch]
2024-01-26 fixed small resistors
    [MIDAS-MK1.1-Sensors.kicad_sch]
2024-01-26 changed microSD connector, fixed diode footprint, silkscreen changes
    [MIDAS-MK1.1-Power.kicad_sch, MIDAS-MK1.1.kicad_pcb, MIDAS-MK1.1.kicad_sch]
2024-01-26 Routed CAN Chip, Flash, Crystal, some IO
    Still need to route:
    - Power
    - Debug
    [SG_CAM.kicad_pcb, SG_CAM.kicad_sch]
2024-01-26 adjusted trace widths
    [MIDAS-MK1.1.kicad_pcb]
2024-01-26 changed capacitor from polarized to normal
    [MIDAS-MK1.1-Pyro.kicad_sch]
2024-01-27 added courtyards to inductor footprints
2024-01-27 better aligned 3D models for molex connectors
2024-01-27 finished power circuitry routing, mostly done overall
    [SG_CAM.kicad_pcb, SG_CAM.kicad_sch]
2024-01-27 'finished' connecting things, added some 3d models
    [SG_CAM.kicad_pcb, SG_CAM.kicad_sch]
2024-01-27 added 3d models to board, fixed some DRC issues
    [SG_CAM.kicad_pcb, SG_CAM.kicad_sch]
2024-01-28 Fixed DRC + Conn Labels
    [SG_CAM.kicad_pcb]
2024-02-01 fixed regulator caps, added I2C conn pullups, sch formatting, minor routing changes, silkscreen logo
    [SG_CAM.kicad_pcb, SG_CAM.kicad_sch]
2024-02-01 minor schematic formatting, library changes
    [MIDAS-MK1.1-Power.kicad_sch, MIDAS-MK1.1-Pyro.kicad_sch, MIDAS-MK1.1.kicad_pcb]
2024-02-01 removed unused footprint library
    [SG_CAM.kicad_pcb]
2024-02-02 Made final adjustments
    [MIDAS-MK1.1-Power.kicad_sch, MIDAS-MK1.1.kicad_pcb, MIDAS-MK1.1.kicad_sch]
2024-02-03 near final schematic revisions: organization, important fixes
    [SG_CAM.kicad_sch]
2024-02-03 updated routing to reflect schematic changes
    [SG_CAM.kicad_pcb, SG_CAM.kicad_sch]
2024-02-04 Moved CAM Chip + Labels
    [SG_CAM.kicad_pcb, SG_CAM.kicad_sch]
2024-02-04 final(TM) routing, constraint fixes, making stuff pretty
    [SG_CAM.kicad_pcb, SG_CAM.kicad_sch]
2024-02-04 cleaning up footprint libraries
    [SG_CAM.kicad_pcb, SG_CAM.kicad_sch]
2024-02-04 added reset pin header backside silkscreen label
    [SG_CAM.kicad_pcb]
2024-02-04 fixed power mux 20k ohm res
    [SG_CAM.kicad_pcb, SG_CAM.kicad_sch]
2024-02-04 removed two 4 way intersections
    [SG_CAM.kicad_sch]
2024-02-05 changed 15uF capacitors to 0805
    [SG_CAM.kicad_pcb, SG_CAM.kicad_sch]
2024-02-05 removed inductor footprint in favor of kicad one
    [SG_CAM.kicad_pcb, SG_CAM.kicad_sch]
2024-02-05 Updated Power Mux Resistors
    [SG_CAM.kicad_pcb, SG_CAM.kicad_sch]
2024-02-05 Fixed Power Mux Resistor Typo
    [SG_CAM.kicad_pcb, SG_CAM.kicad_sch]
2024-02-05 Updated SYS_PWR on F.Silk Screen
    [MIDAS-MK1.1.kicad_pcb]
2024-02-05 Added JLC marking
    [SG_CAM.kicad_pcb]
2024-02-10 Just a few changes
    [SPARK-MK1.kicad_sch]
2024-02-10 Even more non-descript changes
    [untitled.kicad_sch]
2024-02-18 DigiPot and TPS25983 Sch init. design [BIG CHANGES]
    [SPARK-MK1.kicad_sch, untitled.kicad_sch]
2024-02-23 Finishing up big sch changes
    [SPARK-MK1.kicad_sch, untitled.kicad_sch]
2024-02-24 2-24-2024 Changes
    [SPARK-MK1.kicad_sch, untitled.kicad_sch]
2024-03-06 schematic changes
    [SPARK-MK1.kicad_sch]
2024-04-05 a couple more final changes
    [SPARK-MK1.kicad_sch]
2024-04-09 No changes, pushing so I can switch Branches
    [SPARK-MK1.kicad_sch]
2024-04-09 pushing minor schem changes(not final)
    [SPARK-MK1.kicad_sch]
2024-04-09 debug pins
    [SPARK-MK1.kicad_sch]
2024-04-12 fixing libs
    [SPARK-MK1.kicad_sch]
2024-04-12 Fixing Footprints, etc
    [SPARK-MK1.kicad_pcb, SPARK-MK1.kicad_sch]
2024-04-13 Four pins -> three pins
    [SPARK-MK1.kicad_sch]
2024-04-13 fixing small things and adding footprints to PCB
    [SPARK-MK1.kicad_pcb, SPARK-MK1.kicad_sch]
2024-04-14 Adding polarized capacitor to each e-fise. See: TPS25947 datasheet
    [SPARK-MK1.kicad_sch]
2024-04-15 init pcb
    [SPARK-MK1.kicad_pcb]
2024-04-17 added fill layers
    [SPARK-MK1.kicad_pcb]
2024-04-18 fixing some things
    [SPARK-MK1.kicad_pcb]
2024-04-20 Added Decoupling Capacitors to 1V1 on RP2040
    [SG_CAM.kicad_sch]
2024-04-20 Added Decoupling Capacitors to RP2040 1V1 V2
2024-04-20 Fixings and added silkscreen
    [SPARK-MK1.kicad_pcb]
2024-05-16 updated Power_Ideal_Diode symbol to meet KLC
    [MIDAS-MK1.1-Pyro.kicad_sch]
2024-05-26 Added Boot Switch, Fixed NMOS, Updated RP2040 Crystal
    [SG_CAM.kicad_sch]
2024-06-15 changed regulator inductor symbol from pspice:Inductor to Device:L for consistency
    [MIDAS-MK1.1-Power.kicad_sch]
2024-06-20 Fixed Power Limit Labels, Reset, Added Test Points and Power LEDs
    [SG_CAM.kicad_sch]
2024-06-21 Finished Mk2 Rev A Schematic
    [SG_CAM.kicad_sch]
2024-06-27 Started Mk2 Routing
    [SG_CAM.kicad_pcb, SG_CAM.kicad_sch]
2024-07-10 Changed Test Point Footprints + Other Minor Changes
    [SG_CAM.kicad_pcb, SG_CAM.kicad_sch]
2024-07-16 updated contributors
    [MIDAS-MK1.1-Power.kicad_sch, MIDAS-MK1.1.kicad_pcb]
2024-07-18 changed to black solder mask
    [MIDAS-MK1.1.kicad_pcb]
2024-08-09 Adding extra GND Layers
    [SPARK-MK1.kicad_pcb]
2024-08-11 schem and lib fixes
    [SPARK-MK1.kicad_pcb, SPARK-MK1.kicad_sch]
2024-08-13 rounded corners, removed unnecessary vias, increased trace widths
    [SPARK-MK1.kicad_pcb]
2024-08-13 added vias for stitching
    [SPARK-MK1.kicad_pcb]
2024-08-22 aligned pyros to grid and improved consistency
    [MIDAS-MK1.1-Pyro.kicad_sch]
2024-08-22 aligned root to grid, made screw terminal labels consistent
    [MIDAS-MK1.1.kicad_sch]
2024-08-22 aligned power to grid
    [MIDAS-MK1.1-Power.kicad_sch]
2024-08-22 updated Teseo pin text size to meet KLC
    [MIDAS-MK1.1-RF.kicad_sch]
2024-08-23 added pull up resistors
    [SPARK-MK1.kicad_pcb, SPARK-MK1.kicad_sch]
2024-08-24 schematic formatting
    [SG_CAM.kicad_sch]
2024-08-24 redesignated RPA0100A footprint and 3dmodel
2024-08-24 updated tps56637 symbol to reflect footprint change
2024-08-24 generalized crystal footprint, KLC changes
    [SG_CAM.kicad_sch]
2024-08-24 aligned schematic to grid
    [555-Timer-Demo-Circuit.kicad_sch]
2024-08-24 deleting unnecessary files
    [untitled.kicad_sch]
2024-08-24 revised potentiometer schematics
    [SPARK-MK1.kicad_sch]
2024-08-24 significant schematic formatting
    [SPARK-MK1.kicad_sch]
2024-08-25 updated pcb with schematic changes, still need to do a lot
    [SPARK-MK1.kicad_pcb]
2024-08-26 added constraints
    [SPARK-MK1.kicad_pcb]
2024-08-29 changed i2c pullup resistor text
    [SPARK-MK1.kicad_sch]
2024-08-29 added decoupling capacitor 3v3 zones
    [SPARK-MK1.kicad_pcb]
2024-09-03 renamed CAM folder from SG_CAM
    [SG_CAM.kicad_pcb, SG_CAM.kicad_sch]
2024-09-03 creating MK2 files
    [CAM-MK2.kicad_pcb, CAM-MK2.kicad_sch]
2024-09-03 reconfiguring with AV-1029 changes
    [SG_CAM.kicad_pcb, SG_CAM.kicad_sch]
2024-09-03 Rebasing CAM MK2 from main (#257)
    [555-Timer-Demo-Circuit.kicad_pcb, 555-Timer-Demo-Circuit.kicad_sch, L1-Altimeter.kicad_pcb, L1-Altimeter.kicad_sch, MIDAS-MK1.1-Power.kicad_sch, MIDAS-MK1.1-Pyro.kicad_sch, MIDAS-MK1.1-RF.kicad_sch, MIDAS-MK1.1-Sensors.kicad_sch]
2024-09-04 initial revB setup
    [MIDAS-MK1.1-Power.kicad_sch, MIDAS-MK1.1-Pyro.kicad_sch, MIDAS-MK1.1-RF.kicad_sch, MIDAS-MK1.1-Sensors.kicad_sch, MIDAS-MK1.1.kicad_pcb, MIDAS-MK1.1.kicad_sch]
2024-09-04 added sd pullups to sch and extensively moved boxes to make it fit
    [MIDAS-MK1.1.kicad_sch]
2024-09-04 changed sense voltage divider values
    [MIDAS-MK1.1-Pyro.kicad_sch, MIDAS-MK1.1.kicad_sch]
2024-09-04 doubled mcu boot delay resistance/time
    [MIDAS-MK1.1.kicad_sch]
2024-09-04 changed sma connector to one used by AltusMetrum
    [MIDAS-MK1.1-RF.kicad_sch]
2024-09-04 updated routing to reflect sch changes
    [MIDAS-MK1.1.kicad_pcb, MIDAS-MK1.1.kicad_sch]
2024-09-04 changed paste layers for better stencils
    [MIDAS-MK1.1.kicad_pcb]
2024-09-15 updated 4-pin molex footprint to meet KLC
2024-09-15 switched sma 3d model to old one that looks better
    [MIDAS-MK1.1.kicad_pcb]
2024-09-15 fixed RFM reset/int mismatch
    [MIDAS-MK1.1.kicad_pcb, MIDAS-MK1.1.kicad_sch]
2024-09-23 initial MK2 setup
    [MIDAS-MK2-Power.kicad_sch, MIDAS-MK2-Pyro.kicad_sch, MIDAS-MK2-RF.kicad_sch, MIDAS-MK2-Sensors.kicad_sch, MIDAS-MK2.kicad_pcb, MIDAS-MK2.kicad_sch]
2024-09-23 initial Motor setup
    [Motor-MK1.kicad_pcb, Motor-MK1.kicad_sch]
2024-09-23 Converting to KiCad v8
    [SPARK-MK1.kicad_pcb]
2024-09-29 moved ilm pins and routing changes
    [SPARK-MK1.kicad_pcb, SPARK-MK1.kicad_sch]
2024-09-29 significantly improved eFuse routing
    [SPARK-MK1.kicad_pcb]
2024-09-29 revamped connectors + grouped eFuses for future
    [SPARK-MK1.kicad_pcb, SPARK-MK1.kicad_sch]
2024-09-29 began board shape change
    [SPARK-MK1.kicad_pcb]
2024-09-30 Added ESP32 S3 Mini 1U Module
    [CAM-MK2.kicad_sch]
2024-09-30 Putting ESP32-S3-Mini-IU On sch
    [MIDAS-MK2.kicad_sch]
2024-09-30 adding ESP 32S3miniIUinputs
    [MIDAS-MK2.kicad_sch]
2024-10-01 Finished Updating MCU
    [CAM-MK2.kicad_sch]
2024-10-01 First Steps of Midas-MK2
    [MIDAS-MK2-Power.kicad_sch, MIDAS-MK2-Pyro.kicad_sch, MIDAS-MK2-RF.kicad_sch, MIDAS-MK2-Sensors.kicad_sch, MIDAS-MK2.kicad_sch]
2024-10-01 SD Card Stuff
    [MIDAS-MK2.kicad_sch]
2024-10-01 putting various things in
    [MIDAS-MK2-Power.kicad_sch, MIDAS-MK2-Pyro.kicad_sch, MIDAS-MK2-RF.kicad_sch, MIDAS-MK2-Sensors.kicad_sch, MIDAS-MK2.kicad_sch]
2024-10-02 added buzzer link
    [SPARK-MK1.kicad_sch]
2024-10-02 changed eFuse Cout to tantalum
    [SPARK-MK1.kicad_pcb, SPARK-MK1.kicad_sch]
2024-10-02 added LED datasheets
    [SPARK-MK1.kicad_sch]
2024-10-02 better specified potentiometer PN
    [SPARK-MK1.kicad_sch]
2024-10-04 added terminal block 3d models
    [SPARK-MK1.kicad_pcb, SPARK-MK1.kicad_sch]
2024-10-04 finished connections
    [SPARK-MK1.kicad_pcb]
2024-10-05 Switching Around Pins of ESP32-S3-MINI-IU According to Datasheet
    [MIDAS-MK2.kicad_sch]
2024-10-05 October 5th Meeting First Push
    [MIDAS-MK2.kicad_sch]
2024-10-05 swapping pins
    [MIDAS-MK2-Power.kicad_sch, MIDAS-MK2-Pyro.kicad_sch, MIDAS-MK2-RF.kicad_sch, MIDAS-MK2-Sensors.kicad_sch, MIDAS-MK2.kicad_sch]
2024-10-05 labelling and other minor changes
    [SPARK-MK1.kicad_pcb, SPARK-MK1.kicad_sch]
2024-10-06 more labeling, PCBWay
    [SPARK-MK1.kicad_pcb]
2024-10-06 added 3V3 testpoint
    [SPARK-MK1.kicad_pcb, SPARK-MK1.kicad_sch]
2024-10-06 drawing sheets
    [SPARK-MK1.kicad_pcb, SPARK-MK1.kicad_sch]
2024-10-08 adding TVS_Diode
    [MIDAS-MK2-Power.kicad_sch, MIDAS-MK2-Pyro.kicad_sch, MIDAS-MK2-RF.kicad_sch, MIDAS-MK2-Sensors.kicad_sch, MIDAS-MK2.kicad_sch]
2024-10-08 added I2C TVS diodes
    [MIDAS-MK2.kicad_sch]
2024-10-08 Added Regulator FP and Sym
2024-10-08 Pyro with i2c and isolation
    [MIDAS-MK2-Pyro.kicad_sch]
2024-10-09 added some logos
    [SPARK-MK1.kicad_pcb]
2024-10-10 added PCBWay and SPARK logos
    [SPARK-MK1.kicad_pcb]
2024-10-10 axed reference designators
    [SPARK-MK1.kicad_pcb]
2024-10-10 fixed right angle trace
    [SPARK-MK1.kicad_pcb]
2024-10-11 added E-Hardware logo/names
    [SPARK-MK1.kicad_pcb, SPARK-MK1.kicad_sch]
2024-10-11 refilled zones
    [SPARK-MK1.kicad_pcb]
2024-10-11 small PCBWay logo library addition
2024-10-13 fixed missing solder mask on efuse symbol
    [SPARK-MK1.kicad_pcb]
2024-10-13 cleaned up
    [MIDAS-MK2-Pyro.kicad_sch]
2024-10-14 Added TPS61288 Symbol and Footprint
2024-10-14 Pyro updated EXPINT0 labels
    [MIDAS-MK2-Pyro.kicad_sch]
2024-10-14 TVS_Diode> Transceiver CAN(L)CAN(H)
    [MIDAS-MK2.kicad_sch]
2024-10-14 Names and other little changes
    [MIDAS-MK2-Pyro.kicad_sch]
2024-10-15 Making things look prettier
    [MIDAS-MK2.kicad_sch]
2024-10-15 Added 12V Regulator
    [CAM-MK2.kicad_sch]
2024-10-15 Added TVS Diodes to Power
    [MIDAS-MK2-Power.kicad_sch, MIDAS-MK2.kicad_sch]
2024-10-19 Updated 12V Regulator and Regulator Footprints
    [CAM-MK2.kicad_sch]
2024-10-19 added 3v3 regulator and video mux
    [CAM-MK2.kicad_sch]
2024-10-19 Minor Modifications
    [CAM-MK2.kicad_sch]
2024-10-21 Fixing formatting for TVS Diodes in Schematic (making it more pretty)
    [MIDAS-MK2-Power.kicad_sch]
2024-10-21 Adding Decoupling Capacitors
    [MIDAS-MK2.kicad_sch]
2024-10-21 Fixing On branch Midas-core Your branch is up to date with 'origin/Midas-core'.
    Changes to be committed:
    (use "git restore --staged <file>..." to unstage)
    deleted: boards/MIDAS-MK2/MIDAS-MK2-backups/MIDAS-MK2-2024-09-30_192628.zip
    deleted: boards/MIDAS-MK2/MIDAS-MK2-backups/MIDAS-MK2-2024-09-30_193222.zip
    deleted: boards/MIDAS-MK2/MIDAS-MK2-backups/MIDAS-MK2-2024-10-05_141635.zip
    deleted: boards/MIDAS-MK2/MIDAS-MK2-backups/MIDAS-MK2-2024-10-05_142431.zip
2024-10-21 Moving other memory around
    [MIDAS-MK2.kicad_sch]
2024-10-21 Added power isolation
2024-10-22 Added I2C ADC chip to symbol library
2024-10-22 starting motor boards
    [Motor-MK1.kicad_sch]
2024-10-22 Added current monitoring and small fixes
    [CAM-MK2.kicad_sch]
2024-10-22 October 21st Meeting - Switching out Memory (Still need new TVS Diodes)
    [MIDAS-MK2.kicad_sch]
2024-10-22 Cleaning old memories
    [MIDAS-MK2.kicad_sch]
2024-10-23 revised power monitor libraries
    [CAM-MK2.kicad_sch]
2024-10-23 small power monitor libary revisions
    [CAM-MK2.kicad_sch]
2024-10-23 added power meter libraries
2024-10-25 Updated Power MUX and Debug
    [CAM-MK2.kicad_sch]
2024-10-26 replaced mux libraries with kicad ones
    [CAM-MK2.kicad_sch]
2024-10-26 regulator symbol changes
    [CAM-MK2.kicad_sch]
2024-10-26 regulator footprint library changes, couldn't find 3d models
    [CAM-MK2.kicad_sch]
2024-10-26 ADC library KLC changes
2024-10-26 added ADC library
2024-10-26 Updated MCU Boot and Reset
    [CAM-MK2.kicad_sch]
2024-10-26 Added ADC Expander to Pyro Schematic
    [MIDAS-MK2-Pyro.kicad_sch]
2024-10-26 Battery Voltage Monitoring chip
    [MIDAS-MK2-Sensors.kicad_sch]
2024-10-26 Changing TVS
    [MIDAS-MK2.kicad_sch]
2024-10-27 Added pull up resistors to isolated I2C
    [MIDAS-MK2-Pyro.kicad_sch]
2024-10-28 Added JST Footprints
    [CAM-MK2.kicad_sch]
2024-10-28 Final pyro build
    [MIDAS-MK2-Pyro.kicad_sch, MIDAS-MK2-Sensors.kicad_sch]
2024-10-28 Removing eMMC Capacitors and ADC Expander (will be merged with MIDAS-Sense/Pyro)
    [MIDAS-MK2.kicad_sch]
2024-10-29 Started Routing
    [CAM-MK2.kicad_pcb, CAM-MK2.kicad_sch]
2024-10-31 Added to Rough Routing Outline
    [CAM-MK2.kicad_pcb, CAM-MK2.kicad_sch]
2024-10-31 final schematic changes
    [CAM-MK2.kicad_sch]
2024-10-31 library changes
    [CAM-MK2.kicad_sch]
2024-10-31 pcb setup, routed USB
    [CAM-MK2.kicad_pcb, CAM-MK2.kicad_sch]
2024-10-31 finished preparing schematic + added 3d models
    [CAM-MK2.kicad_pcb]
2024-11-02 additions to motor board
    [Motor-MK1.kicad_sch]
2024-11-02 removed RDX0007A pad vias
    [CAM-MK2.kicad_pcb]
2024-11-02 CAN routing done
    [CAM-MK2.kicad_pcb]
2024-11-02 routed power mux and battery sense
    [CAM-MK2.kicad_pcb]
2024-11-02 Connected DRDY to GPIO Expander 0, Added ferrite beads to powerisolation, Added capacitors to power isolation chip
    [MIDAS-MK2-Pyro.kicad_sch]
2024-11-04 initial pyro reformatting
    [MIDAS-MK2-Pyro.kicad_sch]
2024-11-04 changed to ISO1640
    [MIDAS-MK2-Pyro.kicad_sch]
2024-11-04 final pyro cleanup, fixed hidden power pin on TCAL
    [MIDAS-MK2-Pyro.kicad_sch]
2024-11-04 removed changes on sensors sch
    [MIDAS-MK2-Sensors.kicad_sch]
2024-11-04 minor cleanup
    [MIDAS-MK2-Sensors.kicad_sch]
2024-11-04 removing conflicts
    [MIDAS-MK2-Pyro.kicad_sch]
2024-11-04 removed changes on files outside of branch scope
    [MIDAS-MK2-RF.kicad_sch, MIDAS-MK2-Sensors.kicad_sch]
2024-11-04 general changes, reorganization, etc.
    [MIDAS-MK2-Power.kicad_sch, MIDAS-MK2-Pyro.kicad_sch, MIDAS-MK2-Sensors.kicad_sch, MIDAS-MK2.kicad_sch]
2024-11-04 B2B connector, reorganizing
    [MIDAS-MK2.kicad_sch]
2024-11-04 fixed resistor footprints
    [MIDAS-MK2-Power.kicad_sch, MIDAS-MK2-Pyro.kicad_sch]
2024-11-04 fixed resistor footprints pt 2
    [MIDAS-MK2-Pyro.kicad_sch, MIDAS-MK2-Sensors.kicad_sch, MIDAS-MK2.kicad_sch]
2024-11-04 potentiometer KLC change
    [SPARK-MK1.kicad_sch]
2024-11-04 Ebyte schematic
    [MIDAS-MK2-RF.kicad_sch, MIDAS-MK2.kicad_sch]
2024-11-04 GNSS antenna supervisor libraries
2024-11-04 GNSS schematic
    [MIDAS-MK2-RF.kicad_sch]
2024-11-04 schematics done
    [MIDAS-MK2-Power.kicad_sch, MIDAS-MK2-RF.kicad_sch, MIDAS-MK2-Sensors.kicad_sch, MIDAS-MK2.kicad_sch]
2024-11-04 board setup and minor fixes
    [MIDAS-MK2-Power.kicad_sch, MIDAS-MK2-Pyro.kicad_sch, MIDAS-MK2-RF.kicad_sch, MIDAS-MK2-Sensors.kicad_sch, MIDAS-MK2.kicad_pcb, MIDAS-MK2.kicad_sch]
2024-11-04 Began routing the power regulators
    [CAM-MK2.kicad_pcb]
2024-11-05 small formatting changes
    [MIDAS-MK2-Power.kicad_sch, MIDAS-MK2-Pyro.kicad_sch, MIDAS-MK2.kicad_sch]
2024-11-05 pre-routing schematic formatting
    [MIDAS-MK2-RF.kicad_sch, MIDAS-MK2.kicad_sch]
2024-11-05 initial placements, routed USB
    [MIDAS-MK2.kicad_pcb, MIDAS-MK2.kicad_sch]
2024-11-05 fixed USB on MCU
    [MIDAS-MK2.kicad_sch]
2024-11-05 added testpoints, minor formatting
    [MIDAS-MK2-Power.kicad_sch, MIDAS-MK2-Pyro.kicad_sch, MIDAS-MK2.kicad_sch]
2024-11-05 made pyro gnd/pwr zones, some small stuff
    [MIDAS-MK2.kicad_pcb]
2024-11-05 removed gps test pad
    [MIDAS-MK2.kicad_sch]
2024-11-09 preliminary component placements this may be tricky!
    [MIDAS-MK2-Power.kicad_sch, MIDAS-MK2-RF.kicad_sch, MIDAS-MK2.kicad_pcb, MIDAS-MK2.kicad_sch]
2024-11-10 fixed MCU Boot, moved pins around
    [MIDAS-MK2.kicad_sch]
2024-11-10 I love impedance! (moved RF to front
    [MIDAS-MK2.kicad_pcb]
2024-11-10 updated sch from Thomas' routing - fixed Boot pin + footprints
    [MIDAS-MK2-Power.kicad_sch, MIDAS-MK2-RF.kicad_sch, MIDAS-MK2.kicad_sch]
2024-11-10 added flash decoupling capacitor
    [MIDAS-MK2.kicad_pcb, MIDAS-MK2.kicad_sch]
2024-11-10 pyro component placements, added decoups, term block silk fix
    [MIDAS-MK2-Pyro.kicad_sch, MIDAS-MK2.kicad_pcb, MIDAS-MK2.kicad_sch]
2024-11-11 moved SD CLK on MCU
    [MIDAS-MK2.kicad_pcb, MIDAS-MK2.kicad_sch]
2024-11-12 Shrunk Board to 50mm by 40mm
    [CAM-MK2.kicad_pcb, CAM-MK2.kicad_sch]
2024-11-12 made prgress on power schematic, left off on power mux
    [Motor-MK1.kicad_sch, power.kicad_sch]
2024-11-12 Finished power routing and started routing MCU
    [CAM-MK2.kicad_pcb, CAM-MK2.kicad_sch]
2024-11-16 Finished Rough MCU Routing
    [CAM-MK2.kicad_pcb, CAM-MK2.kicad_sch]
2024-11-16 Updated power routing
    [CAM-MK2.kicad_pcb]
2024-11-16 More changes (forgot to save before pushing)
    [CAM-MK2.kicad_pcb]
2024-11-17 added CAN jumpers
    [MIDAS-MK2.kicad_pcb, MIDAS-MK2.kicad_sch]
2024-11-17 added some pyro current consumption notes
    [MIDAS-MK2-Pyro.kicad_sch]
2024-11-19 added pwm controller
    [Motor-MK1.kicad_sch, power.kicad_sch]
2024-11-19 Updated Camera MOSFETs
    [CAM-MK2.kicad_sch]
2024-11-19 resistor and cap values for 5-3.3
    [Motor-MK1.kicad_sch, power.kicad_sch]
2024-11-21 added micro-lock plus libraries, updated sch
    [CAM-MK2.kicad_sch]
2024-11-21 added CAN jumpers, etc.
    [CAM-MK2.kicad_sch]
2024-11-21 changed inductor for 12V regulator
    [CAM-MK2.kicad_sch]
2024-11-21 reconfigured pyro placements - all on back now
    [MIDAS-MK2-Pyro.kicad_sch, MIDAS-MK2.kicad_pcb]
2024-11-21 added some pyro zones, SN text
    [MIDAS-MK2-Pyro.kicad_sch, MIDAS-MK2.kicad_pcb]
2024-11-22 lots of pyro routing! :)
    [MIDAS-MK2.kicad_pcb]
2024-11-22 pyro routing largely finished (pending verdict on split gnds)
    [MIDAS-MK2.kicad_pcb]
2024-11-22 power mux and friends
    [MIDAS-MK2.kicad_pcb]
2024-11-23 regulator, bottom half of the board largely finished
    [MIDAS-MK2.kicad_pcb]
2024-11-24 routed SPI, then unrouted it, then switched around layers (so it will be on the back). the more I do this the more I realize that MK1 was really good
    [MIDAS-MK2.kicad_pcb]
2024-11-25 changed battery connector to microlock
    [CAM-MK2.kicad_sch]
2024-11-25 changed to microlock b2b conn
    [MIDAS-MK2.kicad_pcb, MIDAS-MK2.kicad_sch]
2024-11-25 shit gets real soon (revamped mcu/expander assignments)
    [MIDAS-MK2.kicad_pcb, MIDAS-MK2.kicad_sch]
2024-11-26 THE BIG COMMIT 😎
    [MIDAS-MK2.kicad_pcb, MIDAS-MK2.kicad_sch]
2024-11-26 routed rf
    [MIDAS-MK2.kicad_pcb]
2024-11-27 Added 12V Enable and Modified 12V Capacitor Footprints
    [CAM-MK2.kicad_sch]
2024-11-27 connected remaining items, fixed all DRC errors
    [MIDAS-MK2.kicad_pcb]
2024-11-27 added silkscreen labels
    [MIDAS-MK2.kicad_pcb]
2024-11-27 changed usb impedance stuff, cleaning up, pcbway labels
    [MIDAS-MK2.kicad_pcb]
2024-11-27 Changed Board to 40x40mm
    Still need to route CAN_FAULT, CAN SPI_MOSI, add nets for power signals where applicable, and connect 3V3.
    [CAM-MK2.kicad_pcb, CAM-MK2.kicad_sch]
2024-11-28 3d models, tiny changes
    [MIDAS-MK2.kicad_pcb]
2024-11-29 CAN crystal 3d model
    [MIDAS-MK2.kicad_pcb]
2024-11-29 switched to black terminal blocks, set dates issued
    [MIDAS-MK2-Power.kicad_sch, MIDAS-MK2-Pyro.kicad_sch, MIDAS-MK2-RF.kicad_sch, MIDAS-MK2-Sensors.kicad_sch, MIDAS-MK2.kicad_pcb, MIDAS-MK2.kicad_sch]
2024-11-29 fixed datasheets, better metadata for BOM
    [MIDAS-MK2-RF.kicad_sch, MIDAS-MK2.kicad_sch]
2024-11-29 normalized 100nF to 0.1uF
    [MIDAS-MK2-Sensors.kicad_sch]
2024-11-30 Routing Work
    [CAM-MK2.kicad_pcb, CAM-MK2.kicad_sch]
2024-11-30 final routing nitpicks
    [MIDAS-MK2.kicad_pcb]
2024-11-30 Connected Floating VREG_IN Pad
    [CAM-MK2.kicad_pcb]
2024-11-30 More Routing Changes + Added Some Labels
    [CAM-MK2.kicad_pcb, CAM-MK2.kicad_sch]
2024-11-30 Added Some GND Vias
    [CAM-MK2.kicad_pcb]
2024-12-01 Regulator footprint fixes
2024-12-01 ground vias, zone cleanup, resolving DRC, QOL changes
    [CAM-MK2.kicad_pcb]
2024-12-01 near-final cleanups, labeling, spi debug pins, dates
    [CAM-MK2.kicad_pcb, CAM-MK2.kicad_sch]
2024-12-01 adjusted ISS logo
    [CAM-MK2.kicad_pcb]
2024-12-02 changed 33uF capacitor to 0805
    [CAM-MK2.kicad_pcb, CAM-MK2.kicad_sch]
2024-12-02 added PCBWay logo
    [CAM-MK2.kicad_pcb]
2024-12-03 zone changes
    [CAM-MK2.kicad_pcb]
2024-12-03 final commit
    [CAM-MK2.kicad_pcb]
2024-12-10 finished power mux
    [Motor-MK1.kicad_sch, power.kicad_sch]
2025-01-07 reorganized schematic boxes
    [CAM-MK2.kicad_sch]
2025-01-07 moved files to MK2-revA subfolder
    [CAM-MK2.kicad_pcb, CAM-MK2.kicad_sch]
2025-01-07 unnoticeable formatting
    [MIDAS-MK2-Power.kicad_sch]
2025-01-07 Minor Changes to CAM Mk2.1 RevA + Changed Video MUX
    [CAM-MK2.kicad_pcb, CAM-MK2.kicad_sch]
2025-01-07 created MK2.1 files
    [MIDAS-MK2.1-Power.kicad_sch, MIDAS-MK2.1-Pyro.kicad_sch, MIDAS-MK2.1-RF.kicad_sch, MIDAS-MK2.1-Sensors.kicad_sch, MIDAS-MK2.1.kicad_pcb, MIDAS-MK2.1.kicad_sch]
2025-01-07 CAM MK2.1 setup
    [CAM-MK2.1.kicad_pcb, CAM-MK2.1.kicad_sch]
2025-01-07 Added Quad High Side Switch
2025-01-07 Added Quad High Side Switch Pt.2
2025-01-07 Quad High Side Switch Part 3
    Still need to change current limiting resistor, add footprint, connect current sense/debug pins.
    [CAM-MK2.1.kicad_sch, CAM-MK2.kicad_pcb, CAM-MK2.kicad_sch]
2025-01-07 Finished Quad 12V High Side Switch
    [CAM-MK2.1.kicad_sch]
2025-01-07 changed pyro reverse polarity protection to diode
    [MIDAS-MK2.1-Pyro.kicad_sch]
2025-01-08 Video mux library changes
    [CAM-MK2.1.kicad_sch]
2025-01-08 regulator klc changes
    [CAM-MK2.1.kicad_sch, CAM-MK2.kicad_sch]
2025-01-08 power switch library changes and schematic formatting
    [CAM-MK2.1.kicad_sch]
2025-01-08 power switch footprint + 3d model stuff
    [CAM-MK2.1.kicad_sch]
2025-01-08 added missing footprints
    [CAM-MK2.1.kicad_sch]
2025-01-09 Fixed Schematic Linking
    [CAM-MK2.1.kicad_pcb, CAM-MK2.1.kicad_sch]
2025-01-09 CAM MK2.1 Routing
    [CAM-MK2.1.kicad_pcb, CAM-MK2.1.kicad_sch]
2025-01-10 Replaced high-side pyro switch
    [MIDAS-MK2.1-Pyro.kicad_sch]
2025-01-10 pyro formatting changes
    [MIDAS-MK2.1-Pyro.kicad_sch, MIDAS-MK2.1.kicad_sch]
2025-01-12 More CAM MK2.1 Routing
    [CAM-MK2.1.kicad_pcb, CAM-MK2.1.kicad_sch]
2025-01-12 changed labels
    [CAM-MK2.1.kicad_pcb, CAM-MK2.1.kicad_sch]
2025-01-12 Increased CAM/VTX Power Trace Widths and Reduced RST/Boot Traces on 3V3 Layer
    [CAM-MK2.1.kicad_pcb]
2025-01-13 fixed can spi
    [MIDAS-MK2.1.kicad_sch]
2025-01-13 updated pyro voltage dividers
    [MIDAS-MK2.1-Pyro.kicad_sch]
2025-01-13 switched from DMNH6022SSDQ to Si7232DN
    [MIDAS-MK2.1-Pyro.kicad_sch]
2025-01-14 started routing pyros + fixed CAN
    [MIDAS-MK2.1-Pyro.kicad_sch, MIDAS-MK2.1.kicad_pcb, MIDAS-MK2.1.kicad_sch]
2025-01-14 routing new MOSFETs for pyros
    [MIDAS-MK2.1.kicad_pcb]
2025-01-14 cleaned up pyro routing and changed dates/contributors
    [MIDAS-MK2.1-Power.kicad_sch, MIDAS-MK2.1-Pyro.kicad_sch, MIDAS-MK2.1-RF.kicad_sch, MIDAS-MK2.1-Sensors.kicad_sch, MIDAS-MK2.1.kicad_pcb, MIDAS-MK2.1.kicad_sch]
2025-01-15 Updated Video Trace Impedances to 75ohms
    [CAM-MK2.1.kicad_pcb]
2025-01-15 a few more pyro ground vias
    [MIDAS-MK2.1.kicad_pcb]
2025-01-15 small cleanup
    [CAM-MK2.1.kicad_pcb, CAM-MK2.1.kicad_sch]
2025-01-16 Updated USB Trace Impedance
    [CAM-MK2.1.kicad_pcb]
2025-01-16 moved 12V caps closer to regulator, other small changes
    [CAM-MK2.1.kicad_pcb, CAM-MK2.1.kicad_sch]
2025-01-16 updated dates
    [CAM-MK2.1.kicad_pcb, CAM-MK2.1.kicad_sch]
2025-01-16 added a few ground vias, specified 1U-N8 on schematic
    [MIDAS-MK2.1-Power.kicad_sch, MIDAS-MK2.1-Pyro.kicad_sch, MIDAS-MK2.1-RF.kicad_sch, MIDAS-MK2.1-Sensors.kicad_sch, MIDAS-MK2.1.kicad_pcb, MIDAS-MK2.1.kicad_sch]
2025-01-17 MK2.1 revB (RFM version) setup
    [MIDAS-MK2.1-Power.kicad_sch, MIDAS-MK2.1-Pyro.kicad_sch, MIDAS-MK2.1-RF.kicad_sch, MIDAS-MK2.1-Sensors.kicad_sch, MIDAS-MK2.1.kicad_pcb, MIDAS-MK2.1.kicad_sch]
2025-01-17 revB done
    [MIDAS-MK2.1-RF.kicad_sch, MIDAS-MK2.1.kicad_pcb, MIDAS-MK2.1.kicad_sch]
2025-01-17 more stiching vias
    [MIDAS-MK2.1.kicad_pcb]
2025-01-20 JLC impedance and silkscreen changes
    [MIDAS-MK2.1.kicad_pcb]
2025-01-20 revB JLC changes
    [MIDAS-MK2.1.kicad_pcb]
2025-01-20 CAM JLC changes
    [CAM-MK2.1.kicad_pcb]
2025-01-20 BAS416 excluded from BOM
    [CAM-MK2.1.kicad_sch]
2025-01-20 kicad library was misnamed L
    [MIDAS-MK2.1-Pyro.kicad_sch]
2025-01-25 first edits
    [drone_power.kicad_pcb, drone_power.kicad_sch]
2025-02-01 added new footprints and in PCB added new 5v and 12 groups
    [drone_power.kicad_sch]
2025-02-05 First draft
    [BOM-Feather1268.csv, E22.kicad_sch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]
2025-02-05 made some sch formatting / libs / routing changes
    [E22.kicad_sch, Feather1268.kicad_pcb, Feather1268.kicad_sch]
2025-02-05 done ish
    [Feather1268.kicad_pcb, Feather1268.kicad_sch]
2025-02-05 bigger board
    [BOM-Feather1268.csv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]
2025-02-08 added footprints
2025-02-08 actually doing it
    [drone_power.kicad_sch]
2025-02-08 even smallergit status!
    [drone_power.kicad_pcb, drone_power.kicad_sch]
2025-02-08 EVEN SMALLER git add drone_power_2_screws.kicad_*git add drone_power_2_screws.kicad_*
    [drone_power_2_screws.kicad_pcb, drone_power_2_screws.kicad_sch]
2025-02-11 leds added to 3 screw
    [drone_power_3_screws_LED.kicad_pcb]
2025-02-11 forgot schematic
    [drone_power_3_screws_LED.kicad_sch]
2025-02-12 added some text
    [drone_power.kicad_pcb, drone_power.kicad_sch]
2025-02-12 adding LEDs and clearing up labels
    [drone_power_2_screws.kicad_pcb, drone_power_2_screws.kicad_sch]
2025-02-12 resized LEDs and updates to text
    [drone_power_2_screws.kicad_pcb, drone_power_2_screws.kicad_sch]
2025-02-13 file organization changes, DRC, final gerber export
    [drone_power.kicad_pcb, drone_power.kicad_sch, drone_power_2_screws.kicad_pcb, drone_power_2_screws.kicad_sch, drone_power_3_screws.kicad_pcb, drone_power_3_screws.kicad_sch, drone_power_3_screws_LED.kicad_pcb, drone_power_3_screws_LED.kicad_sch]
2025-02-13 fixed oopsie
    [drone_power_2_screws.kicad_pcb]
2025-02-15 some final changes
    [Feather1268.kicad_pcb, Feather1268.kicad_sch]
2025-02-15 added motor controller
    [Motor-MK1.kicad_sch]
2025-02-15 renamed to Feather_Duo
    [E22.kicad_sch, Feather_Duo.kicad_pcb, Feather_Duo.kicad_sch]
2025-02-28 restore mk2
    [MIDAS-MK2-Power.kicad_sch, MIDAS-MK2-Pyro.kicad_sch, MIDAS-MK2-RF.kicad_sch, MIDAS-MK2-Sensors.kicad_sch, MIDAS-MK2.1-Power.kicad_sch, MIDAS-MK2.1-Pyro.kicad_sch, MIDAS-MK2.1-RF.kicad_sch, MIDAS-MK2.1-Sensors.kicad_sch]
2025-03-01 Added Second Stepper Driver, Specified TMC 2660C as Stepper Driver variant used, Connected all pins for Stepper Drivers
    [Motor-MK1.kicad_sch, power.kicad_sch]
2025-03-08 update schematic
    [Motor-MK1.kicad_sch]
2025-03-08 update schematic for real this time
2025-03-08 for real real this time
    [power.kicad_sch]
2025-03-08 very important button added
    [Motor-MK1.kicad_sch]
2025-03-08 oopsy fixed
    [Motor-MK1.kicad_sch]
2025-03-08 fixing more oops
    [Motor-MK1.kicad_sch]
2025-03-08 Laid Out Driver one for Motor control
    [Motor-MK1.kicad_pcb]
2025-03-08 super pretty version
    [Motor-MK1.kicad_sch]
2025-03-28 fix merge conflict for Motor-MK1
    [Motor-MK1.kicad_pcb]
2025-03-29 added second motor driver, started power layout, investigate the buck regulator
    [Motor-MK1.kicad_pcb, Motor-MK1.kicad_sch, power.kicad_sch]
2025-04-05 Added power supply, finished schematics for buttons, need traces
    [Motor-MK1.kicad_pcb, Motor-MK1.kicad_sch, power.kicad_sch]
2025-04-12 Started routing for PCB, need to finish motor routing and power
    [Motor-MK1.kicad_pcb]
2025-04-12 starting new borzoi board (V2)
    [drone_power_2_screws_V2.kicad_pcb, drone_power_2_screws_V2.kicad_sch]
2025-04-12 adding part info folder
    [WBBOMDesignTPS56637RPAR.csv, WBBOMDesignTPS56837HRPAR.csv]
2025-04-12 fixed right angle
    [Motor-MK1.kicad_pcb]
2025-04-19 oops missed wire
    [drone_power_2_screws_V2.kicad_sch]
2025-04-19 Updated linear regulator schematic, need to fix routing on PCB
    [power.kicad_sch]
2025-04-19 borzoi v2!
    [drone_power_2_screws_V2.kicad_pcb, drone_power_2_screws_V2.kicad_sch]
2025-04-19 deleting outdated parts list
    [WBBOMDesignLM62460RPHR.csv, WBBOMDesignTPS56837HRPAR.csv]
2025-04-19 Routed new voltage regulator, rearranged BOOT_SW, routed LEDs, routed GPIO pins, added VIAs for GND pads, fixed ESP32 3V3 being connected to GND
    [Motor-MK1.kicad_pcb, Motor-MK1.kicad_sch, power.kicad_sch]
2025-04-22 ordering soon
    [drone_power_2_screws_V2.kicad_pcb, drone_power_2_screws_V2.kicad_sch]
2025-04-22 some more gnd vias
    [drone_power_2_screws_V2.kicad_pcb]
2025-04-22 some changes 😁
    [Motor-MK1.kicad_pcb, Motor-MK1.kicad_sch, power.kicad_sch]
2025-04-22 final changes
    [Motor-MK1.kicad_pcb, Motor-MK1.kicad_sch, power.kicad_sch]
2025-04-24 button fix and 3d models
    [Motor-MK1.kicad_pcb, Motor-MK1.kicad_sch]
2025-04-25 library changes + 3d models
    [drone_power_2_screws_V2.kicad_pcb, drone_power_2_screws_V2.kicad_sch]
2025-05-04 adding new borzoi board casing designs
    [BorzoiBoardCasing-BottomCasing.stl, BorzoiBoardCasing-TopCasing.stl, BorzoiBoardCasing.FCStd]
2025-06-27 cleaned up sch formatting
    [Motor-MK1.kicad_sch]
2025-07-04 changed a date
    [MIDAS-MK2.1.kicad_pcb]
2025-07-04 readded MIDAS MK2
    [MIDAS-MK2-Power.kicad_sch, MIDAS-MK2-Pyro.kicad_sch, MIDAS-MK2-RF.kicad_sch, MIDAS-MK2-Sensors.kicad_sch, MIDAS-MK2.kicad_pcb, MIDAS-MK2.kicad_sch]
2025-07-04 library + metadata changes
    [E22.kicad_sch, Feather_Duo.kicad_pcb, Feather_Duo.kicad_sch]
2025-08-07 changed Feather Duo SMA label/datasheet from adafruit to molex
    [E22.kicad_sch]
2025-08-13 switched microlock 3d models for new black ones
    [CAM-MK2.1.kicad_pcb]
2025-08-14 added measurements to feather duo layout
    [Feather_Duo.kicad_pcb]
2025-08-16 Deleting incorrect 12V converter svg
2025-08-16 Correcting LM62460RPHR circuit svg diagram
2025-09-06 fixed motorboard readme image embed
2025-09-06 removed old motorboard power schematic
    [power.kicad_sch]
2025-09-06 fixed board readme wording
2025-09-18 created Mini project files
    [Mini-MK1-Power.kicad_sch, Mini-MK1-Pyro.kicad_sch, Mini-MK1-Sensors.kicad_sch, Mini-MK1.kicad_pcb, Mini-MK1.kicad_sch]
2025-09-18 Deleted old hierarchical labels
    [Mini-MK1.kicad_sch]
2025-09-19 Created CAM MK3 project
    [CAM-MK3.kicad_pcb, CAM-MK3.kicad_sch]
2025-09-20 Created Switch_Board project files
    [Switch_Board.kicad_pcb, Switch_Board.kicad_sch]
2025-09-20 adding footprints
    [Switch_Board.kicad_sch]
2025-09-26 Copy pasted MCU, GPIO, USB from MidasMK2
    [Mini-MK1.kicad_sch]
2025-09-26 Added diagram for Barometer
    [Mini-MK1-Sensors.kicad_sch]
2025-09-26 getting rid of stuff
    [Mini-MK1.kicad_sch]
2025-09-26 added LSM6DSV320X
    [Mini-MK1-Sensors.kicad_sch]
2025-09-27 adding usb and power to mcu
    [Mini-MK1.kicad_sch]
2025-09-27 adding I2C to MCU & GPIO Expander 1
    [Mini-MK1.kicad_sch]
2025-09-27 moved changes from other mini-power
2025-09-27 first edits to schematic
    [Switch_Board.kicad_sch]
2025-09-27 added stm32 microcontroller schematics
    [CAM-MK3.kicad_sch]
2025-09-27 Re-adding hierarchical sheets, configuring GPIO Expander, adding flash memory
    [Mini-MK1-Power.kicad_sch, Mini-MK1-Pyro.kicad_sch, Mini-MK1-Sensors.kicad_sch, Mini-MK1.kicad_sch]
2025-09-27 Added Under voltage Supervisor Symbol
    [Mini-MK1-Pyro.kicad_sch]
2025-09-27 Finished LDO, started battery charger IC
    [Mini-MK1-Power.kicad_sch]
2025-10-03 Fixing labels
    [Mini-MK1.kicad_sch]
2025-10-03 Adding footprints/symbol for BQ25185DLHR
2025-10-03 Adding footprint and symbol table for the BQ25185 IC
2025-10-04 Started the Battery Charger IC, need to add STAT pins, check if MOSFET is needed
    [Mini-MK1-Power.kicad_sch]
2025-10-04 I forgot to save before commiting, added battery and USB input, output, check if reset switch is needed
    [Mini-MK1-Power.kicad_sch]
2025-10-04 Added buzzer
    [MIDAS-MK2.1-Power.kicad_sch, MIDAS-MK2.1-Pyro.kicad_sch, MIDAS-MK2.1-RF.kicad_sch, MIDAS-MK2.1-Sensors.kicad_sch, MIDAS-MK2.1.kicad_sch, Mini-MK1.kicad_sch]
2025-10-04 Oct 3 2025 Updates - Wiring up ESP32-P4
    [CAM-MK3.kicad_sch]
2025-10-04 added flip flops, new isolators and attempted to make symbols look less terrible!
    [Switch_Board.kicad_sch]
2025-10-04 added footprints that disappeared
2025-10-04 Update MCU_STM32WB1MMCH6TR.kicad_sym
    Updated STM32 BLE Symbol (reduced size)
2025-10-04 Load switch symbol corrections
    [temp_project.kicad_pcb, temp_project.kicad_sch]
2025-10-04 moved load switch symbol
2025-10-04 fixed power switch symbol stuff
2025-10-04 Screw terminal stuff, but still needs work
    [Mini-MK1.kicad_sch]
2025-10-04 Smaller Expander for Pyro
    [Mini-MK1-Pyro.kicad_sch, Mini-MK1-Sensors.kicad_sch]
2025-10-04 Moved around screw terminal connections in schematic
    [Mini-MK1.kicad_sch]
2025-10-04 10/04/25 AV All Hands Work Session
    Added ESP32-P4 Symbol/Footprint, Finished Connecting Power to MCU, Added Flash Chip W25Q64JV Symbol/Footprint, Created circuit with Flash and connected to ESP32-P4
    [CAM-MK3.kicad_pcb, CAM-MK3.kicad_sch]
2025-10-04 finished battery charger IC, redid LDO
    [Mini-MK1-Power.kicad_sch]
2025-10-04 forgot to save last commit, finished battery charger IC, updated LDO to follow KiCAD schematic rules
    [Mini-MK1-Power.kicad_sch]
2025-10-10 updated 3 pin microlock footprint
    [MIDAS-MK2.1.kicad_pcb]
2025-10-10 merged main branch onto motor-schematics
2025-10-10 Added MCU Debug Pin to schematic, moved around core items on schematic
    [Mini-MK1.kicad_sch]
2025-10-11 Added schematic for GPIO expander
    [Mini-MK1-Pyro.kicad_sch]
2025-10-11 schematic updates WITH PAGES
    [IsolatedFlipFlop.kicad_sch, IsolatedFlipFlopsSwitch.kicad_sch, Switch_Board.kicad_sch]
2025-10-11 Adding power supervisor symbol
2025-10-11 added decoder schematics for KiCAD
    [CAM-MK3.kicad_sch]
2025-10-11 added gps
    [Mini-MK1.kicad_sch]
2025-10-11 Added new board
    [Cam-Receive-MK1.kicad_pcb, Cam-Receive-MK1.kicad_sch]
2025-10-11 added oscillator to decoder
    [CAM-MK3.kicad_sch]
2025-10-11 footprints added
    [IsolatedFlipFlopsSwitch.kicad_sch, Switch_Board.kicad_sch]
2025-10-11 Added LoRa, Debugging Pads, Mounting Holes, LEDs, MCU Boot Delay, Pull Up Resistors, Board-to-Board Connector, Bus Debug Pin, etc.
    [Mini-MK1.kicad_sch]
2025-10-11 starting pcb routing
    [Switch_Board.kicad_pcb]
2025-10-11 updated schematic and pcb
    [IsolatedFlipFlopsSwitch.kicad_sch, Switch_Board.kicad_sch]
2025-10-11 added oscillators for MCU and decoder
    [CAM-MK3.kicad_sch]
2025-10-11 CAM-RECEIVE-MK1 Setup
    MCU, Transciever, Clock
    [Cam-Receive-MK1.kicad_sch]
2025-10-12 Created new branch andrevision for Motor-Board-V2
    [Motor-MK2.kicad_pcb, Motor-MK2.kicad_sch]
2025-10-12 Reformat README.md
    [GATOR.kicad_pcb, GATOR.kicad_sch]
2025-10-12 Verified differences between M10Q and M8Q
    [GATOR.kicad_pcb, GATOR.kicad_sch]
2025-10-13 Added LoRa chip
    [GATOR.kicad_pcb, GATOR.kicad_sch]
2025-10-14 Nightly changes
    [GATOR.kicad_pcb]
2025-10-15 revamp board dimensions
    [GATOR.kicad_pcb, Motor-MK1.kicad_pcb]
2025-10-17 Reconnect Lora Chip wires
    [GATOR.kicad_pcb, GATOR.kicad_sch]
2025-10-17 Fixed folder structure and file name
    [CAM-Recieve-MK1.kicad_pcb, CAM-Recieve-MK1.kicad_sch]
2025-10-17 fixing labelling nonsense
    [Mini-MK1.kicad_sch]
2025-10-17 created reset_btn_circuit:
    [reset_btn_circuit.kicad_sch]
2025-10-17 Debug LED and User Button
    [DebugLED.kicad_sch, UserButton.kicad_sch]
2025-10-17 Changed capacitance value
    [UserButton.kicad_sch]
2025-10-18 Pull-Up Resistor Change
    [Mini-MK1.kicad_sch]
2025-10-18 Progress so far, cleaned up wires and stuff
    [CAM-MK3.kicad_sch]
2025-10-18 Added borders to components, added ADC IC, maybe charge battary charger ic to power mux?
    [Mini-MK1-Power.kicad_sch]
2025-10-18 Added MAX symbol, Copied Pyro channels, Added labels and current limit switch
    [Mini-MK1-Pyro.kicad_sch]
2025-10-18 updating schematic
    [IsolatedFlipFlops.kicad_sch, IsolatedFlipFlopsSwitch.kicad_sch, Switch_Board.kicad_sch]
2025-10-18 updating schematic with extra VDD capactiors
    [Switch_Board.kicad_sch]
2025-10-18 small change
    [Switch_Board.kicad_sch]
2025-10-18 deleted sneaky onboarding project
    [temp_project.kicad_pcb, temp_project.kicad_sch]
2025-10-18 status LEDs for switch
    [IsolatedFlipFlopsSwitch.kicad_sch]
2025-10-18 Added LEDs to GPIO Expander, Modified Debug pins and added debug pins for LSM6DSV320X, Labeled Hierarchical boxes
    [Mini-MK1.kicad_sch]
2025-10-18 Added Undervoltage Supervisor, fix bugs
    [Mini-MK1-Pyro.kicad_sch, Mini-MK1-Sensors.kicad_sch]
2025-10-18 Fixed SAM-M10Q symbol name and datasheet
    [Mini-MK1.kicad_sch]
2025-10-18 Changed to UV_Reset
    [Mini-MK1-Pyro.kicad_sch]
2025-10-18 10/18/25 Board Update
    - Change in transceiver board schematic
    - New schematic & beginning of Si4464 footprint design.
    [CAM-Recieve-MK1.kicad_sch]
2025-10-18 added amp symbol
    [CAM-Recieve-MK1.kicad_sch]
2025-10-18 adding status LEDs, JST connectors, proper filter caps, and proof of concept for routing slice
    [IsolatedFlipFlopsSwitch.kicad_sch, Switch_Board.kicad_pcb, Switch_Board.kicad_sch]
2025-10-25 Amplifier Circuit + Buck Converter Work
    Amplifier circuit schematic is done, added a TSP82085SIL schematic and started the circuit for it. It is not done!
    [CAM-Recieve-MK1.kicad_sch]
2025-10-28 Finished 3v3 Buck Converter Circuit, and polished board
    Finished 3v3 Buck converter circuit using TI's website to specific current, voltage, and power usages. Deleted unnecessary electrical components that were copied from CAM Mk2, fixed data sheets, and descriptions for most recent components (Transceiver, Amplifier, and 3v3 Buck Converter) + some styling
    [CAM-Recieve-MK1.kicad_sch]
2025-10-31 minor change to a label
    [Switch_Board.kicad_sch]
2025-10-31 Updated CAM Receiver Schematic
    - Added NEW 3v3, and 5 volt regulator circuits
    - Added four new footprints/symbols
    - Transceiver Module, Amplifier, 3v3 regulator, 5v regulator
    - Added two 3D models for voltage regulators
    [CAM-Recieve-MK1.kicad_sch]
2025-10-31 Fixed footprint paths
2025-10-31 Schematic Clean Up.
    [CAM-Recieve-MK1.kicad_sch]
2025-10-31 Footprint Library Removed
2025-10-31 Created ESP-32 Waveshare Symbol
    [CAM-MK3.kicad_sch]
2025-11-01 Replaced battery charger with Power MUX, Added ADC, Added voltage sensing voltage dividing resistors
    [Mini-MK1-Power.kicad_sch]
2025-11-01 Change some of the outputs and inputs, replace pyro ground, check 12c address
    Undervoltage supervisor needs to be cut but I didn't have the heart to do it. Changed baro spi's to the correct ones. Enable of the MAX is from pyro global enable.
    [Mini-MK1-Pyro.kicad_sch, Mini-MK1-Sensors.kicad_sch]
2025-11-01 created footprint for waveshare module and linked with symbol
2025-11-01 regulator added for flip flops and isolator, also reverse polarity protection added for everything
    [IsolatedFlipFlopsSwitch.kicad_sch]
2025-11-01 gnd consistency
    [Mini-MK1.kicad_sch]
2025-11-01 shrinking mounting holes
    [Mini-MK1.kicad_sch]
2025-11-01 small change to mounting holes
    [Mini-MK1.kicad_sch]
2025-11-01 Renaming a thing
    [IsolatedFlipFlopsSwitch.kicad_sch, Switch_Board.kicad_sch]
2025-11-01 Added Supercap and took out excess resistor
2025-11-01 Added Supercap (correct) one and changed some pins to be connected to ground
    [Mini-MK1-Power.kicad_sch, Mini-MK1-Pyro.kicad_sch, Mini-MK1-Sensors.kicad_sch, Mini-MK1.kicad_sch]
2025-11-01 power mux diode and resistor values
    [Mini-MK1-Power.kicad_sch]
2025-11-01 ESP32-P4 Module Work
    - Attached components to ESP32-P4 Module
    - Rearranged the Schematic and removed unnecessary components outside of box and necessary components inside.
    [CAM-Recieve-MK1.kicad_sch]
2025-11-01 Edited MAX board and pin names, added contributors' names, deleted undervoltage supervisor
    [Mini-MK1-Pyro.kicad_sch, Mini-MK1-Sensors.kicad_sch]
2025-11-01 added caps to regulator and UART pins
    [IsolatedFlipFlopsSwitch.kicad_sch, Switch_Board.kicad_sch]
2025-11-01 Finished Schematic
    - Attached Debug/Reset Pins to ESP32 P-4
    - Added Amplifier Jumper in case of amplifier not in use.
    - Connected transceiver Chip Select to ESP32
    - New Footprint for ESP32 P-4 (Under Review for correct measurements)
    - Board ready to be routed!
    - Rearranged Sheet
    [CAM-Recieve-MK1.kicad_sch]
2025-11-02 Amplifier Jumper Fix
    [CAM-Recieve-MK1.kicad_sch]
2025-11-03 New footprint imported into project libraries for the ESP32 P-4 Module
2025-11-04 added buzzer and modified components
    [GATOR.kicad_pcb, GATOR.kicad_sch]
2025-11-04 added more components for GPS
    [GATOR.kicad_pcb, GATOR.kicad_sch]
2025-11-04 placed all new components
    [GATOR.kicad_pcb, GATOR.kicad_sch]
2025-11-04 repositioned buzzer and silkscreens
    [GATOR.kicad_pcb, GATOR.kicad_sch]
2025-11-04 Wiring progress so far
    [GATOR.kicad_pcb, GATOR.kicad_sch]
2025-11-04 Footprint Swap for the ESP32-P4
    [CAM-Recieve-MK1.kicad_sch]
2025-11-04 wired lora transciever and trying gnd via spam
    [GATOR.kicad_pcb, GATOR.kicad_sch]
2025-11-04 finished wiring everything - monstrous rn - edit later
    [GATOR.kicad_pcb, GATOR.kicad_sch]
2025-11-04 via spam
    [GATOR.kicad_pcb]
2025-11-04 final touches for tn'
    [GATOR.kicad_pcb]
2025-11-04 Transceiver Import and some organization!
    [CAM-MK3.kicad_sch]
2025-11-04 Clean Up.
    [CAM-Recieve-MK1.kicad_sch]
2025-11-04 Clean up
    [CAM-Recieve-MK1.kicad_sch]
2025-11-05 created SPARK revB schematic with fixed UVLO and PG thresholds
    [SPARK-MK1-revA.kicad_sch, SPARK-MK1.kicad_sch]
2025-11-05 DRC fixes and grounding in attempt to fix jittering issue
    [GATOR.kicad_sch]
2025-11-05 Footprint + Symbol Fixes, PCB Design Start!
    - Imported necessary project footprint libraries for electronic components.
    - Assigned footprints for all components.
    - Fixed Symbol RF4463
    - Began pcb design of Receiver board!!
    [CAM-Recieve-MK1.kicad_pcb, CAM-Recieve-MK1.kicad_sch]
2025-11-06 Added no connects and work on PCB
    [CAM-Recieve-MK1.kicad_pcb, CAM-Recieve-MK1.kicad_sch]
2025-11-06 Added Supercap values
    [Mini-MK1-Power.kicad_sch]
2025-11-07 updated high side switch
    [Mini-MK1-Pyro.kicad_sch]
2025-11-07 Added LEDs to expander
    [Mini-MK1.kicad_sch]
2025-11-07 Moving ADC to root page
    [Mini-MK1-Power.kicad_sch]
2025-11-07 expander adjustments, finished pyros
    [Mini-MK1-Pyro.kicad_sch]
2025-11-07 cleaned up sensors
    [Mini-MK1-Sensors.kicad_sch]
2025-11-07 Added ADC
    [Mini-MK1.kicad_sch]
2025-11-07 Boxes and stuff
    [Mini-MK1.kicad_sch]
2025-11-07 Annotated Schematic
    [Mini-MK1.kicad_sch]
2025-11-07 Updated USBC
    [Mini-MK1.kicad_sch]
2025-11-07 cleaned up power schematic
    [Mini-MK1-Power.kicad_sch]
2025-11-07 changed schematic titles
    [Mini-MK1-Pyro.kicad_sch, Mini-MK1-Sensors.kicad_sch]
2025-11-07 MIDAS-MK2 fixed
    [MIDAS-MK2.1-Power.kicad_sch, MIDAS-MK2.1-Pyro.kicad_sch, MIDAS-MK2.1-RF.kicad_sch, MIDAS-MK2.1-Sensors.kicad_sch, MIDAS-MK2.1.kicad_pcb, MIDAS-MK2.1.kicad_sch]
2025-11-07 Revert "MIDAS-MK2 fixed"
    This reverts commit db12da7456d1bba7d2f31e1516f5bfdcfb90b1c0.
    [MIDAS-MK2.1-Power.kicad_sch, MIDAS-MK2.1-Pyro.kicad_sch, MIDAS-MK2.1-RF.kicad_sch, MIDAS-MK2.1-Sensors.kicad_sch, MIDAS-MK2.1.kicad_pcb, MIDAS-MK2.1.kicad_sch]
2025-11-07 MIDAS-MK2 fixed fr
    [MIDAS-MK2.1-Power.kicad_sch, MIDAS-MK2.1-Pyro.kicad_sch, MIDAS-MK2.1-RF.kicad_sch, MIDAS-MK2.1-Sensors.kicad_sch, MIDAS-MK2.1.kicad_sch]
2025-11-07 Added ISS as company
    [Mini-MK1-Pyro.kicad_sch]
2025-11-07 cleaned up root schematic and updated terminal blocks
    [Mini-MK1.kicad_sch]
2025-11-07 Added hierarchical labels
    [Mini-MK1-Power.kicad_sch, Mini-MK1-Pyro.kicad_sch, Mini-MK1-Sensors.kicad_sch, Mini-MK1.kicad_sch]
2025-11-07 PCB Work!!
    [CAM-Recieve-MK1.kicad_pcb, CAM-Recieve-MK1.kicad_sch]
2025-11-07 cleaning up schematics
    [Mini-MK1-Power.kicad_sch, Mini-MK1-Pyro.kicad_sch, Mini-MK1-Sensors.kicad_sch, Mini-MK1.kicad_sch]
2025-11-07 Put two pyro channels on each mosfet
    [Mini-MK1-Pyro.kicad_sch]
2025-11-07 Added EP to LDO symbol
    [Mini-MK1-Power.kicad_sch]
2025-11-07 SPI debug pin footprint changed to pin header
    [Mini-MK1.kicad_sch]
2025-11-07 Switched terminal blocks and annotated
    [Mini-MK1-Power.kicad_sch, Mini-MK1.kicad_sch]
2025-11-07 Updated buzzer footprint
2025-11-07 Added everything to pcb editor
    [Mini-MK1.kicad_pcb]
2025-11-07 added some 3d models
    [Mini-MK1.kicad_pcb]
2025-11-08 terminal blocks, updating footprints
    [Mini-MK1.kicad_pcb]
2025-11-08 Battery Monitor Fix + More PCB work.
    [CAM-Recieve-MK1.kicad_pcb, CAM-Recieve-MK1.kicad_sch]
2025-11-08 3v3 reg
    [CAM-MK3.kicad_sch]
2025-11-08 New 5V Regulator, new inductor footprints
    - Voltage Regulator has been switched to a buck boost regulator.
    - Inductors have datasheets linked to them as the Digikey website to buy them.
    [CAM-Recieve-MK1.kicad_pcb, CAM-Recieve-MK1.kicad_sch]
2025-11-09 PCB Work!
    [CAM-Recieve-MK1.kicad_pcb, CAM-Recieve-MK1.kicad_sch]
2025-11-09 Routing Progress!
    [CAM-Recieve-MK1.kicad_pcb, CAM-Recieve-MK1.kicad_sch]
2025-11-10 version sync
    [GATOR.kicad_sch]
2025-11-10 idk how cam board stuff got here
2025-11-10 added test points, need to test and rearrange, and delete J3
    [GATOR.kicad_sch]
2025-11-10 Remap Pads to make wiring life easier
    [GATOR.kicad_sch]
2025-11-11 wired everything... please work
    [GATOR.kicad_sch]
2025-11-11 DRC error fixes and added accelerometer
    [GATOR.kicad_sch, MIDAS-MK2.1-Power.kicad_sch, MIDAS-MK2.1-Pyro.kicad_sch, MIDAS-MK2.1-RF.kicad_sch, MIDAS-MK2.1-Sensors.kicad_sch, MIDAS-MK2.1.kicad_sch]
2025-11-11 not accelerometer IMU, also modified capacitor position
2025-11-11 Little Fixes from Thomas's Review
    [CAM-Recieve-MK1.kicad_pcb, CAM-Recieve-MK1.kicad_sch]
2025-11-12 adding decoupling capacitors and making adjustments to resistors
    [IsolatedFlipFlopsSwitch.kicad_sch, Switch_Board.kicad_sch]
2025-11-12 small value error
    [IsolatedFlipFlopsSwitch.kicad_sch]
2025-11-12 initial routing setup and front side component placements
    [Mini-MK1-Power.kicad_sch, Mini-MK1-Pyro.kicad_sch, Mini-MK1-Sensors.kicad_sch, Mini-MK1.kicad_pcb, Mini-MK1.kicad_sch]
2025-11-13 change cs_2 to more descriptive name for lora
    [GATOR.kicad_sch]
2025-11-13 Added qwiic connector
    [GATOR.kicad_sch]
2025-11-13 Schematic Additions/Fixes + Re-Routing
    Fixed Decoupling capacitors on voltage regulators
    Added values for capacitors on transceiver module
    Connected Transceiver GPIO’s
    Connected C6 reset pin (GPIO54 on waveshare module) Set to gnd if you want to reset.
    Disconnected PG from voltage regulators
    Added “Button Toggles” to schematic - Connected buttons for boot and reset pins
    - Routing Work
    [CAM-Recieve-MK1.kicad_pcb, CAM-Recieve-MK1.kicad_sch]
2025-11-14 Routing Work!
    [CAM-Recieve-MK1.kicad_pcb, CAM-Recieve-MK1.kicad_sch]
2025-11-14 something minor I forgot
    [Mini-MK1.kicad_pcb]
2025-11-14 Supercap annotations
    [Mini-MK1-Power.kicad_sch]
2025-11-14 added 5.5 voltage regulator
    [CAM-MK3.kicad_sch]
2025-11-15 Friday progress
    [CAM-MK3.kicad_sch]
2025-11-15 updated annotations on power mux / pyro global enable, fixed exp reset pullup
    [Mini-MK1-Power.kicad_sch, Mini-MK1-Pyro.kicad_sch]
2025-11-15 Schematic Fixes, and Lots of Routing Work
    - Preliminary Routing finished
    - Four board layer routing, zone filling finish.
    - Imported 3D models for electronic components
    - Changed 3v3 voltage regulator package type.
    - Changing some symbols, footprints, 3D model to conventions
    - Some DRC checking.
    [CAM-Recieve-MK1.kicad_pcb, CAM-Recieve-MK1.kicad_sch]
2025-11-15 redundancy changes
    [IsolatedFlipFlopsSwitch.kicad_sch, Switch_Board.kicad_sch]
2025-11-15 Library Conventions
    [CAM-Recieve-MK1.kicad_pcb, CAM-Recieve-MK1.kicad_sch]
2025-11-15 adding symbols for new isolator
    [IsolatedFlipFlopsSwitch.kicad_sch]
2025-11-15 small changes
    [IsolatedFlipFlopsSwitch.kicad_sch]
2025-11-15 CAM board schematic checkpoint AV all hands
    [CAM-MK3.kicad_sch, power.kicad_sch]
2025-11-15 DRC Passed!
    [CAM-Recieve-MK1.kicad_pcb, CAM-Recieve-MK1.kicad_sch]
2025-11-16 Added supercap voltage divider and rearranged boxes
    [Mini-MK1-Power.kicad_sch, Mini-MK1.kicad_sch]
2025-11-18 Little Touches
    - Footprints Graphics Uploaded.
    - Names Added
    - Fix with 3D Model
    [CAM-Recieve-MK1.kicad_pcb]
2025-11-19 New 3D Model for RF4463 and Silkscreen Additions
    - Named pins outs with silkscreen
    - New 3D Model.
    [CAM-Recieve-MK1.kicad_pcb, CAM-Recieve-MK1.kicad_sch]
2025-11-20 removed video toggle because video decoder already does that yay
    [CAM-MK3.kicad_sch]
2025-11-20 modified positioning of some symbols
    [power.kicad_sch]
2025-11-20 added schmitt trigger flip flop and finished add efuse
    [IsolatedFlipFlopsSwitch.kicad_sch, Switch_Board.kicad_sch]
2025-11-20 changed to 25x80mm configuration
    [Mini-MK1.kicad_pcb]
2025-11-20 new silkscreen
2025-11-20 Updated Power Mux Resistor Values
    [CAM-MK3.kicad_sch, power.kicad_sch]
2025-11-20 adding pulldowns, fixing footprint, fixing boot
    [IsolatedFlipFlopsSwitch.kicad_sch, Switch_Board.kicad_sch]
2025-11-21 Fixed problems+feedback
    [CAM-MK3.kicad_sch, power.kicad_sch]
2025-11-21 Other smaller todos
    [CAM-MK3.kicad_sch]
2025-11-21 PCB generate components
    [CAM-MK3.kicad_pcb]
2025-11-21 Added Magnetometer, Deleted BNO
    [Mini-MK1-Sensors.kicad_sch]
2025-11-21 Annotated Labels
    [Mini-MK1-Sensors.kicad_sch]
2025-11-21 Added TCA4307 symbol
    [Mini-MK1.kicad_sch]
2025-11-21 Added Capacitors to Magnetometer, added footprints to capacitors
    [Mini-MK1-Sensors.kicad_sch]
2025-11-21 Added decoupling cap and pullup res to TCA4307 and magnetometer labels
    [Mini-MK1-Sensors.kicad_sch, Mini-MK1.kicad_sch]
2025-11-21 fixing coin cell and pull downs
    [IsolatedFlipFlopsSwitch.kicad_sch, Switch_Board.kicad_sch]
2025-11-21 fixing broken feedback from flip flop
    [IsolatedFlipFlopsSwitch.kicad_sch, Switch_Board.kicad_sch]
2025-11-21 Updated Mounting Holes
    [Mini-MK1-Power.kicad_sch]
2025-11-21 Saved and Updated
    [Mini-MK1.kicad_sch]
2025-11-21 Capacitor footprints
    [Mini-MK1.kicad_sch]
2025-11-21 Lots of Cleanup (Footprints, GPIO Connections, Schematic Cleanup)
    [CAM-MK3.kicad_pcb, CAM-MK3.kicad_sch, power.kicad_sch]
2025-11-21 fixing PG
    [IsolatedFlipFlopsSwitch.kicad_sch]
2025-11-21 Updated symbol library and annotated schemactic
    [Mini-MK1.kicad_sch]
2025-11-21 Updated PCB
    - Added GND Vias
    - Updated footprints, and pad sizes
    - Fixed impedance paths
    - Footprint changes and fixes
    [CAM-Recieve-MK1.kicad_pcb, CAM-Recieve-MK1.kicad_sch]
2025-11-21 Small changes on mag
    [Mini-MK1-Sensors.kicad_sch]
2025-11-21 Revert "Updated Mounting Holes"
    This reverts commit a6c96b582f379b161e84d606416c78e70de85c7f.
    [Mini-MK1-Power.kicad_sch]
2025-11-21 More small changes
    [Mini-MK1.kicad_sch]
2025-11-21 minor tweaks, ready for routing
    [Mini-MK1-Power.kicad_sch, Mini-MK1-Sensors.kicad_sch, Mini-MK1.kicad_pcb, Mini-MK1.kicad_sch]
2025-11-21 Page Annotations, and more small things
    [IsolatedFlipFlopsSwitch.kicad_sch, Switch_Board.kicad_sch]
2025-11-21 Fixed flip flop footprint
2025-11-21 Added second expander, flash, fixed battery regulator
    [Switch_Board.kicad_sch]
2025-11-23 cleaning up libraries / formatting
    [IsolatedFlipFlopsSwitch.kicad_sch, Switch_Board.kicad_sch]
2025-11-23 deleted random files
    [DebugLED.kicad_sch, UserButton.kicad_sch, reset_btn_circuit.kicad_sch]
2025-11-23 board setup
    [IsolatedFlipFlop.kicad_sch, Switch_Board.kicad_pcb]
2025-11-23 removed unused file
    [IsolatedFlipFlops.kicad_sch]
2025-11-23 formatting tweaks
    [IsolatedFlipFlopsSwitch.kicad_sch, Switch_Board.kicad_sch]
2025-11-23 library cleanup and pcb setup
    [CAM-MK3.kicad_pcb, CAM-MK3.kicad_sch, power.kicad_sch]
2025-11-24 Fixed Transceiver Pin Outs
    [CAM-Recieve-MK1.kicad_sch]
2025-11-24 Started layout
    [CAM-MK3.kicad_pcb, CAM-MK3.kicad_sch, power.kicad_sch]
2025-11-24 Routing Fix
    [CAM-Recieve-MK1.kicad_pcb, CAM-Recieve-MK1.kicad_sch]
2025-11-24 routed most things to a basic level
    [Mini-MK1-Power.kicad_sch, Mini-MK1-Pyro.kicad_sch, Mini-MK1.kicad_pcb, Mini-MK1.kicad_sch]
2025-11-24 voltage regulator components placed
    [CAM-MK3.kicad_pcb, CAM-MK3.kicad_sch, power.kicad_sch]
2025-11-24 Plcaed all components onto board
    [CAM-MK3.kicad_pcb]
2025-11-25 everything routed, drc passed, most silkscreen
    [Mini-MK1-Sensors.kicad_sch, Mini-MK1.kicad_pcb, Mini-MK1.kicad_sch]
2025-11-26 board outline
    [Switch_Board.kicad_pcb]
2025-11-26 Routing Progress
    [CAM-MK3.kicad_pcb, CAM-MK3.kicad_sch, power.kicad_sch]
2025-11-26 routing one switch and most of MCU slice
    [IsolatedFlipFlopsSwitch.kicad_sch, Switch_Board.kicad_pcb]
2025-11-27 Silk Screen Fixes + Datasheet Updates
    [CAM-Recieve-MK1.kicad_pcb, CAM-Recieve-MK1.kicad_sch]
2025-11-27 routed two more power switches
    [Switch_Board.kicad_pcb, Switch_Board.kicad_sch]
2025-11-27 Added via for tx_1 and copper pads fo power mux
    [CAM-MK3.kicad_pcb]
2025-11-27 possible routing for slices in alt file
    [Switch_Board_alt.kicad_pcb]
2025-11-28 what the FUCK routed the whole board :P most cursed thing in existence
    [IsolatedFlipFlopsSwitch.kicad_sch, Switch_Board.kicad_pcb, Switch_Board.kicad_sch]
2025-11-29 Added Labels + Footprints (Done?)
    [CAM-MK3.kicad_pcb, CAM-MK3.kicad_sch, power.kicad_sch]
2025-12-01 Updated Logos
    [CAM-MK3.kicad_pcb]
2025-12-02 this is good I suppose. added gnd vias and some minor stuff
    [Mini-MK1-Power.kicad_sch, Mini-MK1-Pyro.kicad_sch, Mini-MK1-Sensors.kicad_sch, Mini-MK1.kicad_pcb, Mini-MK1.kicad_sch]
2025-12-02 drc + gerbers
    [Mini-MK1.kicad_pcb]
2025-12-02 better board outline + gnd vias
    [Switch_Board.kicad_pcb, Switch_Board_alt.kicad_pcb]
2025-12-02 3d models, silkscreen, drc, gerbers
    [IsolatedFlipFlopsSwitch.kicad_sch, Switch_Board.kicad_pcb, Switch_Board.kicad_sch]
2025-12-02 silkscreen stuff and contributers
    [CAM-MK3.kicad_pcb, CAM-MK3.kicad_sch, power.kicad_sch]
2025-12-02 3D Model Directory Fixes
    [CAM-Recieve-MK1.kicad_pcb]
2025-12-02 New Silk Screen Addition + Name Finalization
    [CAM-Recieve-MK1.kicad_pcb, CAM-Recieve-MK1.kicad_sch]
2025-12-02 Schematic Name Update
    [CAM-Recieve-MK1.kicad_sch]
2025-12-02 final cleanup - silkscreen, gnd vias, drc, gerbers
    [CAM-Recieve-MK1.kicad_pcb, CAM-Recieve-MK1.kicad_sch]
2025-12-02 fixed mag sensor name
    [Mini-MK1-Power.kicad_sch, Mini-MK1-Pyro.kicad_sch, Mini-MK1-Sensors.kicad_sch, Mini-MK1.kicad_pcb, Mini-MK1.kicad_sch]
2025-12-02 LED Values
    [IsolatedFlipFlopsSwitch.kicad_sch, Switch_Board.kicad_pcb, Switch_Board.kicad_sch]
2025-12-02 fixed battery input value
    [CAM-MK3.kicad_pcb, CAM-MK3.kicad_sch]
2025-12-02 fixed SMA value
    [CAM-MK3.kicad_sch]
2025-12-03 added crystal frequency
    [CAM-MK3.kicad_sch, power.kicad_sch]
2025-12-03 fixed footprint assignment and changed resistor values to lowercase k
    [CAM-Recieve-MK1.kicad_pcb, CAM-Recieve-MK1.kicad_sch]
2025-12-03 fixed footprint assignment
    [CAM-MK3.kicad_pcb, CAM-MK3.kicad_sch]
2025-12-03 no more decimal capacitor values
    [CAM-MK3.kicad_pcb, CAM-MK3.kicad_sch, power.kicad_sch]
2025-12-03 forgot to build zones last time oops
    [CAM-MK3.kicad_pcb]
2025-12-03 resetting changes out of branch scope
    [CAM-MK3.kicad_pcb, CAM-MK3.kicad_sch]
2025-12-03 added esd321 3d models
    [CAM-MK3.kicad_pcb]
2025-12-04 removed user drawing + ecm 3d stuff
    [CAM-MK3.kicad_pcb]
2025-12-04 deleted reference designator text (added after order????????)
    [CAM-MK3.kicad_pcb]
2025-12-06 fixed vca0013a footprint solder mask + other small things
2025-12-17 bom generation and espp4 module correction
2025-12-17 deleted bom
2025-12-18 flipped label from input to output
    [CAM-Recieve-MK1.kicad_sch]
2025-12-18 Changed Antenna_Connecter_T label to Amplifer_Input
    [CAM-Recieve-MK1.kicad_sch]
2025-12-31 changed text labels to reflect XC6223, will have to change back for next rev
    [IsolatedFlipFlopsSwitch.kicad_sch, Switch_Board.kicad_sch]
2026-01-10 changed main vreg text
    [Switch_Board.kicad_sch]
2026-01-11 Renamed and reorganized board files
    [BAGEL-MK1-revA.kicad_pcb, BAGEL-MK1-revA.kicad_sch, IsolatedFlipFlopsSwitch.kicad_sch]
2026-01-11 created MK1.1 files
    [BAGEL-MK1.1-revA.kicad_pcb, BAGEL-MK1.1-revA.kicad_sch, IsolatedFlipFlopsSwitch.kicad_sch]
2026-01-11 adding delay capacitors to schematic and starting on routing
    [BAGEL-MK1.1-revA.kicad_pcb, BAGEL-MK1.1-revA.kicad_sch, IsolatedFlipFlopsSwitch.kicad_sch]
2026-01-13 renamed folder
    [MIDAS_Mini-MK1.kicad_pcb, MIDAS_Mini-MK1.kicad_sch, Mini-MK1-Power.kicad_sch, Mini-MK1-Pyro.kicad_sch, Mini-MK1-Sensors.kicad_sch]
2026-01-13 Rev B
    Switched super cap value to 220mF and added back silkscreen for power debug
    [MIDAS_Mini-MK1.kicad_pcb, MIDAS_Mini-MK1.kicad_sch, Mini-MK1-Power.kicad_sch, Mini-MK1-Pyro.kicad_sch, Mini-MK1-Sensors.kicad_sch]
2026-01-14 reverting cam mk3 deletions
    [CAM-MK3.kicad_pcb, CAM-MK3.kicad_sch]
2026-01-14 renamed files from CAM-Recieve (typo :P) to EAGLE fixed regulator texas conflict
    [EAGLE-MK1.kicad_pcb, EAGLE-MK1.kicad_sch]
2026-01-14 sch and lib cleanup pt 1
    [CAM-MK3.kicad_sch, EAGLE-MK1.kicad_pcb, power.kicad_sch]
2026-01-14 updated changed footprints
    [EAGLE-MK1.kicad_sch]
2026-01-14 restructring of blocks and routing to power connectors
    [BAGEL-MK1.1-revA.kicad_pcb, BAGEL-MK1.1-revA.kicad_sch, IsolatedFlipFlopsSwitch.kicad_sch]
2026-01-15 resolving regulator texas sym conflict
2026-01-15 revert switch texas unused lib
2026-01-15 revB is kil
    [Mini-MK1-Power.kicad_sch, Mini-MK1-Pyro.kicad_sch, Mini-MK1-Sensors.kicad_sch, Mini-MK1.kicad_pcb, Mini-MK1.kicad_sch]
2026-01-15 correcting stm32wb1mmc sym->fp linkage
    [BAGEL-MK1.kicad_sch]
2026-01-15 tuning of switch layout, positioning half of board switches with connectors and traces
    [BAGEL-MK1.1-revA.kicad_pcb]
2026-01-16 adding routing from switches 1-3 to MCU, replaced old MCU LDO with the new one, started making ground planes for switches 1-3
    [BAGEL-MK1.1-revA.kicad_pcb]
2026-01-16 finishing zones on switches 1-3 and connecting switches 1-3 to MCU
    [BAGEL-MK1.1-revA.kicad_pcb]
2026-01-20 adding labels to power connectors and leds, leds reorriented to be next to power connectors, some traces mildly unspaghettied
    [BAGEL-MK1.1-revA.kicad_pcb]
2026-01-20 adding additional labels
    [BAGEL-MK1.1-revA.kicad_pcb]
2026-01-21 flipping connectors and redoing switch regV zones
    [BAGEL-MK1.1-revA.kicad_pcb]
2026-01-22 rev B created and routing setup
    [BAGEL-MK1.1-revB.kicad_pcb, BAGEL-MK1.1-revB.kicad_sch, IsolatedFlipFlopsSwitch.kicad_sch]
2026-01-22 constraint mounting hole & center hole courtyard
    [BAGEL-MK1.1-revB.kicad_pcb, BAGEL-MK1.1-revB.kicad_sch]
2026-01-22 routed new stuff into one switch slice
    [BAGEL-MK1.1-revB.kicad_pcb]
2026-01-24 lots of routing
    [BAGEL-MK1.1-revB.kicad_pcb, BAGEL-MK1.1-revB.kicad_sch]
2026-01-24 rerouting switches again and cleaning up, then starting on switches 4-6
    [BAGEL-MK1.1-revA.kicad_pcb, BAGEL-MK1.1-revA.kicad_sch, IsolatedFlipFlopsSwitch.kicad_sch]
2026-01-24 fixed voltage regulator symbol
    [BAGEL-MK1.1-revB.kicad_pcb, BAGEL-MK1.1-revB.kicad_sch, IsolatedFlipFlopsSwitch.kicad_sch]
2026-01-24 edge cuts
    [BAGEL-MK1.1-revB.kicad_pcb]
2026-01-24 moved some traces to the back
    [BAGEL-MK1.1-revB.kicad_pcb]
2026-01-24 small things
    [BAGEL-MK1.1-revB.kicad_pcb]
2026-01-24 mostly routing for 4-6 switches
    [BAGEL-MK1.1-revA.kicad_pcb, IsolatedFlipFlopsSwitch.kicad_sch]
2026-01-24 renaming revA
    [CAM-MK3-revA.kicad_pcb, CAM-MK3-revA.kicad_sch, power.kicad_sch]
2026-01-24 rev B done
    moved blue led and fixed P4 footprint
    [CAM-MK3-revB.kicad_pcb, CAM-MK3-revB.kicad_sch, power.kicad_sch]
2026-01-24 updated revision to B
    [CAM-MK3-revB.kicad_pcb, CAM-MK3-revB.kicad_sch]
2026-01-25 finishing routing and edgecuts
    [BAGEL-MK1.1-revA.kicad_sch]
2026-01-25 removed mini revA folder 😏
    [Mini-MK1-Power.kicad_sch, Mini-MK1-Pyro.kicad_sch, Mini-MK1-Sensors.kicad_sch, Mini-MK1.kicad_pcb, Mini-MK1.kicad_sch]
2026-01-25 removed mounting holes from stencil
    [Mini-MK1.kicad_pcb]
2026-01-25 drawing sheet stuff + avocado
    [BAGEL-MK1.1-revA.kicad_pcb]
2026-01-25 moved like one trace
    [CAM-MK3-revB.kicad_pcb]
2026-01-25 zones touch
    [BAGEL-MK1.1-revB.kicad_pcb]
2026-01-25 deleted weird paste
    [BAGEL-MK1.1-revB.kicad_pcb]
2026-01-25 much more cleanup its pretty darn good now
    [BAGEL-MK1.1-revA.kicad_sch, IsolatedFlipFlopsSwitch.kicad_sch]
2026-01-25 renamed folder to avocado
    [BAGEL-MK1.1-revA.kicad_sch, IsolatedFlipFlopsSwitch.kicad_sch]
2026-01-25 switch numbers + centering LEDs
2026-01-26 fixed mcu power conn polarity
    [BAGEL-MK1.1-revA.kicad_sch]
2026-01-26 q shit oops cleaned up mcu power circuitry
    [BAGEL-MK1.1-revA.kicad_sch]
2026-01-26 fixed connector polarity
    [BAGEL-MK1.1-revA.kicad_sch]
2026-01-26 2oz of the most insignificant tweaks you've ever seen
    [BAGEL-MK1.1-revB.kicad_pcb]
2026-01-27 renamed files to avocado
    [BAGEL-MK1.1-Avocado.kicad_sch]
2026-01-27 renaming to butter
    [BAGEL-MK1.1-Butter.kicad_pcb, BAGEL-MK1.1-Butter.kicad_sch, IsolatedFlipFlopsSwitch.kicad_sch]
2026-01-30 initialize TeleDecoder project
    [TeleDecoder.kicad_pcb, TeleDecoder.kicad_sch]
2026-01-30 Added ESP32 and LDO to schematic, need to add transceiver and SMA connector
    [TeleDecoder.kicad_sch]
2026-01-30 add symbols
    [TeleDecoder.kicad_sch]
2026-01-30 antenna schematic
    [TeleDecoder.kicad_sch]
2026-01-31 CC1120 pins
    [TeleDecoder.kicad_sch]
2026-01-31 40MHz crystal
    [TeleDecoder.kicad_sch]
2026-01-31 removing regulator torex
2026-01-31 RF transceiver schematic
    [TeleDecoder.kicad_sch]
2026-01-31 regulator torex stuff
2026-01-31 ESP32 SPI connection
    [TeleDecoder.kicad_sch]
2026-02-06 Finished up schematic, started layout, laid out general placement, need to finish up SMA antenna
    [TeleDecoder.kicad_pcb, TeleDecoder.kicad_sch]
2026-02-14 Routing and minor schematic fixes
    [TeleDecoder.kicad_pcb, TeleDecoder.kicad_sch]
2026-02-20 change gpio pins
    [TeleDecoder.kicad_pcb, TeleDecoder.kicad_sch]
2026-02-20 Mounting holes, rerouting
    [TeleDecoder.kicad_pcb, TeleDecoder.kicad_sch]
2026-02-21 switch coax footprint
    [TeleDecoder.kicad_sch]
2026-02-21 Debug pins, silkscreen
    [TeleDecoder.kicad_pcb, TeleDecoder.kicad_sch]
2026-02-21 Decoupling capacitor
    [TeleDecoder.kicad_pcb]
2026-02-21 grainger logo
    [TeleDecoder.kicad_pcb, TeleDecoder.kicad_sch]
2026-02-21 align labels
    [TeleDecoder.kicad_pcb]
2026-04-10 Implemented new gnss
    [GATOR.kicad_pcb, GATOR.kicad_sch]
2026-04-12 init new transciever symbol under transceiver nice rf and init cam revC
    [CAM-MK3-revC.kicad_pcb, CAM-MK3-revC.kicad_sch, power.kicad_sch]
2026-04-12 18 ohm resistor value
    [TeleDecoder.kicad_pcb, TeleDecoder.kicad_sch]
2026-04-12 Switched Si4463 with LR2021 in Schematic
    [CAM-MK3-revC.kicad_sch, power.kicad_sch]
2026-04-12 SYMBOL / Schematic
    [EAGLE-MK1-revA.kicad_sch]
2026-04-12 fnished transciever footprint
2026-04-12 hided gnd
    [CAM-MK3-revC.kicad_sch, power.kicad_sch]
2026-04-12 added footprint
    [CAM-MK3-revC.kicad_pcb, CAM-MK3-revC.kicad_sch]
2026-04-12 updated lr2021 footprint
2026-04-12 routed new transciever
    [CAM-MK3-revC.kicad_pcb, CAM-MK3-revC.kicad_sch, power.kicad_sch]
2026-04-12 zone fill
    [CAM-MK3-revC.kicad_pcb]
2026-04-12 minor wire
    [CAM-MK3-revC.kicad_pcb]
2026-04-13 ROUTING DONE
    New LR2021 Footprint Integration
    [EAGLE-MK1-revA.kicad_pcb, EAGLE-MK1-revA.kicad_sch]
2026-04-15 EAGLE REVB + EAGLE A (w/ w/o amp)
    [EAGLE-MK1-A.kicad_pcb, EAGLE-MK1-A.kicad_sch, EAGLE-MK1-revB.kicad_pcb, EAGLE-MK1-revB.kicad_sch]
2026-04-15 fixed some drc stuff
    [GATOR.kicad_pcb]
2026-04-15 drc deleted random unconnected
    [CAM-MK3-revC.kicad_pcb]
2026-04-15 deleted references slikscreen
    [EAGLE-MK1-revB.kicad_pcb]
2026-04-15 fixed sma footprint
    [GATOR.kicad_pcb]
2026-04-25 date in comments
    [CAM-MK3-revC.kicad_pcb, CAM-MK3-revC.kicad_sch, power.kicad_sch]
2026-07-14 remove archive to https://github.com/ISSUIUC/ISS-PCB-Archive
    [3V3_REGULATOR.kicad_pcb, 3V3_REGULATOR.kicad_sch, 5v buck .kicad_pcb, 5v buck .kicad_sch, ACB.kicad_pcb, ACB.sch, ACTIVE_CONTROL.sch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]
2026-07-15 reverting stuff out of branches scope & deleting outdated images
    [MIDAS-MK2.1-Power.kicad_sch, MIDAS-MK2.1-Pyro.kicad_sch, MIDAS-MK2.1-RF.kicad_sch, MIDAS-MK2.1-Sensors.kicad_sch, MIDAS-MK2.1.kicad_sch, Motor-MK1.kicad_pcb]
2026-07-15 updated title card
    [GATOR.kicad_pcb, GATOR.kicad_sch]
2026-07-15 remove unused SAM-M10Q symbol, footprint, and 3d model
2026-07-15 fix lora cap symbol library
    [GATOR.kicad_sch]
2026-07-15 schematic box alignment, renamed QWIIC symbol lib, removed snapeda crap
    [GATOR.kicad_sch]
2026-07-15 fix 3d models for qwiic and gnss
    [GATOR.kicad_pcb]
2026-07-15 small schematic adjustments
    [GATOR.kicad_sch]
2026-07-15 edide tang
    [GATOR.kicad_sch]
2026-07-16 changed blue boxes and text to brown to match
    [GATOR.kicad_sch]
2026-07-16 fixing folder structure and out of scpoe stuff
    [EAGLE-MK1-A.kicad_pcb, EAGLE-MK1-A.kicad_sch, EAGLE-MK1-revA.kicad_pcb, EAGLE-MK1-revA.kicad_sch]
2026-07-16 fix symbol library stuff and make NiceRF library same as CAM-MK3 revC
    [EAGLE-MK1-revB.kicad_sch]
2026-07-16 updated niceRF lib to match eagle pr
    [CAM-MK3-revC.kicad_sch]
2026-07-16 remove unused crystal lib, and fix title card
    [TeleDecoder.kicad_pcb, TeleDecoder.kicad_sch]
2026-07-17 added link to teledecoder on schematic
    [TeleDecoder.kicad_sch]
2026-07-18 removed unused symbol lib table entries, yellow QWIIC symbol background, changed USB labels to hierarchical
    [GATOR.kicad_sch]
2026-08-01 Removed Stale Projects
    [ACB.kicad_pcb, ACB.kicad_sch, ACTIVE_CONTROL.kicad_sch, BMS.kicad_pcb, BMS.kicad_sch, BMS.step, Blackbox.kicad_pcb, Blackbox.kicad_sch]
2026-08-11 got rid of c_small, deleted crystal_ndk from sym-lib-table, filled in rev on pcb
    [TeleDecoder.kicad_pcb, TeleDecoder.kicad_sch]
2026-08-11 aligned boxes to 2.54 mm grid
    [TeleDecoder.kicad_sch]
2026-08-26 more changes
    [TeleDecoder-revB.kicad_pcb, TeleDecoder-revB.kicad_sch]
2026-08-26 Changed MPN and datasheet to reflect new crystal
    [TeleDecoder-revB.kicad_sch]
2026-08-26 Fix routing and add 3d models
    [TeleDecoder-revB.kicad_pcb]
2026-08-26 Minor silkscreen edits
    [TeleDecoder-revB.kicad_pcb]
2026-08-26 changed revB's sheets from revA to revB
    [TeleDecoder-revB.kicad_pcb, TeleDecoder-revB.kicad_sch]
2026-08-28 Renamed subtitle and symbol value to CC1200
    [TeleDecoder-revB.kicad_sch]
2026-08-28 removed user comments on pcb
    [TeleDecoder-revB.kicad_pcb]
2026-08-28 fix name, and finish
    [TeleDecoder-revB.kicad_pcb]
2026-09-02 Added 3D model for SMA connectors
    [GATOR.kicad_pcb]
2026-10-17 Weather Station PCB
    There isn't much here since I'm still trying to figure out KiCad, but sending this anyways
2026-10-17 Added more sensors
2026-10-24 Edits to schematic
2026-10-30 added LR2021 and microSD schematic
2026-10-31 infrared thermometer and uv sensor schematic work
2026-10-31 added i2c pull up resistors and labels
2026-10-31 Added MAX31856 + Organized Layout + New Power Page + Added Three Thermocouples
2026-10-31 Added New RS485 Transceiver Sym+Footprint + Changed File Directory and Project Name.
2026-11-07 worked on thermocouple barometer and gnss schematic
2026-11-11 New Half Duplex RS485 Transceiver for Ultra Sonic Wind Sensor
2026-11-11 All Sensors Added!
2026-11-14 added buck converter schematic
